chrisgilmerproj/spark_chamber/Spark Chamber Small/Documentation/bougie.jpg

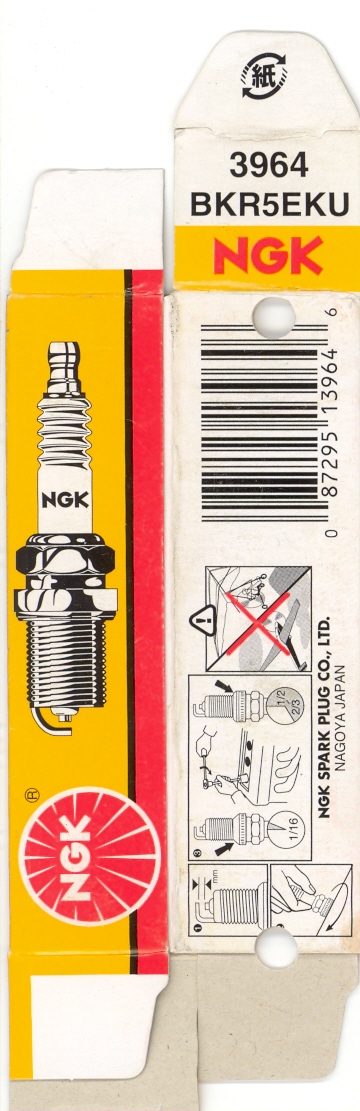
Spark Chamber Small/Documentation/bougie.jpg
