chrisgilmerproj/spark_chamber/README.md

Spark Chamber
=============

This is the public repo for my spark chamber files.

This includes all the original engineering drawings and documents for the
Nikef chambers designed by Fred Hartjes:

http://www.nikhef.nl/pub/departments/mt/projects/Sparkchamber/

from Fred's homepage

http://www.nikhef.nl/~i56/

In particular this is to focus on building the small spark chamber here:

http://www.nikhef.nl/pub/departments/mt/projects/Sparkchamber/index.php?path=Portable%28Small%29/
