chrisgilmerproj/spark_chamber/Spark Chamber Small/README.md

parts
=====

| Item | Quantity | Reference | Part | min | Mouser # | Price | Total | Notes  |
| ---- | --- | --- | --- | --- | --- | ----- | ----- | --- |
| 1 | -- | Cx1,Cx2 | ...pF | | | | | |
| 2 | -- | C7 | ...pF | | | | | |
| 3 | -- | R7 | ..k. | | | | | |
| 4 | -- | Rx1,Rx2 | ..k. | | | | | |
| 26 | -- | RV5 | jumper | | | | | Jumper |
| 27 | -- | RV6 | jumper | | | | | Jumper |
| 10 | -- | C30,C31,C63 | ...uF/450V | | | | | |

smd - parts
===========

| Item | Quantity | Reference | Part | min | Mouser # | Price | Total | Notes |
| ---- | --- | --- | --- | --- | --- | ----- | ----- | --- |
| 5 | 3 | C5,C6,C8 | 470nF | 1 | 810-CGJ4J3X7S2A474K  | 0.98  | 2.94  | Capacitor  |
| 6 | 1 | C9,C55,C59 | 120pF | 1 | 810-CGJ3E3C0G2D121J  | 0.29  | 0.29  | Capacitor  |
| 7 | 1 | C10 | 2.2uF | 1 | 810-C1005X7S0J225K | 0.33  | 0.33  | Capacitor  |
| 8 | 10 | C29,C43,C52,C53,C54, C56,C57,C58,C60,C61 | 100nF | 1 | 810-CGJ5L2X7R2A104K  | 0.65  | 6.50  | Capacitor  |
| 9 | 1 | C46 | 2.2nF | 1 | 81-GRM31BR73A222KW01 | 0.33  | 0.33  | Capacitor  |
| 28 | 6 | R1,R2,R3,R11,R93,R99 | 1k0 | 1 | 594-MCS0402MD1001DE0 | 0.28  | 1.68  | Resistor |
| 29 | 1 | R87 | 1M5 | 1 | 660-HV732ATTD1504F | 0.68  | 0.68  | Resistor |
| 31 | 3 | R5,R6,R8 | 470k | 1 | 756-HVC2512-470KFT18 | 0.79  | 2.37  | Resistor |
| 32 | 3 | R9,R91,R97 | 10k | 1 | 279-RN73C1J10KBTDF | 1.06  | 3.18  | Resistor |
| 33 | 1 | R10 | 3k3 | 1 | 667-ERA-3ARW332V | 1.38  | 1.38  | Resistor |
| 34 | 2 | R35,R37 | 1k6 | 1 | 71-TNPW08051K60BEEN  | 0.85  | 1.70  | Resistor |
| 35 | 1 | R12 | 47 | 1 | 588-RW3R5EA47R0JET | 1.75  | 1.75  | Resistor |
| 39 | 2 | R26,R27 | 270k | 1 | 660-HV732BTTD2703D | 0.61  | 1.22  | Resistor |
| 40 | 3 | R15,R31,R32 | 2k2 | 1 | 667-ERA-3ARW222V | 1.38  | 4.14  | Resistor |
| 41 | 2 | R34,R36 | 470 | 1 | 660-SG733ATTE471K | 0.86  | 1.72  | Resistor |
| 42 | 8 | R88,R89,R90,R94, R95,R96,R100,R101 | 10 | 1 | 588-RW0S6BB10R0FET | 1.15  | 9.20  | Resistor |
| 43 | 2 | R92,R98 | 4k7 | 1 | 279-RN73C1J4K7BTDF | 1.68  | 3.36  | Resistor |
| 48 | 3 | T1,T2,T3 | BS170 | 1 | 522-BS170FTA | 0.70  | 2.10  | Transistor |
| 49 | 2 | U1,U2 | TL3016ID | 1 | 595-TL3016ID | 3.17  | 6.34  | Chip |
| 50 | 4 | U3,U4,U6,U7 | 74HC123M | 1 | 595-CD74HC123M | 0.69  | 2.76  | Chip |
| 51 | 1 | U5 | 74HC08D | 1 | 595-SN74HC08D | 0.46  | 0.46  | Chip |
| 52 | 1 | U8 | 74HC240D | 1 | 595-SN74HC240DW | 0.60  | 0.60  | Chip |

discrete - parts
================

| Item | Quantity | Reference | Part | min | Mouser # | Price | Total  | Notes |
| ---- | --- | --- | --- | --- | --- | ----- | --- | --- |
| 11 | 2 | C42,C47 | 220uF/16V | 1 | 647-UVR1C221MED | 0.36  |  0.72  | Capacitor |
| 12 | 2 | C28,C49 | 47uF/25V ( 10 or 0uF/35V ) | 1 | 647-UST1E470MDD | 0.35  |  0.70  | Capacitor |
| 13 | 3 | C44,C45,C48 | 10uF/16V | 1 | 647-UPS1C100MDD1TA  | 0.17  |  0.51  | Capacitor |
| 14 | 1 | C51 | 22uF/350V | 1 | 647-TVX2V220MCD | 2.36  |  2.36  | Capacitor |
| ...  | 1 | R51 | 330k | 1 | 594-5083NW330K0J | 0.10  |  0.10  | Resistor |
| 15 | 3 | C62,C63,C64 | 680nF/400V | 1 | 594-2222-383-11684  | 3.36  |  10.08 | Capacitor |
| 16 | 2 | DN1,DN2 | BYV96 | | | 0.00  | | Fast soft-recovery controlled avalanche rectiﬁers |
| 17 | 4 | D1,D2,D3,D4 | LED | | | 0.00  | | LED |
| 18 | 2 | D10,D14 | W04G | 1 | 625-W04G-E4 0.69 | 1.38  | | Bridge Rectifier |
| 19 | 1 | D13 | BY448 + jumper | 1 | 625-BY448GP-E3/73 | 0.31  |  0.31  | Bridge Rectifier |
| 20 | 1 | F1 | 160mA-T | 1 | 693-0034.7207 | 0.81  |  0.81  | Fuse w/through hole |
| 21 | 3 | J1,J2,J3 | LEMO | | | 0.00  | | LEMO (manufacturer) Socket |
| 22 | 2 | PM1,PM2 | CON5 | | | 0.00  | | ?? Switch?? |
| 23 | 1 | P1 | Plug AC-male | | | 0.00  | | Plug AC-Male |
| 24 | 1 | Q1 ( NB: invert !!! ) | BC327 | 1 | 512-BC32725TA | 0.21  |  0.21  | Bipolar Transistor  |
| 25 | 2 | RV1,RV2,RV5,RV6 | 10k | | | 0.00  | | Jumper Panel |
| 30 | 1 | R4 | 82k | 1 | 594-5073NW82K00J | 0.16  |  0.16  | Resistor |
| 36 | 1 | R13 | 560 | 1 | 594-5073NW560R0J | 0.16  |  0.16  | Resistor |
| 37 | 1 | R14 | 27 | 1 | 594-5083NW27R00J | 0.10  |  0.10  | Resistor |
| 44 | | | | | | | | |
| 45 | | ... | TP | | | | | |
| 53 | 1 | U10 | 12N60A4D | | | 0.00  | | Transistor |
| 54 | 1 | U14 | LM7805 | 1 | 512-LM7805CT | 0.68  |  0.68  | Transistor |
| 55 | 1 | U15 | LM7905 | 1 | 512-LM7905CT | 0.60  |  0.60  | Transistor |
| 56 | 1 | U16 | LM7812 | 1 | 512-LM7812CT | 0.71  |  0.71  | Transistor |
| 46 | 1 | Tr1 | 220V > 2x8V, 3.3VA | | | 0.00  | | Transformer |
| 47 | 1 | Tr2 | 220V > 2x18V,2.3VA | | | 0.00  | | Transformer |
