chrisgilmerproj/spark_chamber/Spark Chamber Small/Documentation/README.md

Documentation
=============

Here is the list of the files in this directory:

| Name | Description |
| --- | --- |
| 091013 Handleiding vonkenmaker klein final version ENGLISH.pdf | English - Manual for the portable spark chamber of Nikhef |
| 091013 Handleiding vonkenmaker klein final version.pdf | Dutch - Manual for the portable spark chamber of Nikhef |
| Beknopte bediening draagbare vonkenkamer.pdf | Dutch - Brief portable operating room sparks |
| Block diagram.jpg | Spark Chamber Block Diagram of full system |
| bougie.jpg | Bougie Spark Plug Box - NGK 3964 BKH5EKU |
| coil spark chamber Cees Brouwer email.txt | English translation of "spoeltje vonkenkamer Cees Brouwer.eml" |
| Electronics panel.dwg | |
| H5783P.pdf | Photosensor Module Product Page |
| spoeltje vonkenkamer Cees Brouwer.eml | Dutch - Spark Chamber Coil Email |
| Vishay specs.pdf | Vishay Heavy Duty High Voltage Capacitors Product Page |
