chrisgilmerproj/spark_chamber/Spark Chamber Small/Documentation/HV board/README.md

High Voltage Board
==================

Here is the list of the files in this directory:

| Name | Description |
| --- | --- |
| BOM-HV-unit.txt | High Voltage Board BOM |
| NEW-HV-6KV-BOT.pdf | Bottom Layer |
| NEW-HV-6KV-DRD.pdf | Drill Drawing |
| NEW-HV-6KV-SMT.pdf | Soldermask Top |
| NEW-HV-6KV-SST.pdf | Silkscreen Top |
| NEW-HV-6KV-TOP.pdf | Top Layer |
| Sch-P1-Blk.pdf | Spark Chamber 1 |
| Sch-P7-HV0704.pdf  | New HV Board |

Bill of Materials
=================

PC Board
--------

- prototype 3x ad 280,- /3 =  93,33 /stuk
- productie 6x ad 209,4 /6 =  34,90 /stuk
- gemiddeld 9x ad 489,4 /9 =  54,38 /stuk

Parts
-----

| Item | Quantity | Reference | Part |
| ---- | --- | --- | --- |
| 1 | 30	 | C1,C2,C3,C4,C5,C6,C7, C8,C9,C10,C11,C12,C13, C14,C15,C16, C21,C22,C23,C24,C25,C26, C27,C28,C29,C30,C31,C32, C33,C34 | 10uF/400V	|
| 2	 | 9	 | D1,D2,D3,D4,D5,D6,D7, D8,D0 | BY448 |
| 3	 | 1	 | D10							| W04G |
| 4	 | 1	 | D11							| LED |
| 5	 | 1	 | E11							| 47uF / 35V |
| 6	 | 2	 | F1,F2						| TR-160mA |
| 7	 | 7	 | H1,H2,H3,H4,H5,11,0			| HOLE / TEST-POINT |
| 8	 | 1	 | J1							| PLUG AC-MALE |
| 9	 | 8	 | R1,R2,R3,R4,R5,R6,R7,R8		| 8M2 |
| 10 | 1	 | R9,R12						| 1M0 |
| 11 | 1	 | R11							| 3k9 |
| 12 | 1	 | T0							| 230V>2x18V |
| 13 | 3	 | T1,T2,T3					| 2x18V>230V |
| 14 | 1	 | RV1							| varistor,715V |
| 15 | 1	 | RV2							| varistor,680V |
