chrisgilmerproj/spark_chamber/Spark Chamber Small/3D-pictures Small Spark chamber.pdf

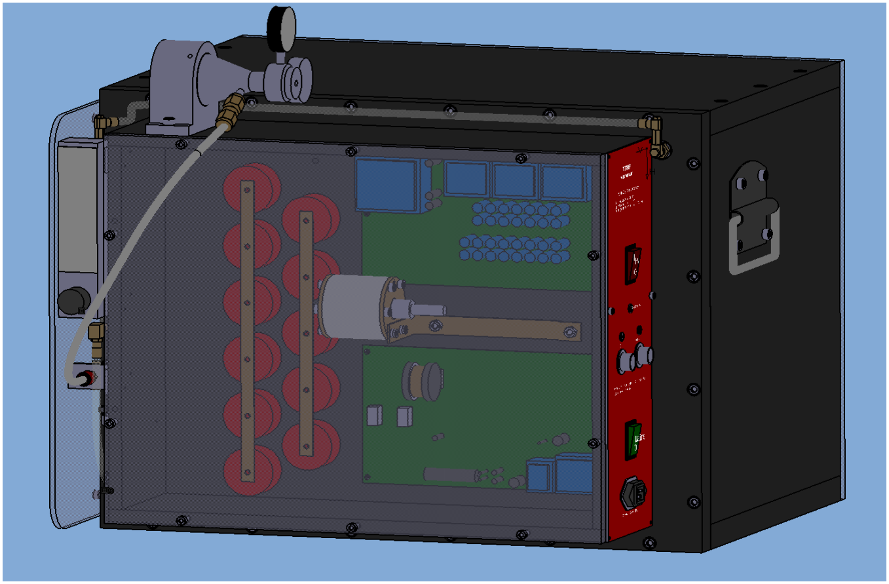
[picture p2: figure]

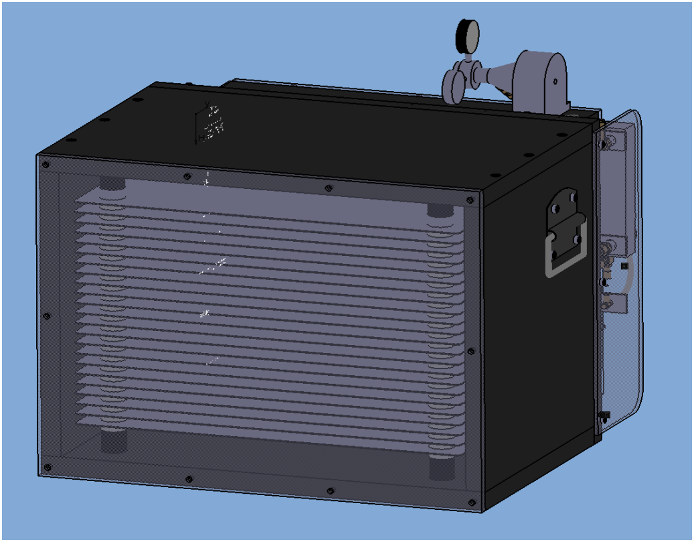
[picture p3: figure]
