chrisgilmerproj/spark_chamber/Spark Chamber Small/Documentation/Block diagram.jpg

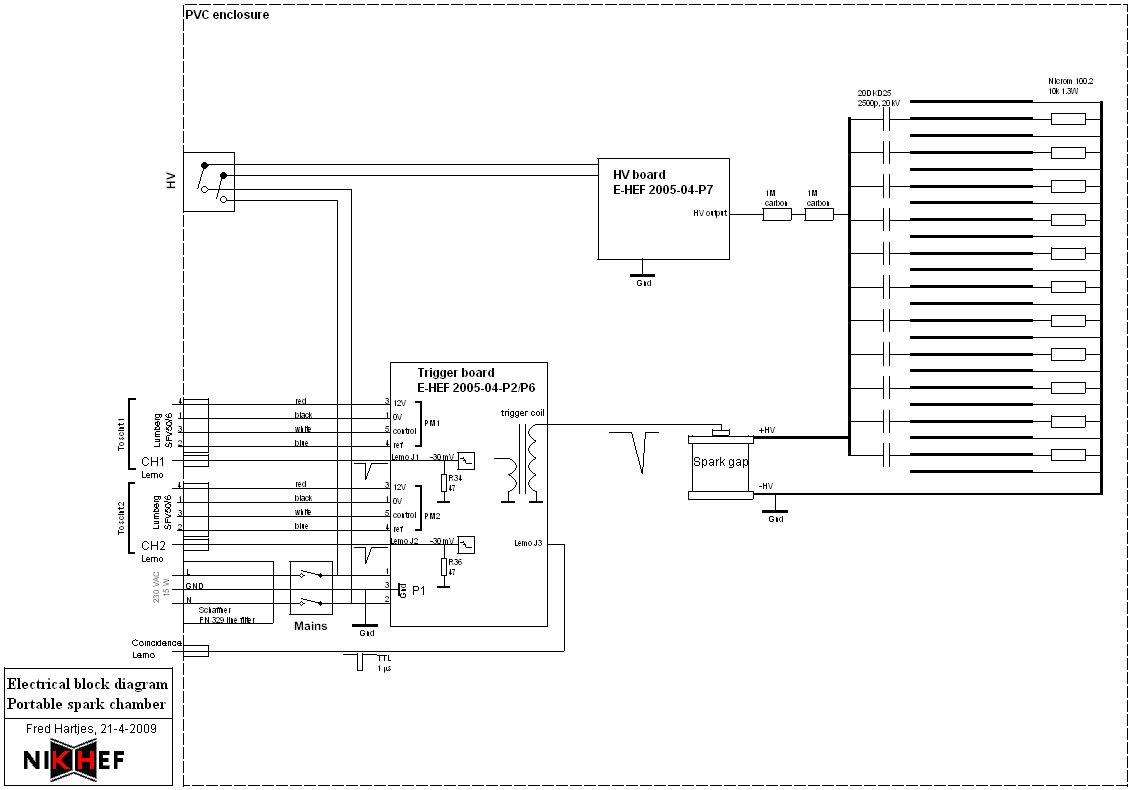
Spark Chamber Small/Documentation/Block diagram.jpg
