chrisgilmerproj/spark_chamber/Spark Chamber Small/Documentation/Trigger board/BOM-Spark-Ctrl.txt

Spark-Ctrl  Revised: Thursday, March 24, 2005
K.U. Nijmegen,  E-HEF  2005-04-P..          Revision: A

Bill Of Materials          March 31,2005      11:44:52  Page1 

Item / Quantity Reference           Part            Farnell-nr
_________________________________________________________________________

  1 -   Cx1,Cx2,        ...pF
  2 -   C7,     ...pF
  3 -   R7,     ..k.
  4 -   Rx1,Rx2,        ..k.
 26 -   RV5     jumper          
 27 -   RV6     jumper          
 10 -   C30,C31,C63     . ..uF/450V         Price (x5)

 - - - - - - - - -   smd - parts   - - - - - - - - - - - - - - - - - 

  5 3   C5,C6,C8        470nF       644.274   9,20

  6 1   C9,C55,C59      120pF      C: 10.03.04.212.7      7,50

  7 1   C10     2.2uF       317.706   4,80

  8 10  C29,C43,C52,C53,C54,        100nF          C: 10.03.04.500.2
        C56,C57,C58,C60,C61             reel:   3555124  37,92

  9 1   C46     2.2nF           499.330   1,37

 28 6   R1,R2,R3,R11,R93,R99        1k0         912.475   1,35

 29 1   R87     1M5         3601250   2,25

 31 3   R5,R6,R8        470k            912.797   0,85

 32 3   R9,R91,R97      10k         912.591   1,35

 33 1   R10     3k3         912.530   1,00

 34 2   R35,R37     1k6         4387120   0,85

 35 1   R12     47          912.311   0,85

 39 2   R26,R27     270k            912.761   0,85

 40 3   R15,R31,R32     2k2         912.517   1,35

 41 2   R34,R36     470         912.438   1,35

 42 8   R88,R89,R90,R94,R95,        10         C: 11.24.05.110.0
        R96,R100,R101                   9122337   1,70

 43 2   R92,R98     4k7         912.554   1,05

 48 3   T1,T2,T3        BS170           4386632   3,60  
 49 2   U1,U2       TL3016ID        8453594  13,30      
 50 4   U3,U4,U6,U7     74HC123M        539.302   7,80

 51 1   U5      74HC08D     794.910   1,35

 52 1   U8   ( 74HC240D )       3166065   1,95
 
- - - - - - - - -   discrete - parts   - - - - - - - - - - - - - - - - 

 11 2   C42,C47     220uF/16V       580.429       2,80
 
 12 2   C28,C49     47uF/25V        
            ( 100uF/35V )   580.533       3,40

 13 3   C44,C45,C48     10uF/16V        3349925       3,30

 14 1   C51     22uF/350V       3451021       7,75
 .. 1   R51     330k                      1,75

 15 2   C62, . . . ,C64     680nF/400V      548.236       4,50

 16 2   DN1,DN2     BYV96       367.450   2,20

 17 4   D1,D2,D3,D4     LED         656.537   4,80

 18 2   D10,D14     W04G            646.696   4,30
 19 1   D13 BY448 + jumper  366.316   1,90

 20 1   F1      160mA-T     9516069       9,50

 21 3   J1,J2,J3        LEMO            3817866 148,35

 22 2   PM1,PM2     CON5            659.277  46,20

 23 1   P1      PLUG  AC-MALE   

 24 1   Q1 ( NB: invert !!! )   BC327       356.943   0,35

 25 2   RV1,RV2,        10k             348.284  19,60

 30 1   R4      82k         545.053   1,75

 36 1   R13     560         544.530   1,75

 37 1   R14     27          544.218   1,75

 44         
 45     . . . . . .         TP      

 53 1   U10     12N60A4D        3020666      29,85
    
 54 1   U14     LM7805      412.776   2,75
    
 55 1   U15     LM7905      413.690   3,50
    
 56 1   U16     LM7812      413.215   3,35
    
 46 1   Tr1 220V > 2x8V, 3.3VA  926.413  38,70
    
 47 1   Tr2 220V > 2x18V,2.3VA  4384702  22,50
                                    ______ +
 
            TOTAAL onderdelen   / pcb       ~ 100,--                PC-board (4-layers)         ~  60,-- 
                                    ______ +
 
            TOTAAL                 €    160,00
