chrisgilmerproj/spark_chamber/(list of files, cad)

Other CAD files:
Spark Chamber Small/Documentation/Electronics panel.dwg
