chrisgilmerproj/spark_chamber/(threads)

Thread 1 (2013-10-08):

BOM for Trigger Board

chrisgilmerproj, 2013-10-08:
Need to find modern parts for the Trigger Board.  I have the actual board but it is not populated.  Determine all the parts for the BOM in order to purchase the parts.  Try Mouser, DigiKey, Jameco, etc.

Closed 2017-07-17.
