chrisgilmerproj/spark_chamber/Spark Chamber Large/Assembly Gas Control Unit BOM_AA0312_B.pdf

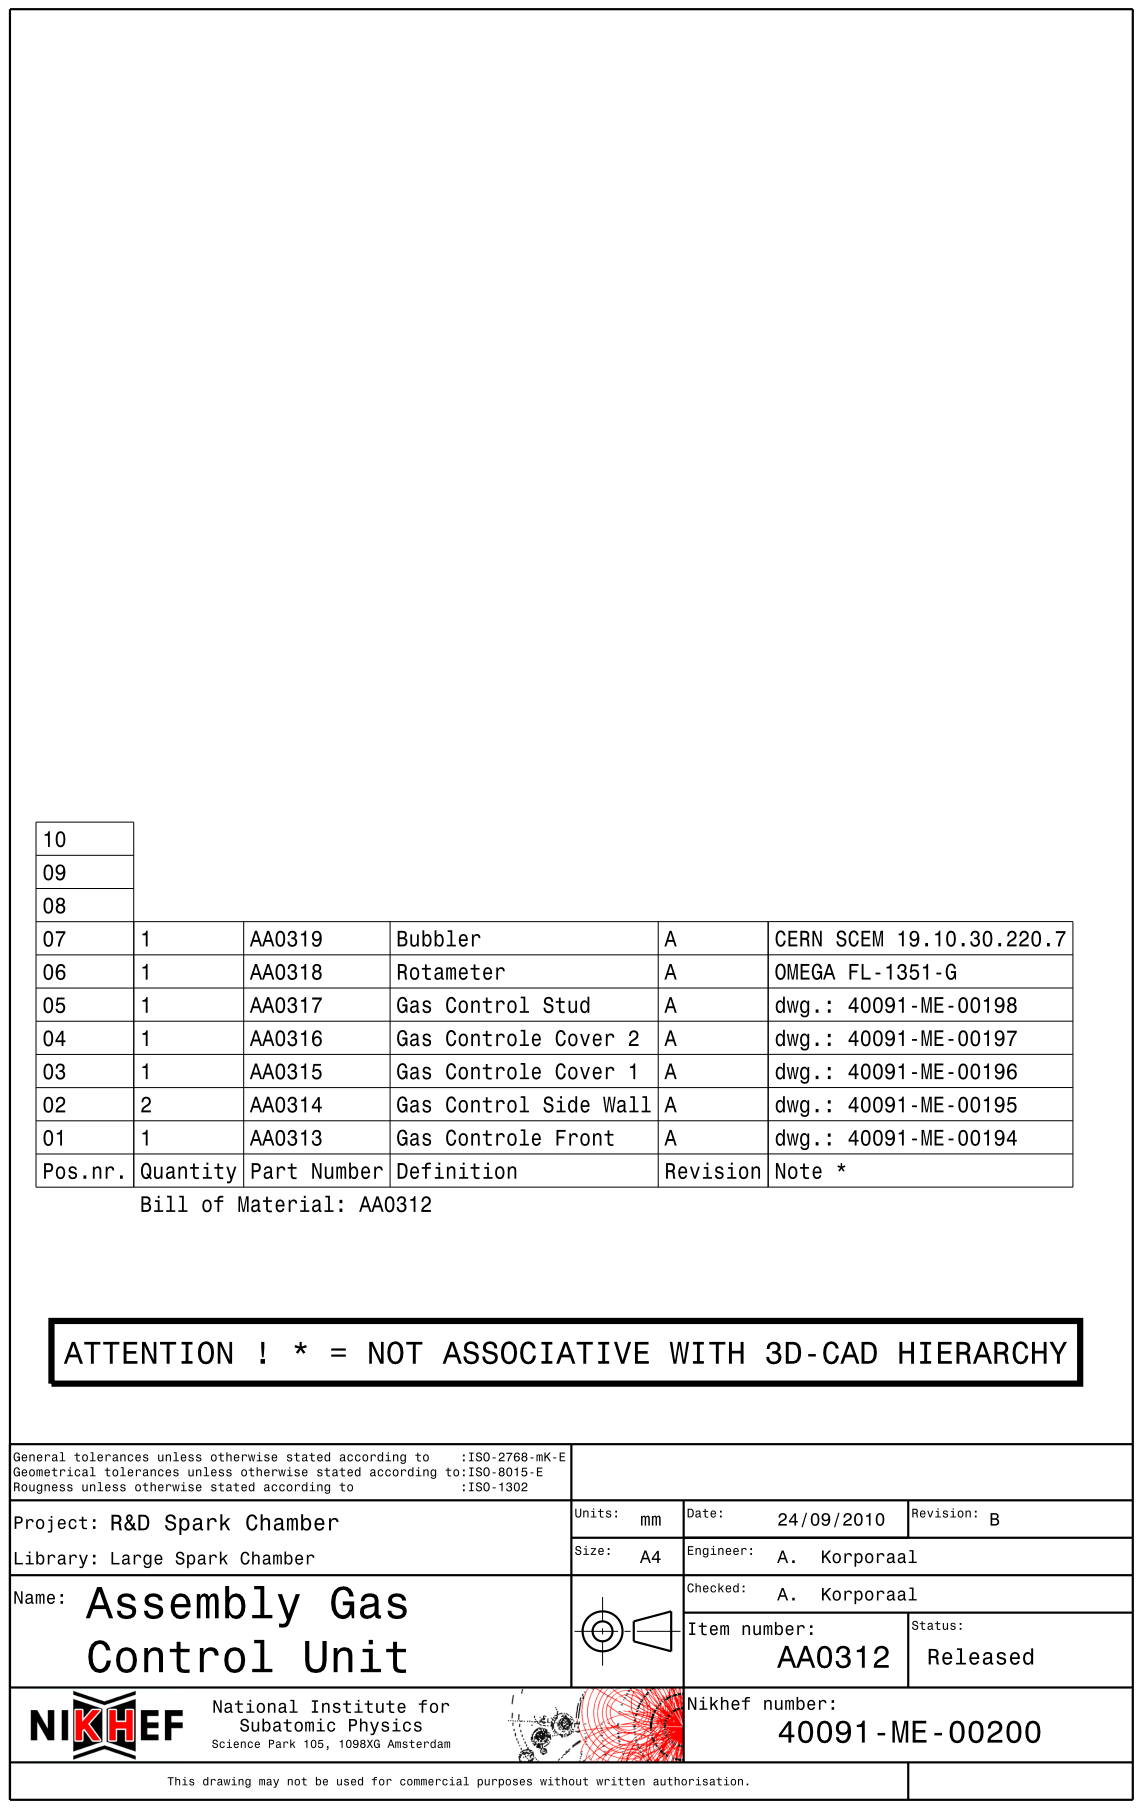
[picture p5: page 1]
