chrisgilmerproj/spark_chamber/Spark Chamber Large/Assembly Gas Control Unit_AA0312_A.pdf

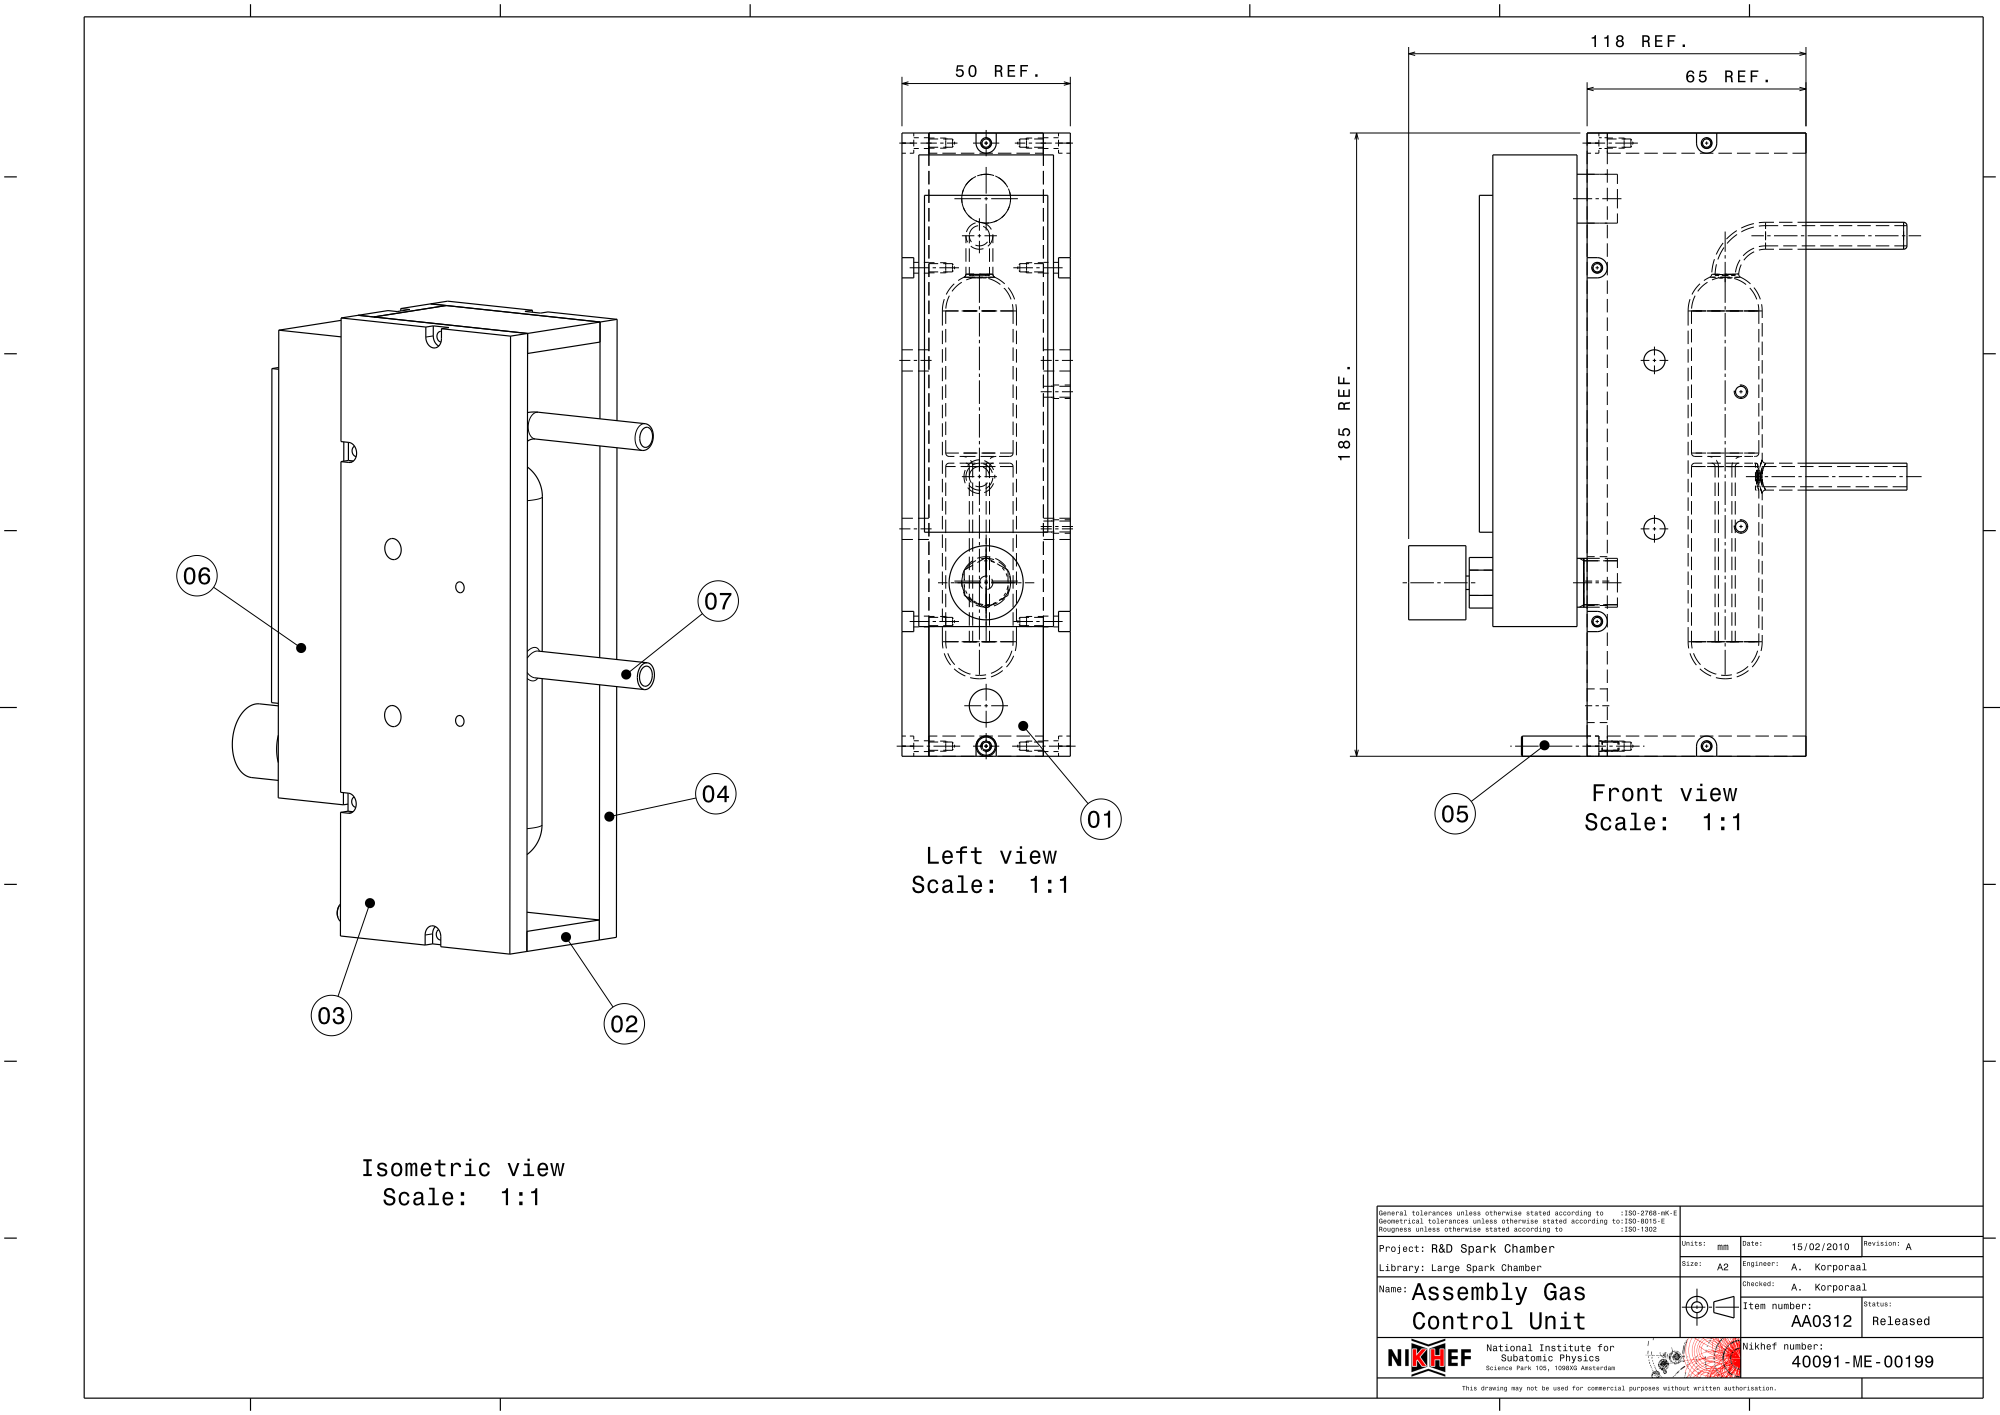
[picture p6: page 1]
