chrisgilmerproj/spark_chamber/Spark Chamber Large/Assembly Large spark Chamber Sheet 1_AA0244_A.pdf

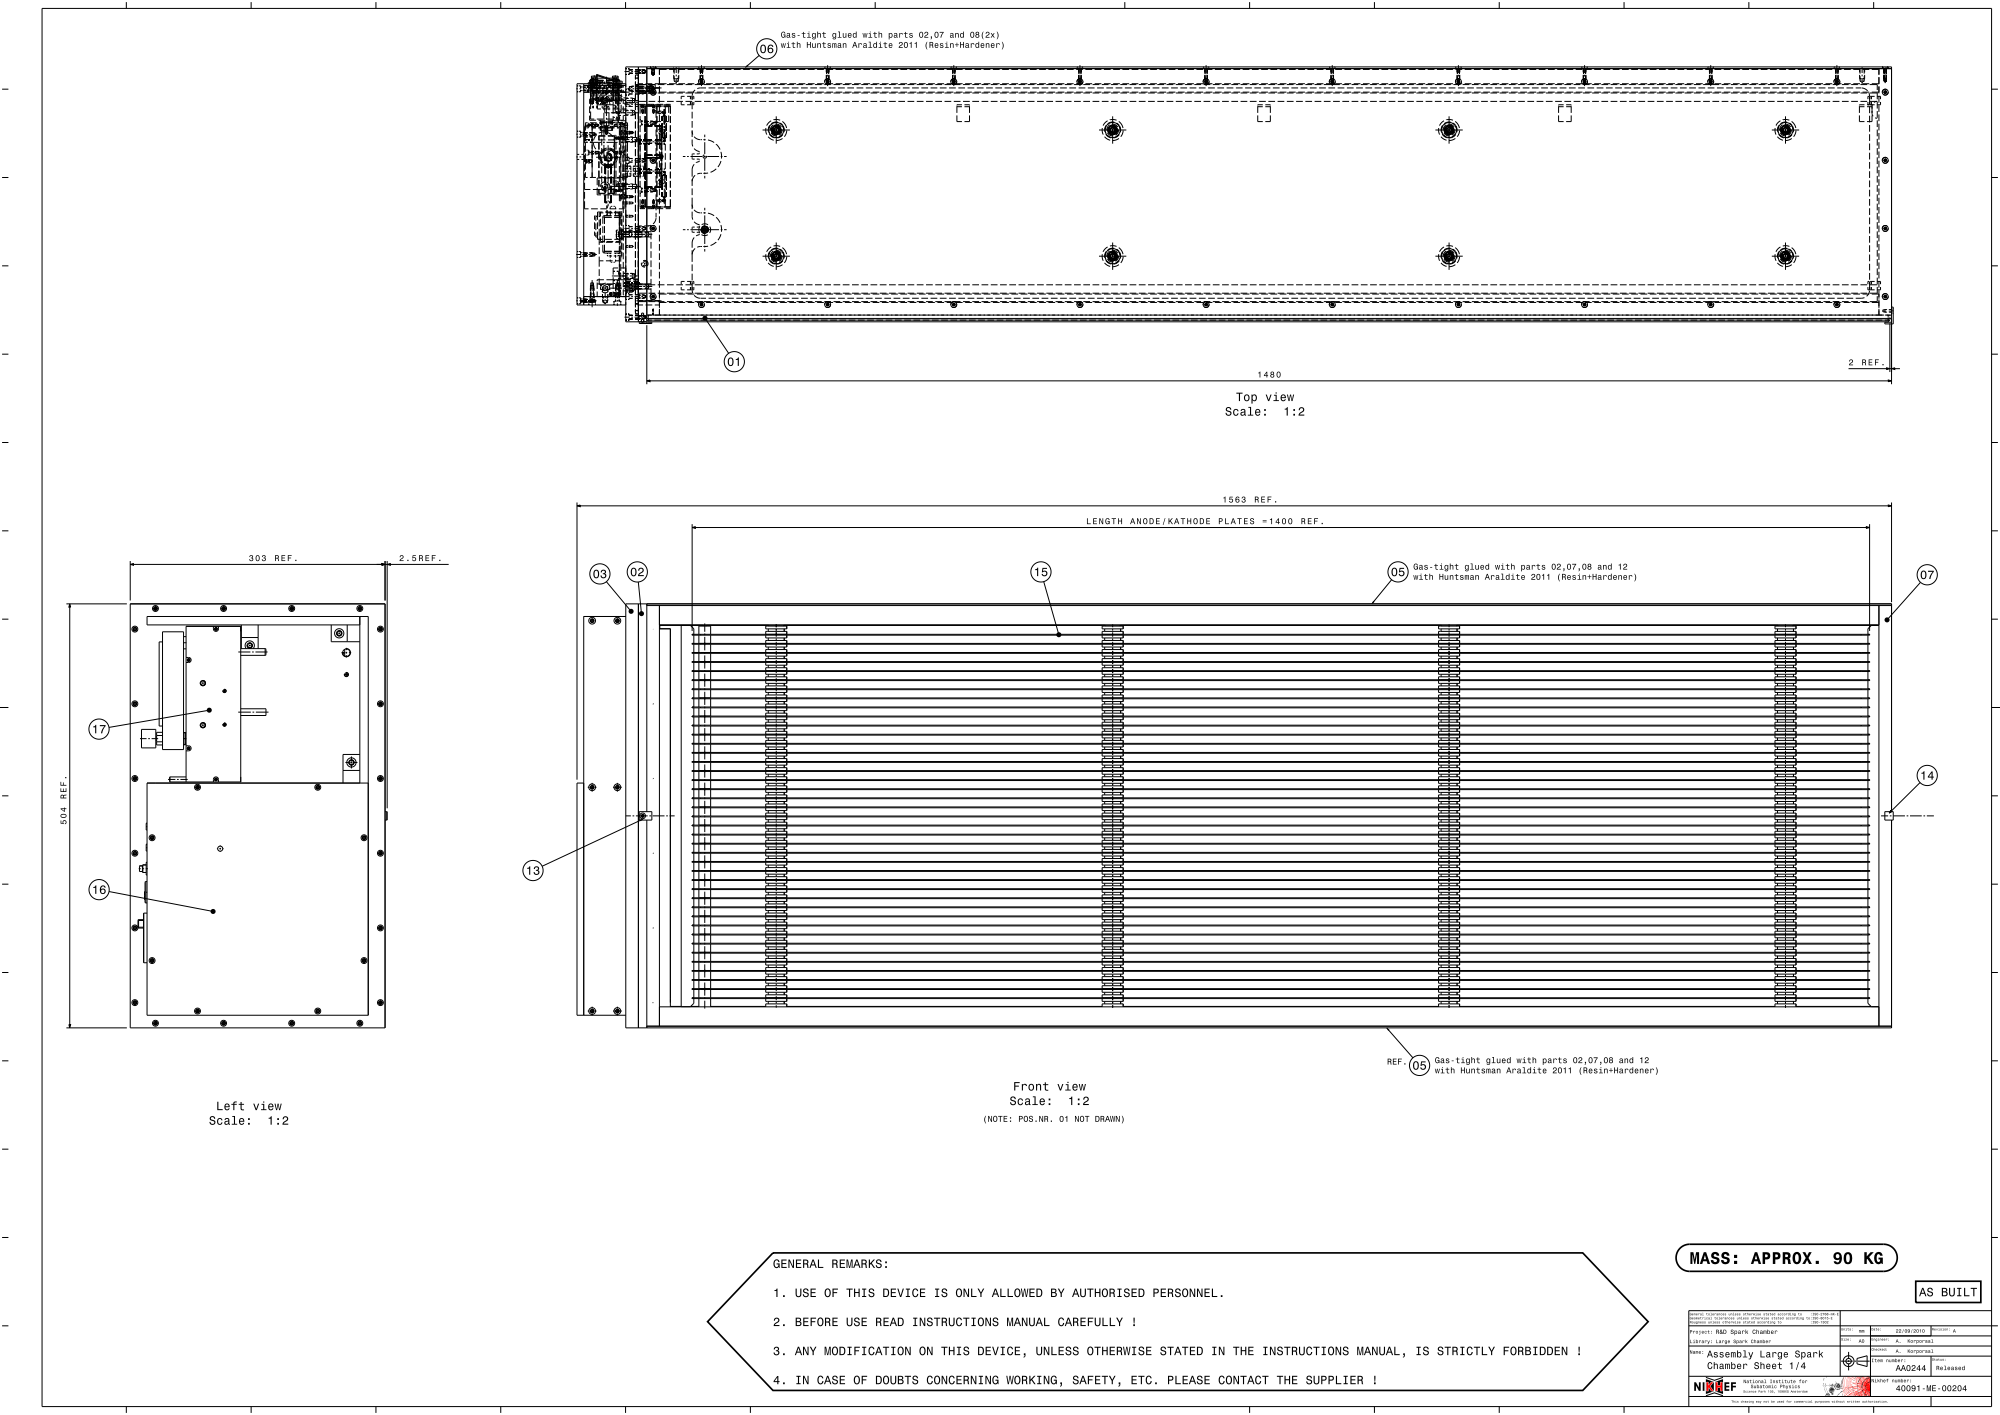
[picture p7: page 1]
