chrisgilmerproj/spark_chamber/Spark Chamber Large/Assembly Large spark Chamber Sheet 2_AA0244_A.pdf

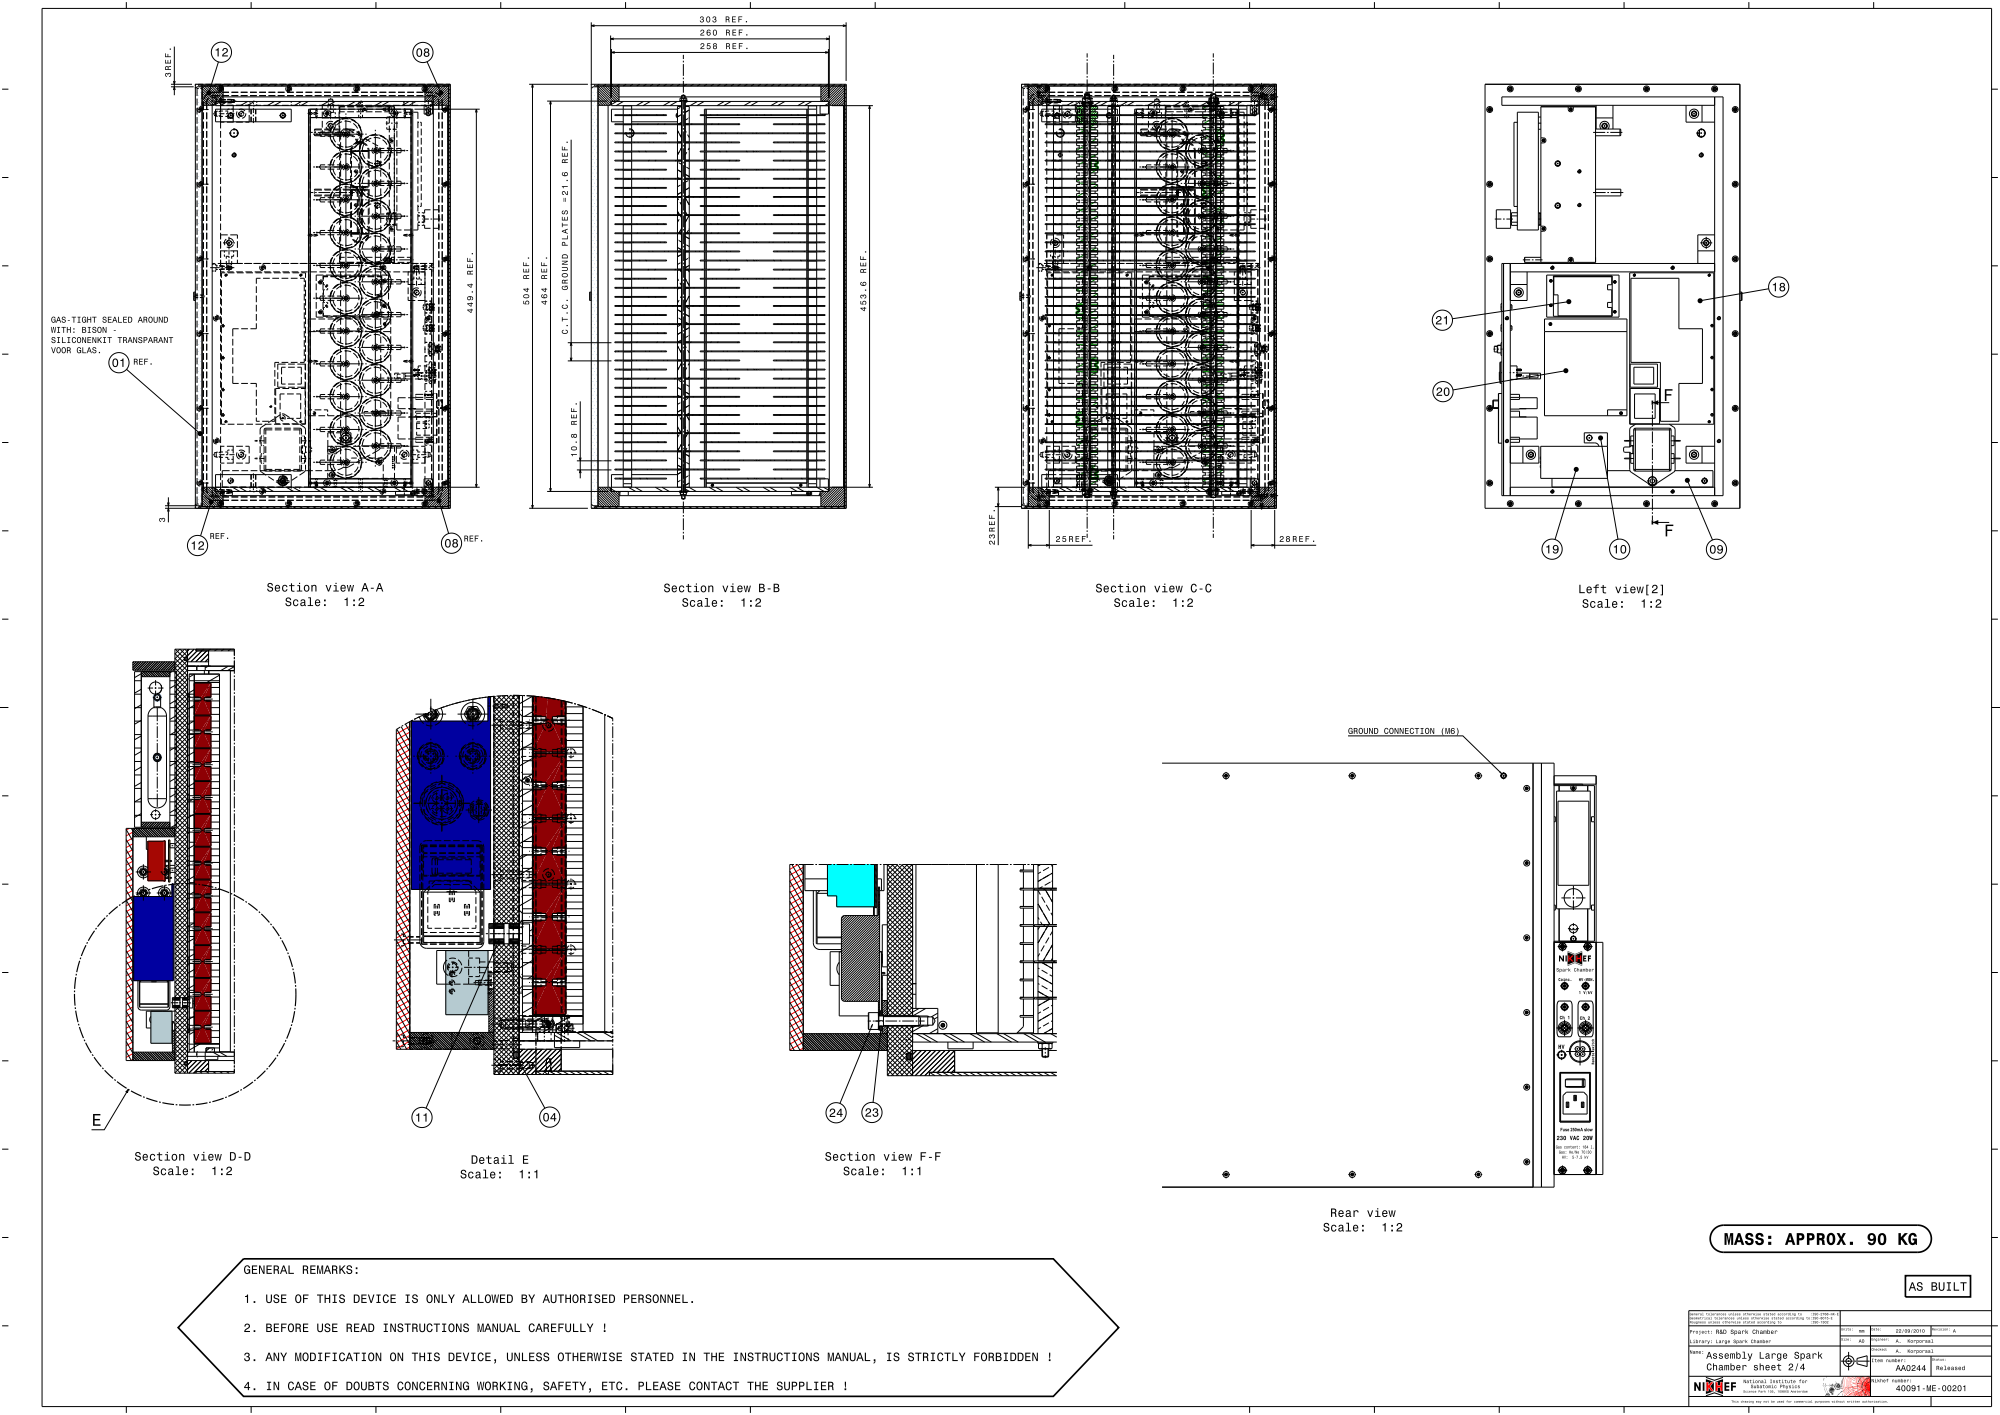
[picture p8: page 1]
