chrisgilmerproj/spark_chamber/Spark Chamber Large/Assembly Large spark Chamber Sheet 3_AA0244_A.pdf

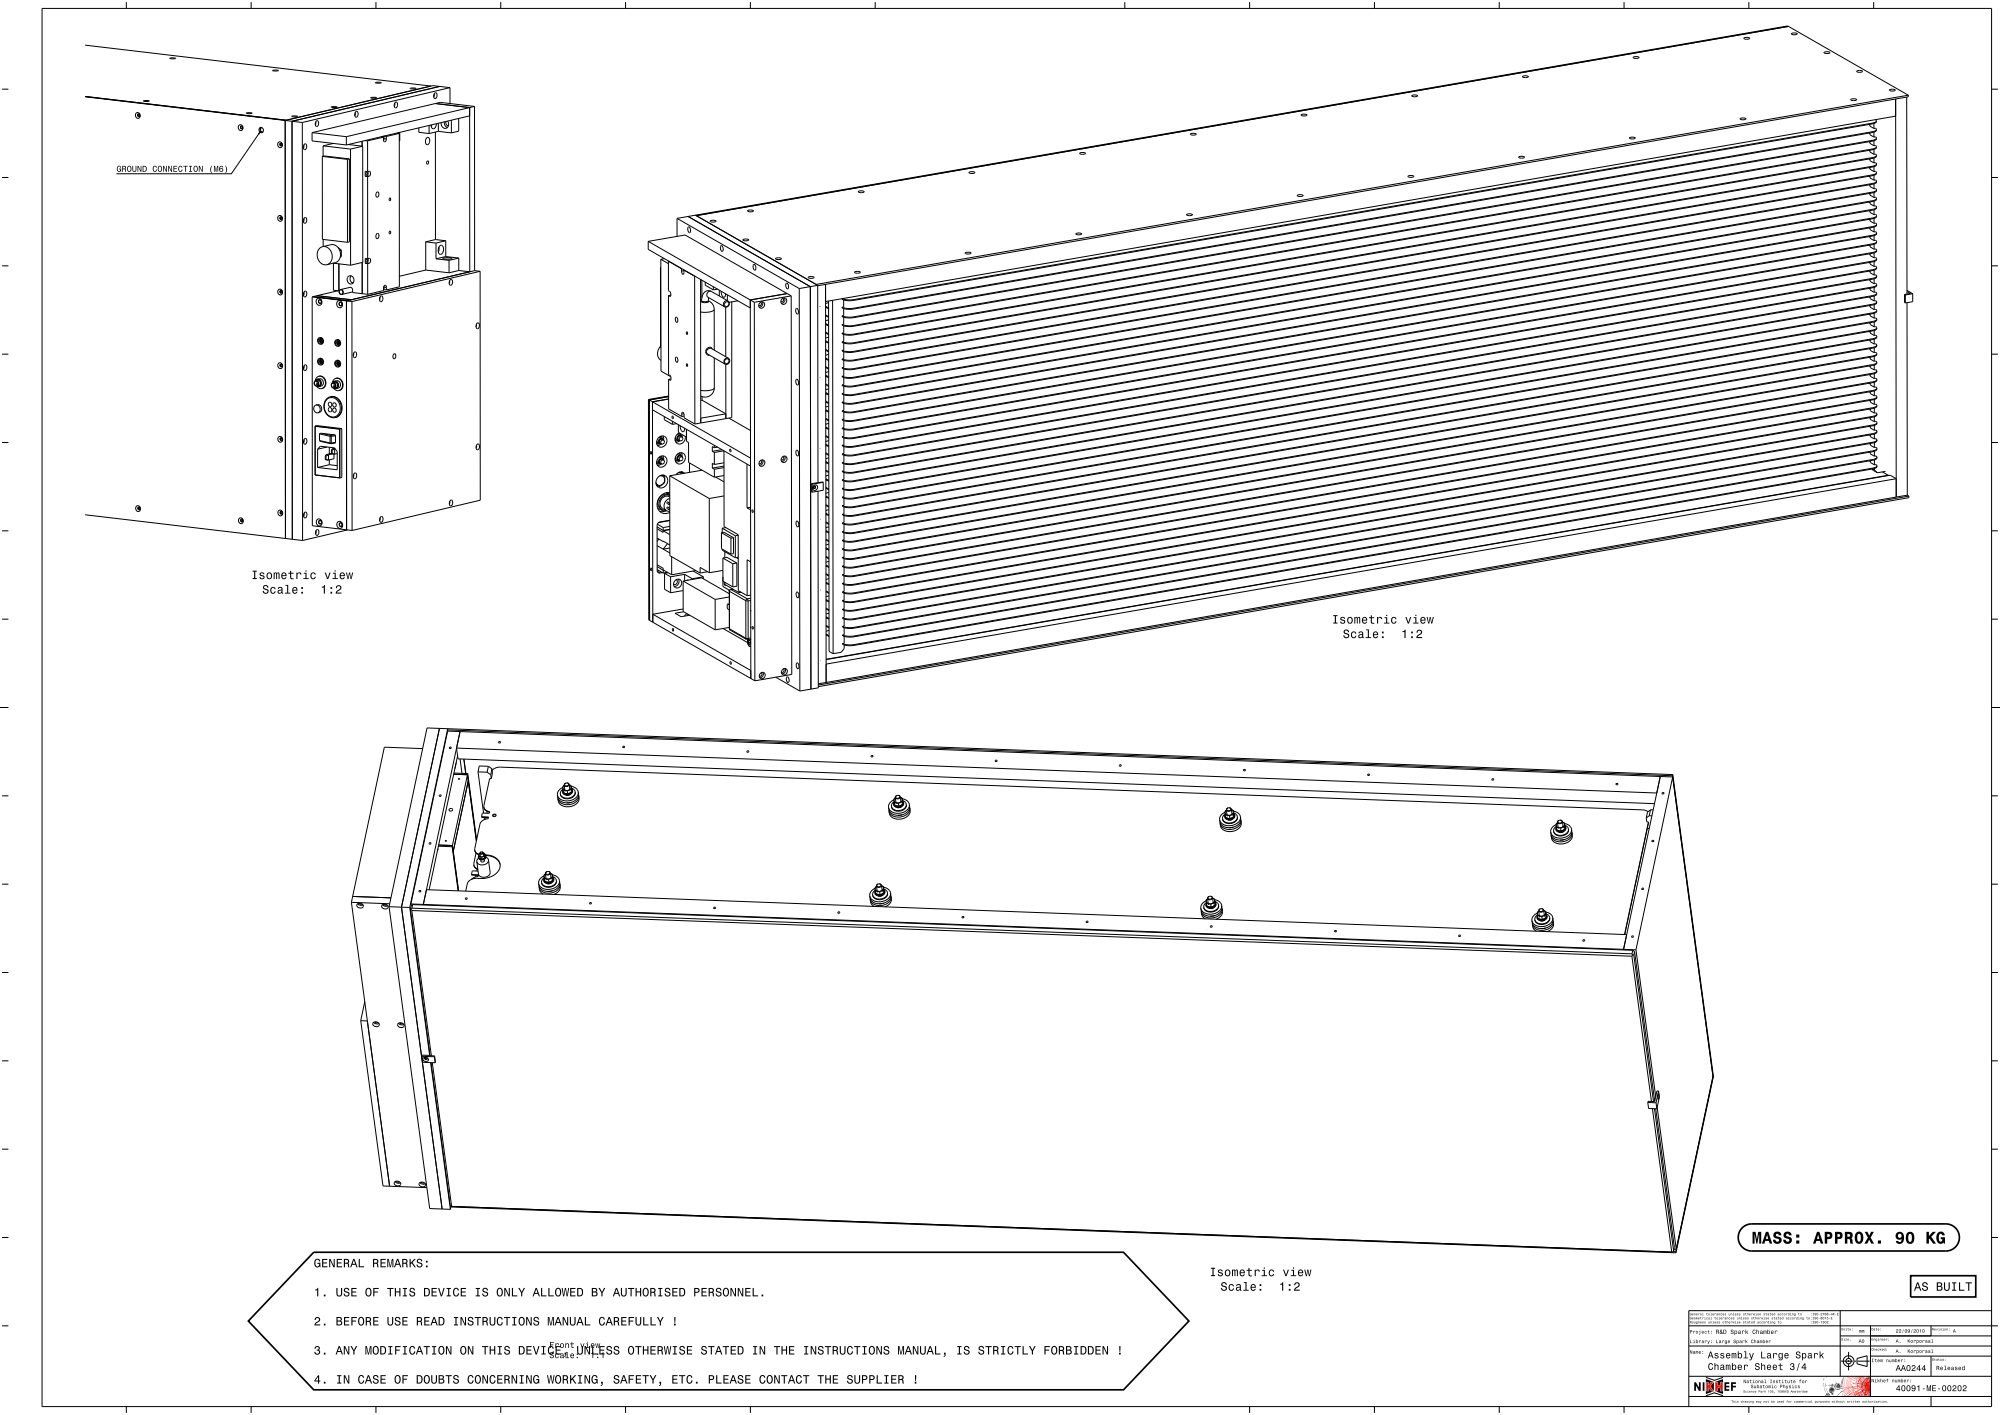
[picture p9: page 1]
