chrisgilmerproj/spark_chamber/Spark Chamber Large/Assembly Large spark Chamber Sheet 4 BOM_AA0244_A.pdf

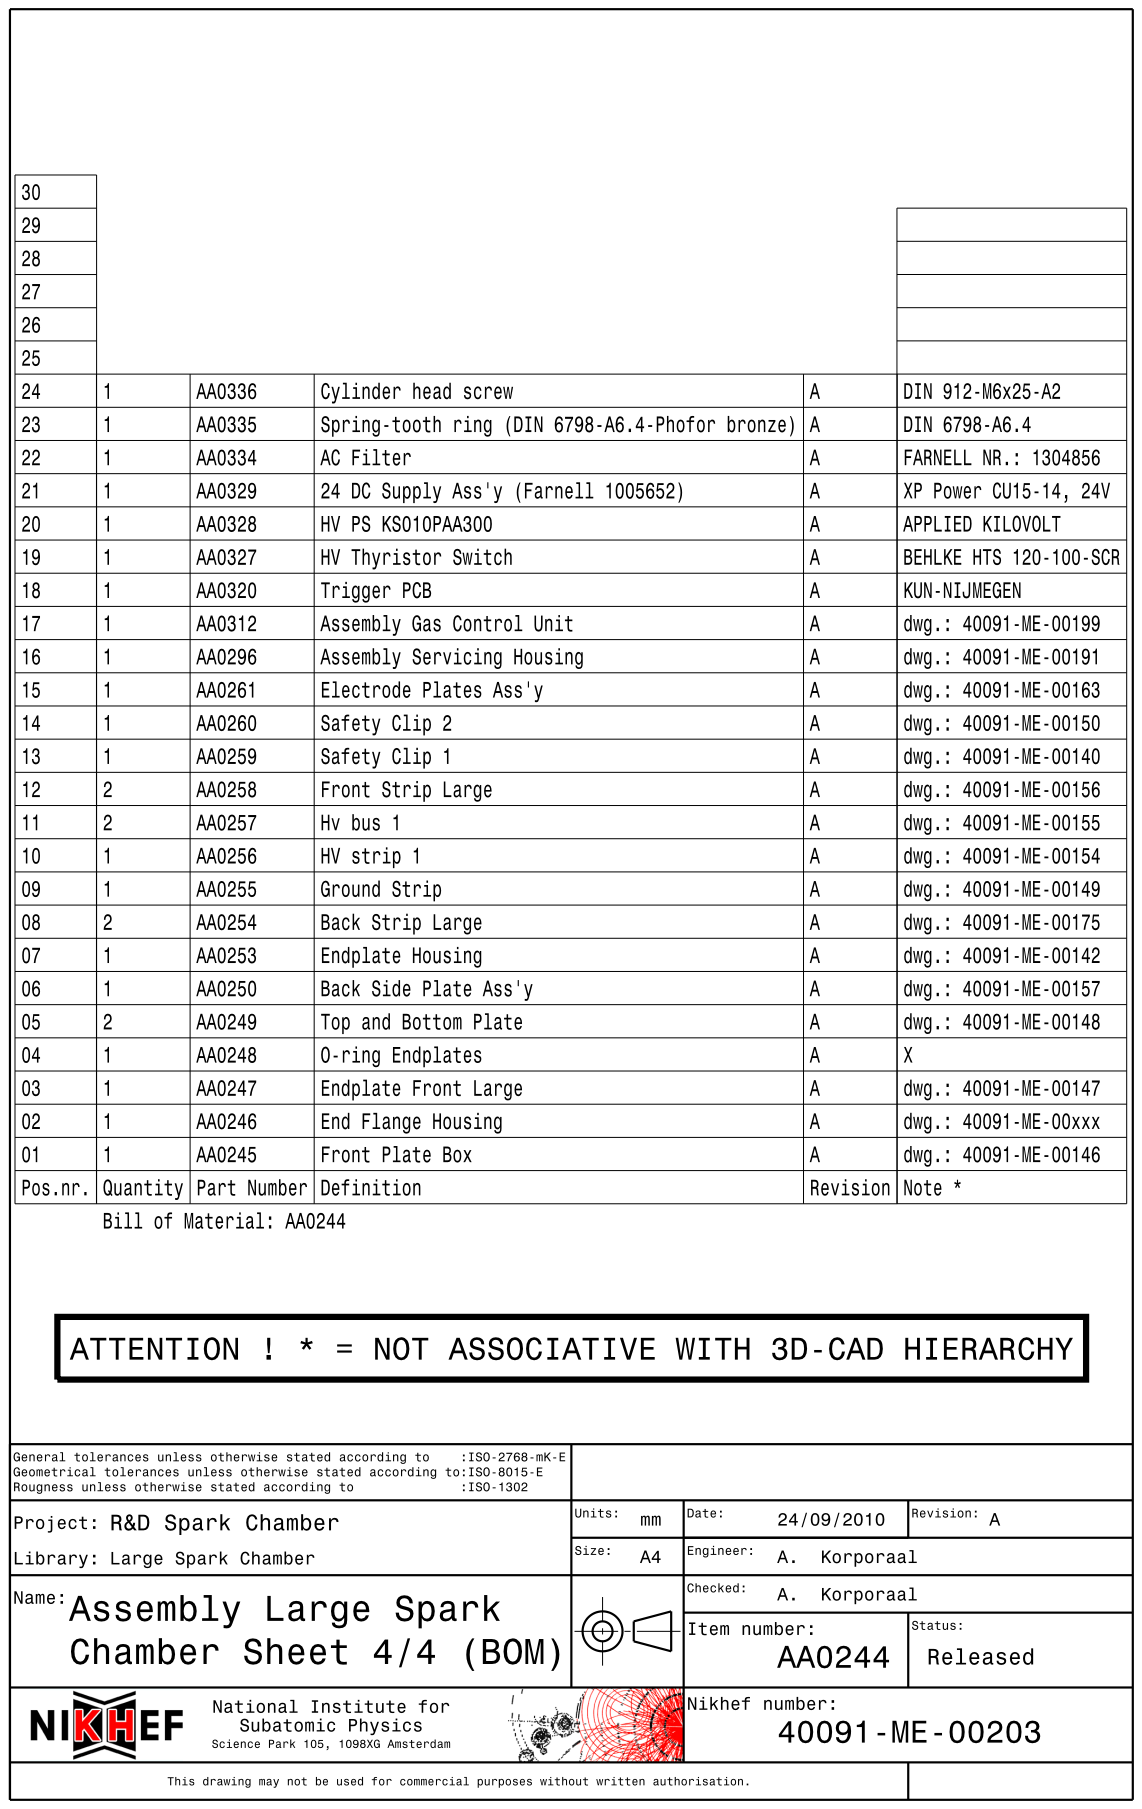
[picture p10: page 1]
