chrisgilmerproj/spark_chamber/Spark Chamber Large/Assembly Lower Electrode Plate_AA0262_A.pdf

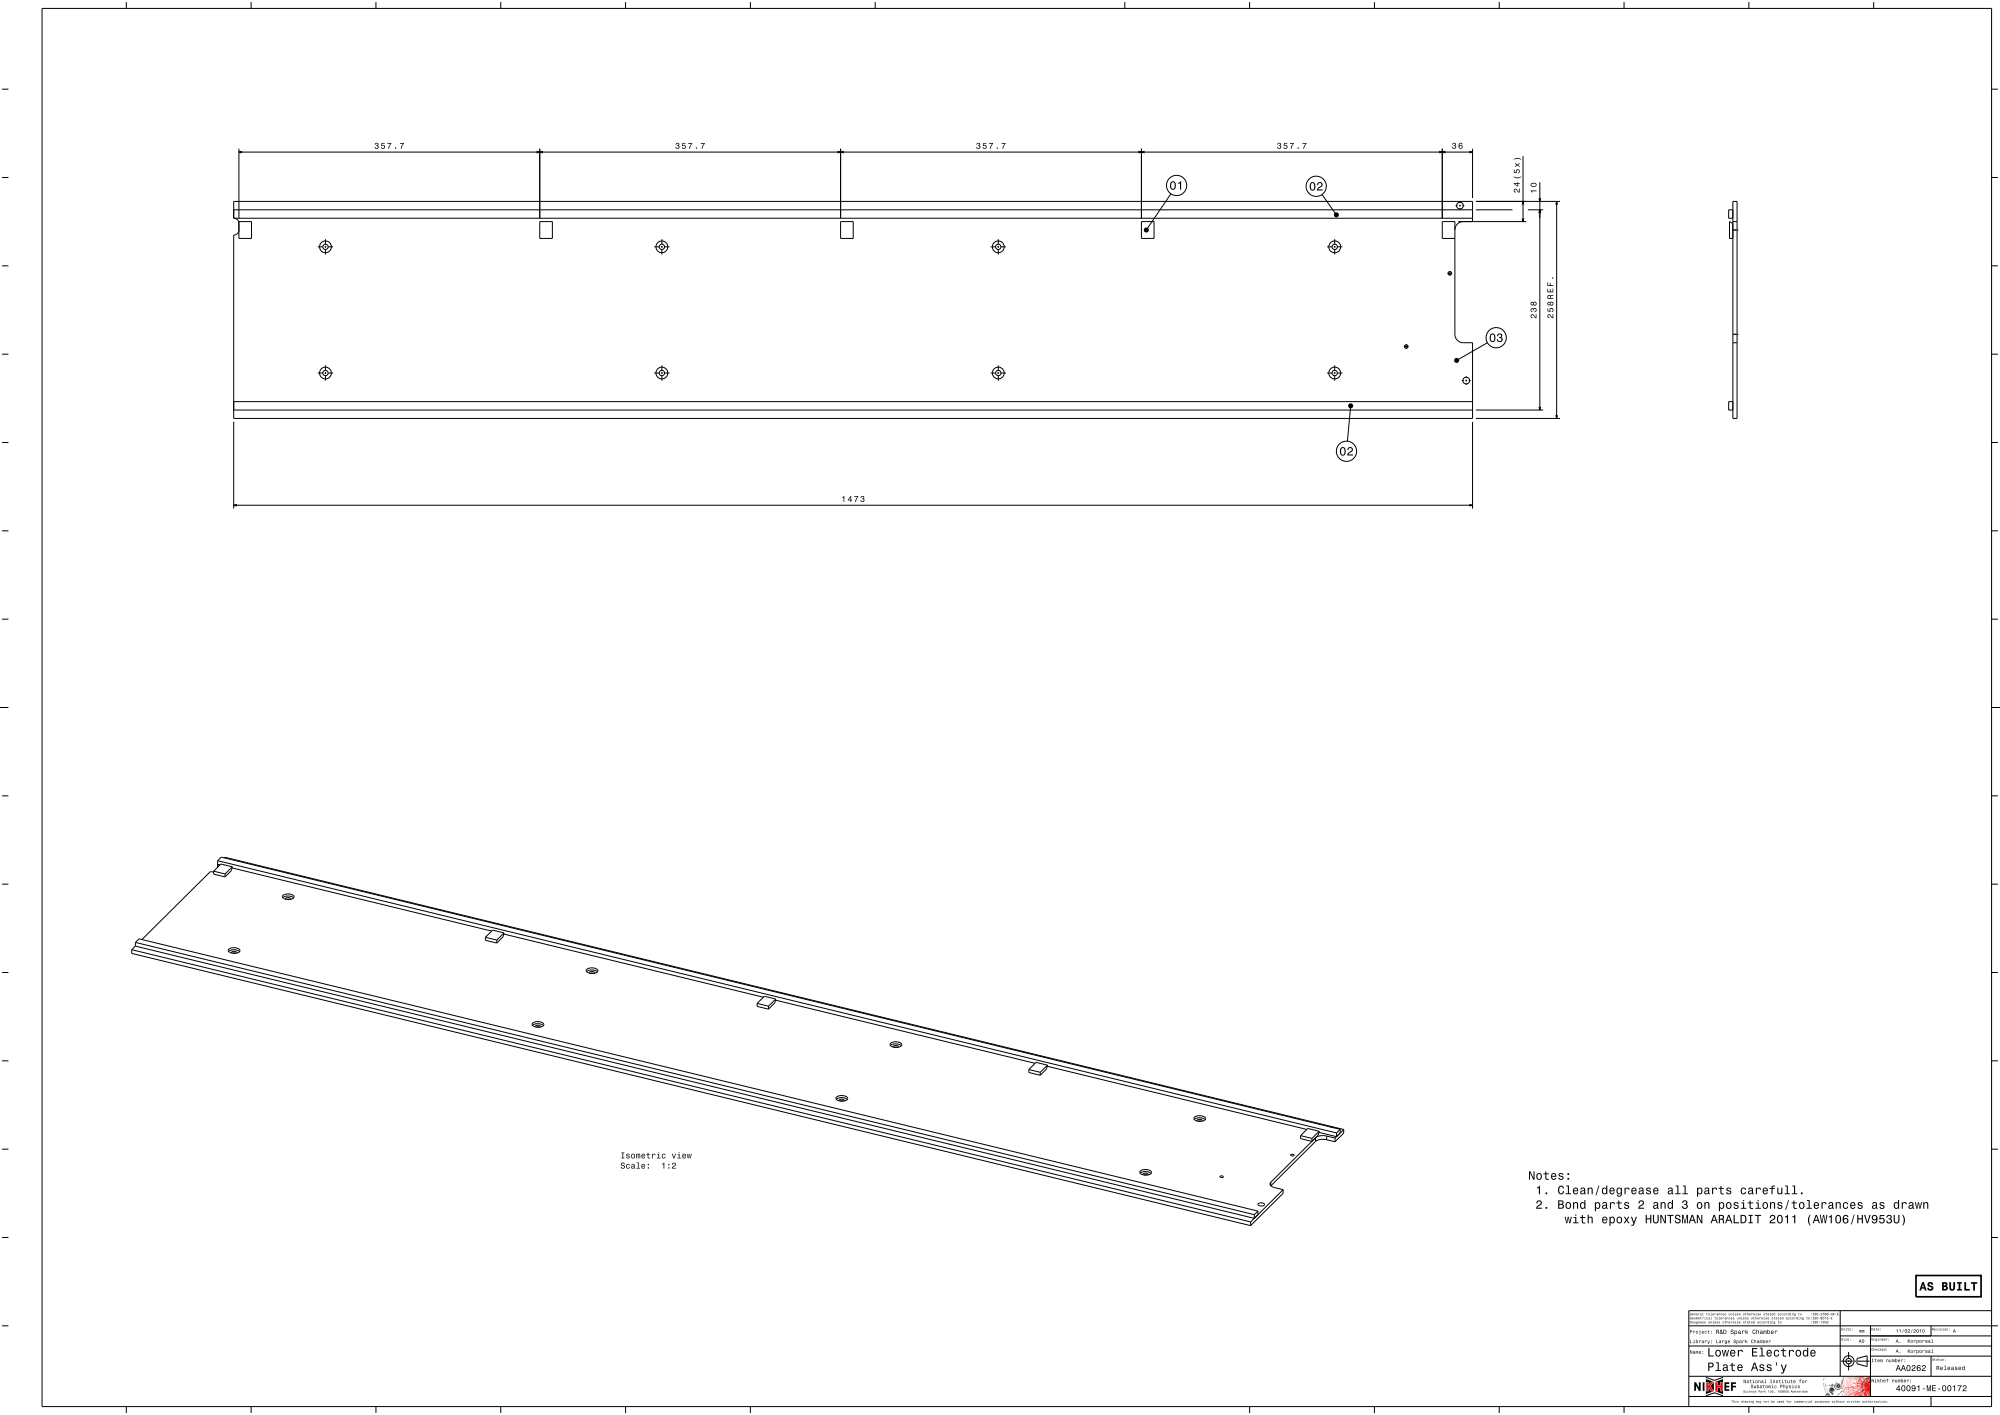
[picture p11: page 1]
