chrisgilmerproj/spark_chamber/Spark Chamber Large/Assembly Servicing Housing BOM_AA0296_B.pdf

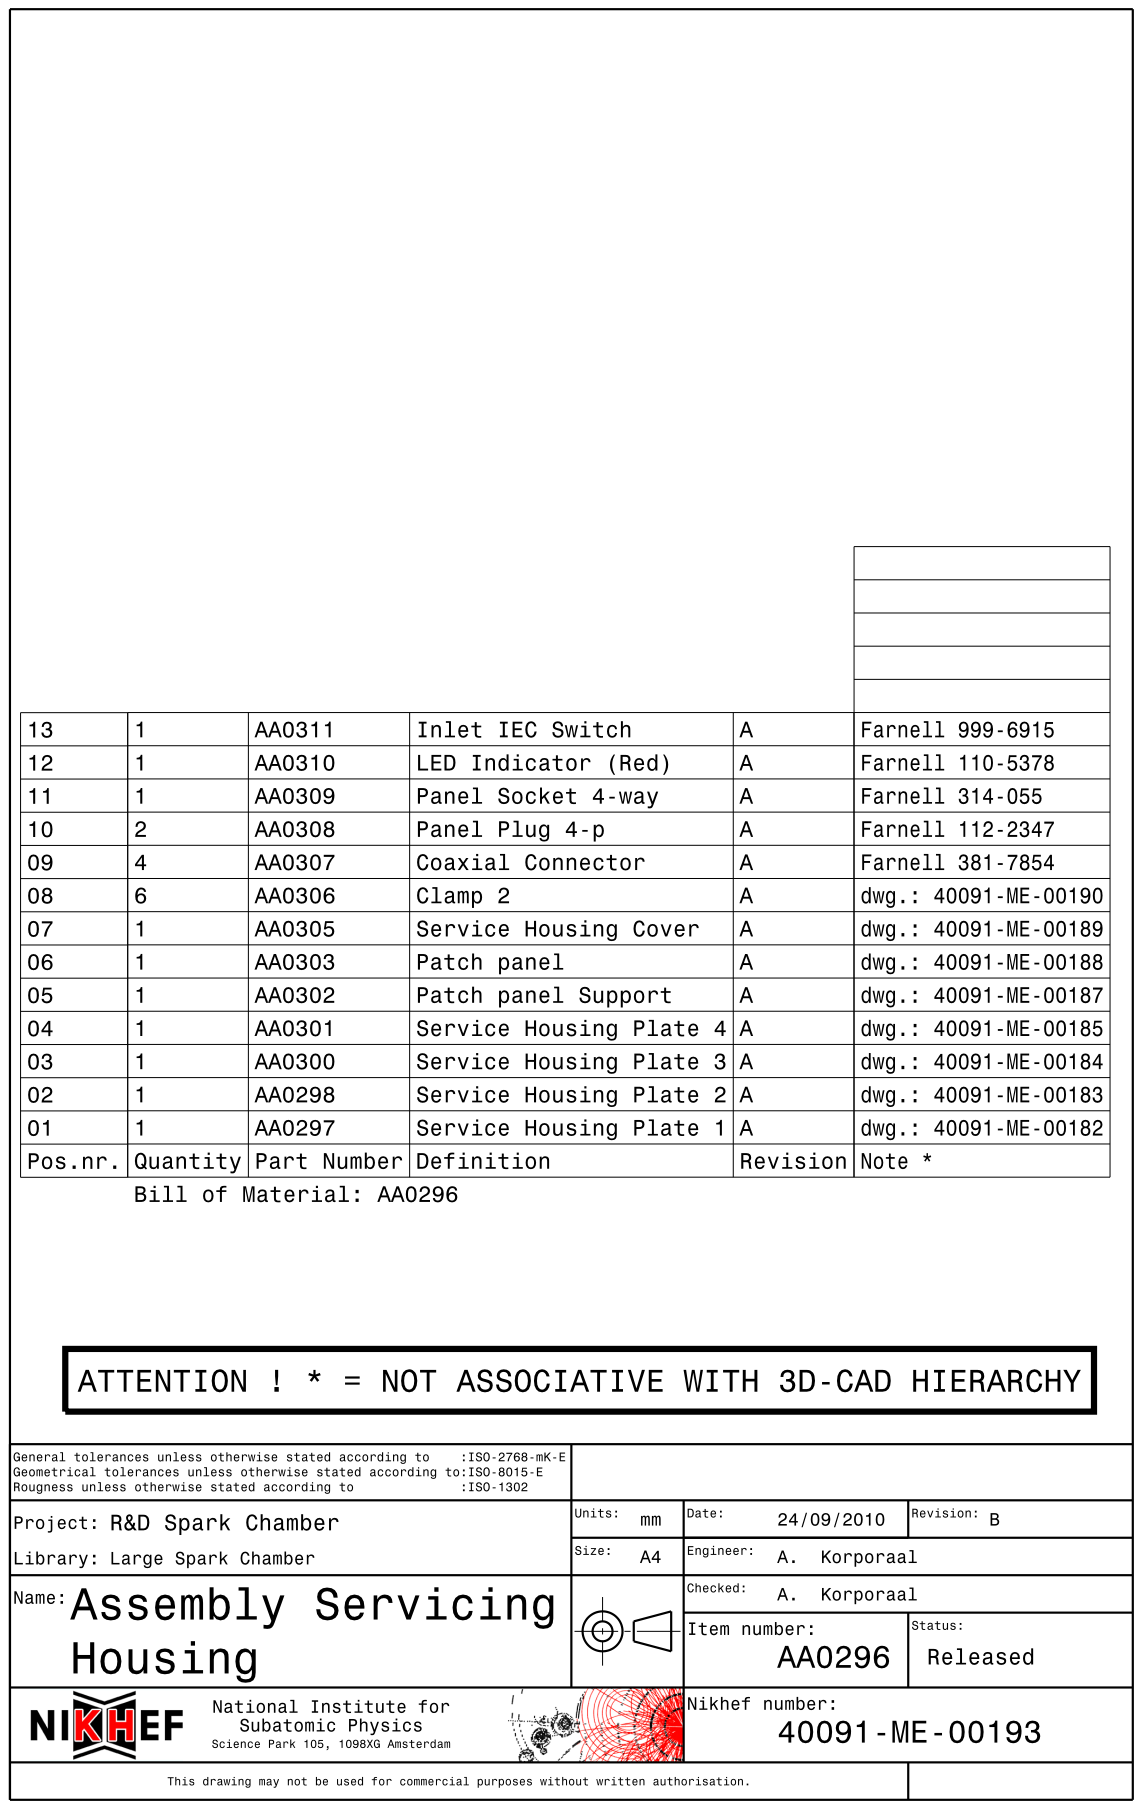
[picture p12: page 1]
