chrisgilmerproj/spark_chamber/Spark Chamber Large/Assembly Servicing Housing_AA0296_A.pdf

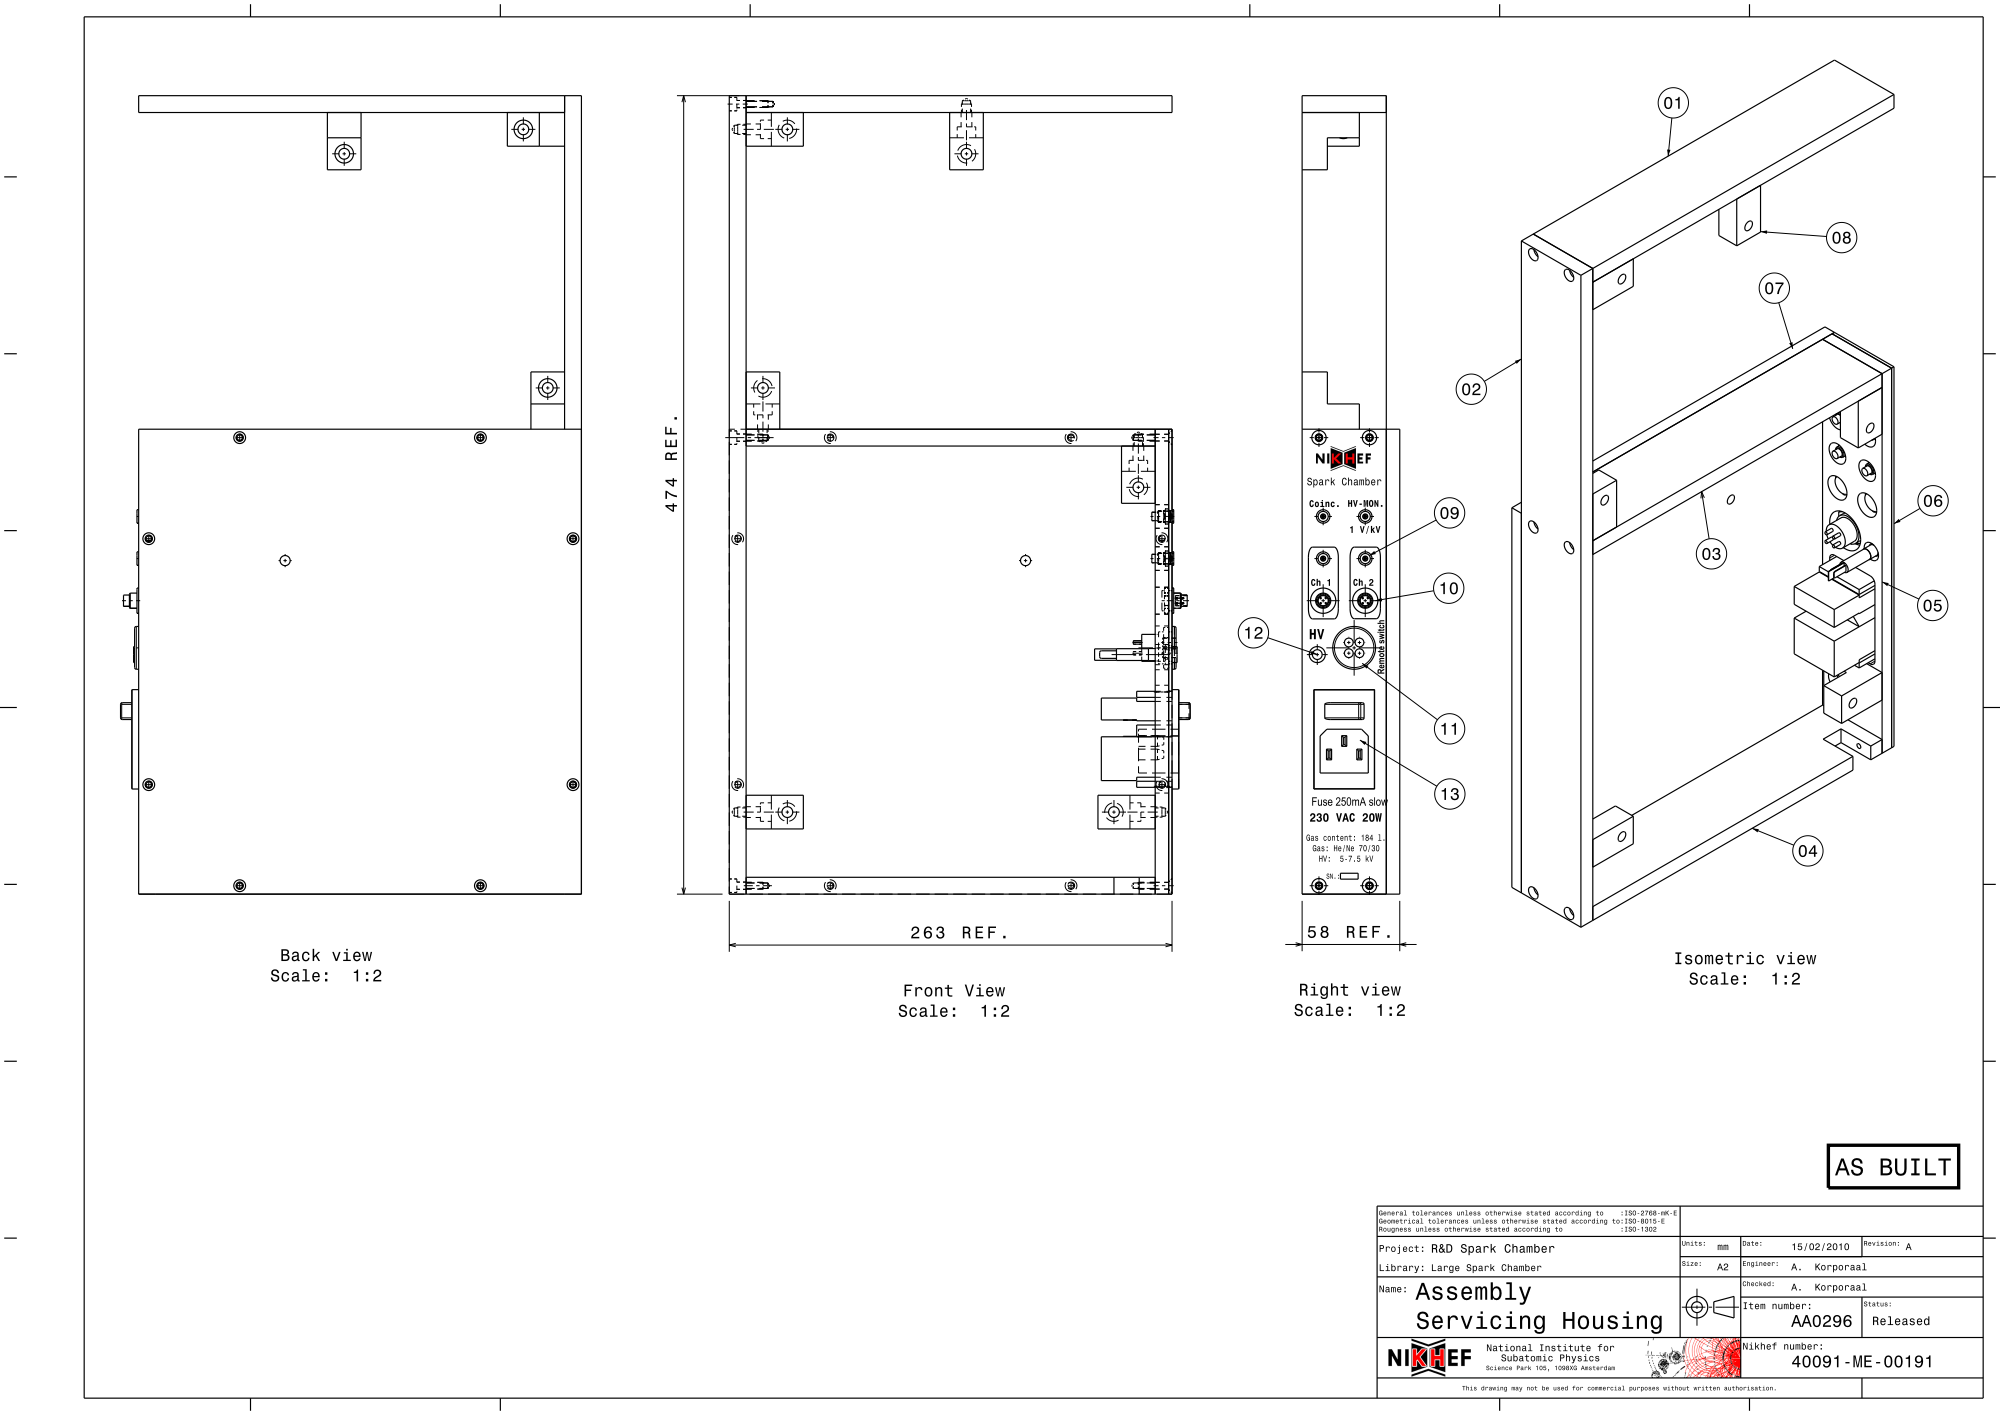
[picture p13: page 1]
