chrisgilmerproj/spark_chamber/Spark Chamber Large/Lower Electrode Plate Ass_y BOM_AA0262.pdf

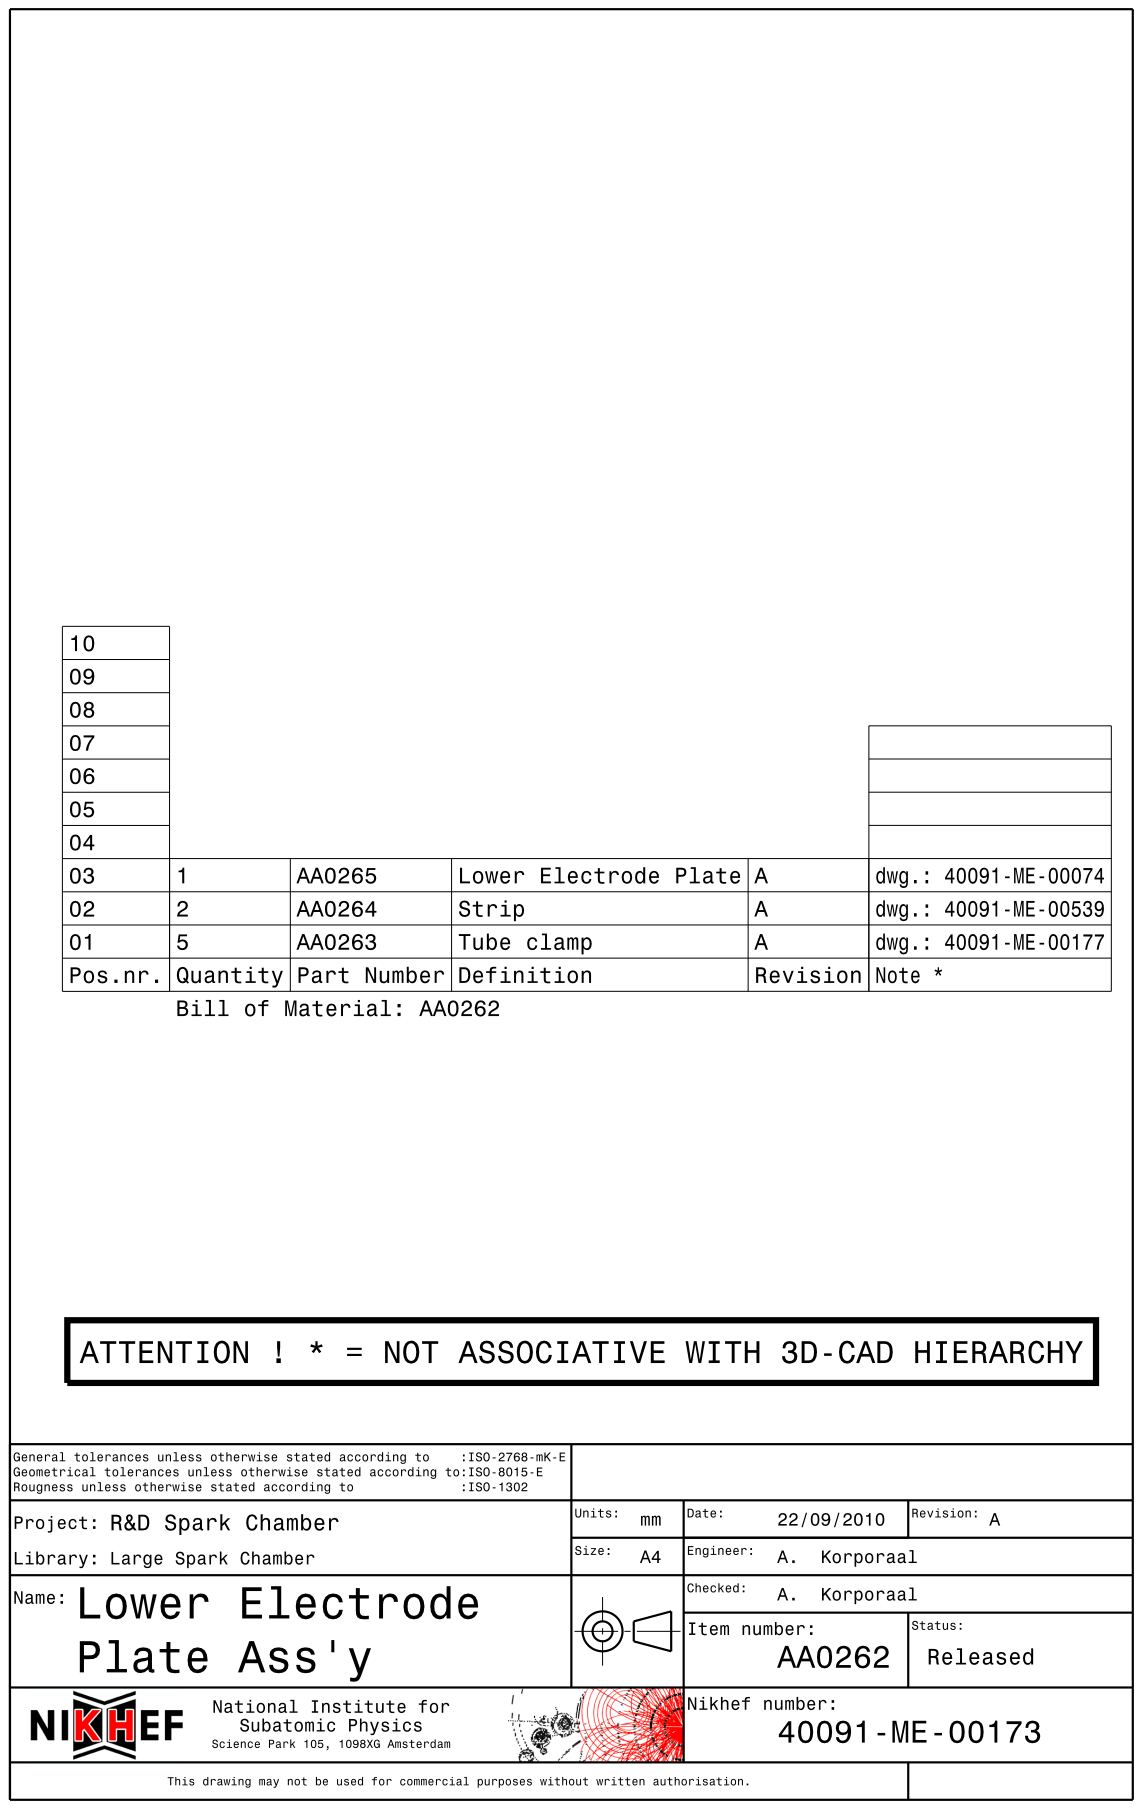
[picture p14: page 1]
