chrisgilmerproj/spark_chamber/Spark Chamber Small/Assy_Spark_Chamber_BOM.pdf

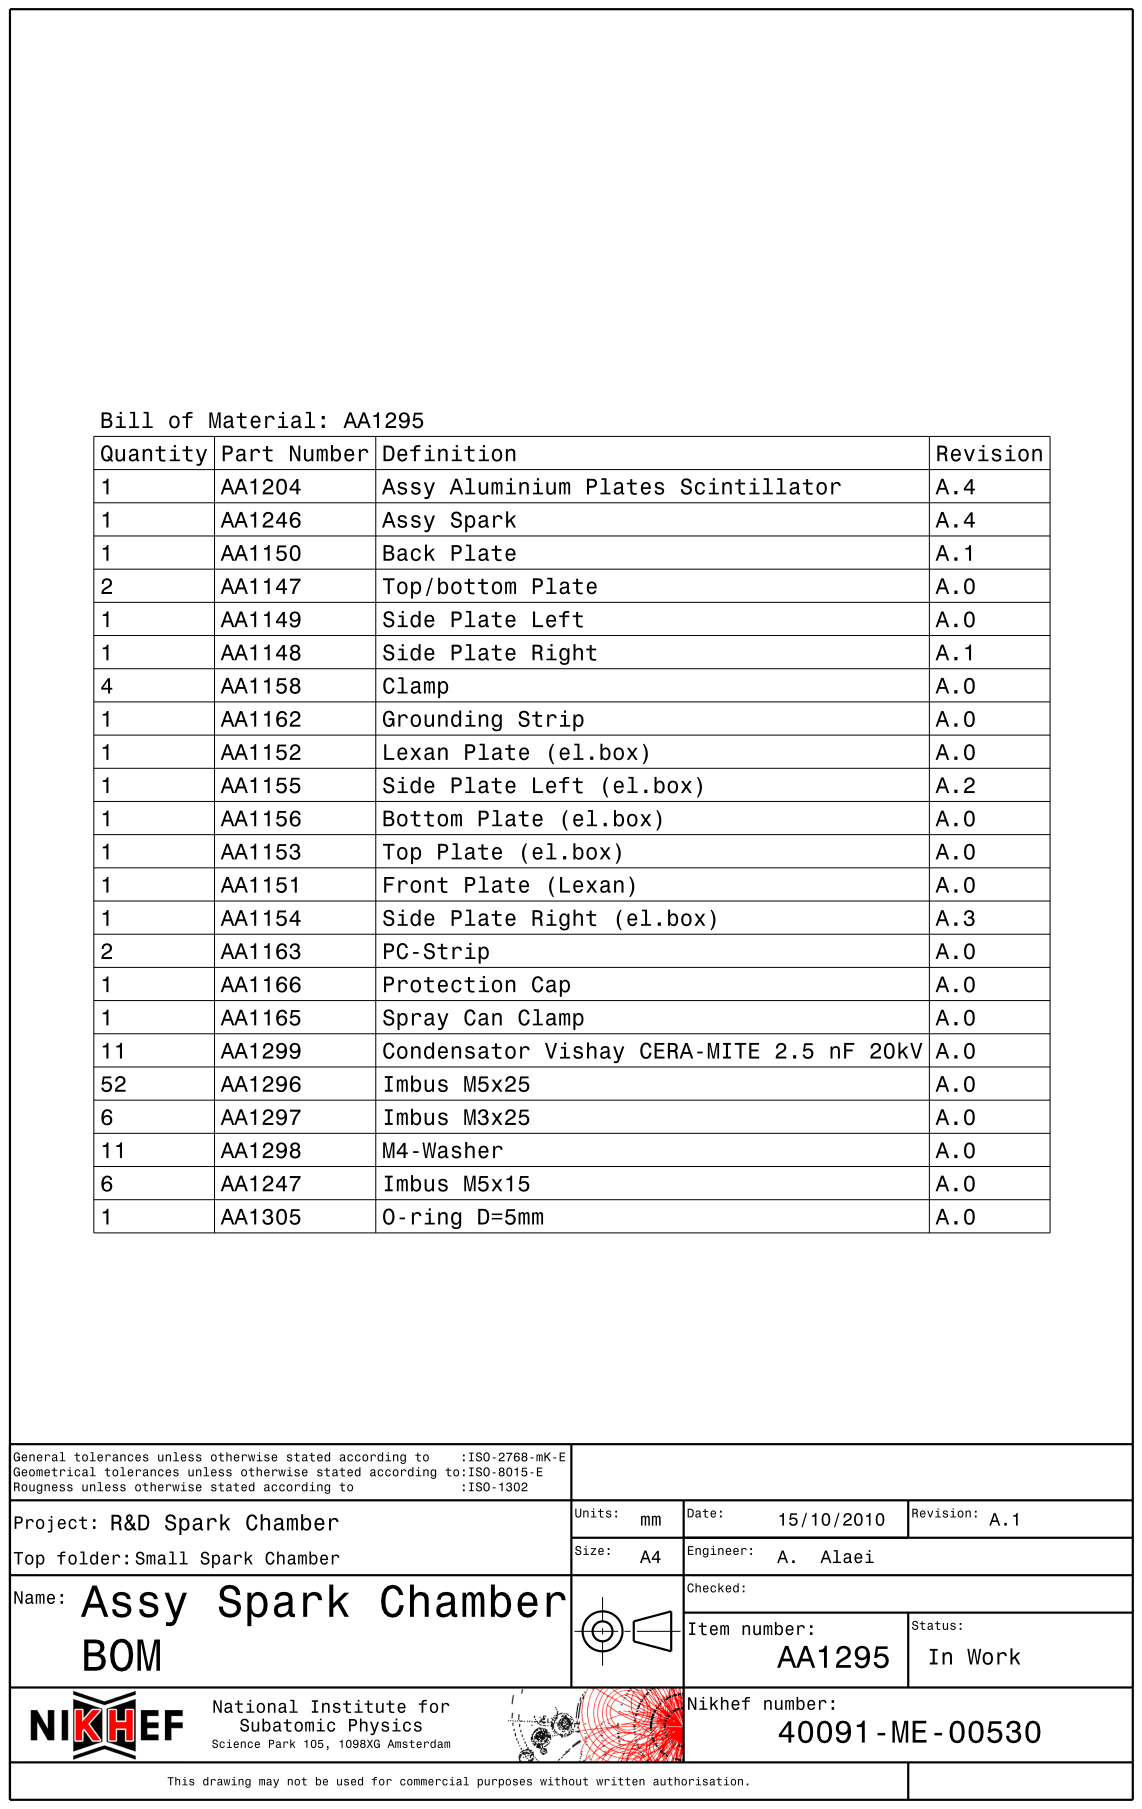
[picture p15: page 1]
