chrisgilmerproj/spark_chamber/Spark Chamber Small/Aluminum Plate Scintillator/Assy_Aluminium_Plates_Scintillator_BOM.pdf

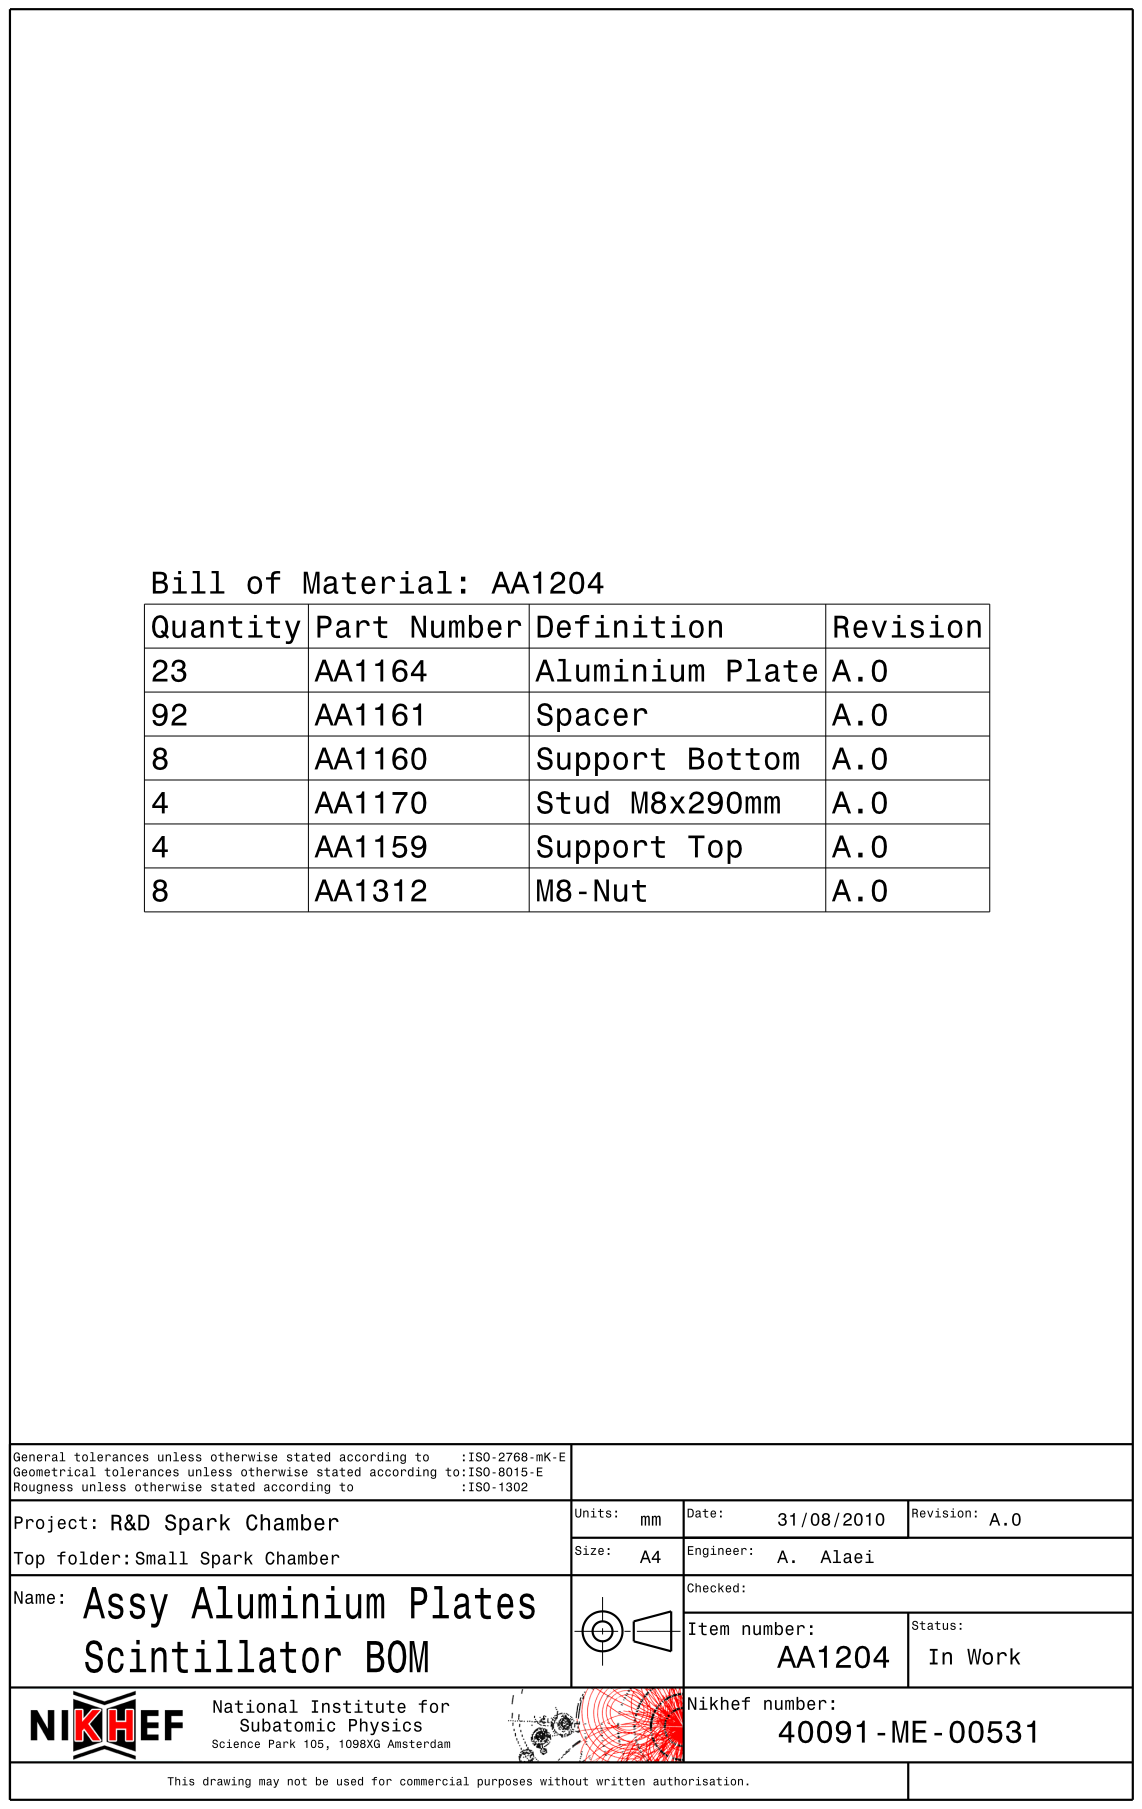
[picture p16: page 1]
