chrisgilmerproj/spark_chamber/Spark Chamber Small/Electronics Box/Bottom_plate(el.box).pdf

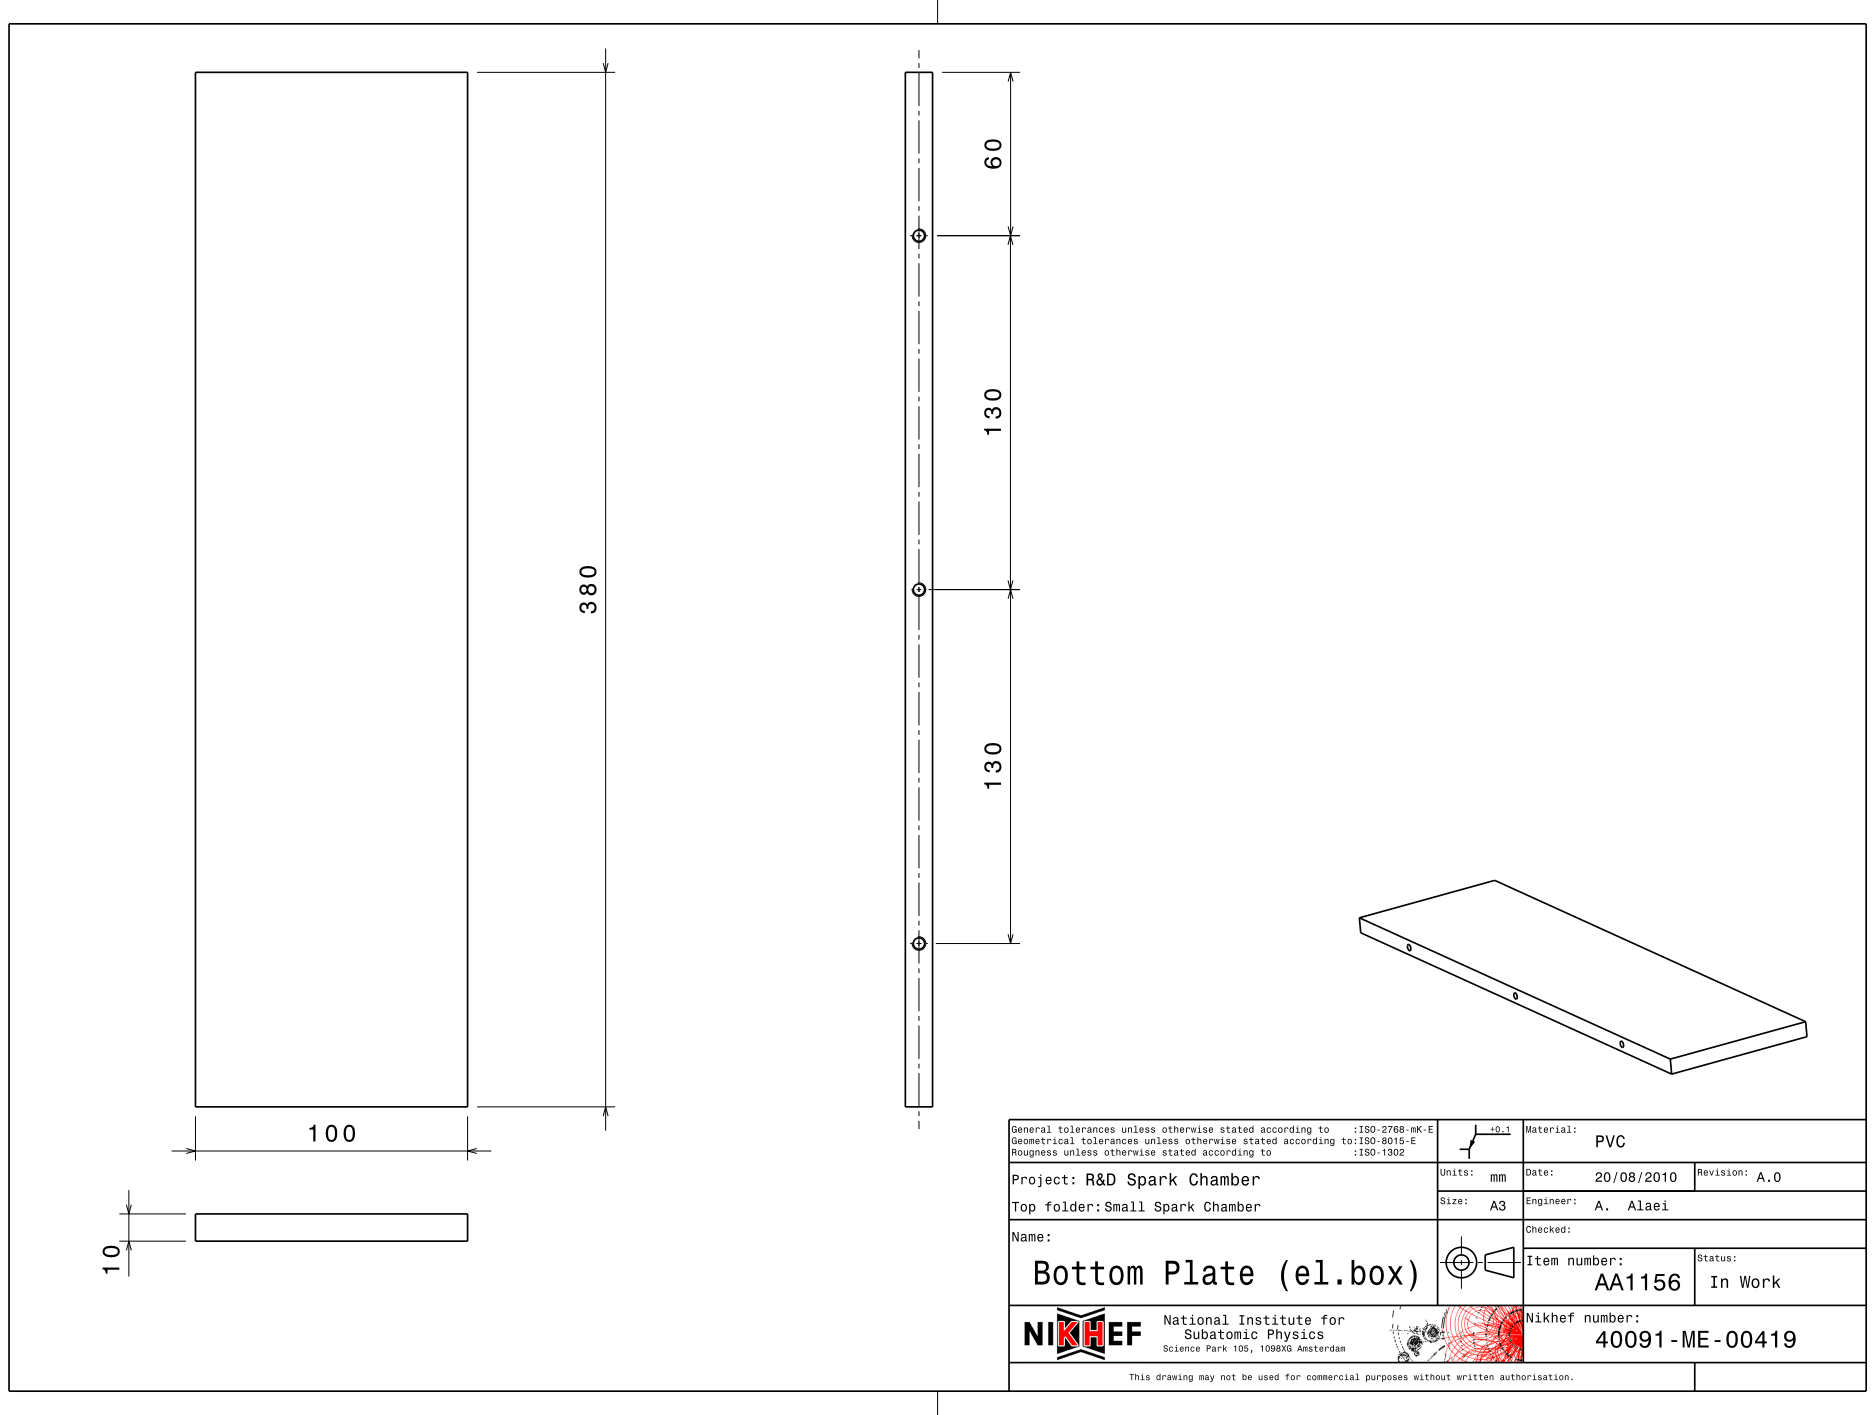
[picture p17: page 1]
