chrisgilmerproj/spark_chamber/Spark Chamber Small/Electronics Box/Lexan_plate(el.box).pdf

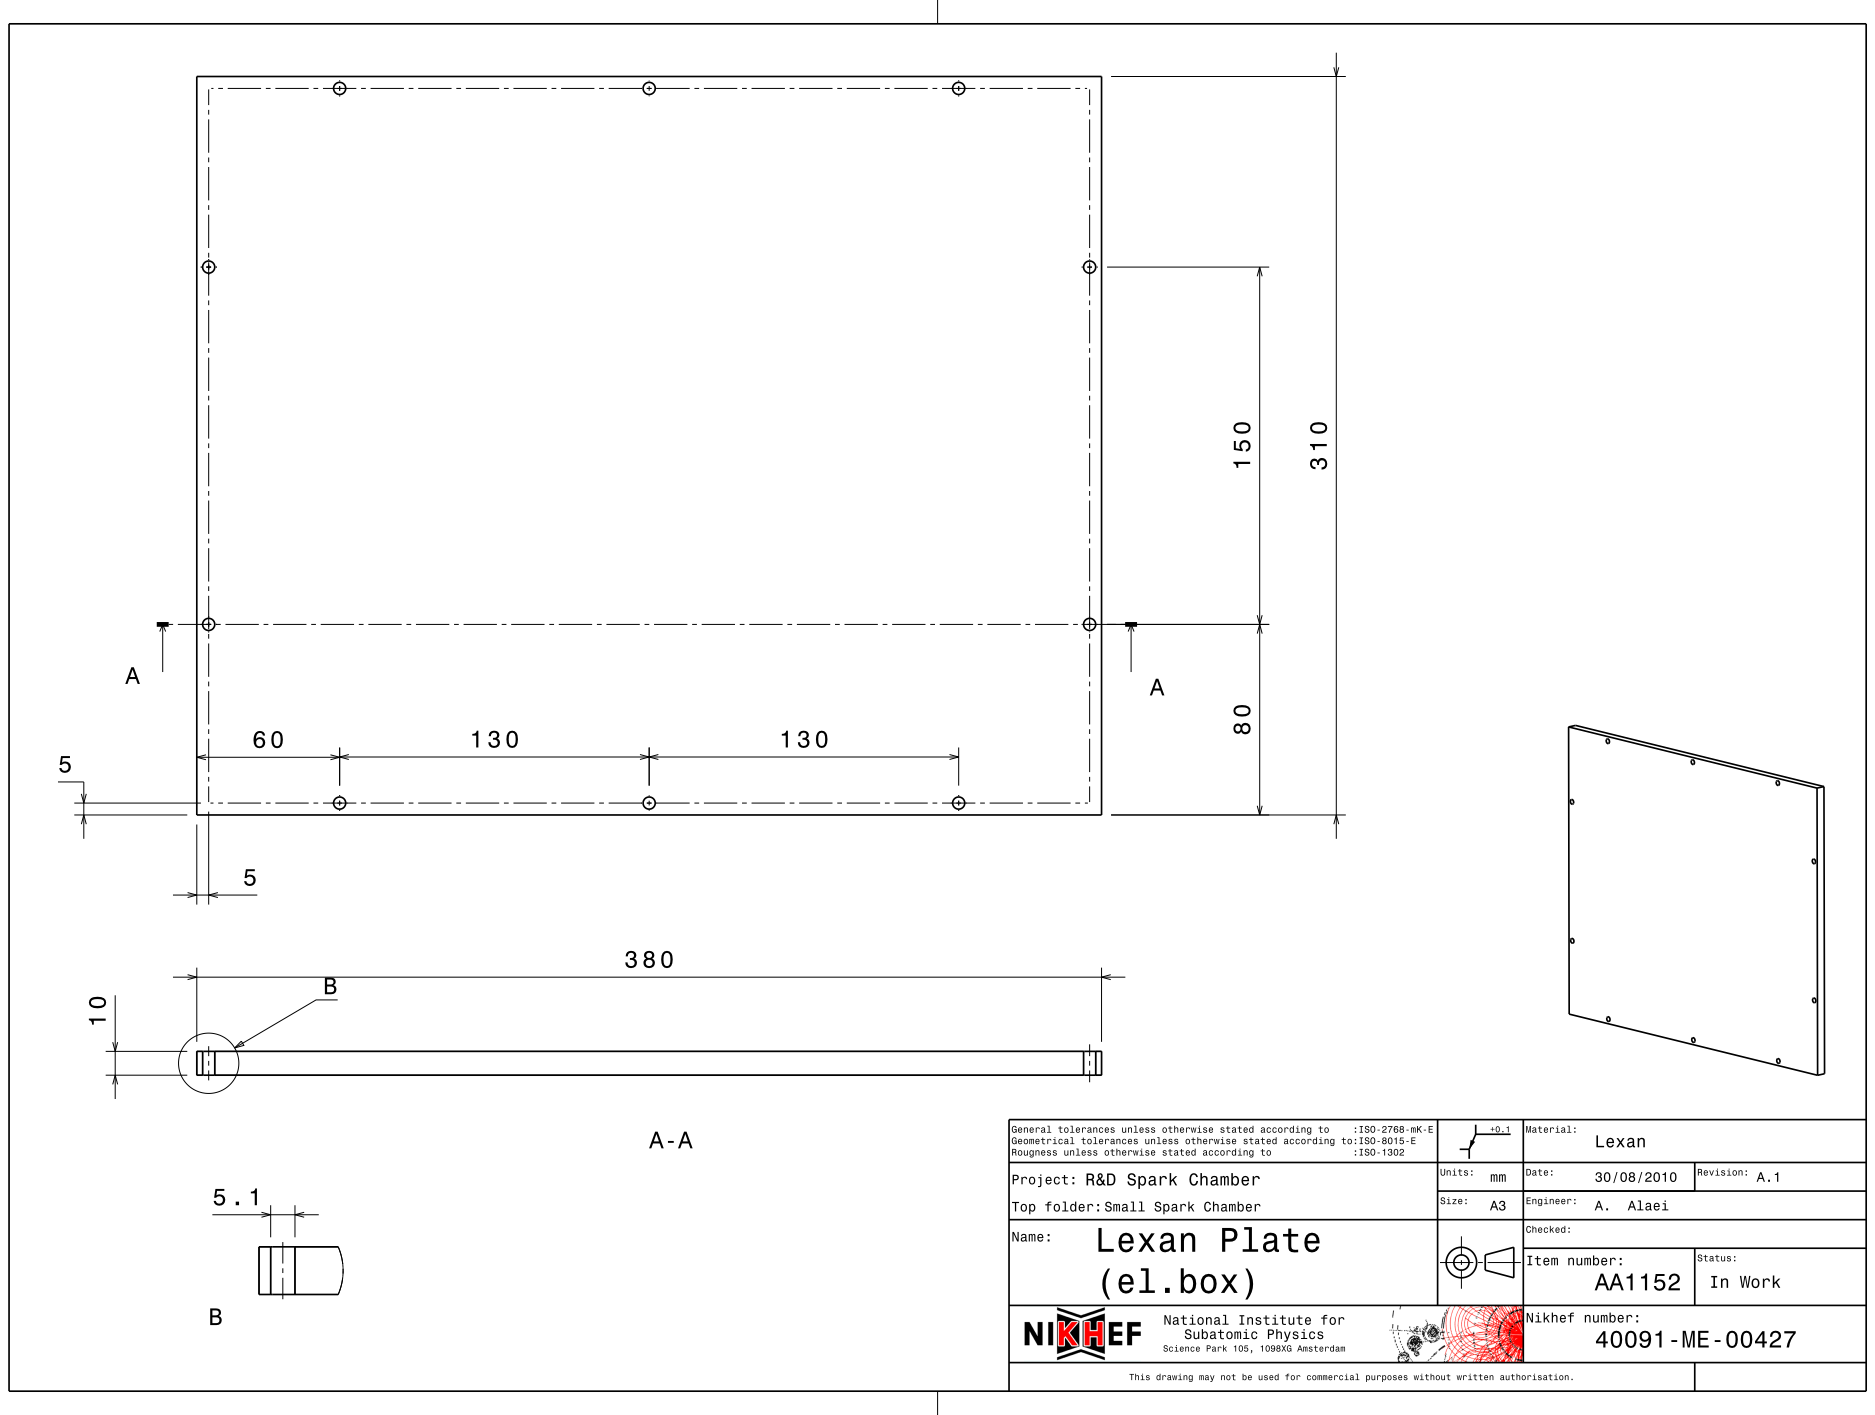
[picture p18: page 1]
