chrisgilmerproj/spark_chamber/Spark Chamber Small/Electronics Box/PC-strip.pdf

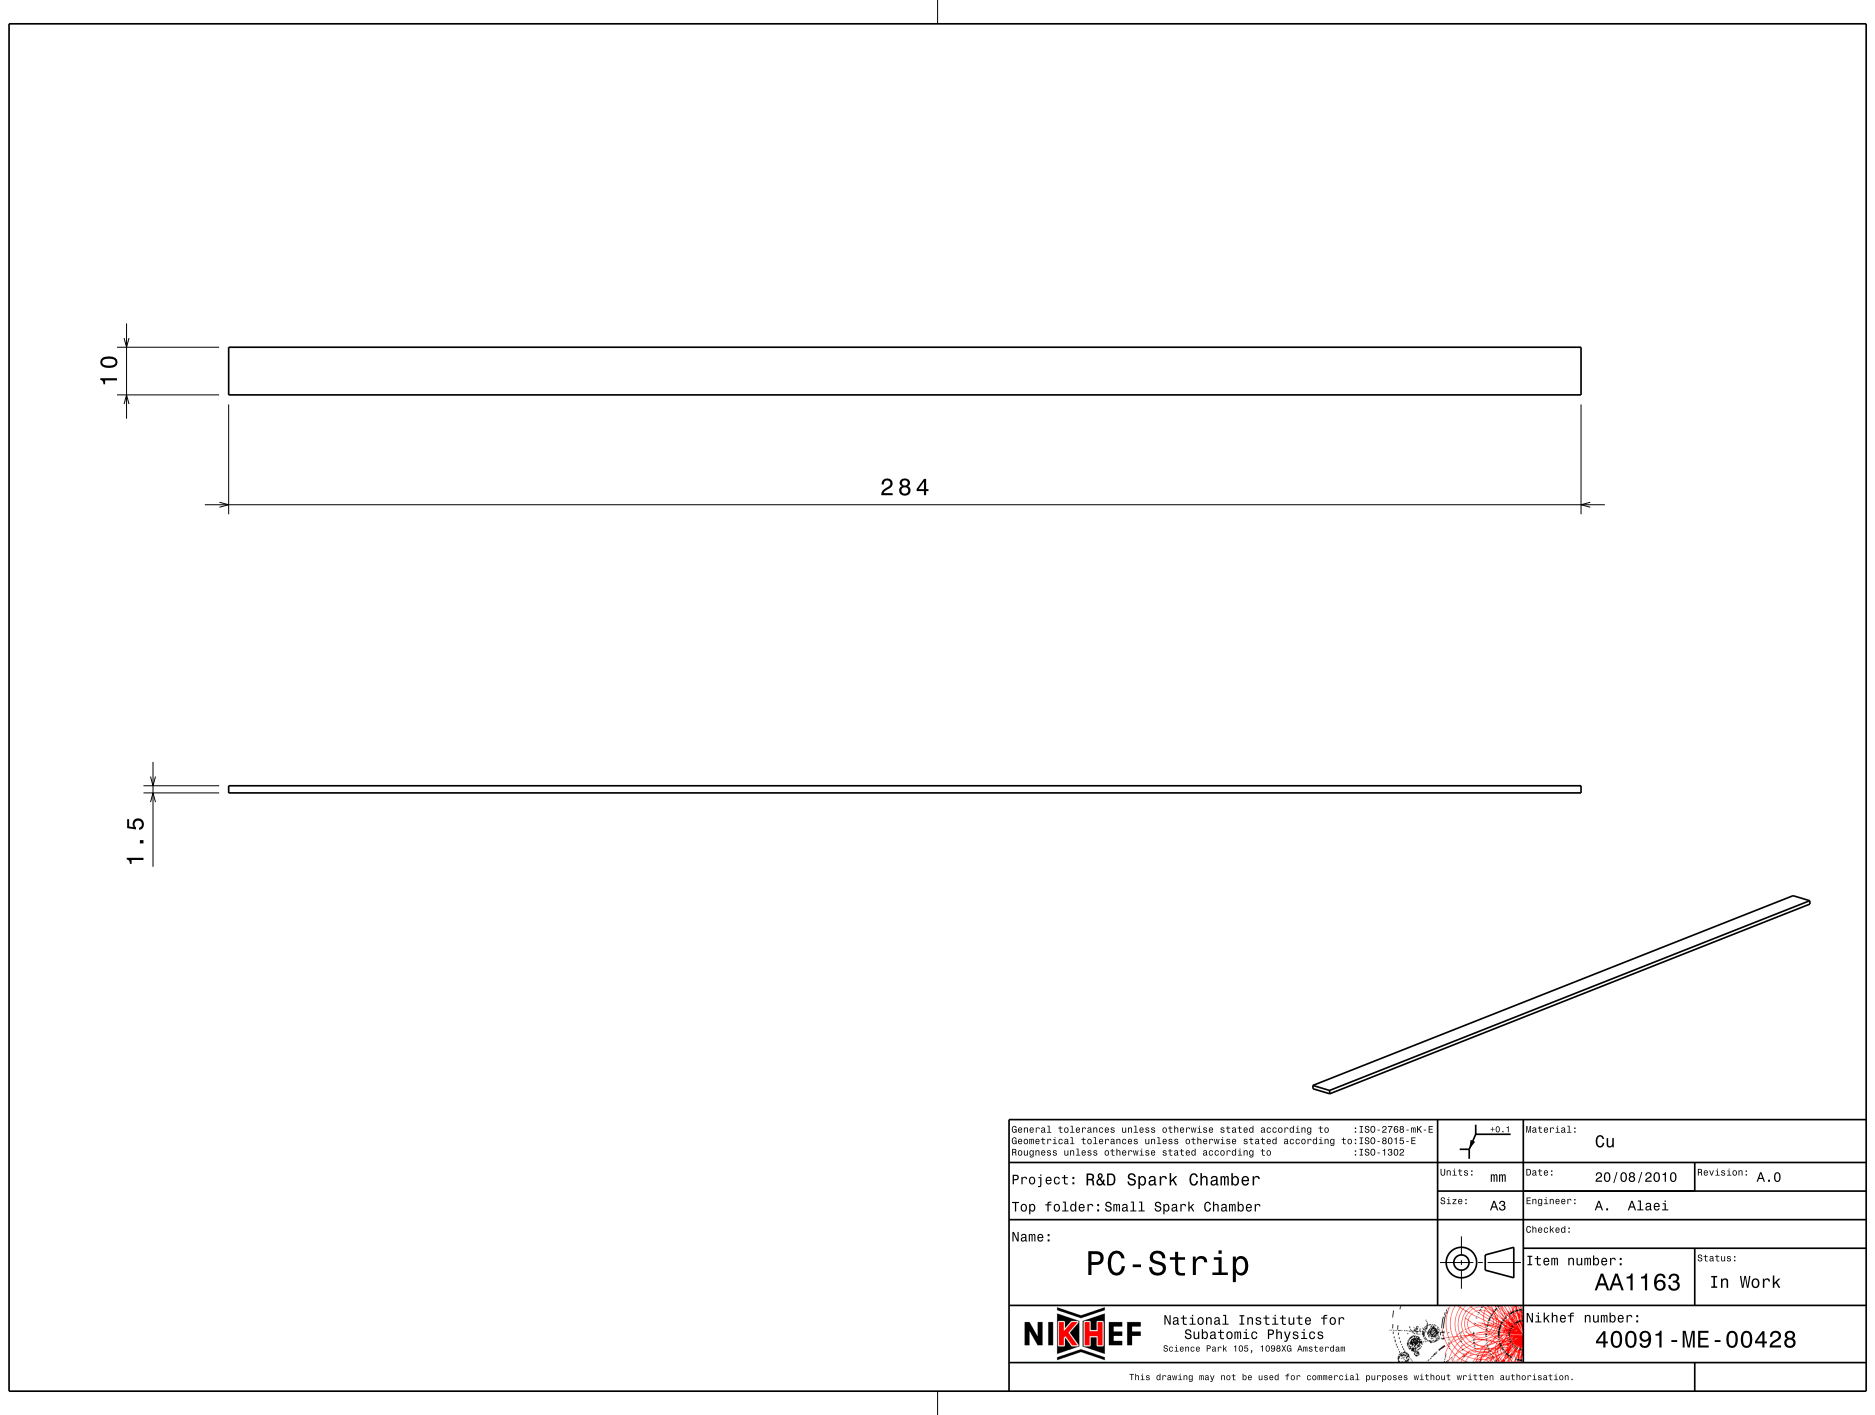
[picture p19: page 1]
