chrisgilmerproj/spark_chamber/Spark Chamber Small/Electronics Box/Side_plate_left(el.box).pdf

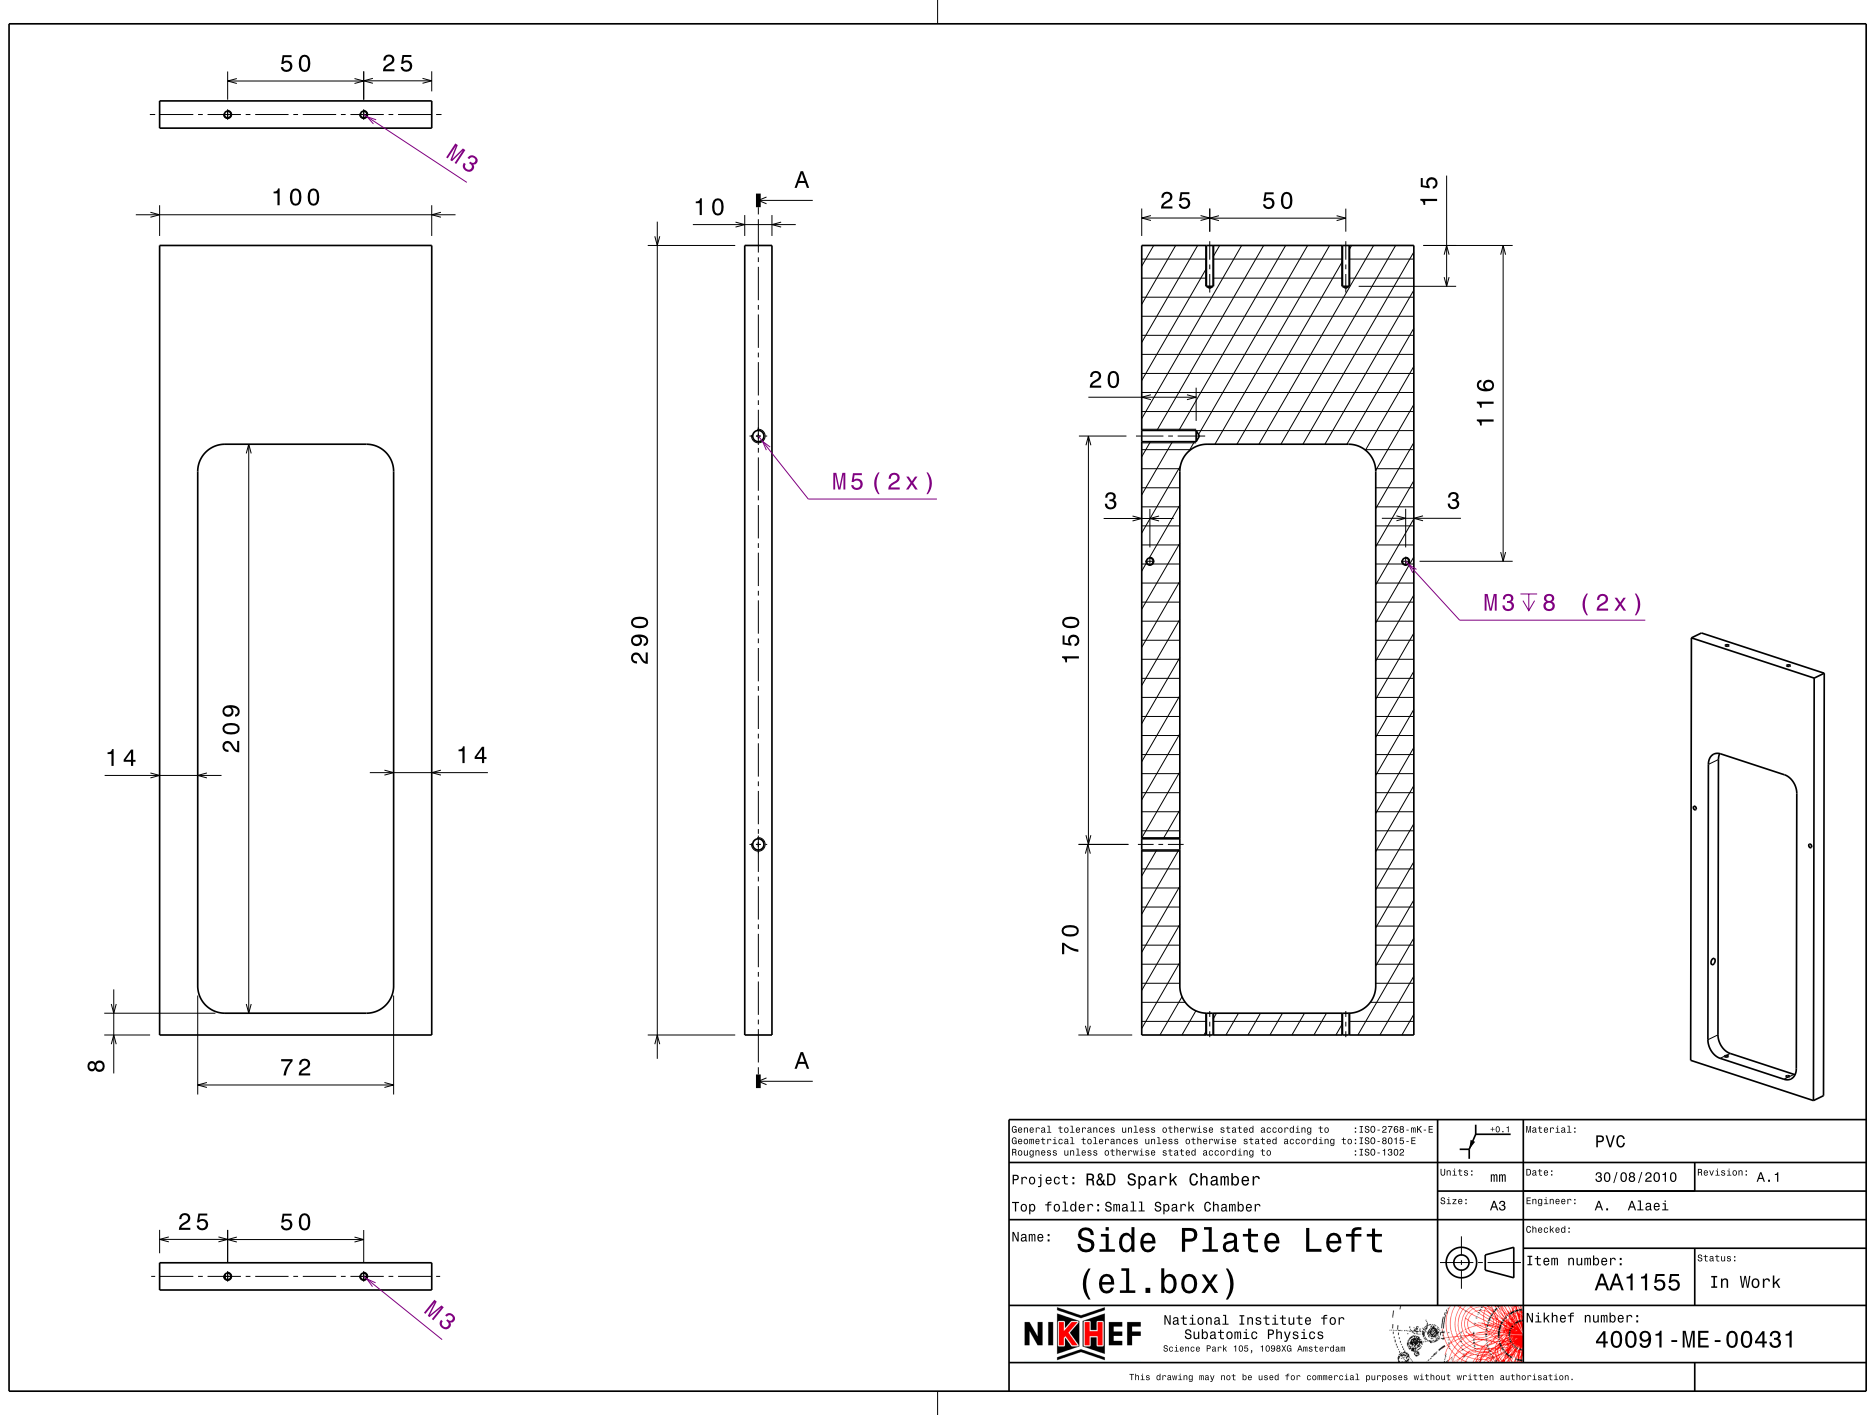
[picture p20: page 1]
