chrisgilmerproj/spark_chamber/Spark Chamber Small/Electronics Box/Side_plate_right(el.box).pdf

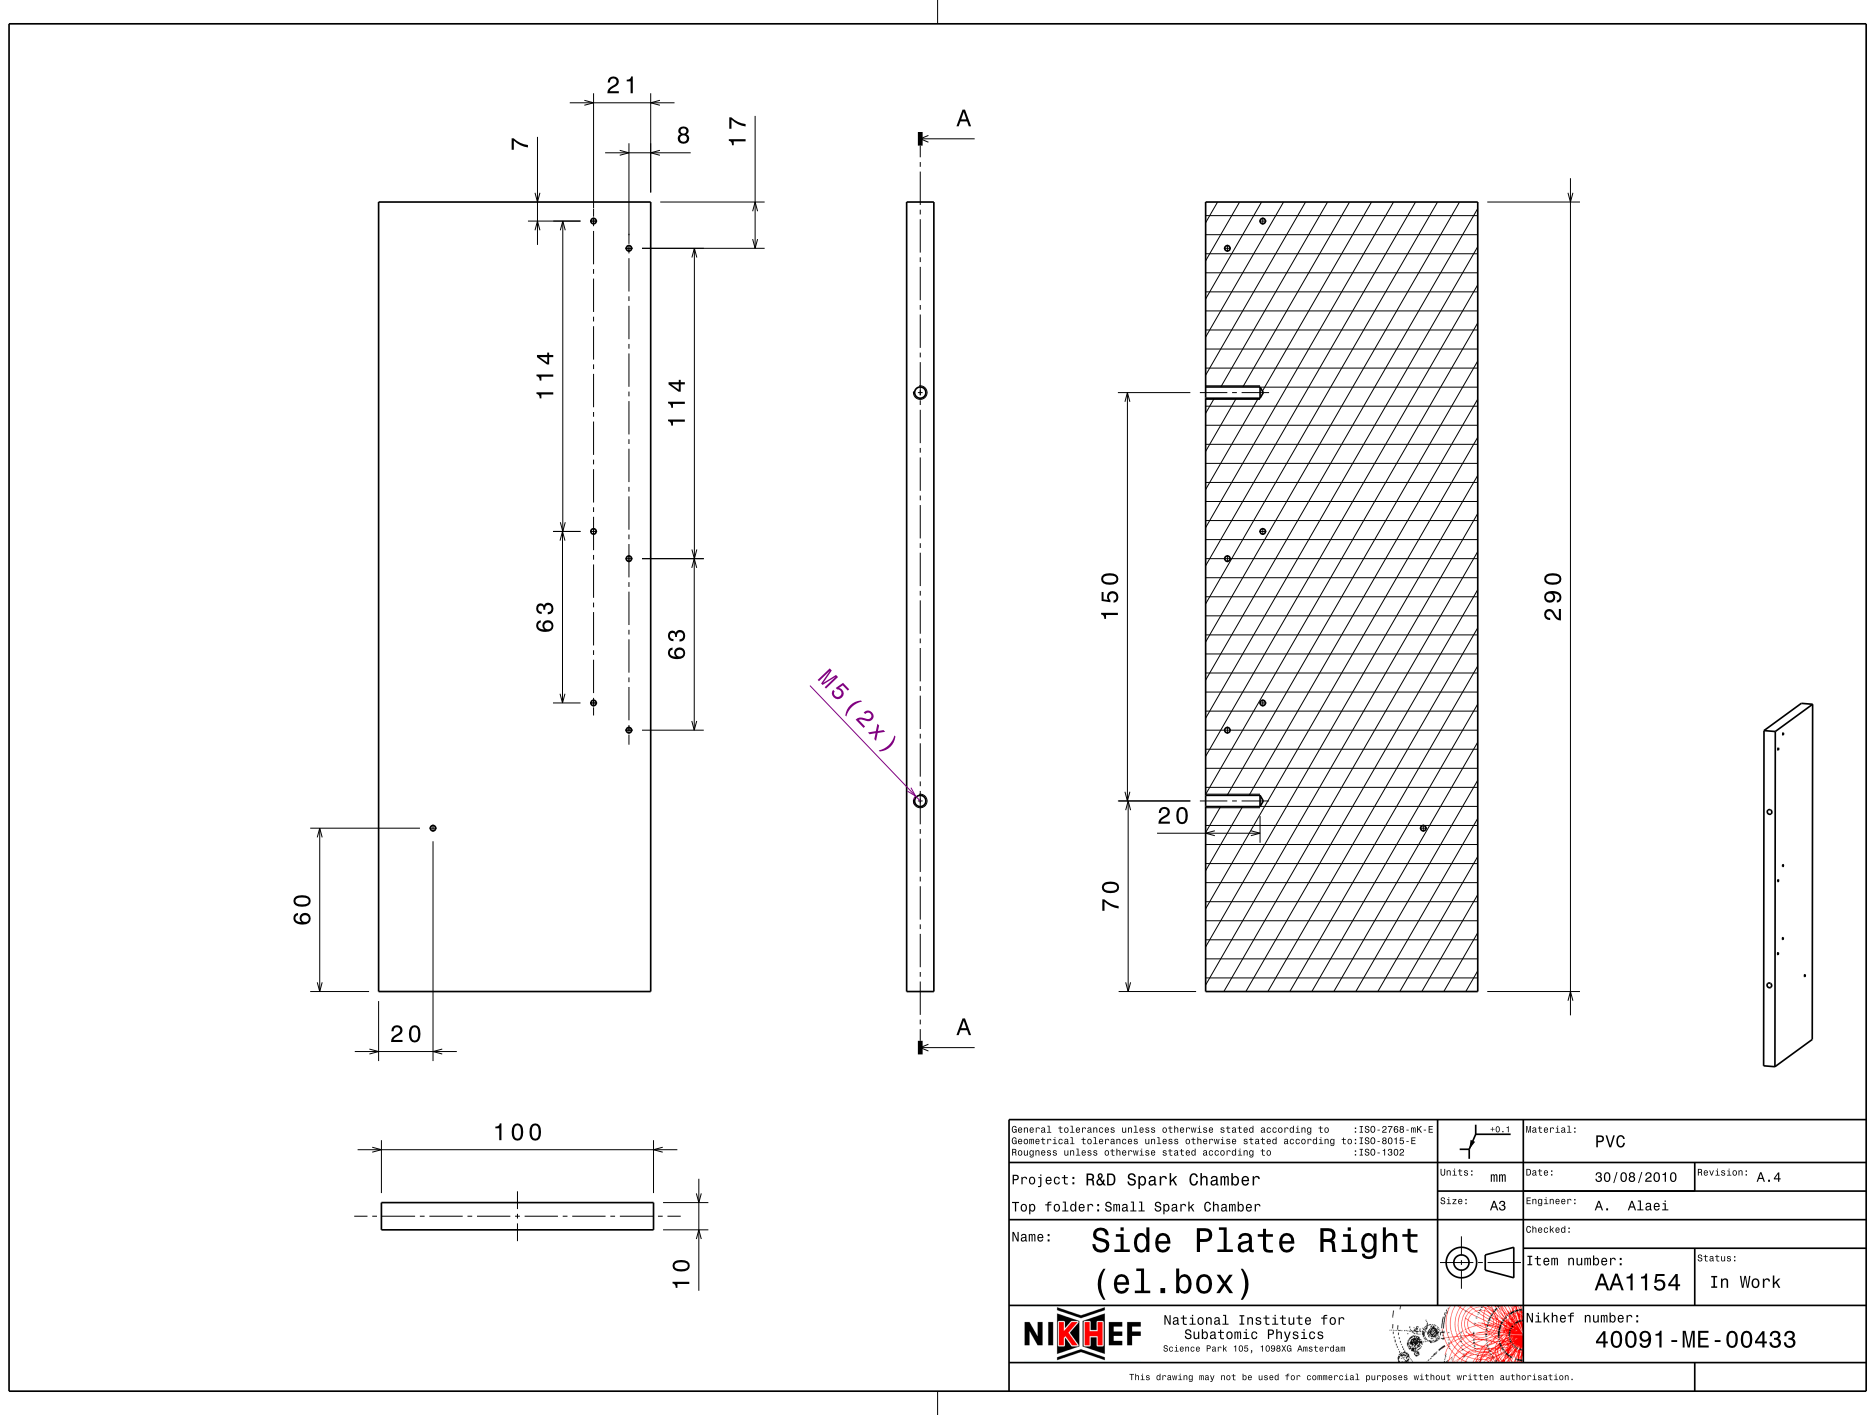
[picture p21: page 1]
