chrisgilmerproj/spark_chamber/Spark Chamber Small/Electronics Box/Top_plate(el.box).pdf

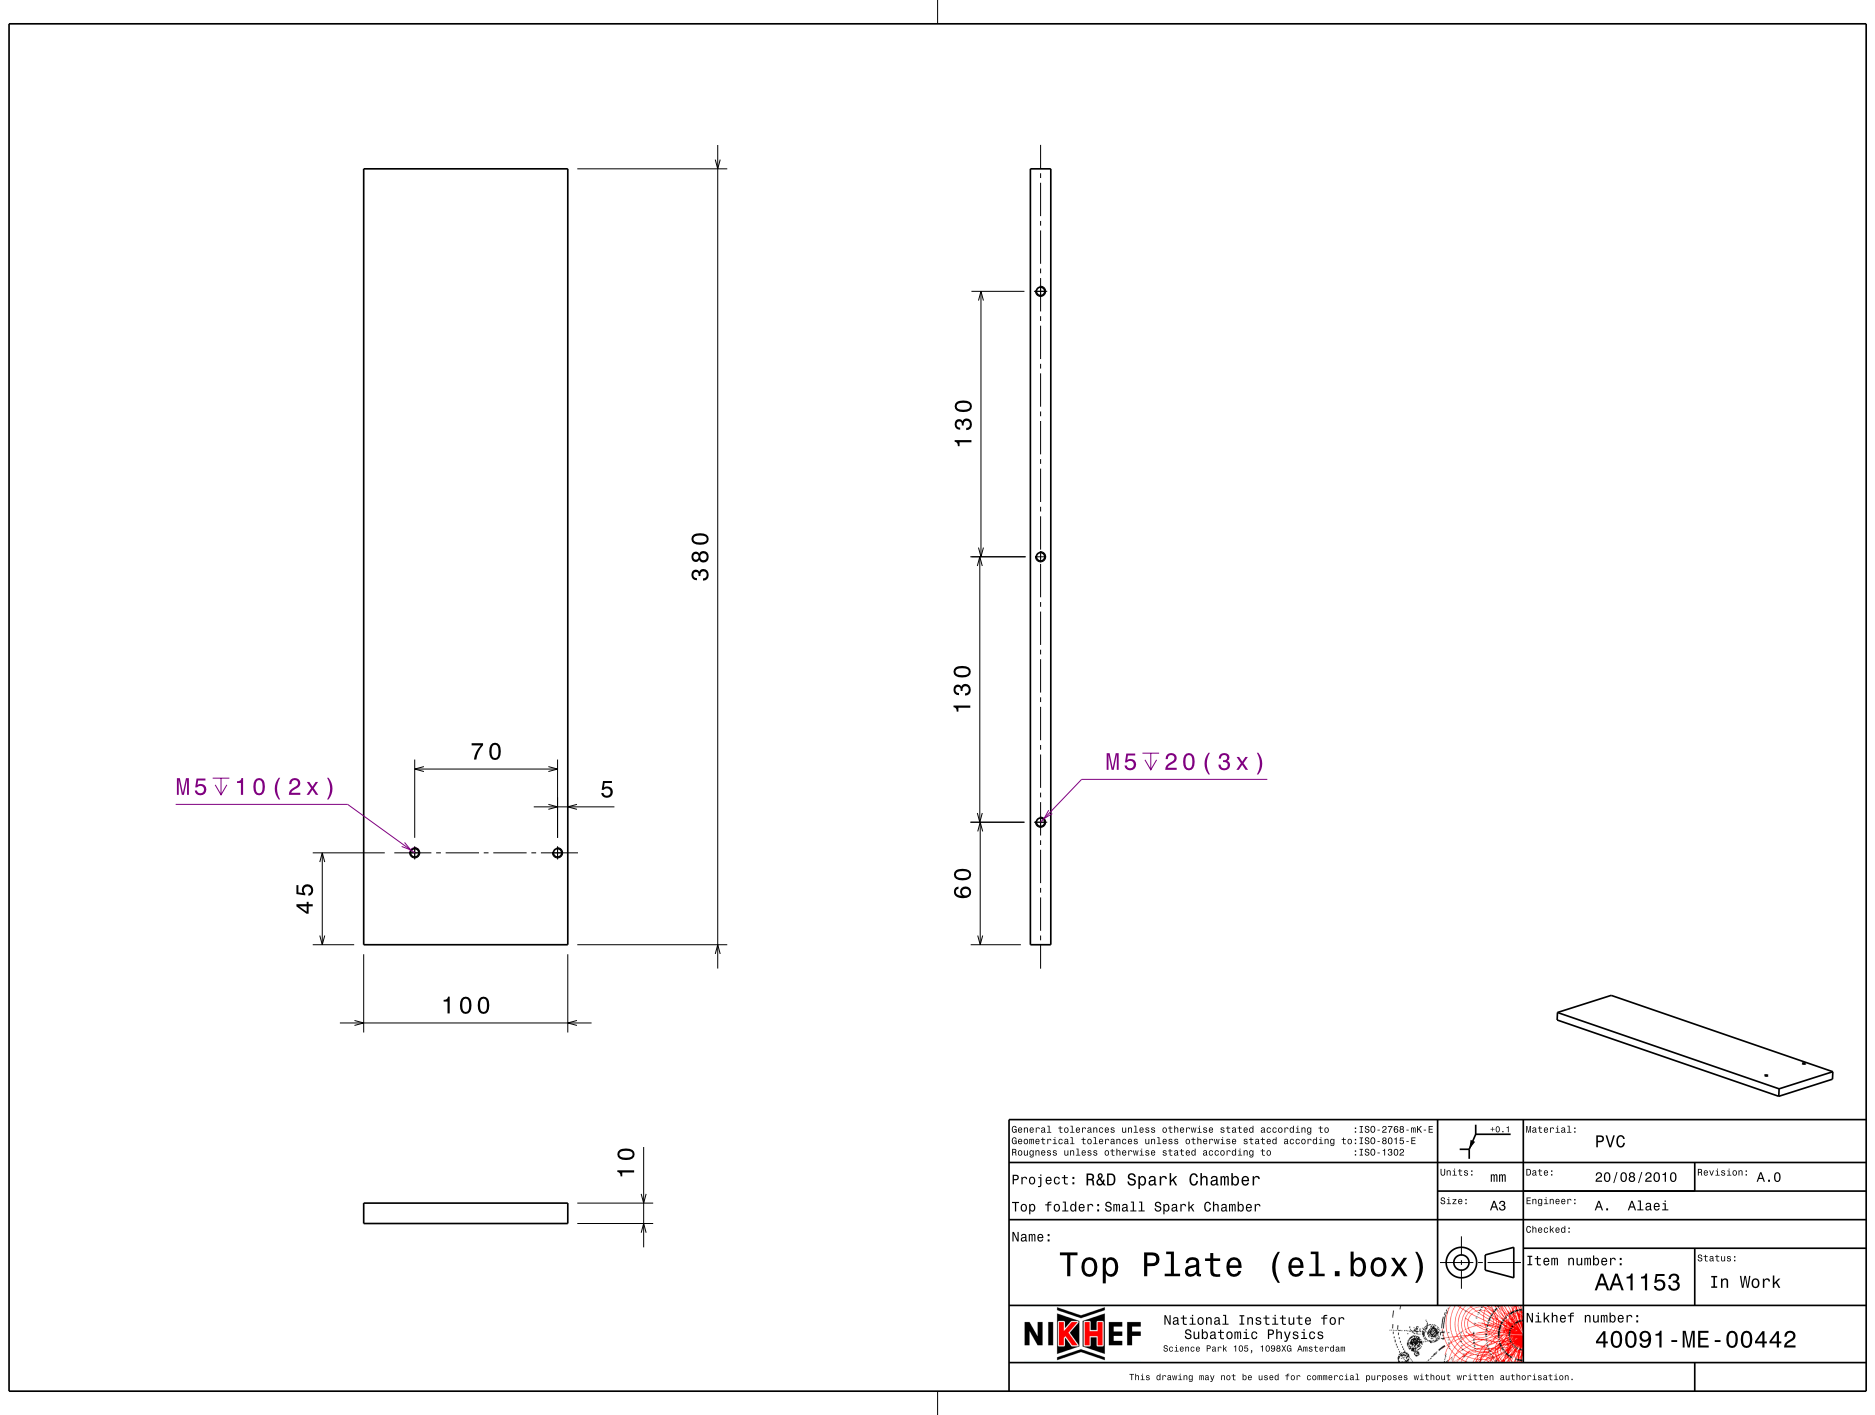
[picture p22: page 1]
