chrisgilmerproj/spark_chamber/Spark Chamber Small/Scintillator/Assy_Scintillator_BOM.pdf

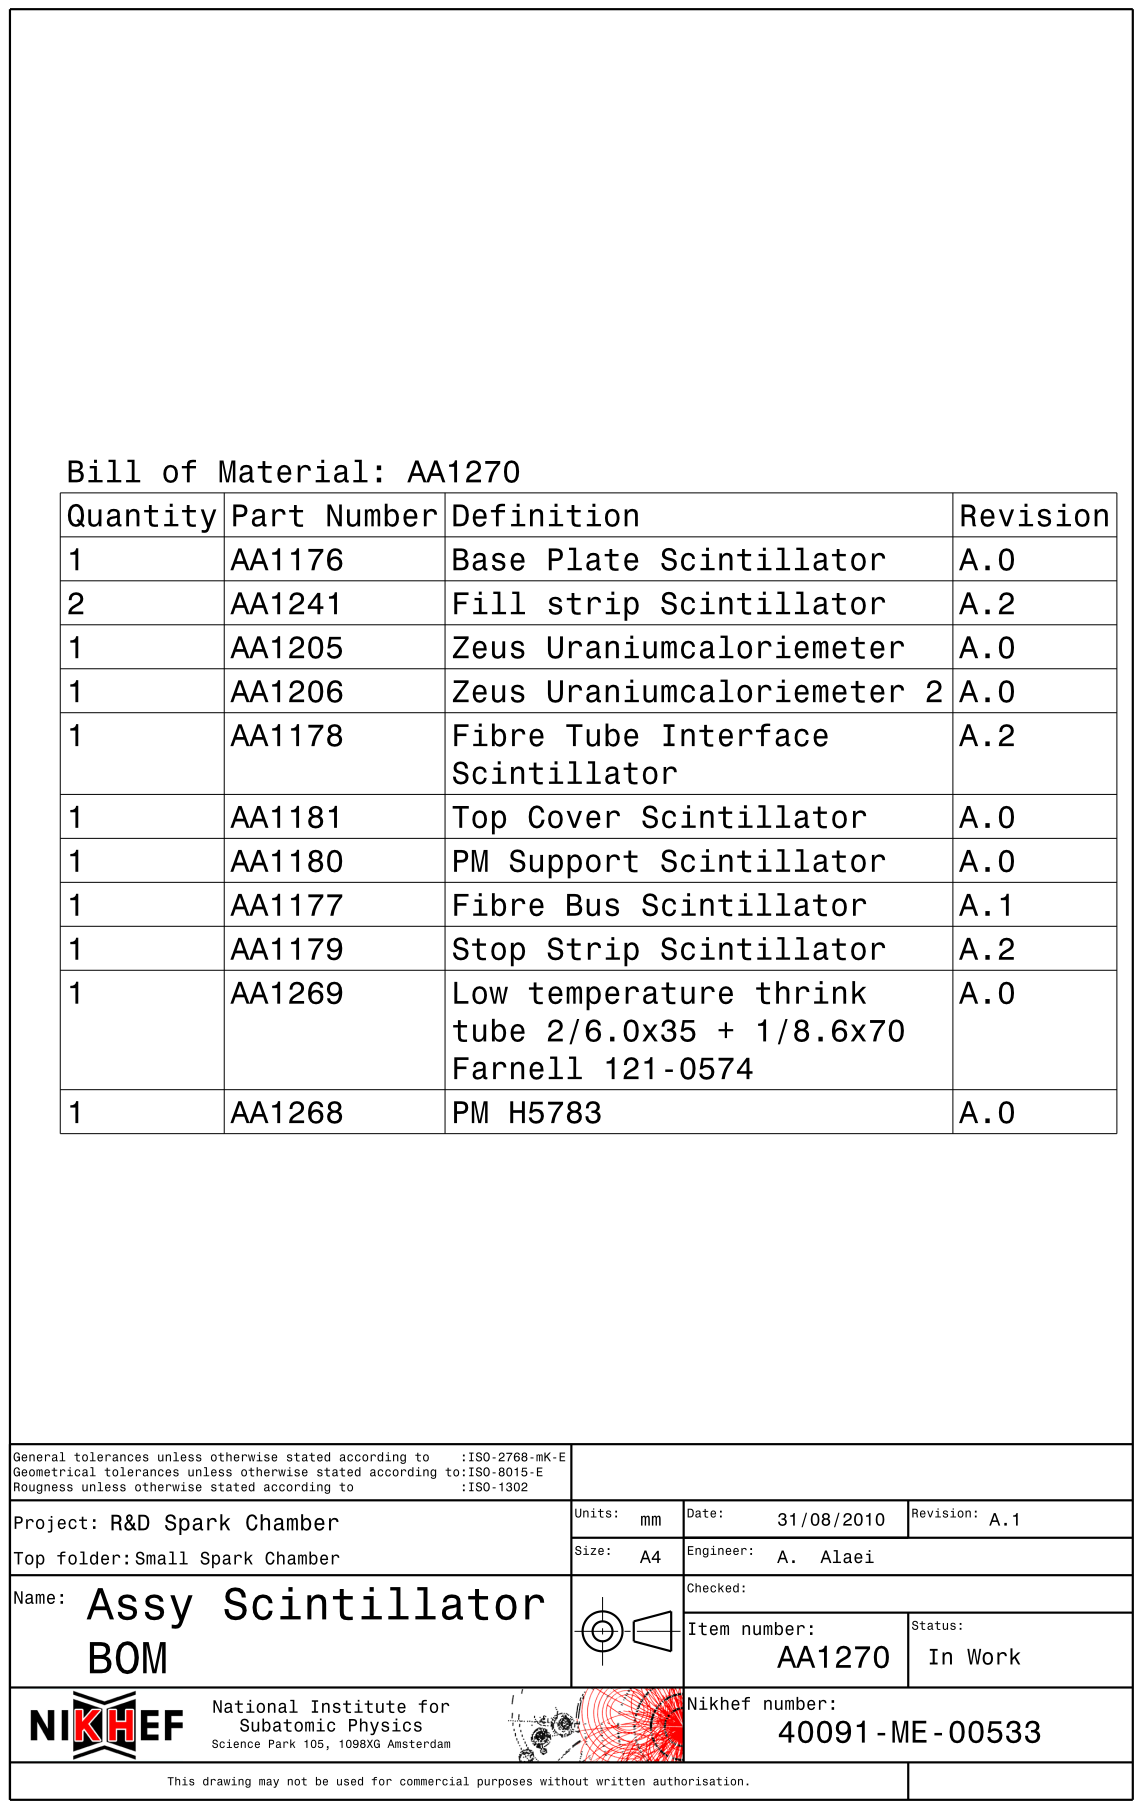
[picture p23: page 1]
