chrisgilmerproj/spark_chamber/Spark Chamber Small/Spark/Assy_Spark_BOM.pdf

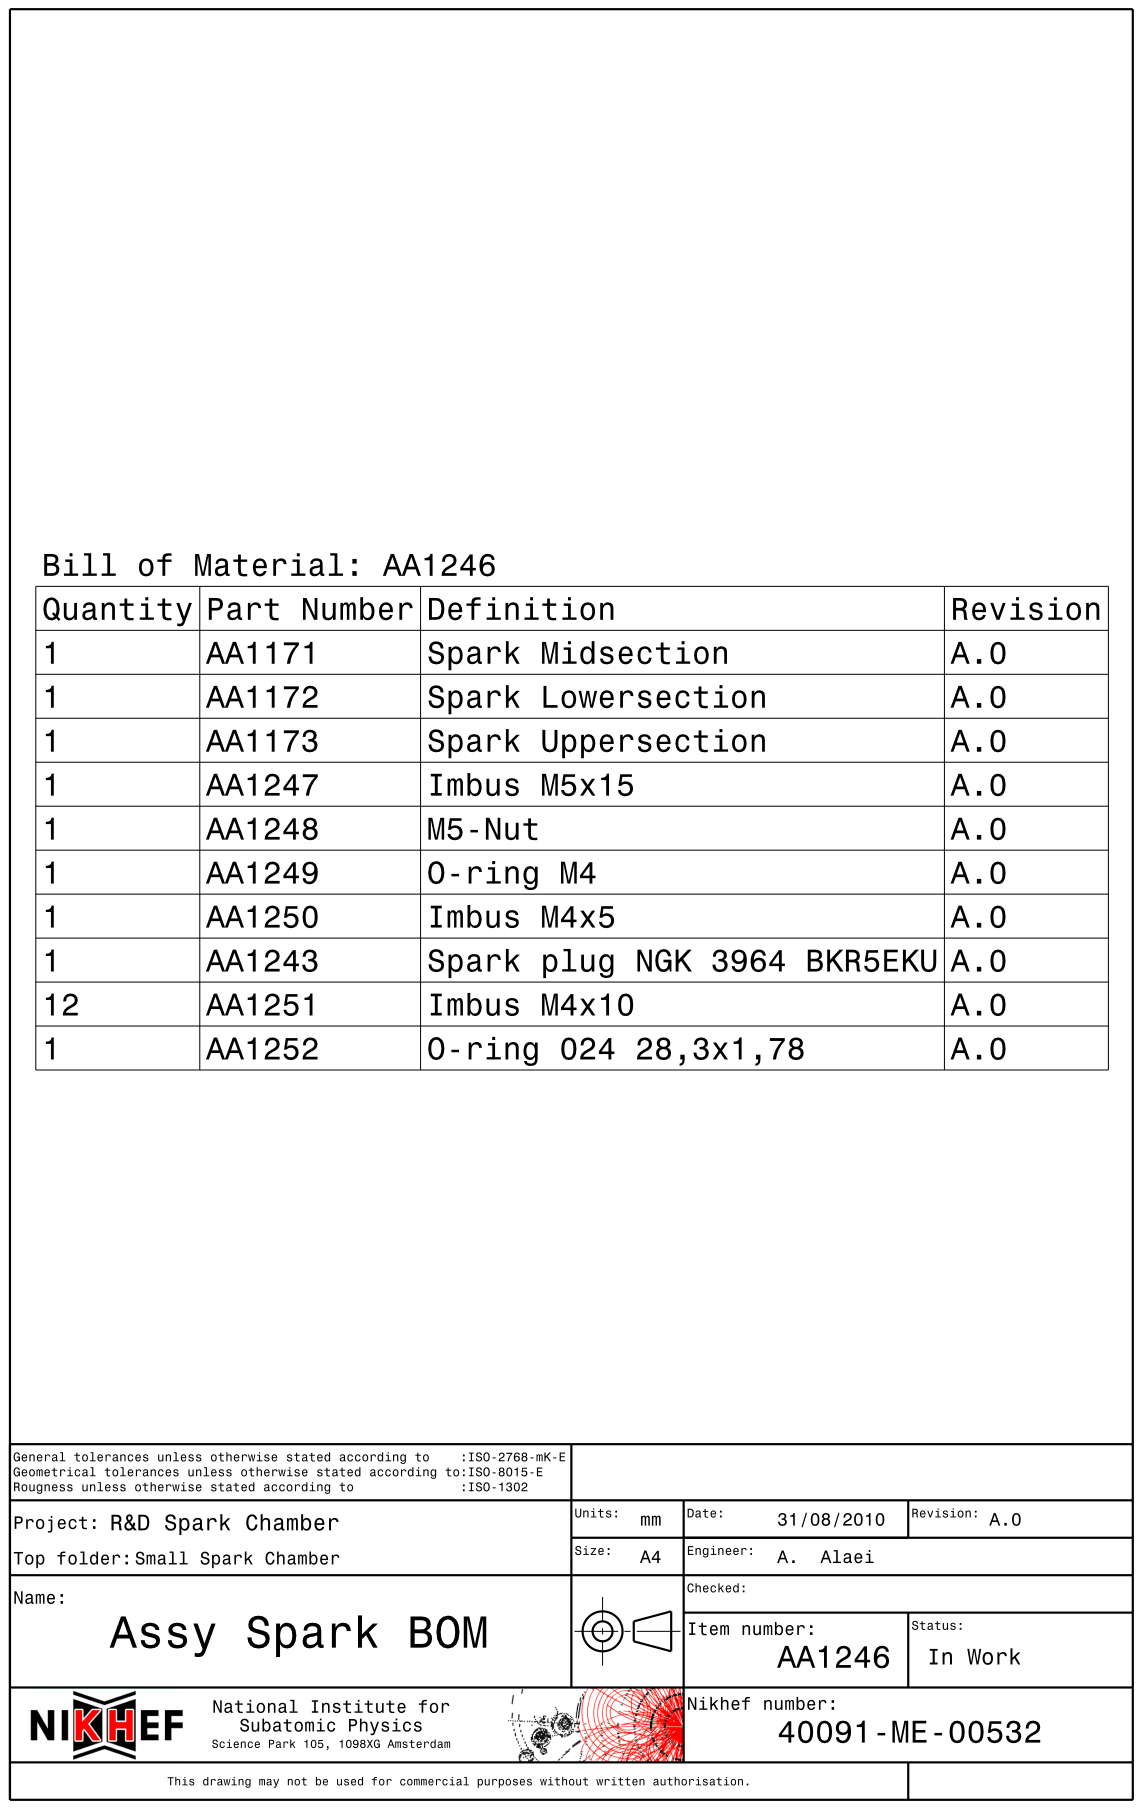
[picture p24: page 1]
