chrisgilmerproj/spark_chamber/Spark Chamber Large/Back Side Plate Ass'y_AA0250_A.pdf

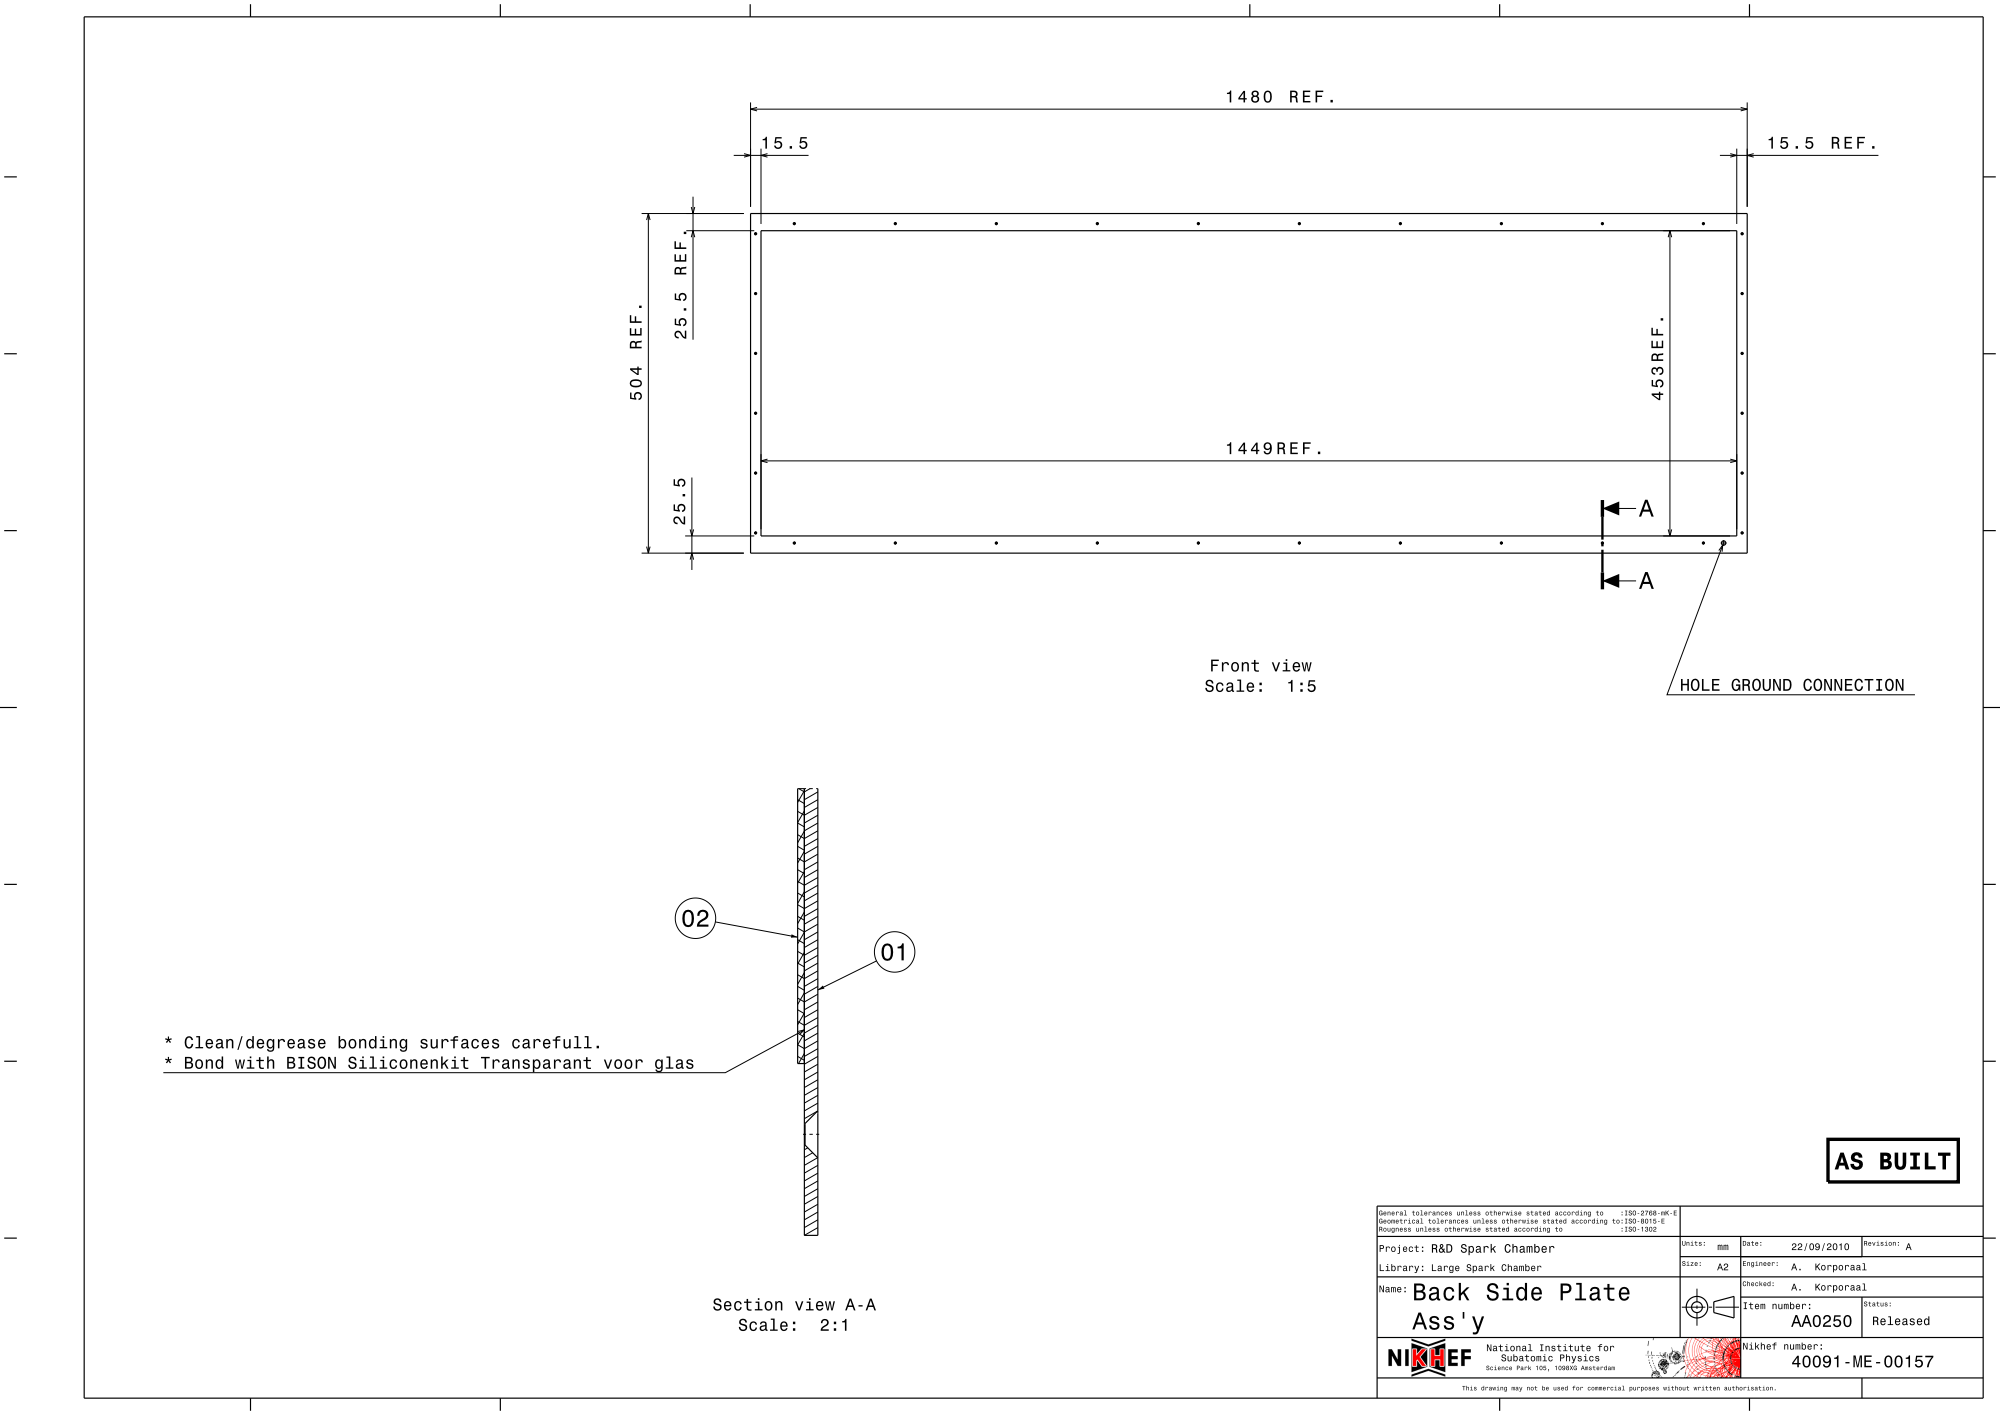
[picture p25: page 1]
