chrisgilmerproj/spark_chamber/Spark Chamber Large/Back Side Plate_AA0251_A.pdf

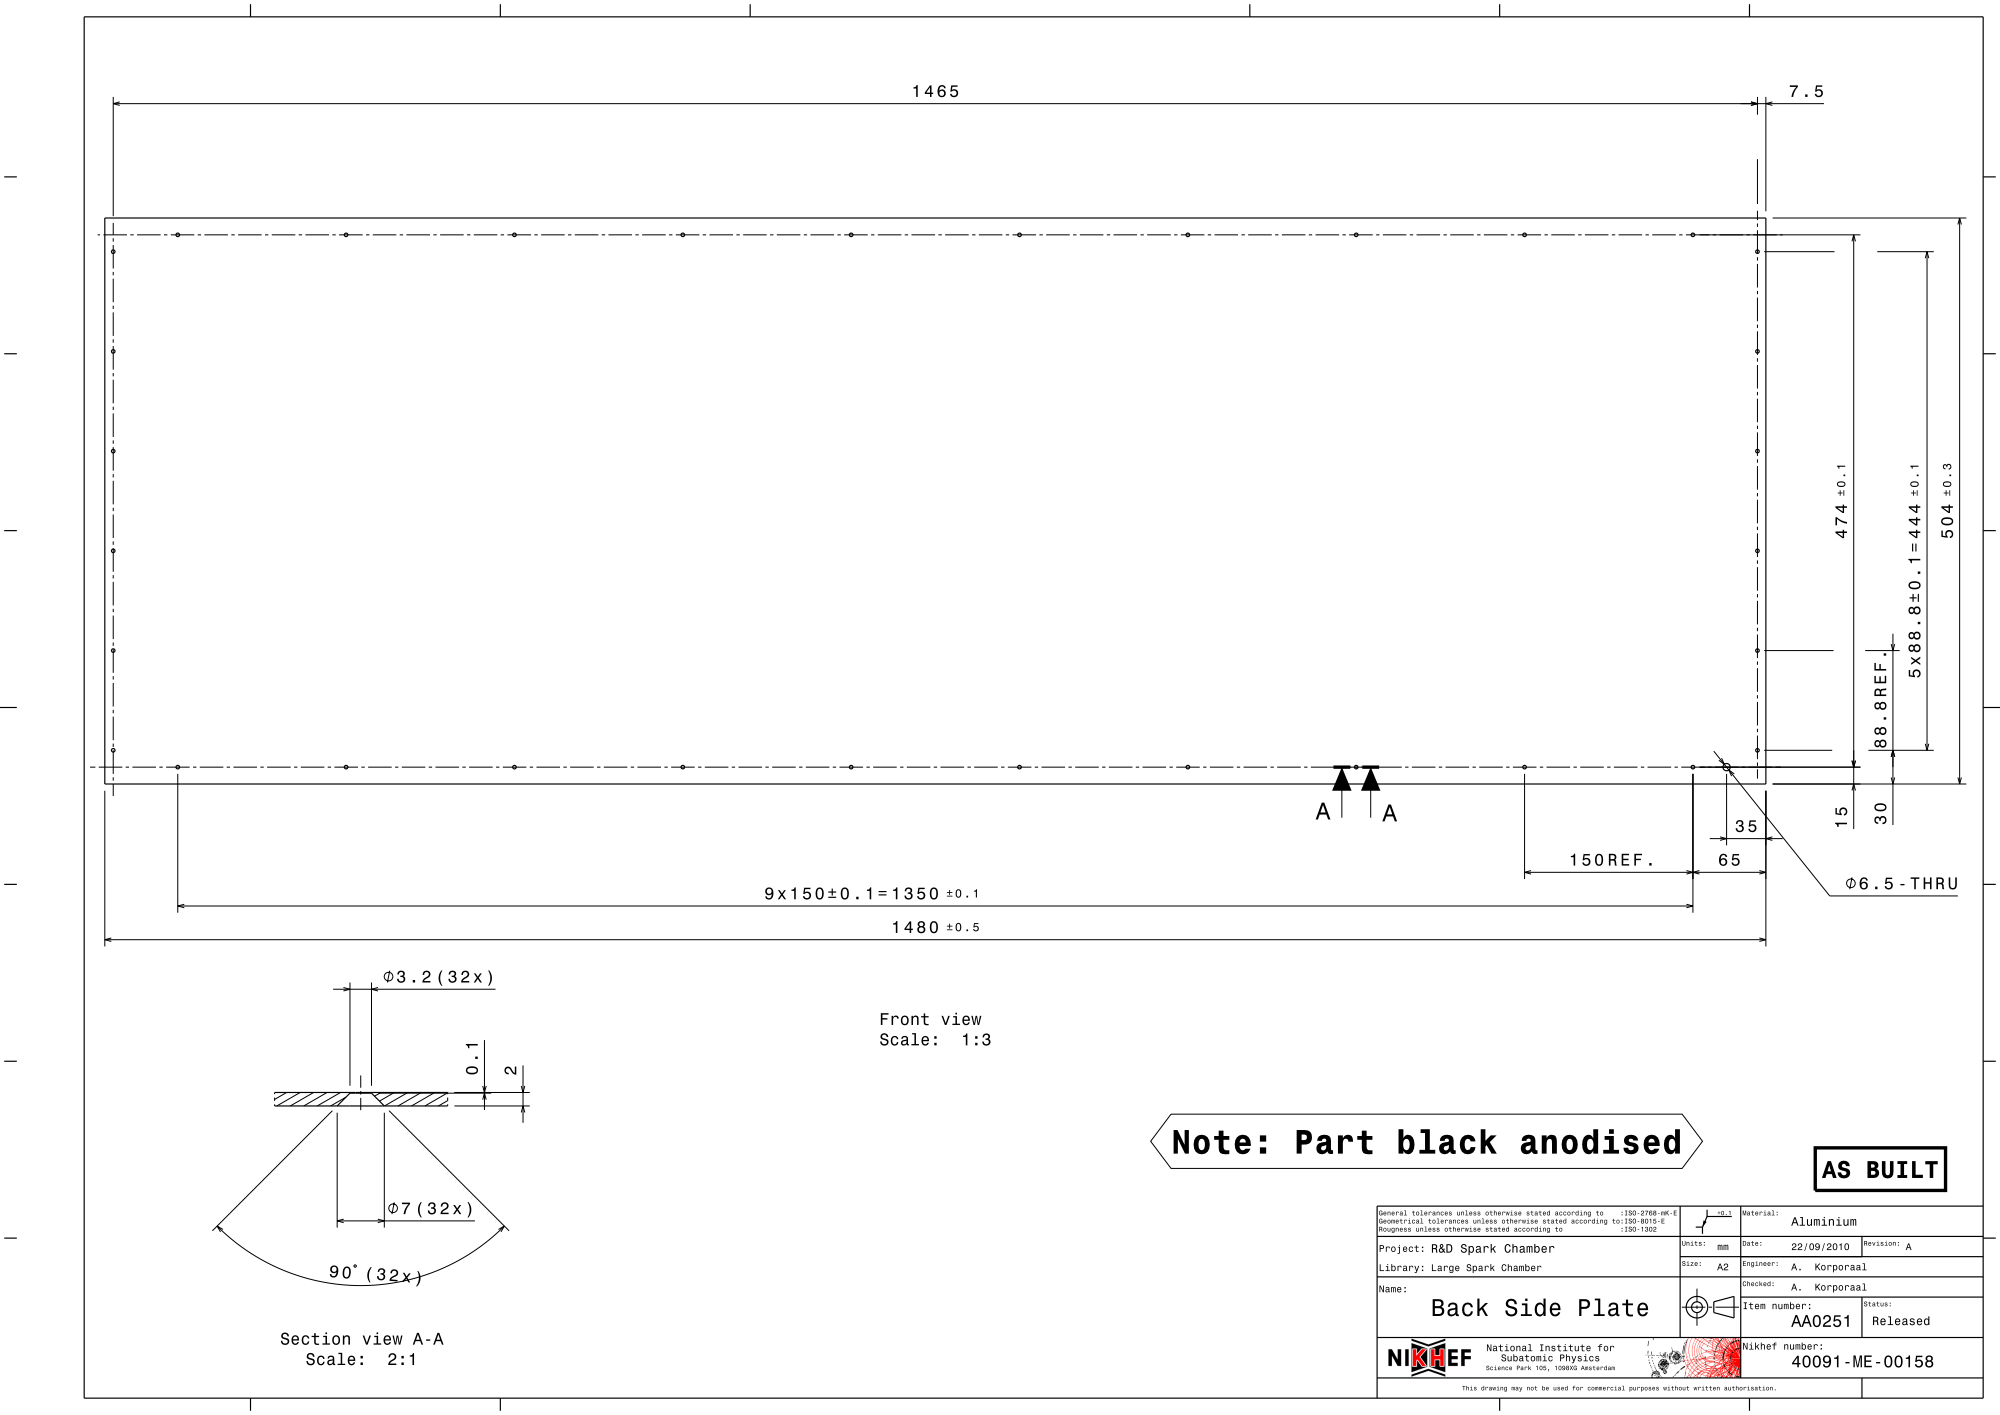
[picture p26: page 1]
