chrisgilmerproj/spark_chamber/Spark Chamber Large/Back Strip Large_AA0254_A.pdf

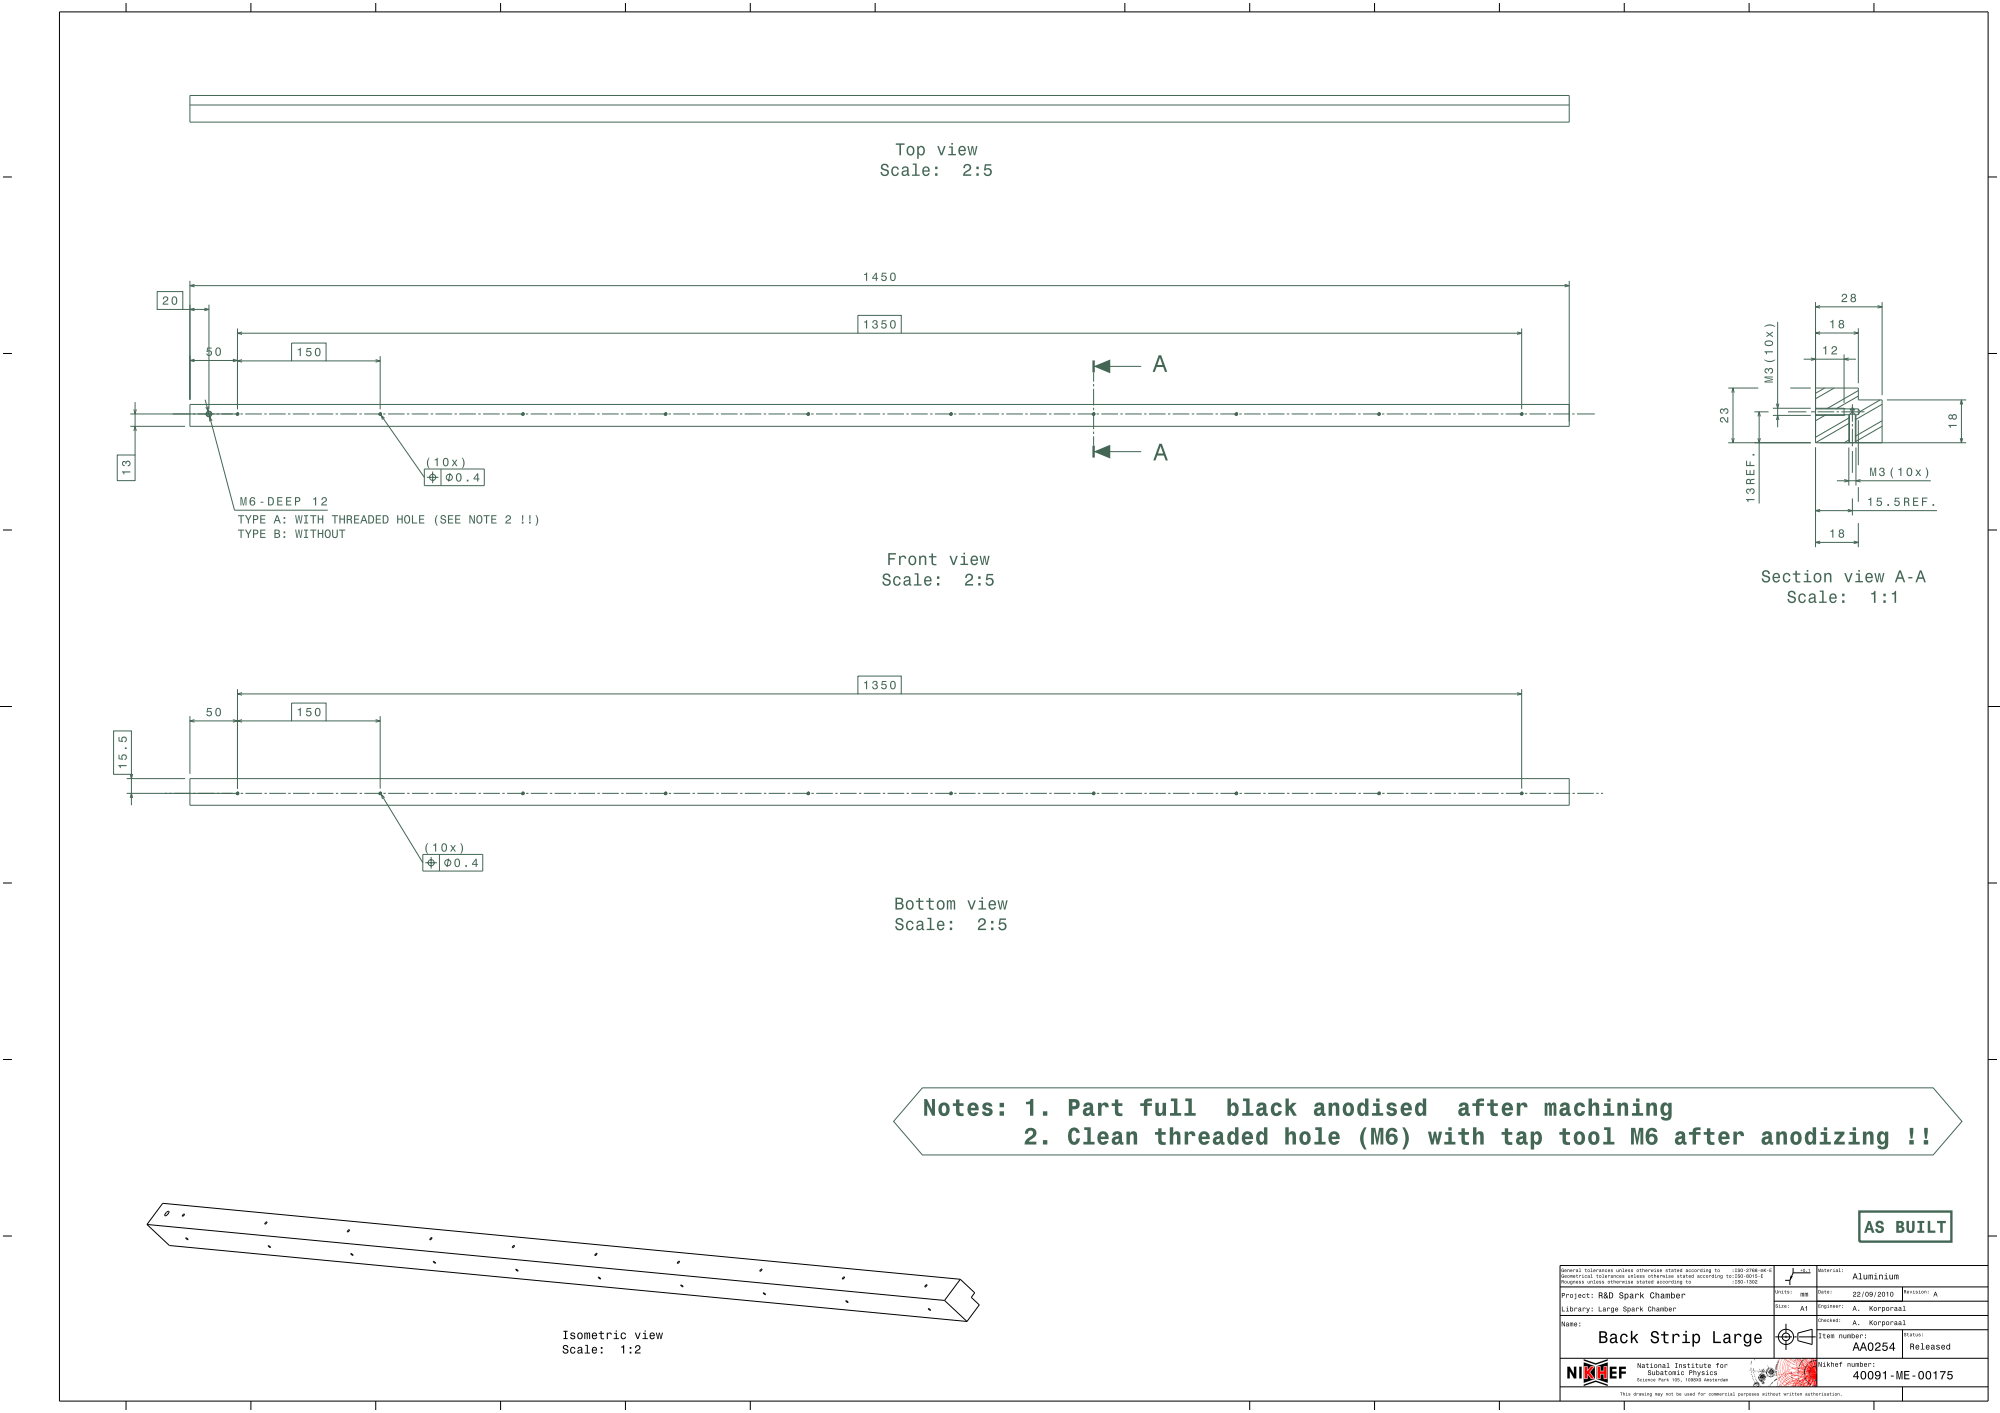
[picture p27: page 1]
