chrisgilmerproj/spark_chamber/Spark Chamber Large/Body_AA3921.pdf

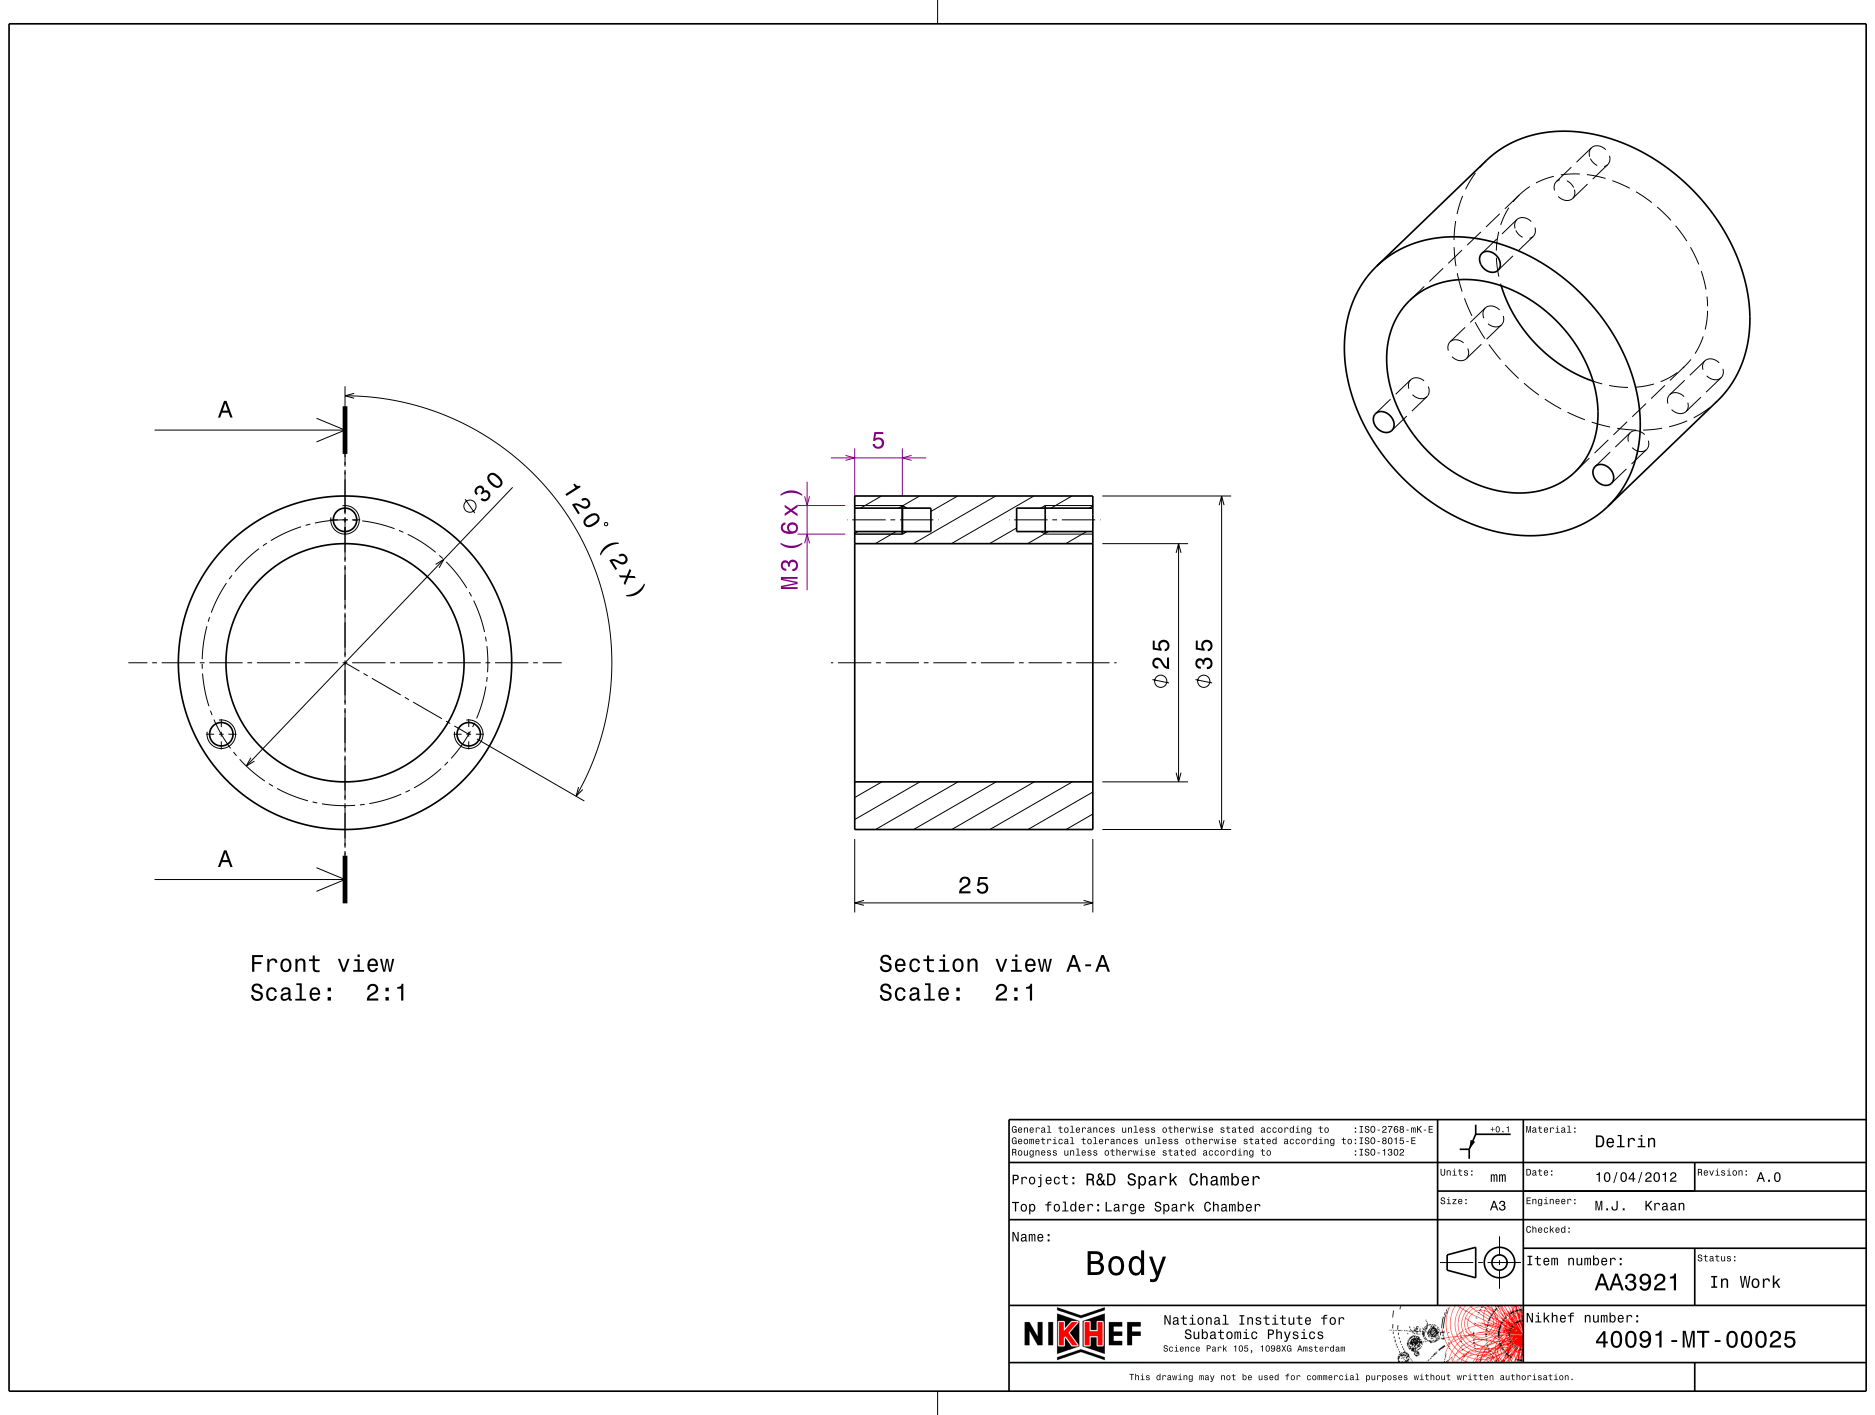
[picture p28: page 1]
