chrisgilmerproj/spark_chamber/Spark Chamber Large/Capacitor Plate 1_AA0268_A.pdf

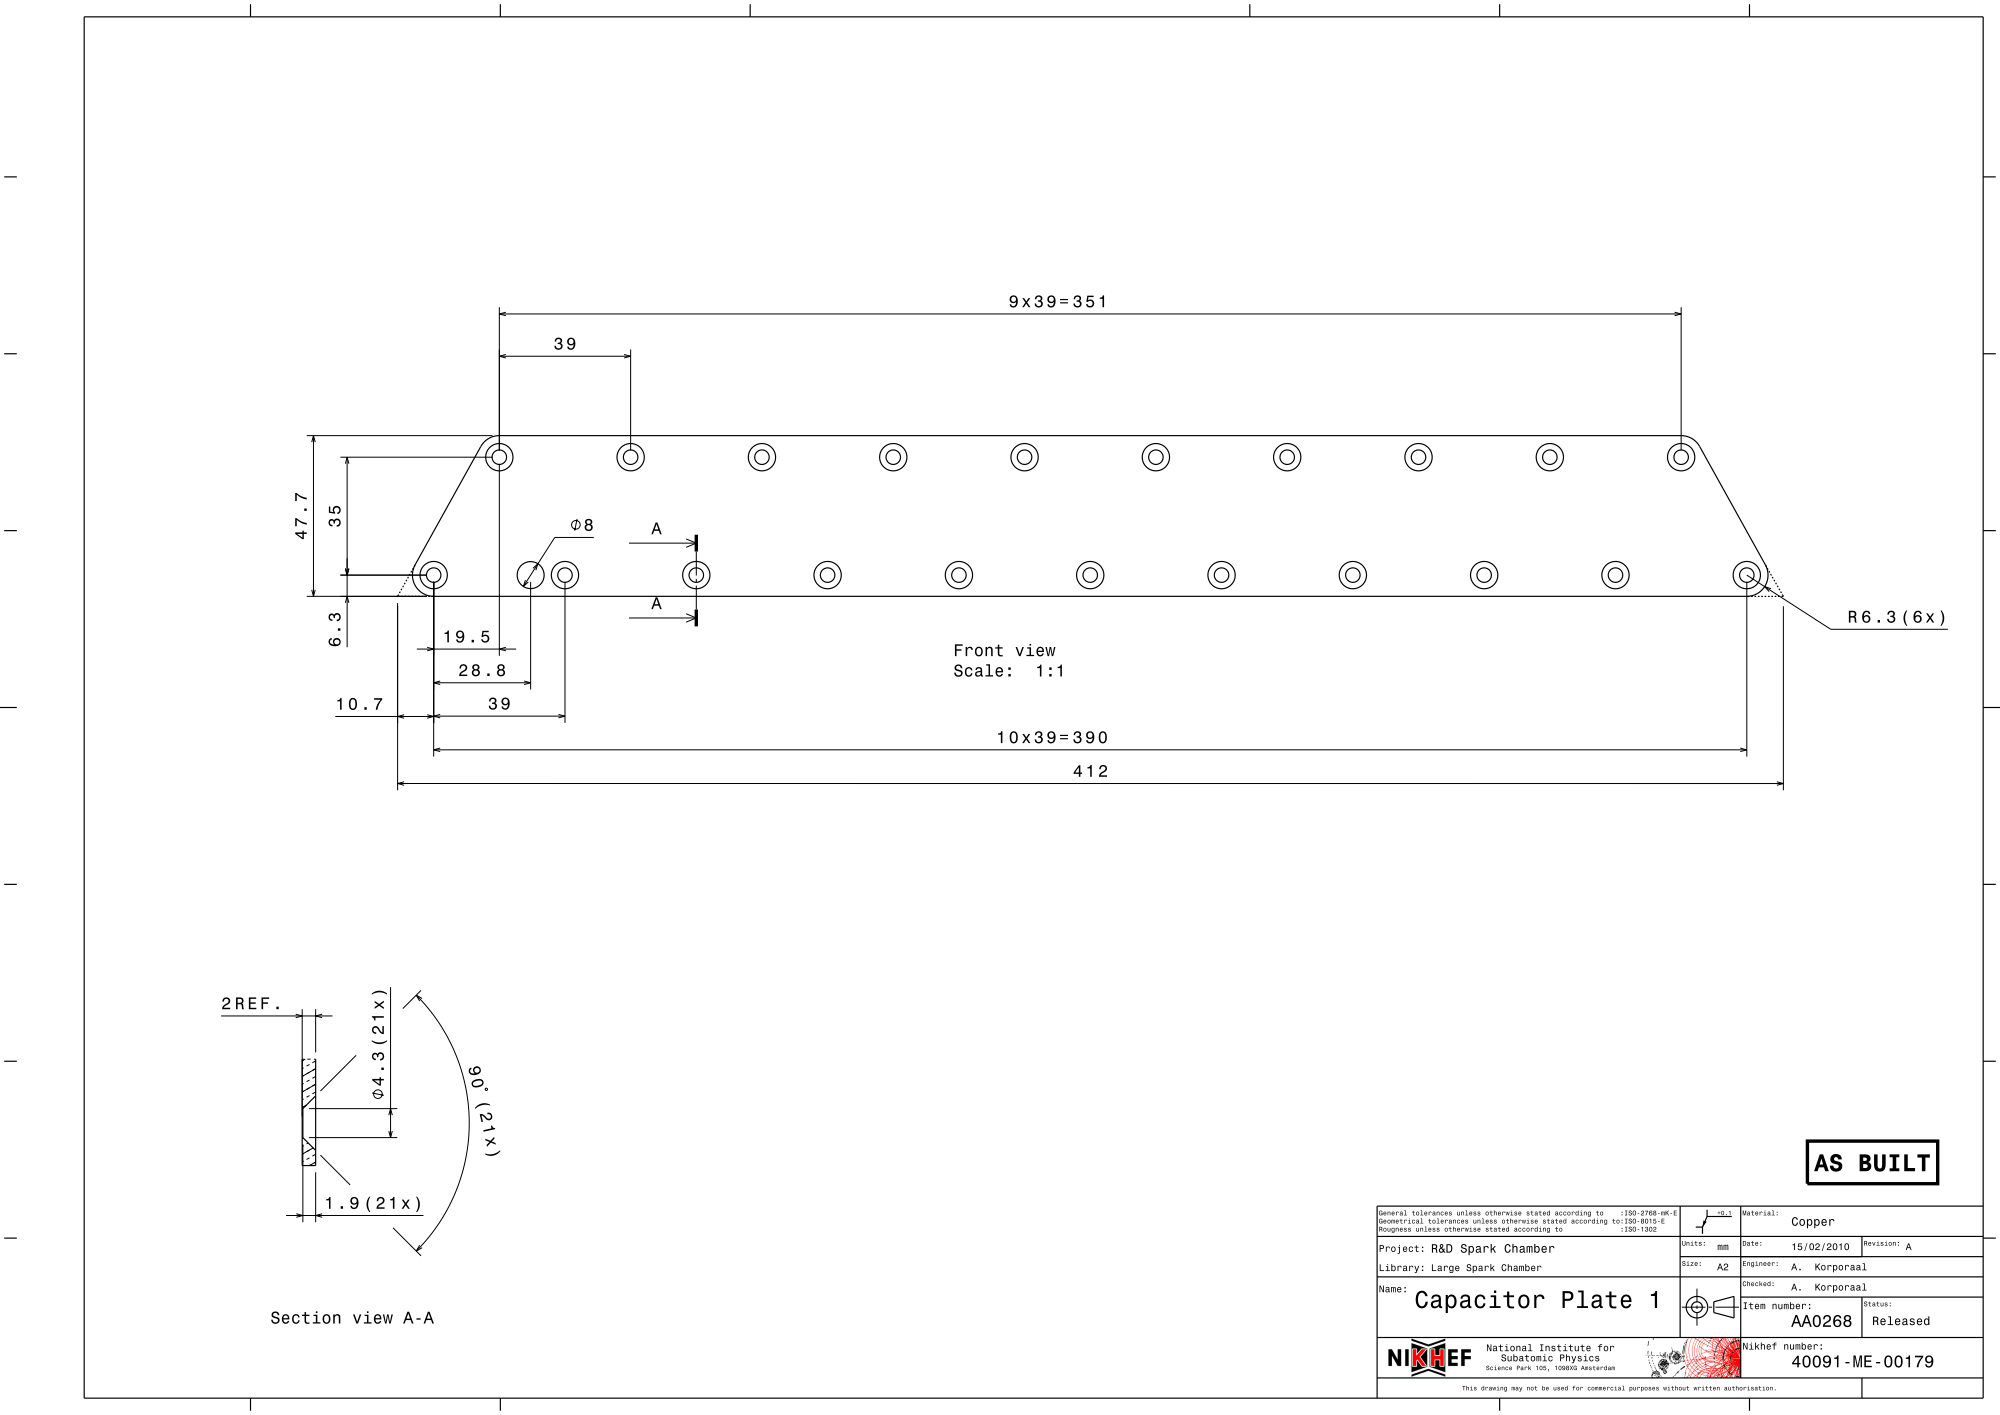
[picture p29: page 1]
