chrisgilmerproj/spark_chamber/Spark Chamber Large/Capacitor Plate Ass'y_AA0266_A.pdf

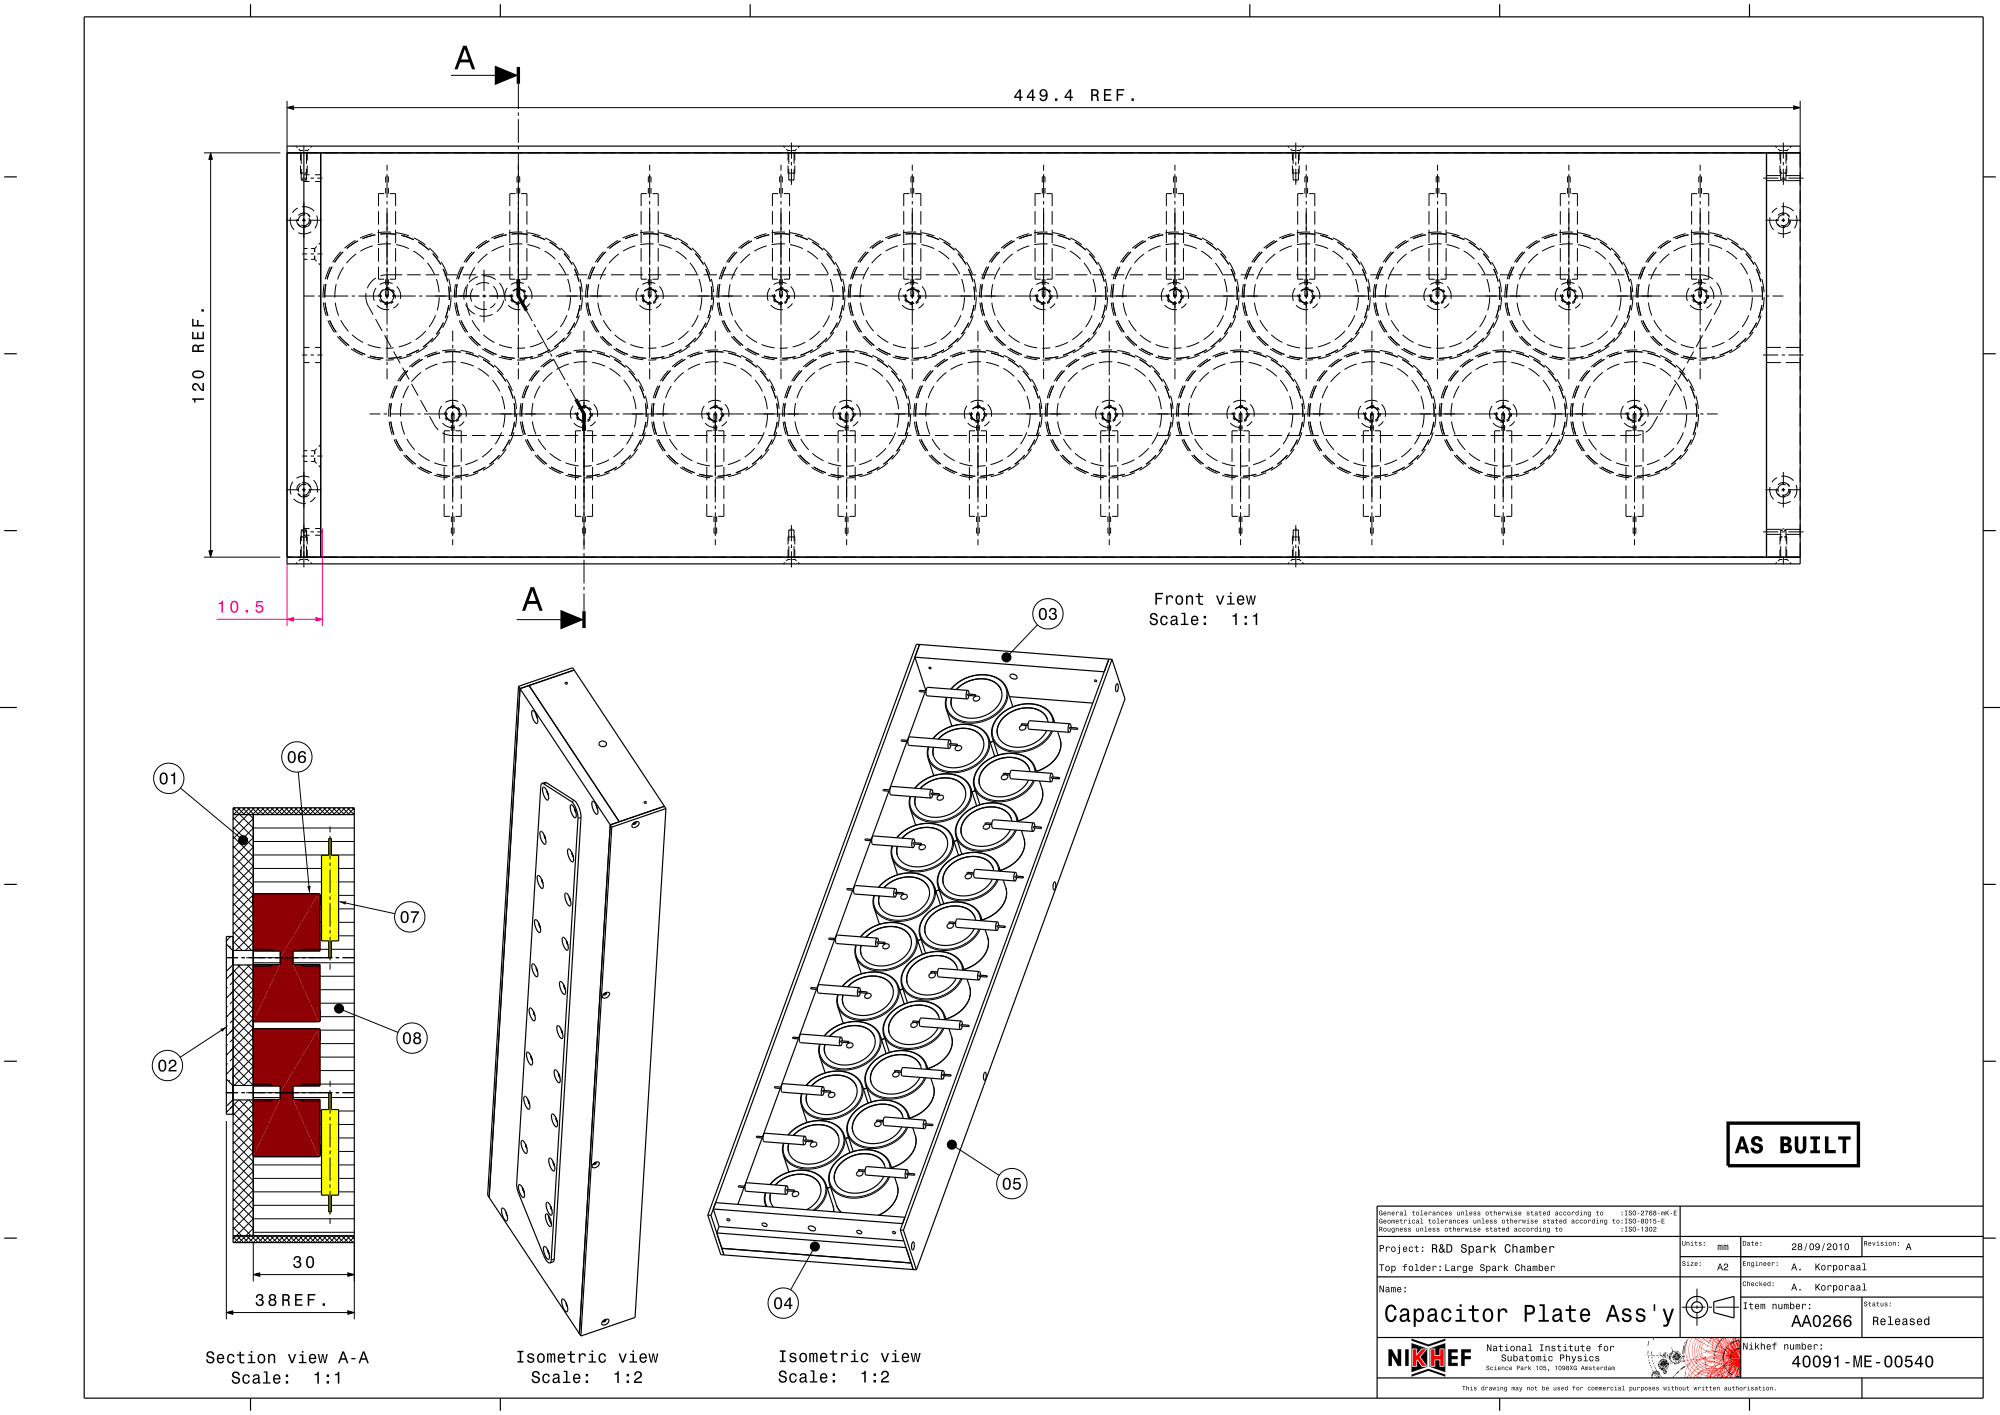
[picture p30: page 1]
