chrisgilmerproj/spark_chamber/Spark Chamber Large/Capacitor Plate Support 1_AA0267_A.pdf

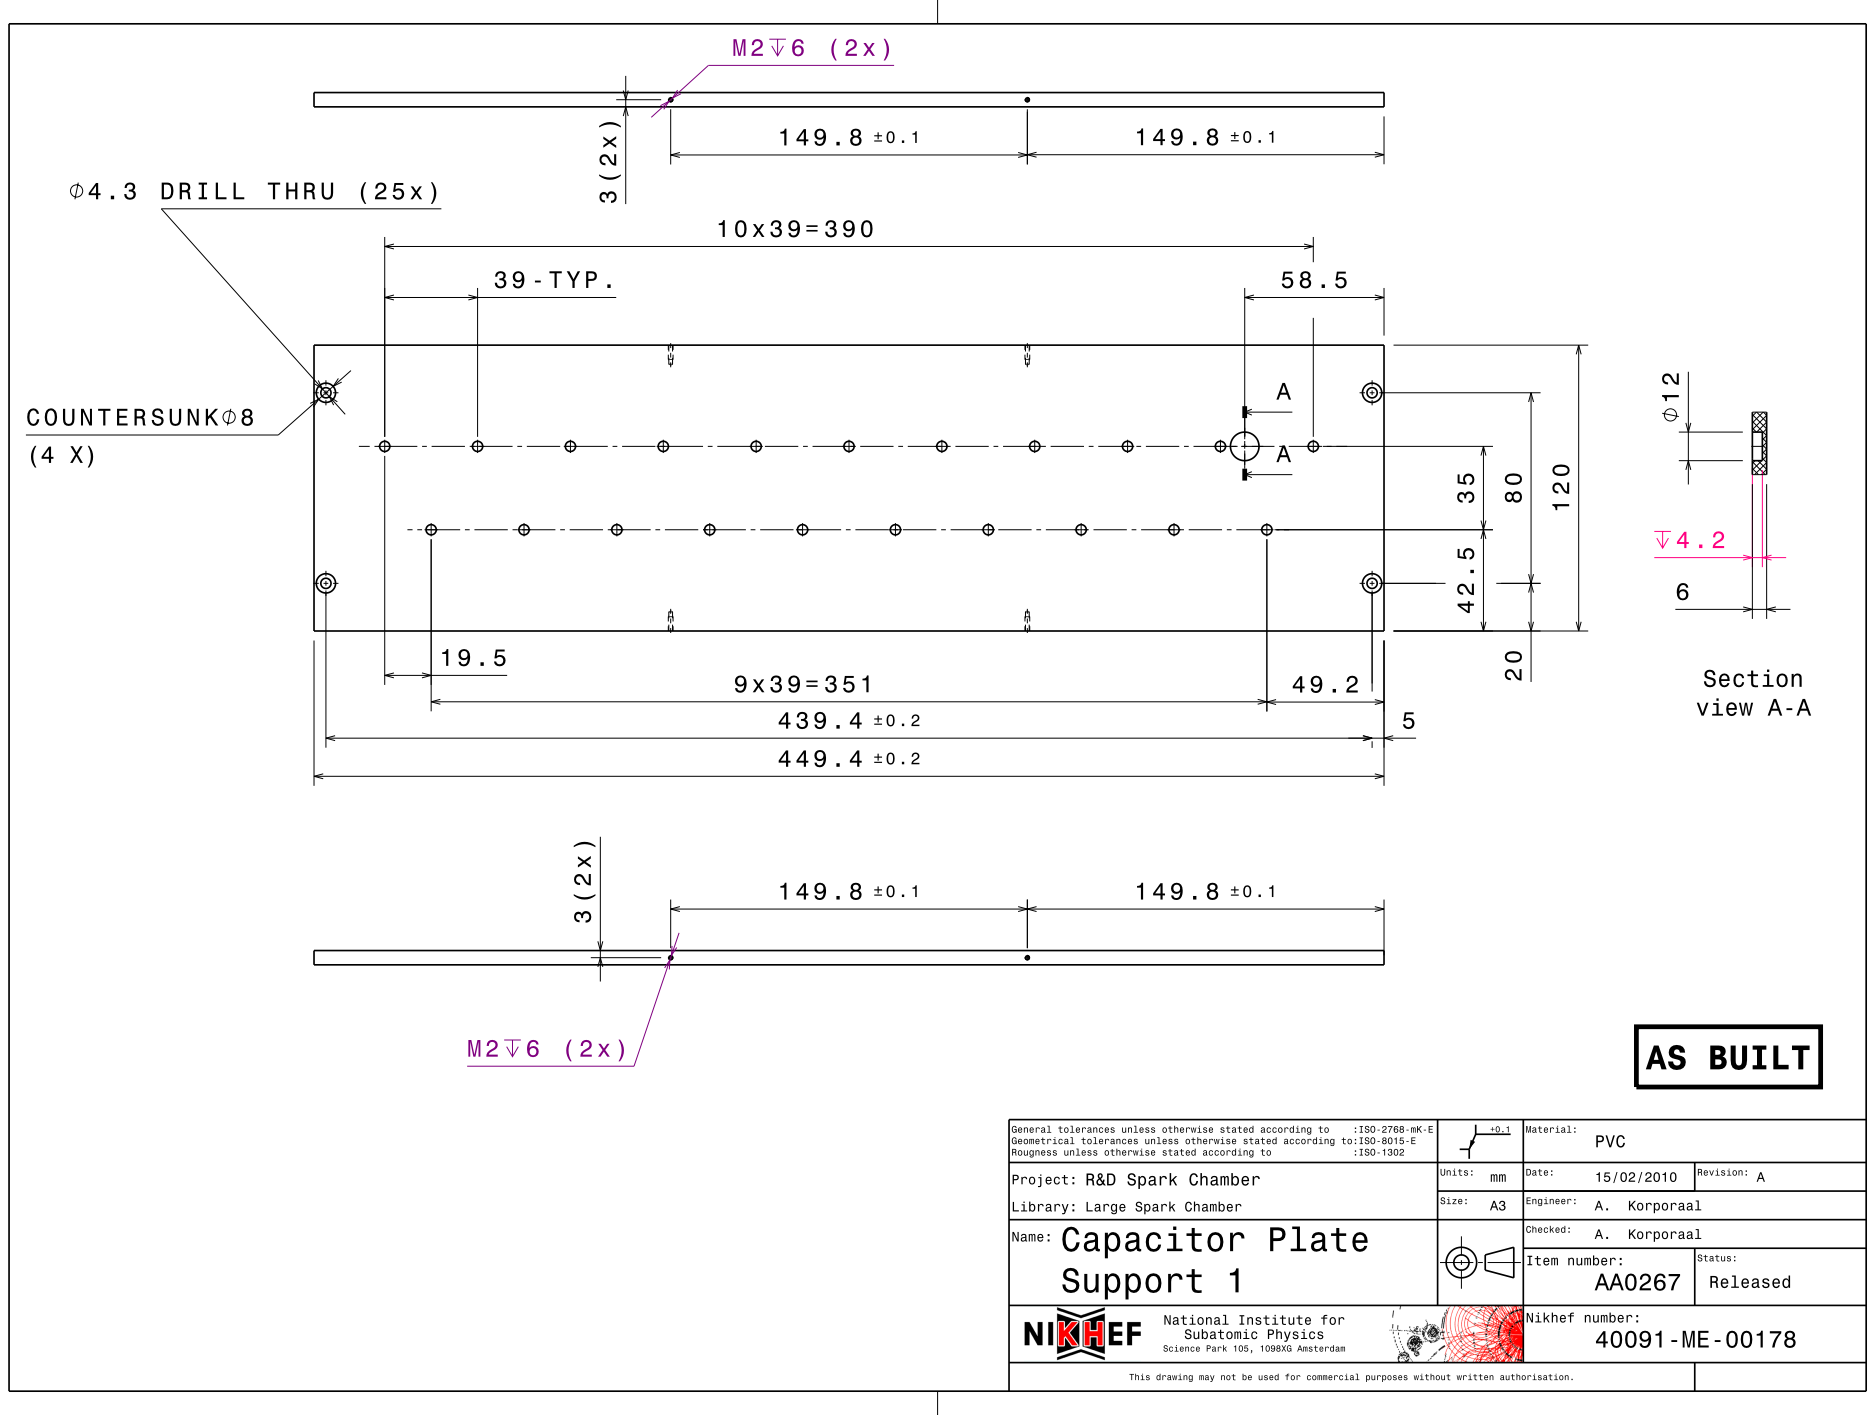
[picture p31: page 1]
