chrisgilmerproj/spark_chamber/Spark Chamber Large/Clamp 2_AA0306_A.pdf

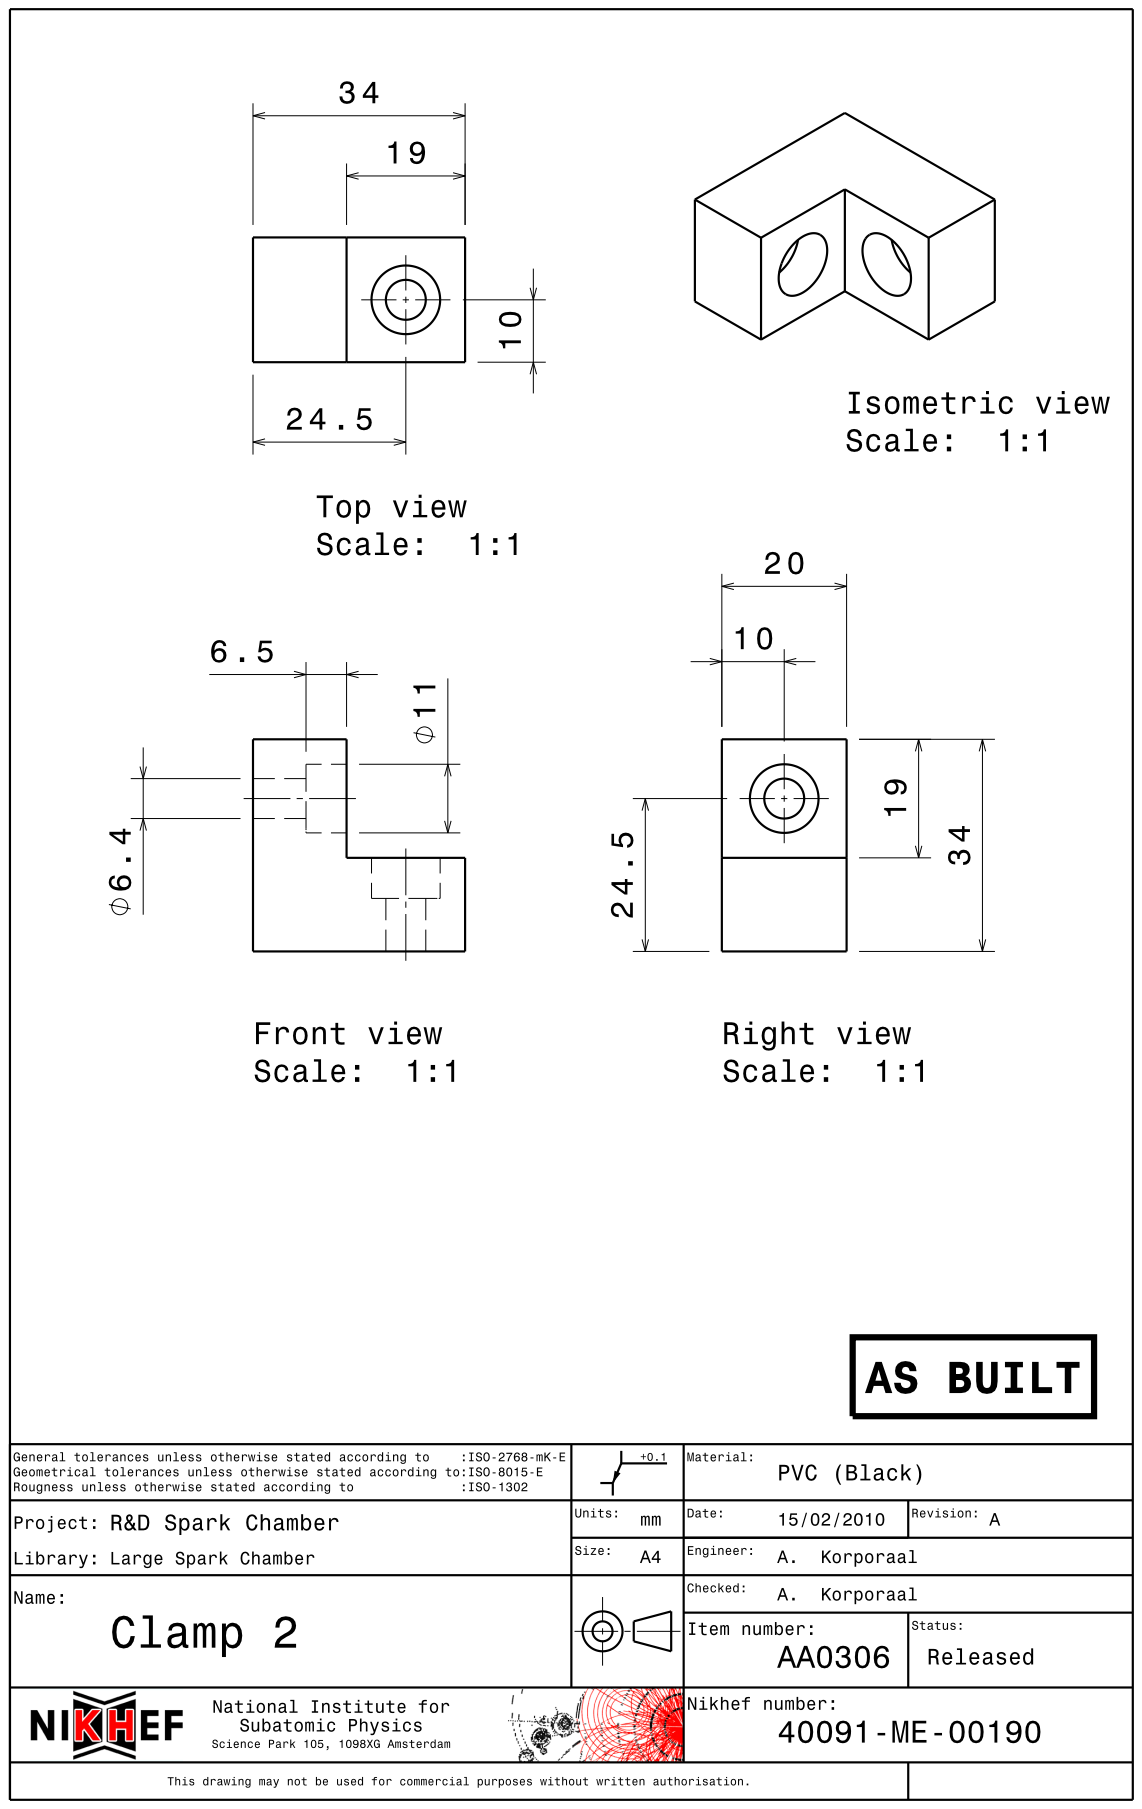
[picture p32: page 1]
