chrisgilmerproj/spark_chamber/Spark Chamber Large/Electrode Bus_AA0286_A.pdf

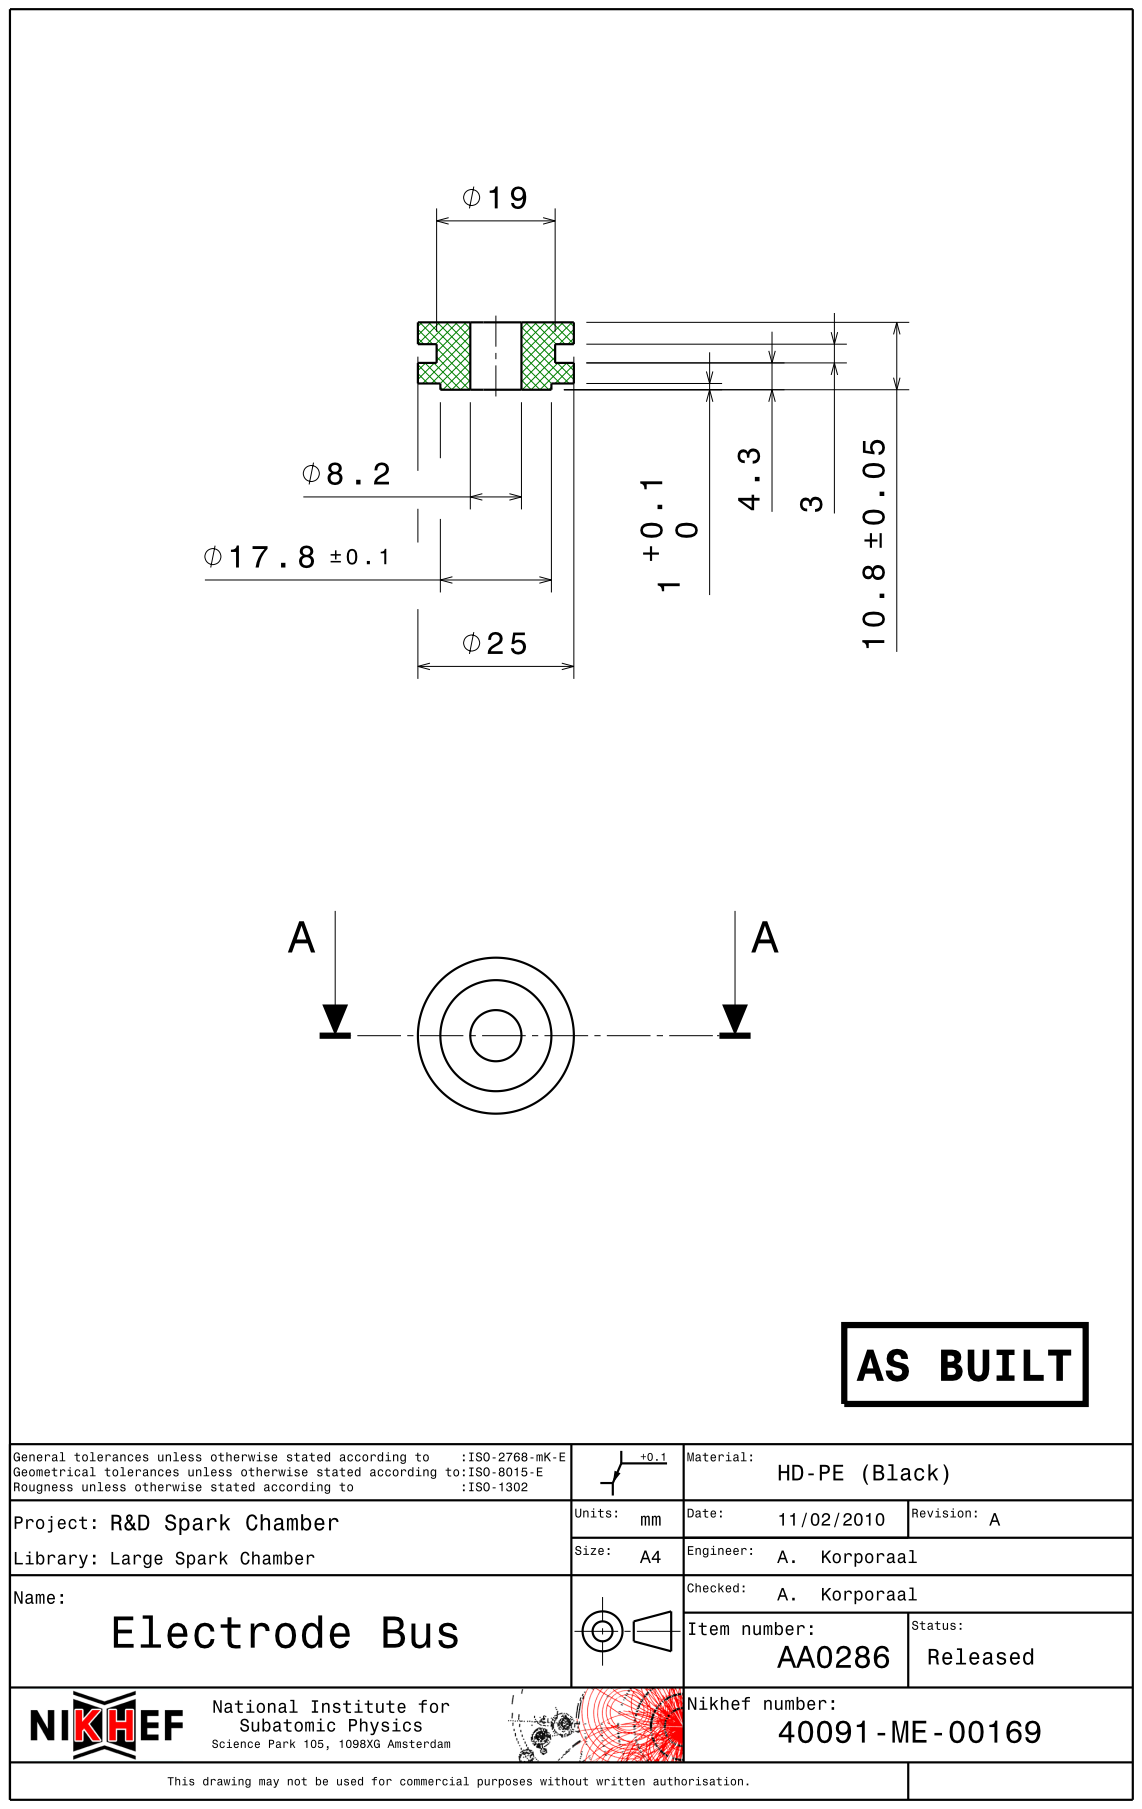
[picture p33: page 1]
