chrisgilmerproj/spark_chamber/Spark Chamber Large/Electrode Plate_AA0285_A.pdf

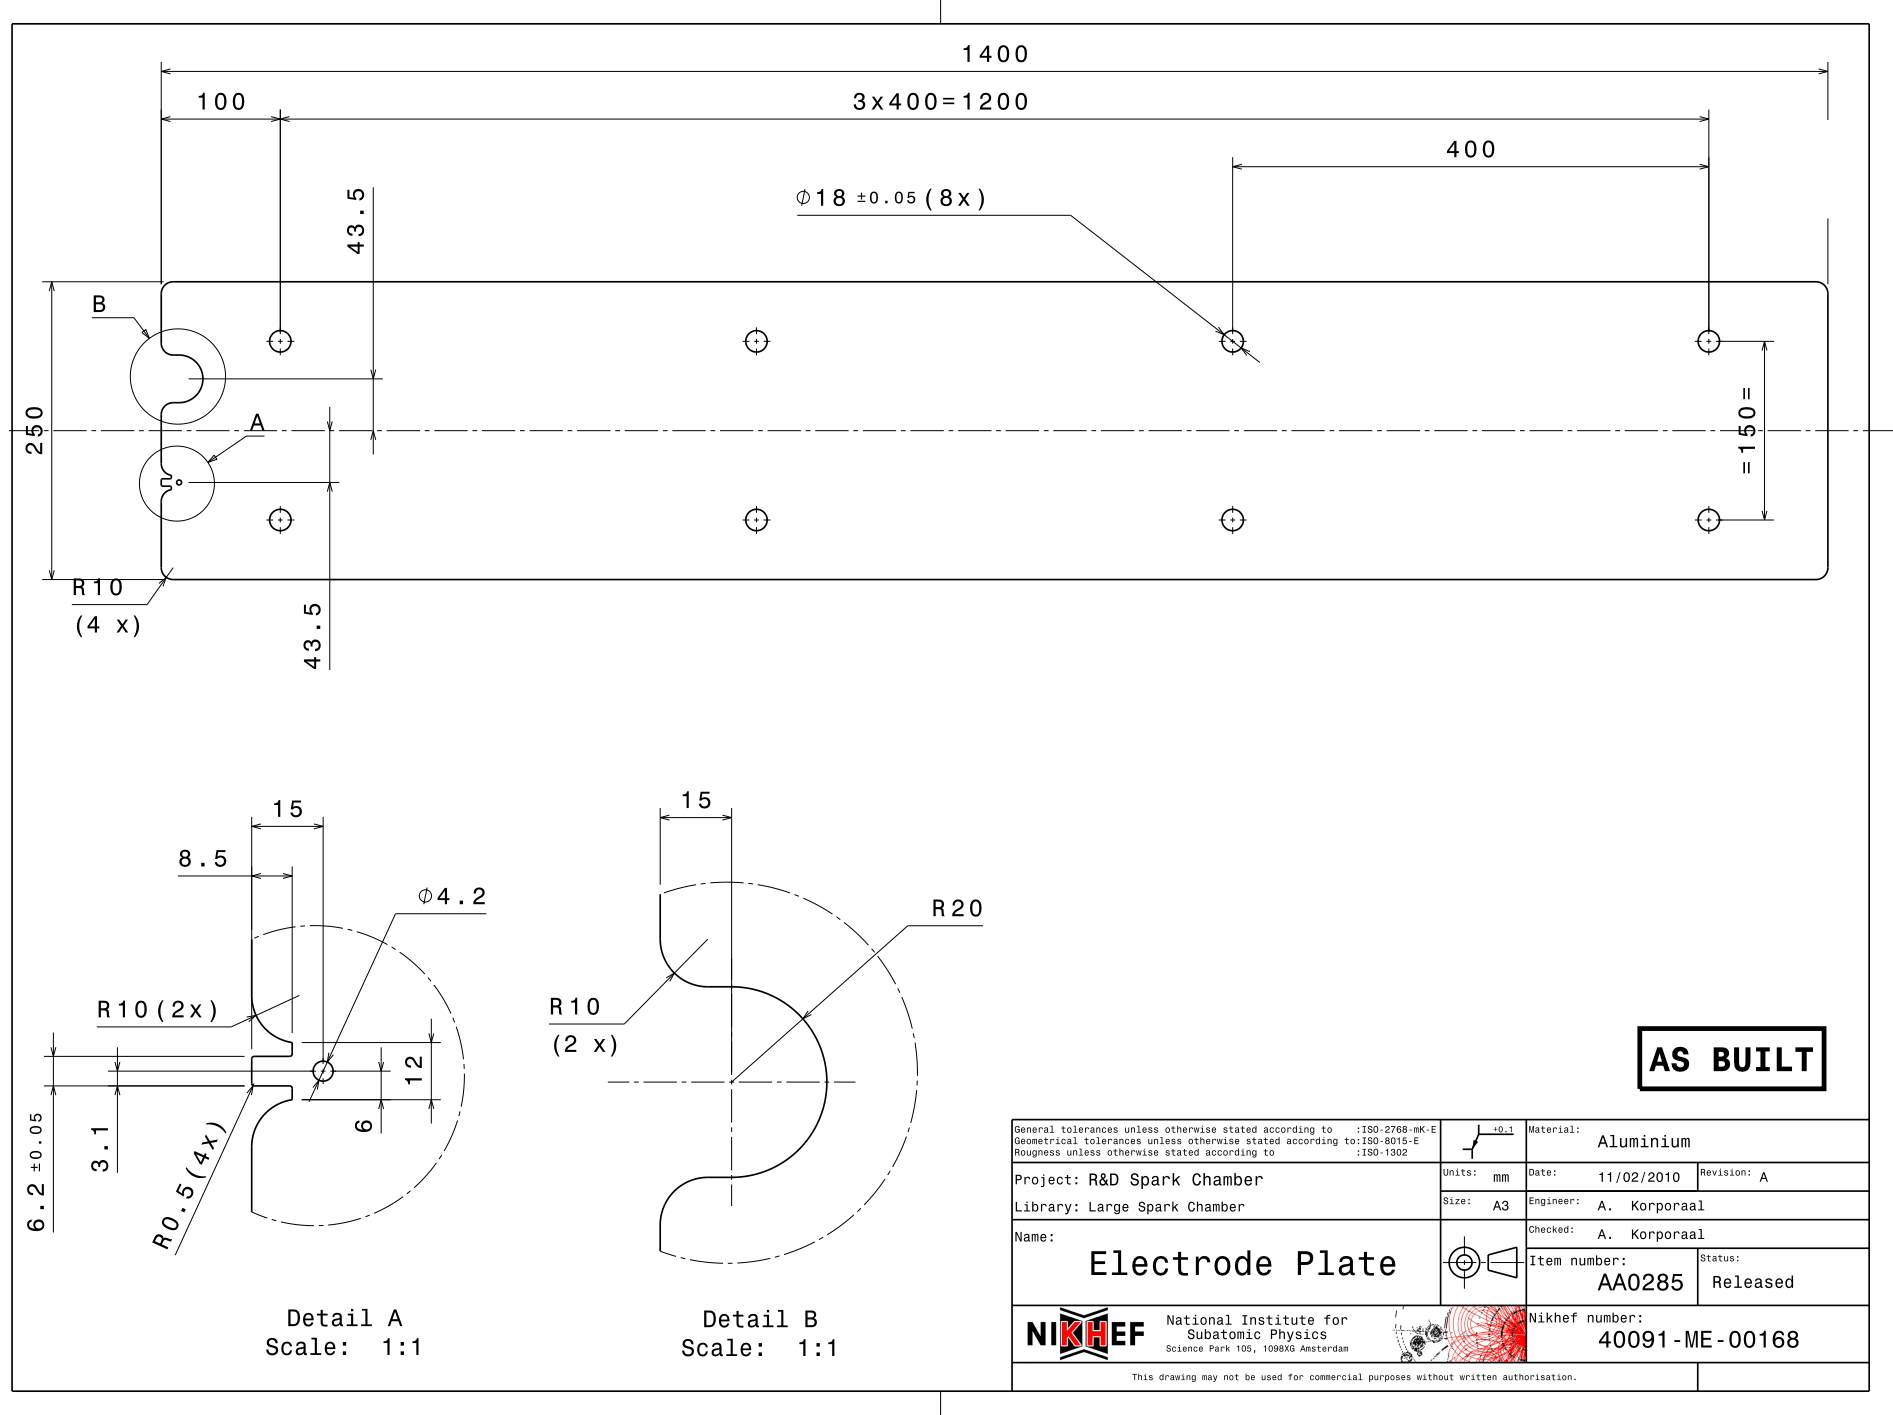
[picture p34: page 1]
