chrisgilmerproj/spark_chamber/Spark Chamber Large/Electrode Plates Ass'y_AA0261_A.pdf

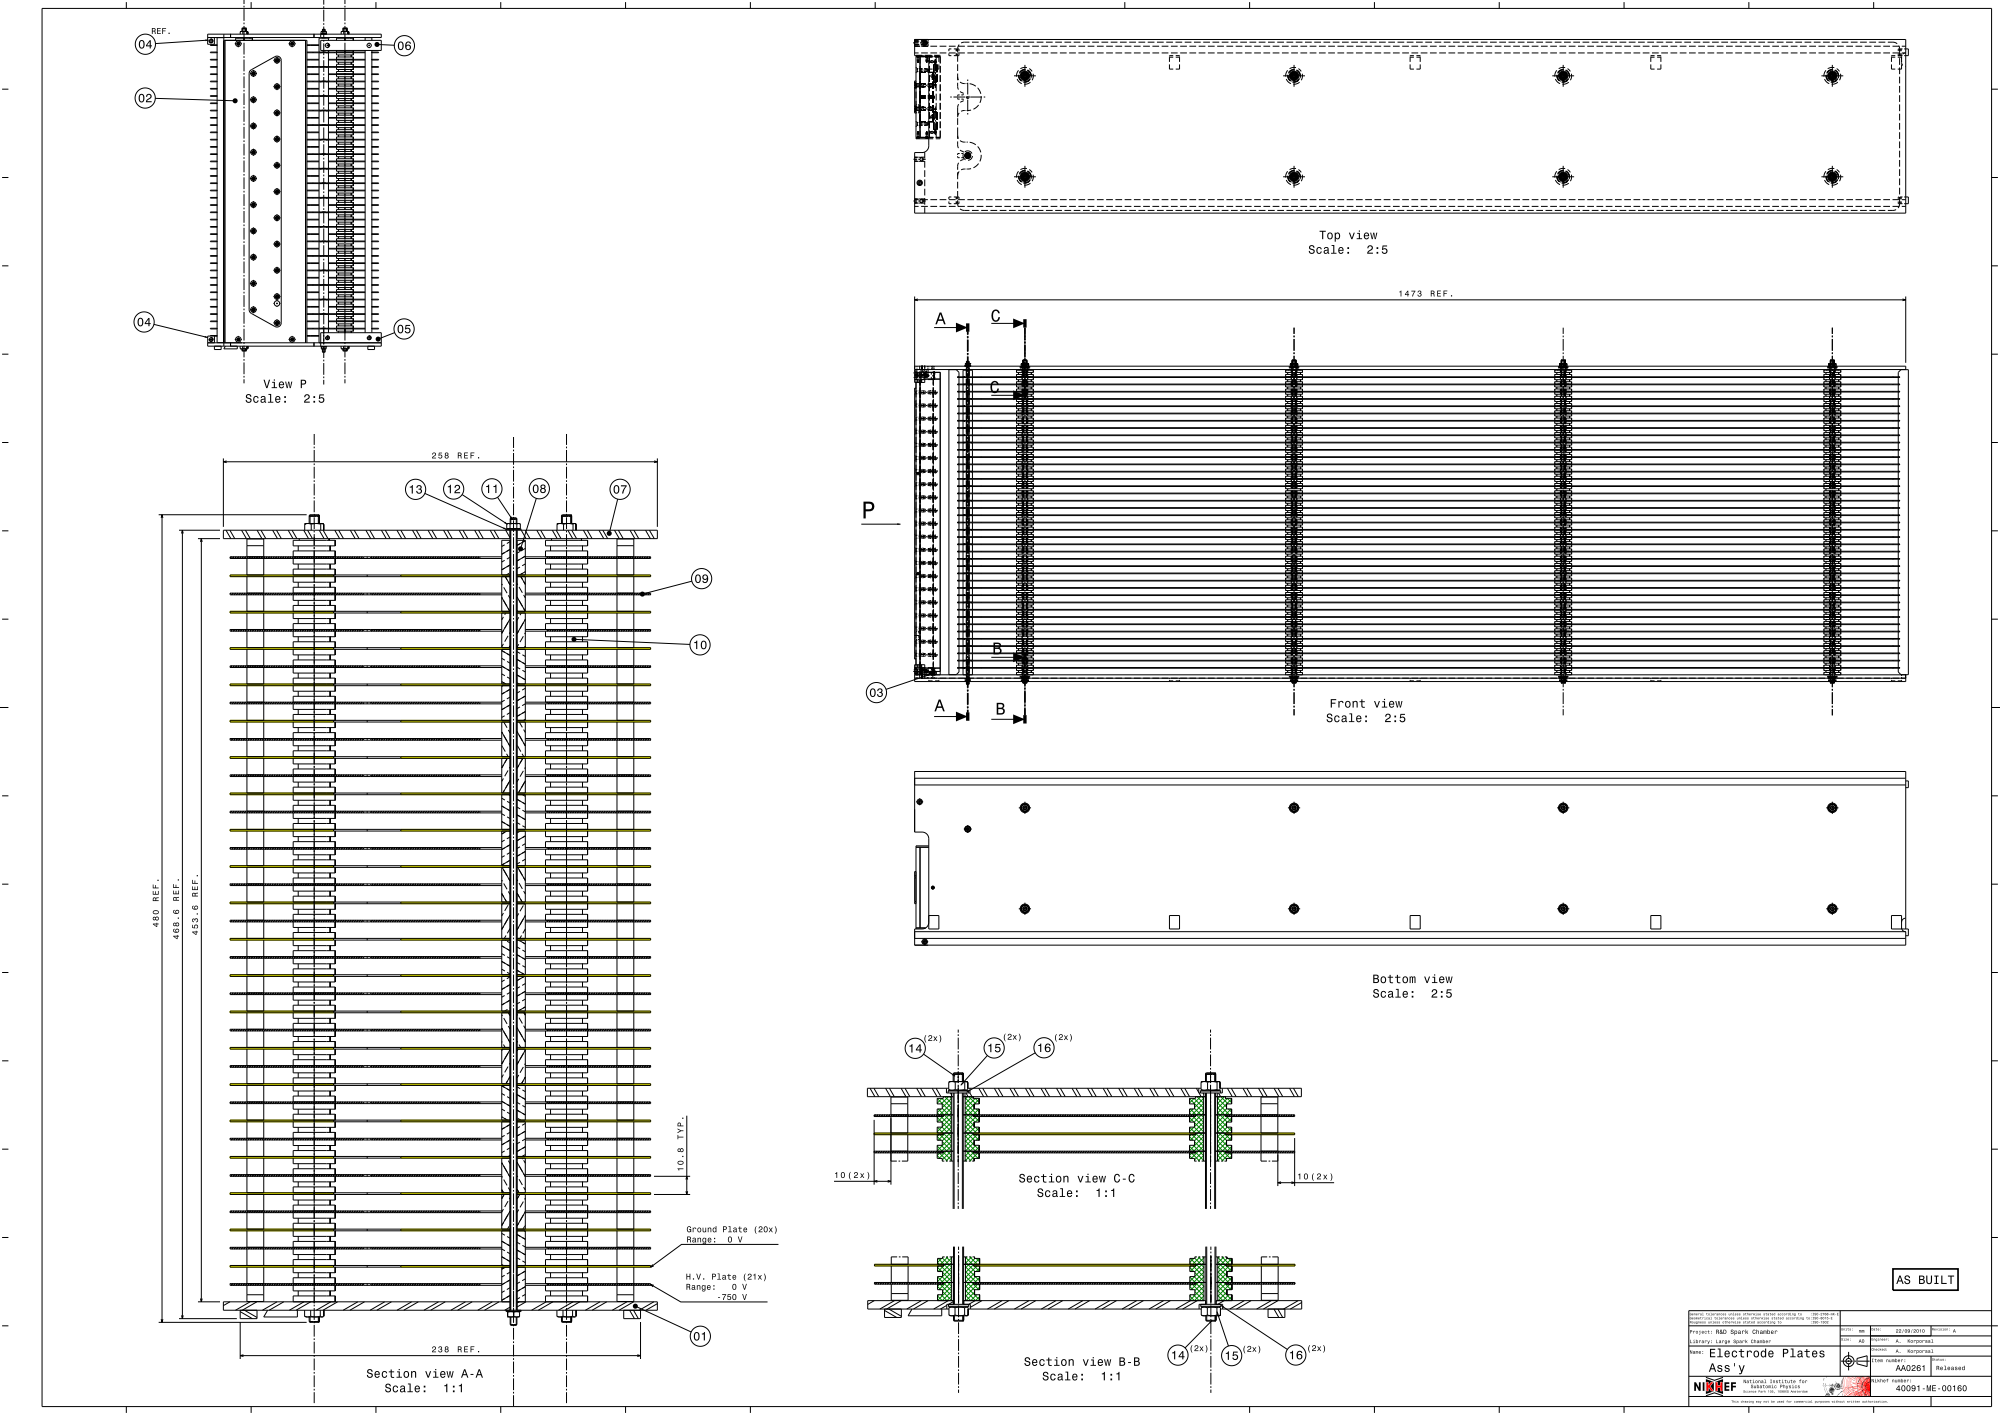
[picture p35: page 1]
