chrisgilmerproj/spark_chamber/Spark Chamber Large/Electrode Spacer_AA0295_A.pdf

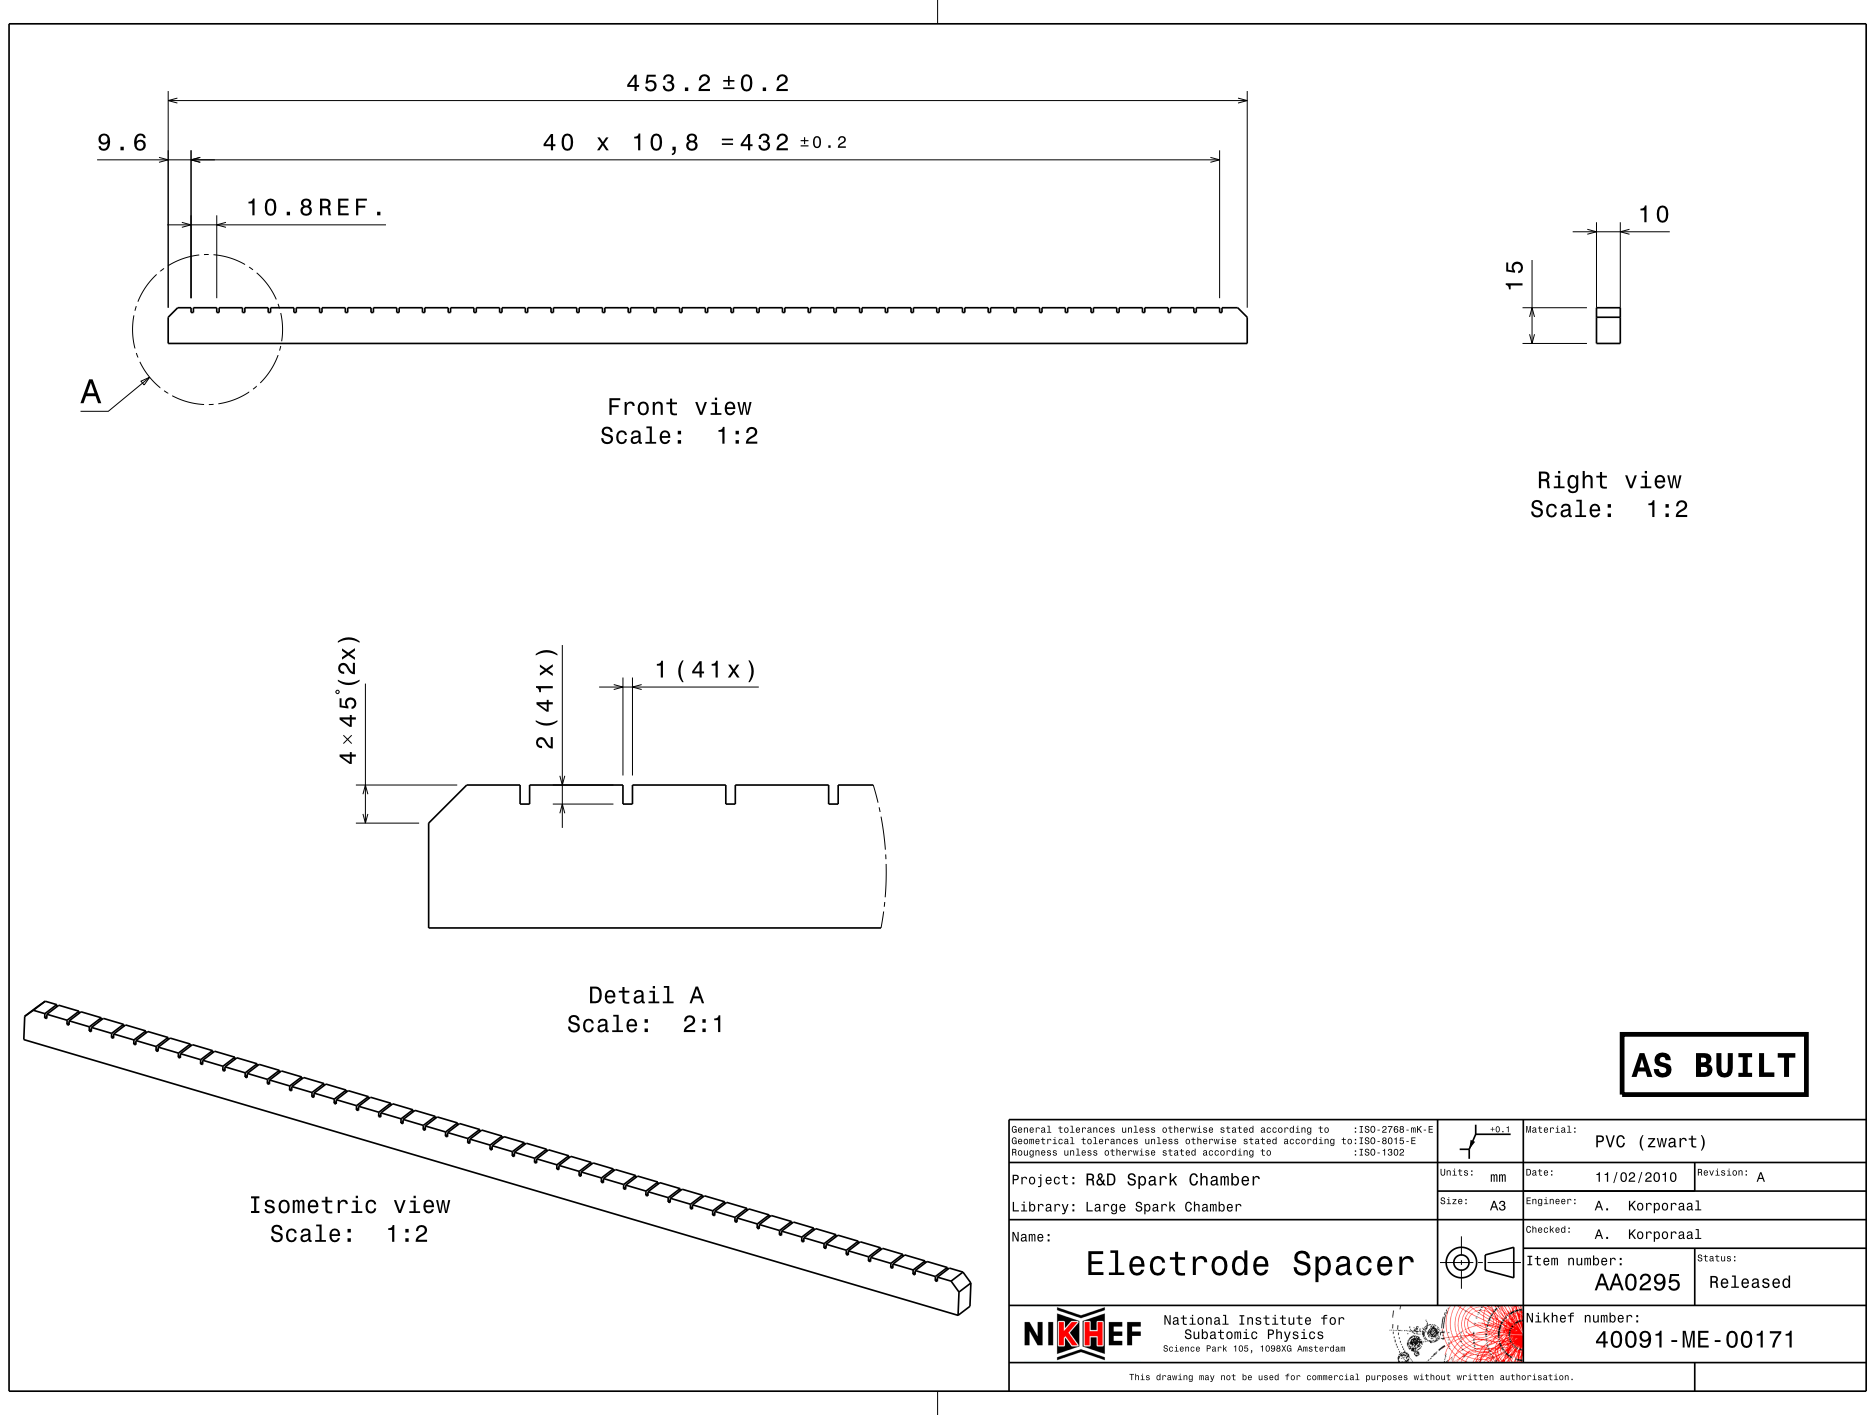
[picture p36: page 1]
