chrisgilmerproj/spark_chamber/Spark Chamber Large/Endflange housing_AA0246_A.pdf

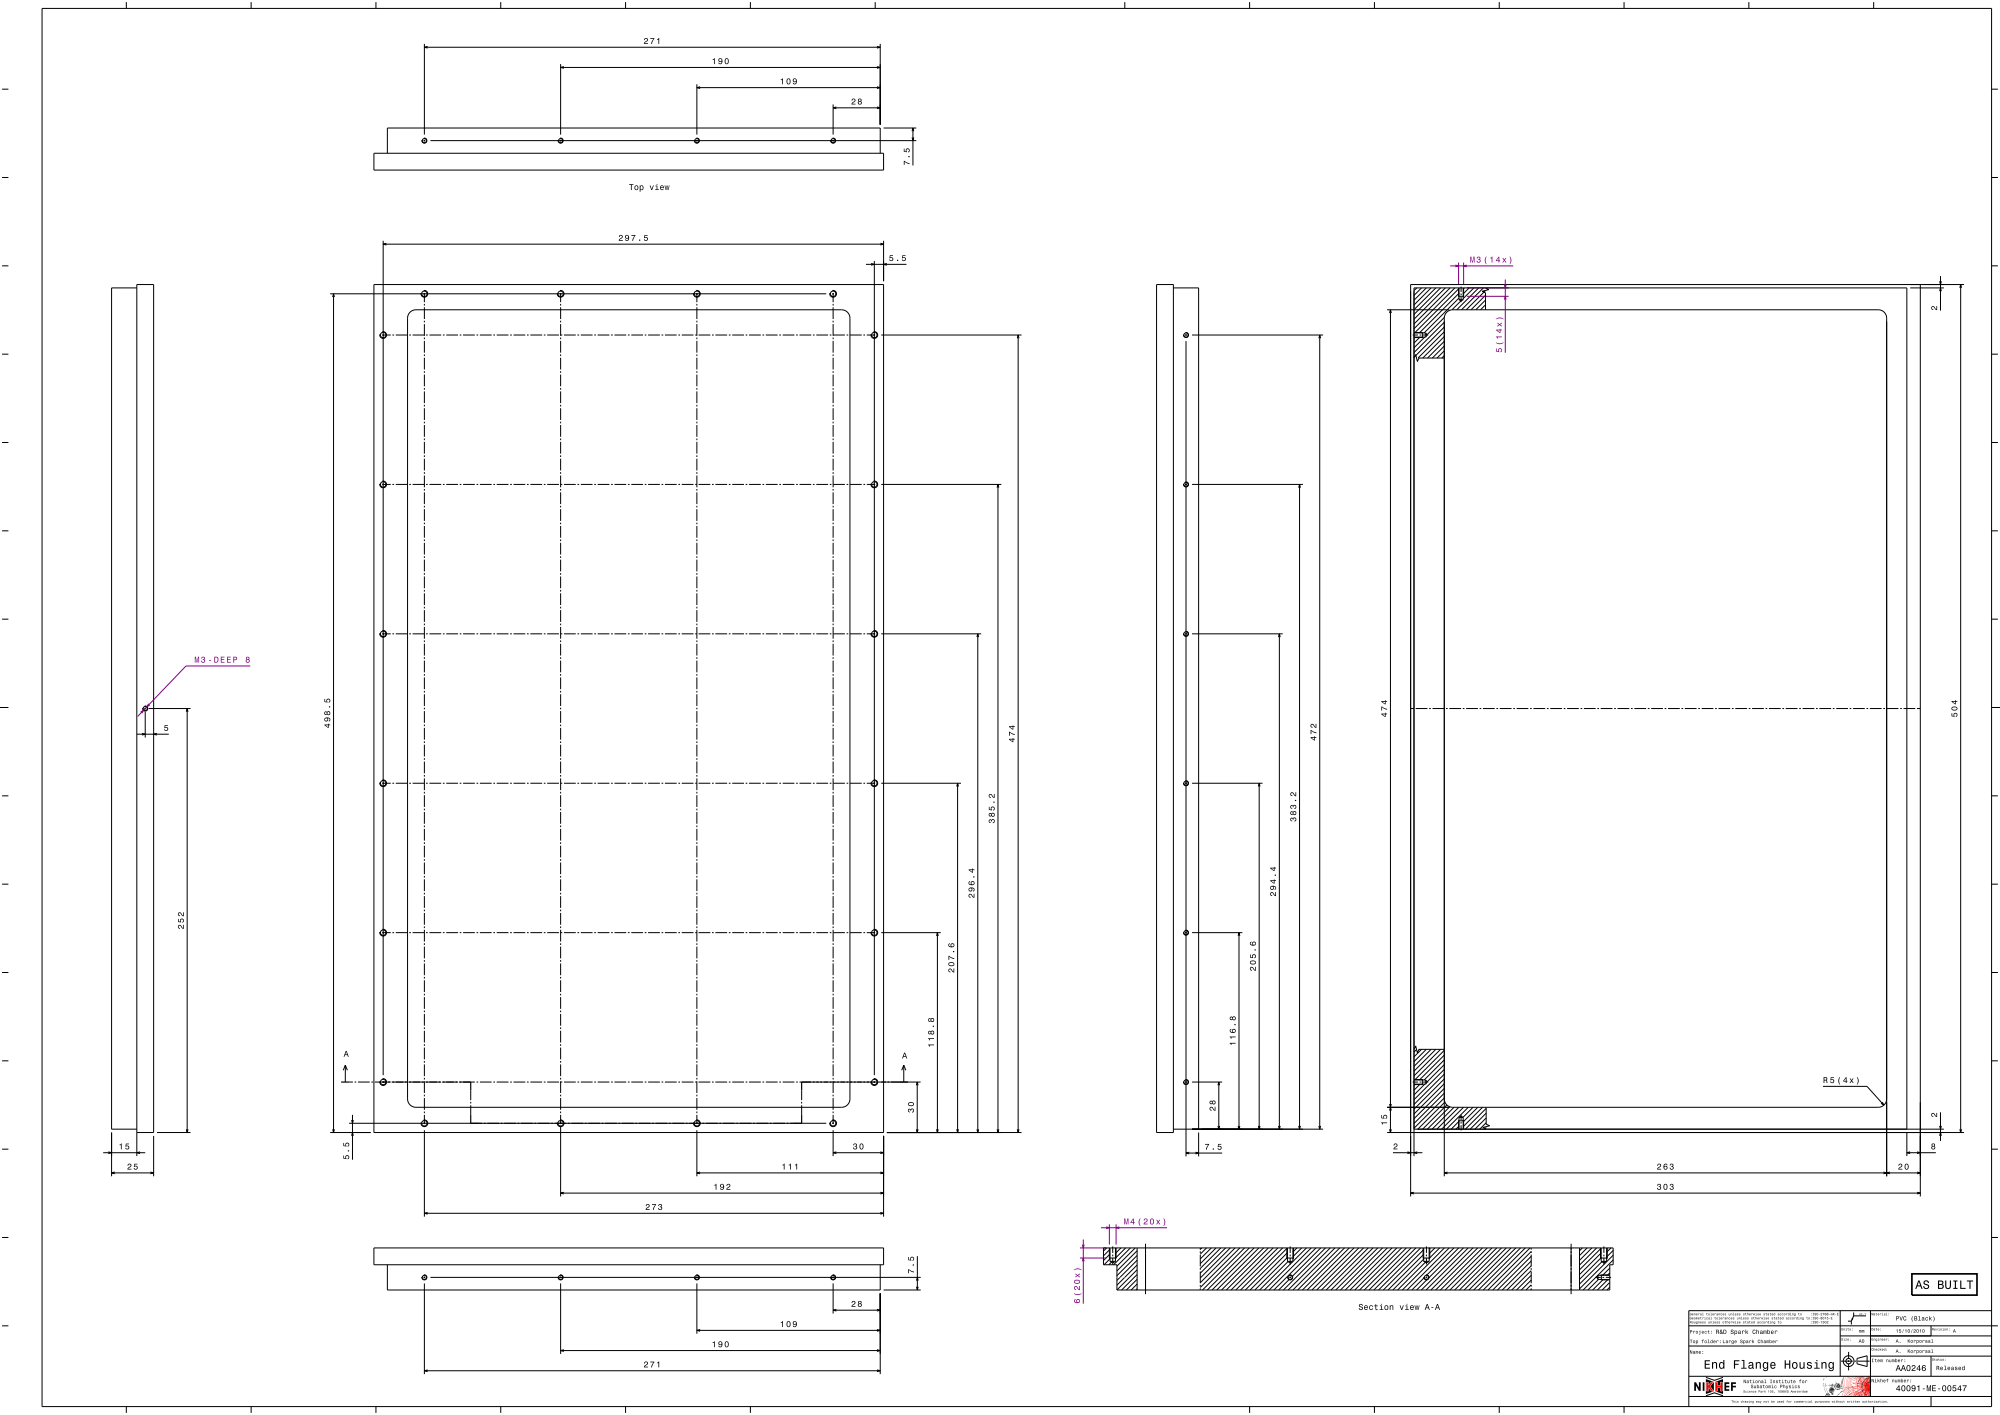
[picture p37: page 1]
