chrisgilmerproj/spark_chamber/Spark Chamber Large/Endplate Front Large_AA0247_A.pdf

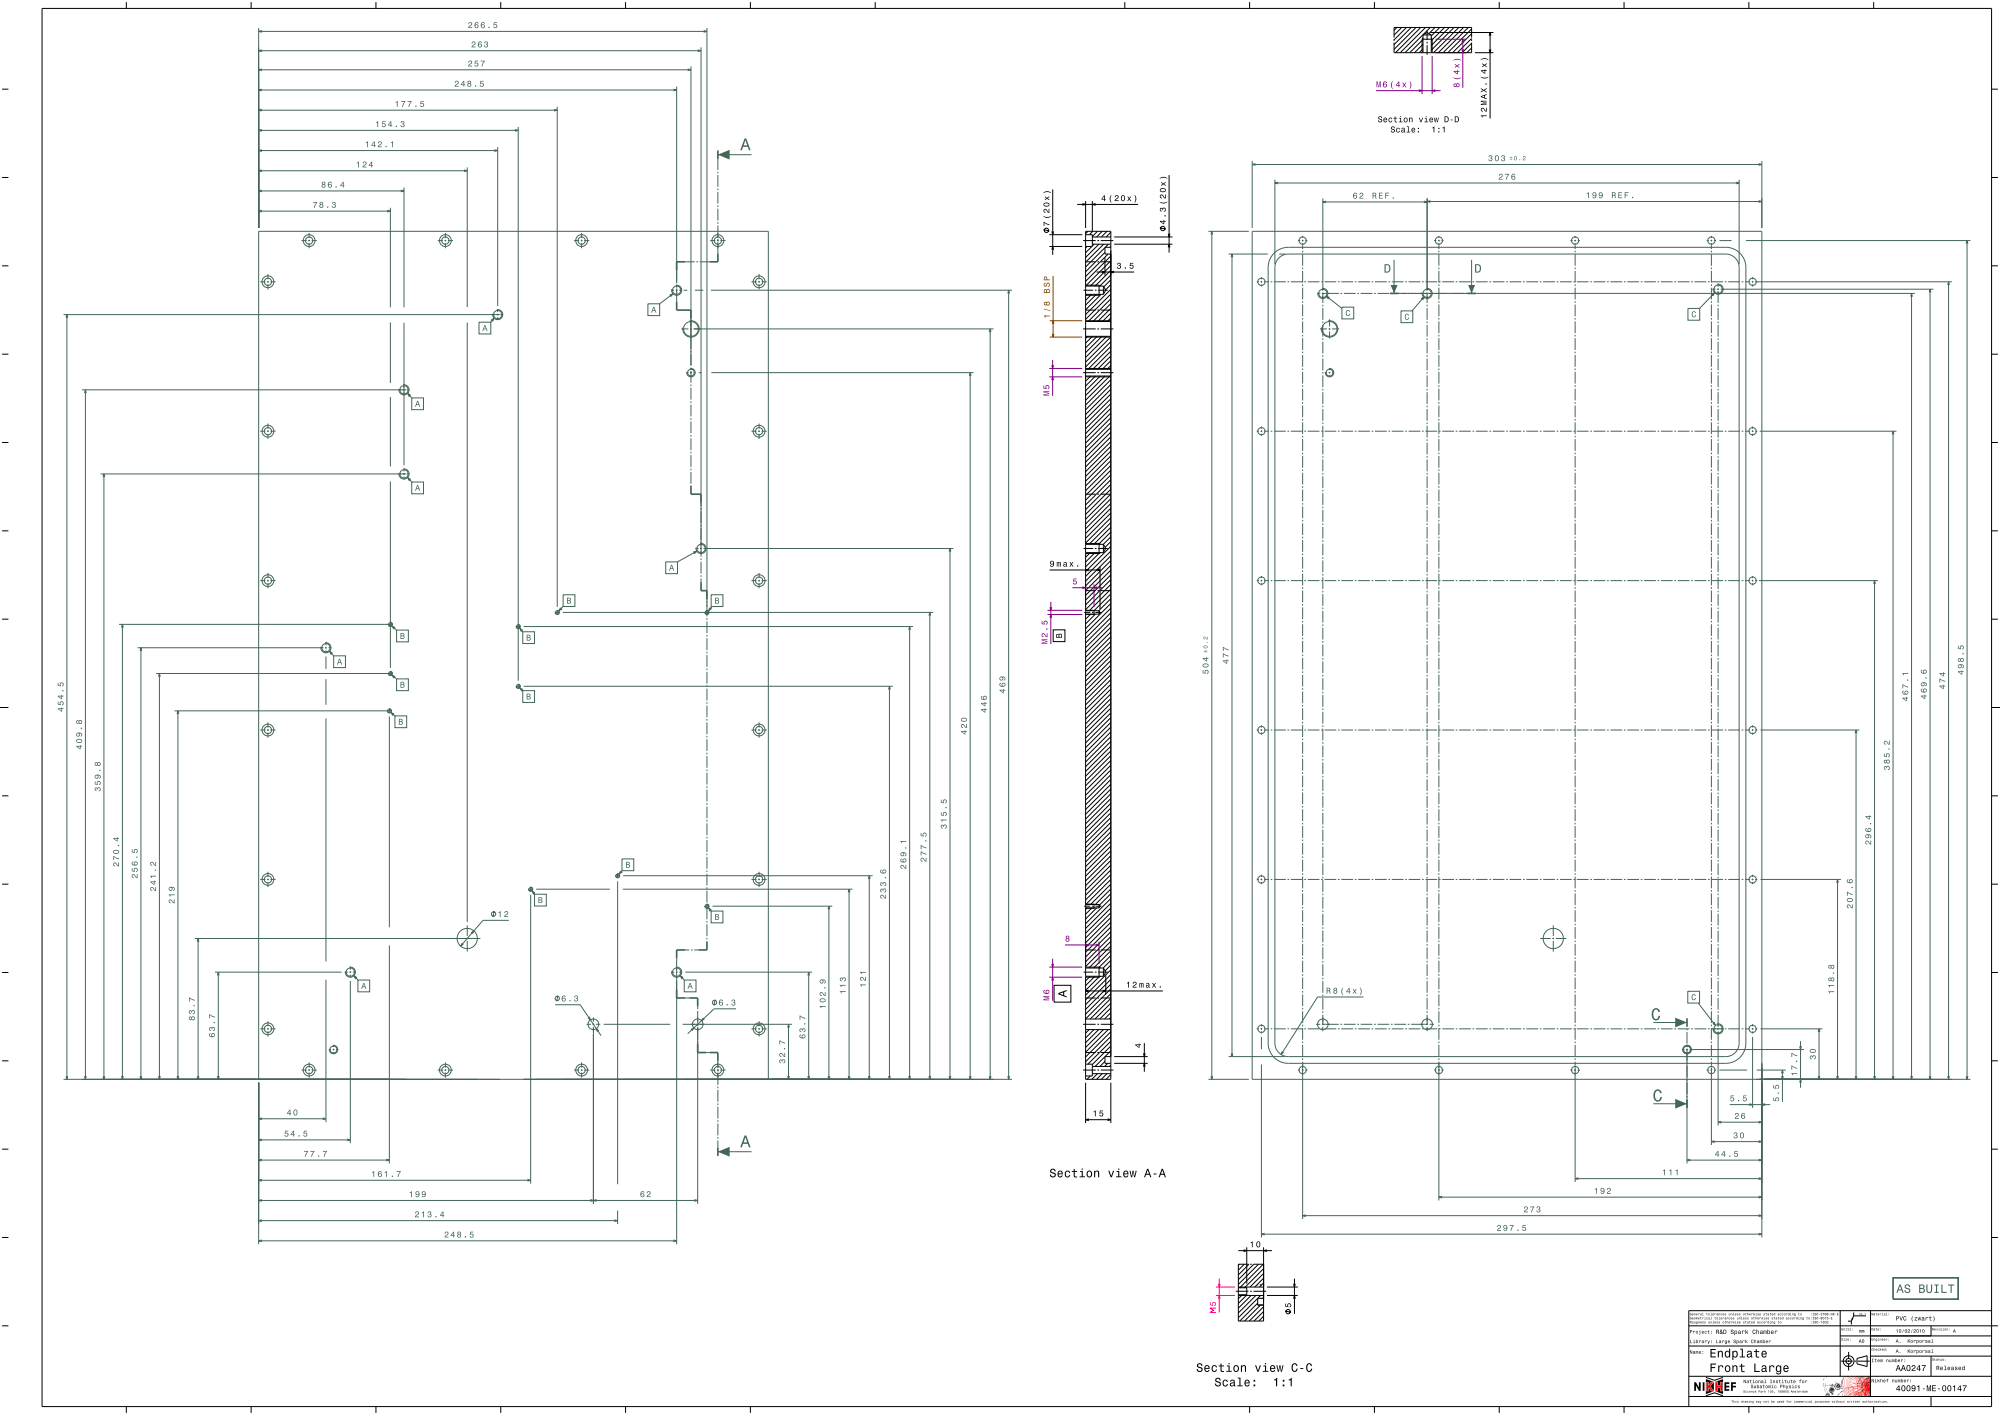
[picture p38: page 1]
