chrisgilmerproj/spark_chamber/Spark Chamber Large/Endplate housing_AA0253_A.pdf

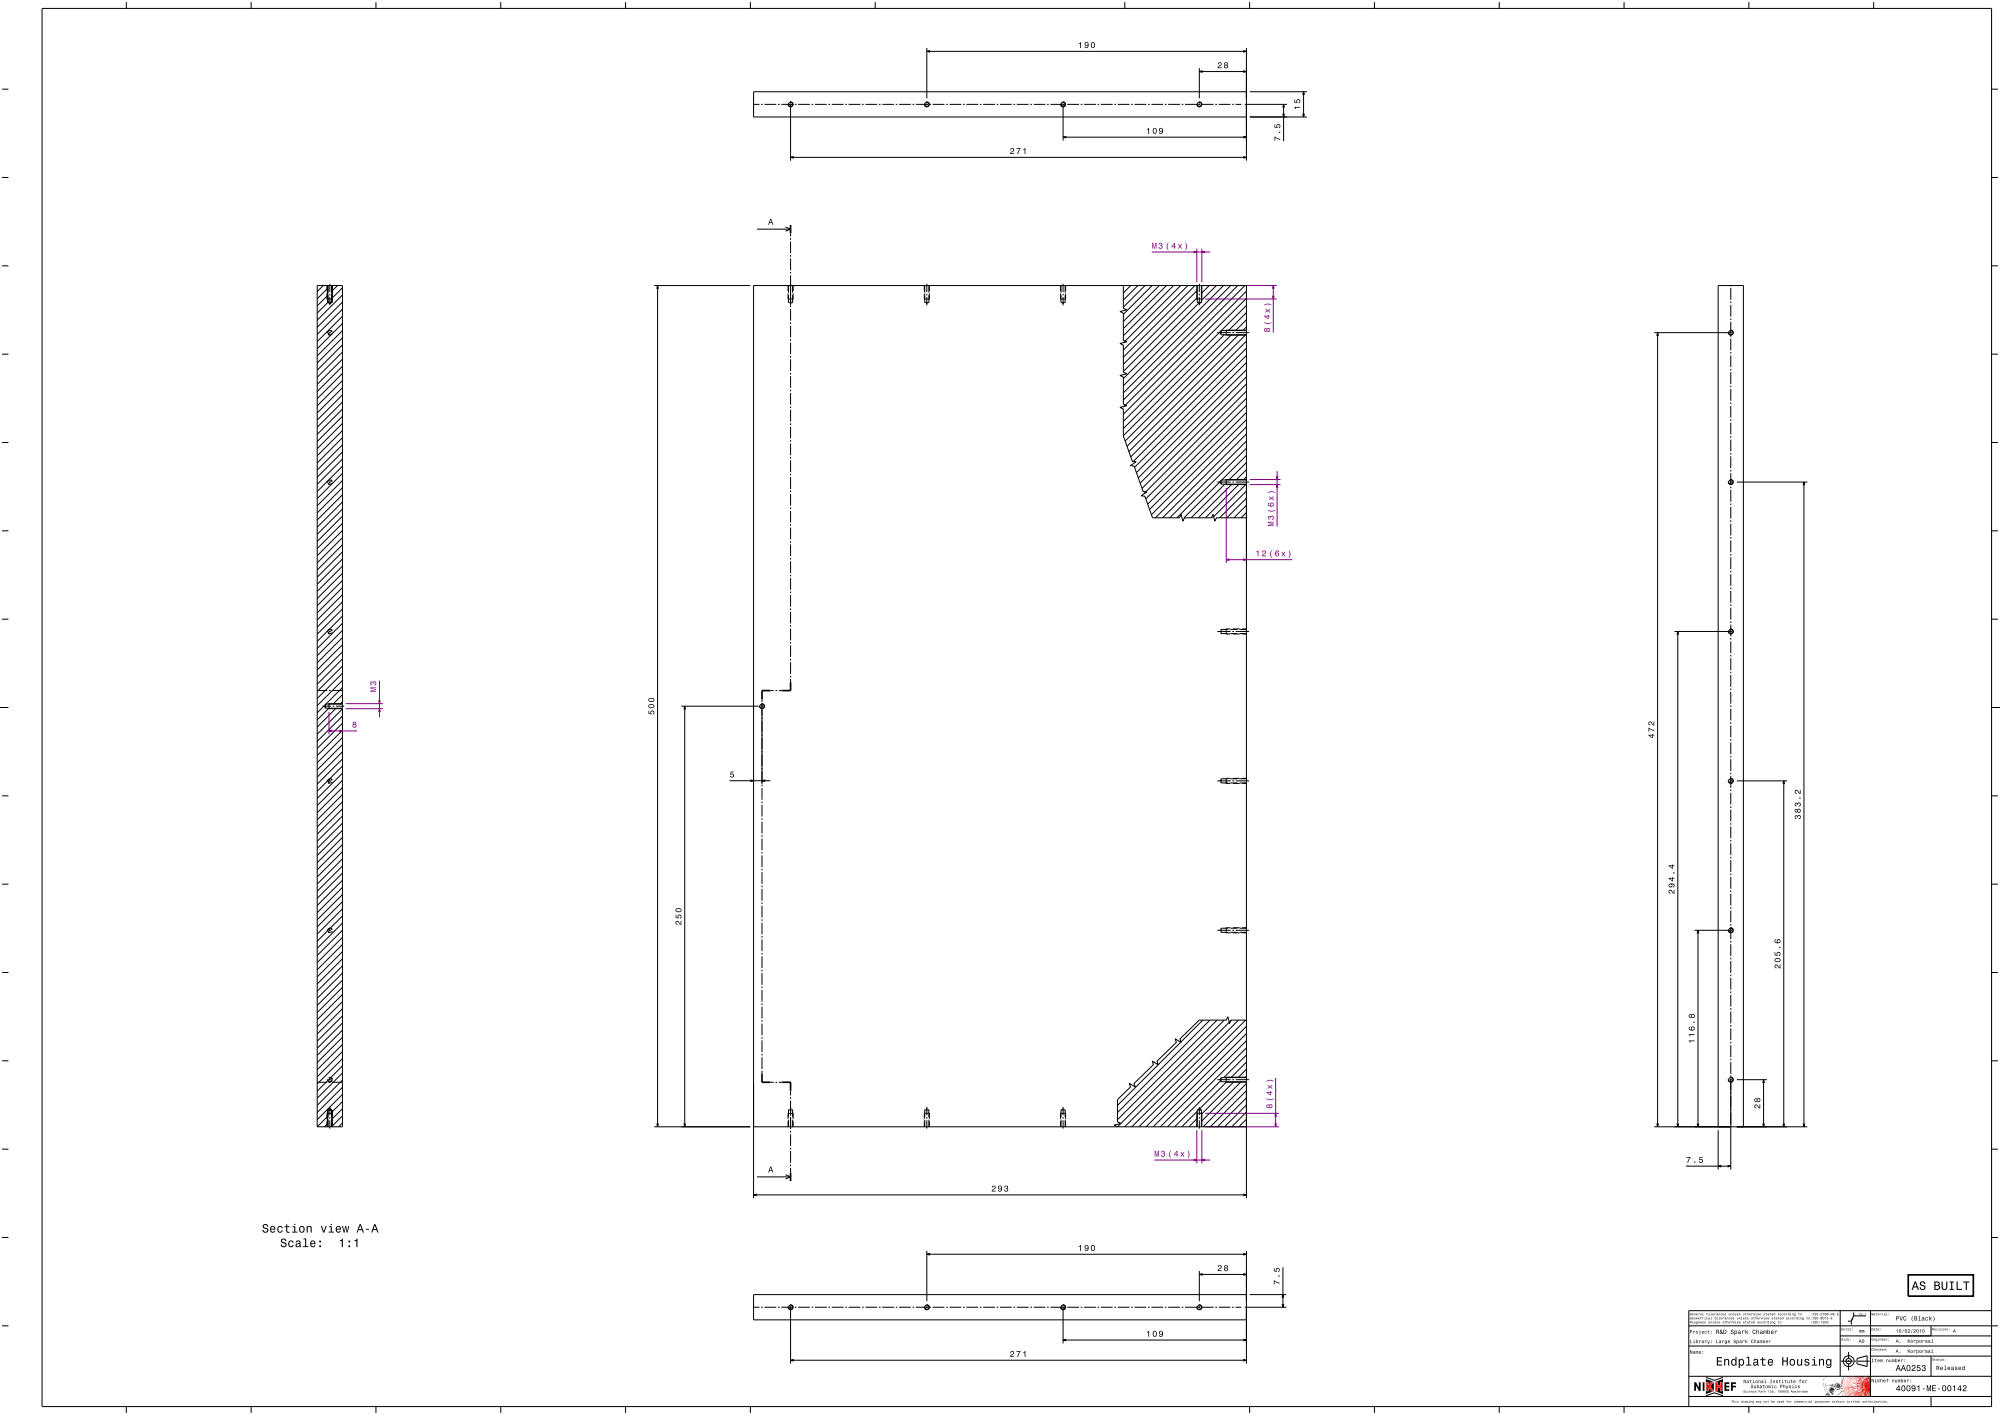
[picture p39: page 1]
