chrisgilmerproj/spark_chamber/Spark Chamber Large/Front plate Box_AA0245_A.pdf

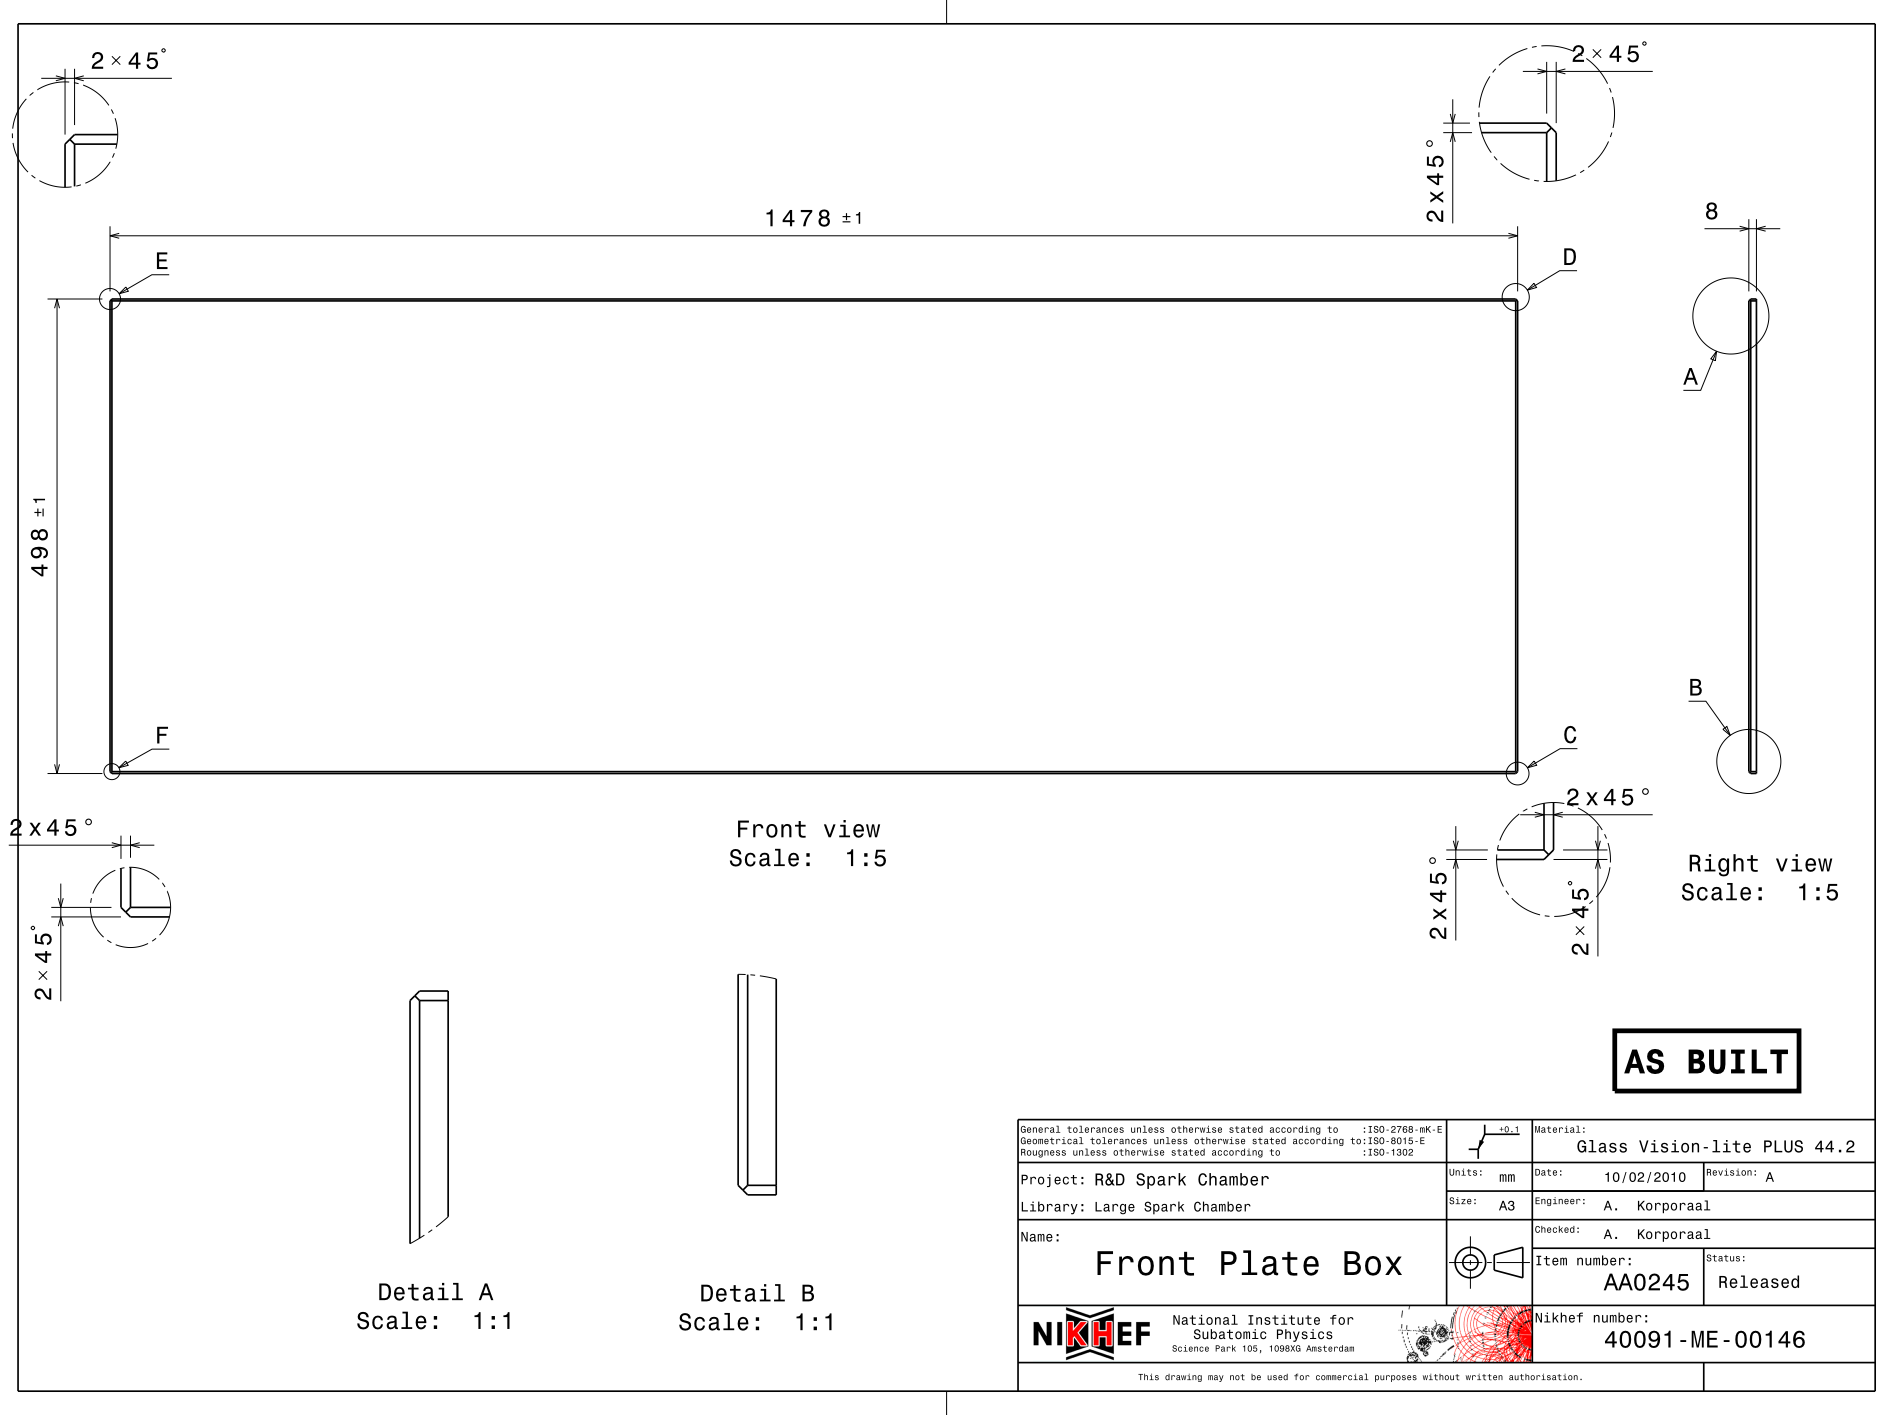
[picture p40: page 1]
