chrisgilmerproj/spark_chamber/Spark Chamber Large/Front Strip Large_AA0258_A.pdf

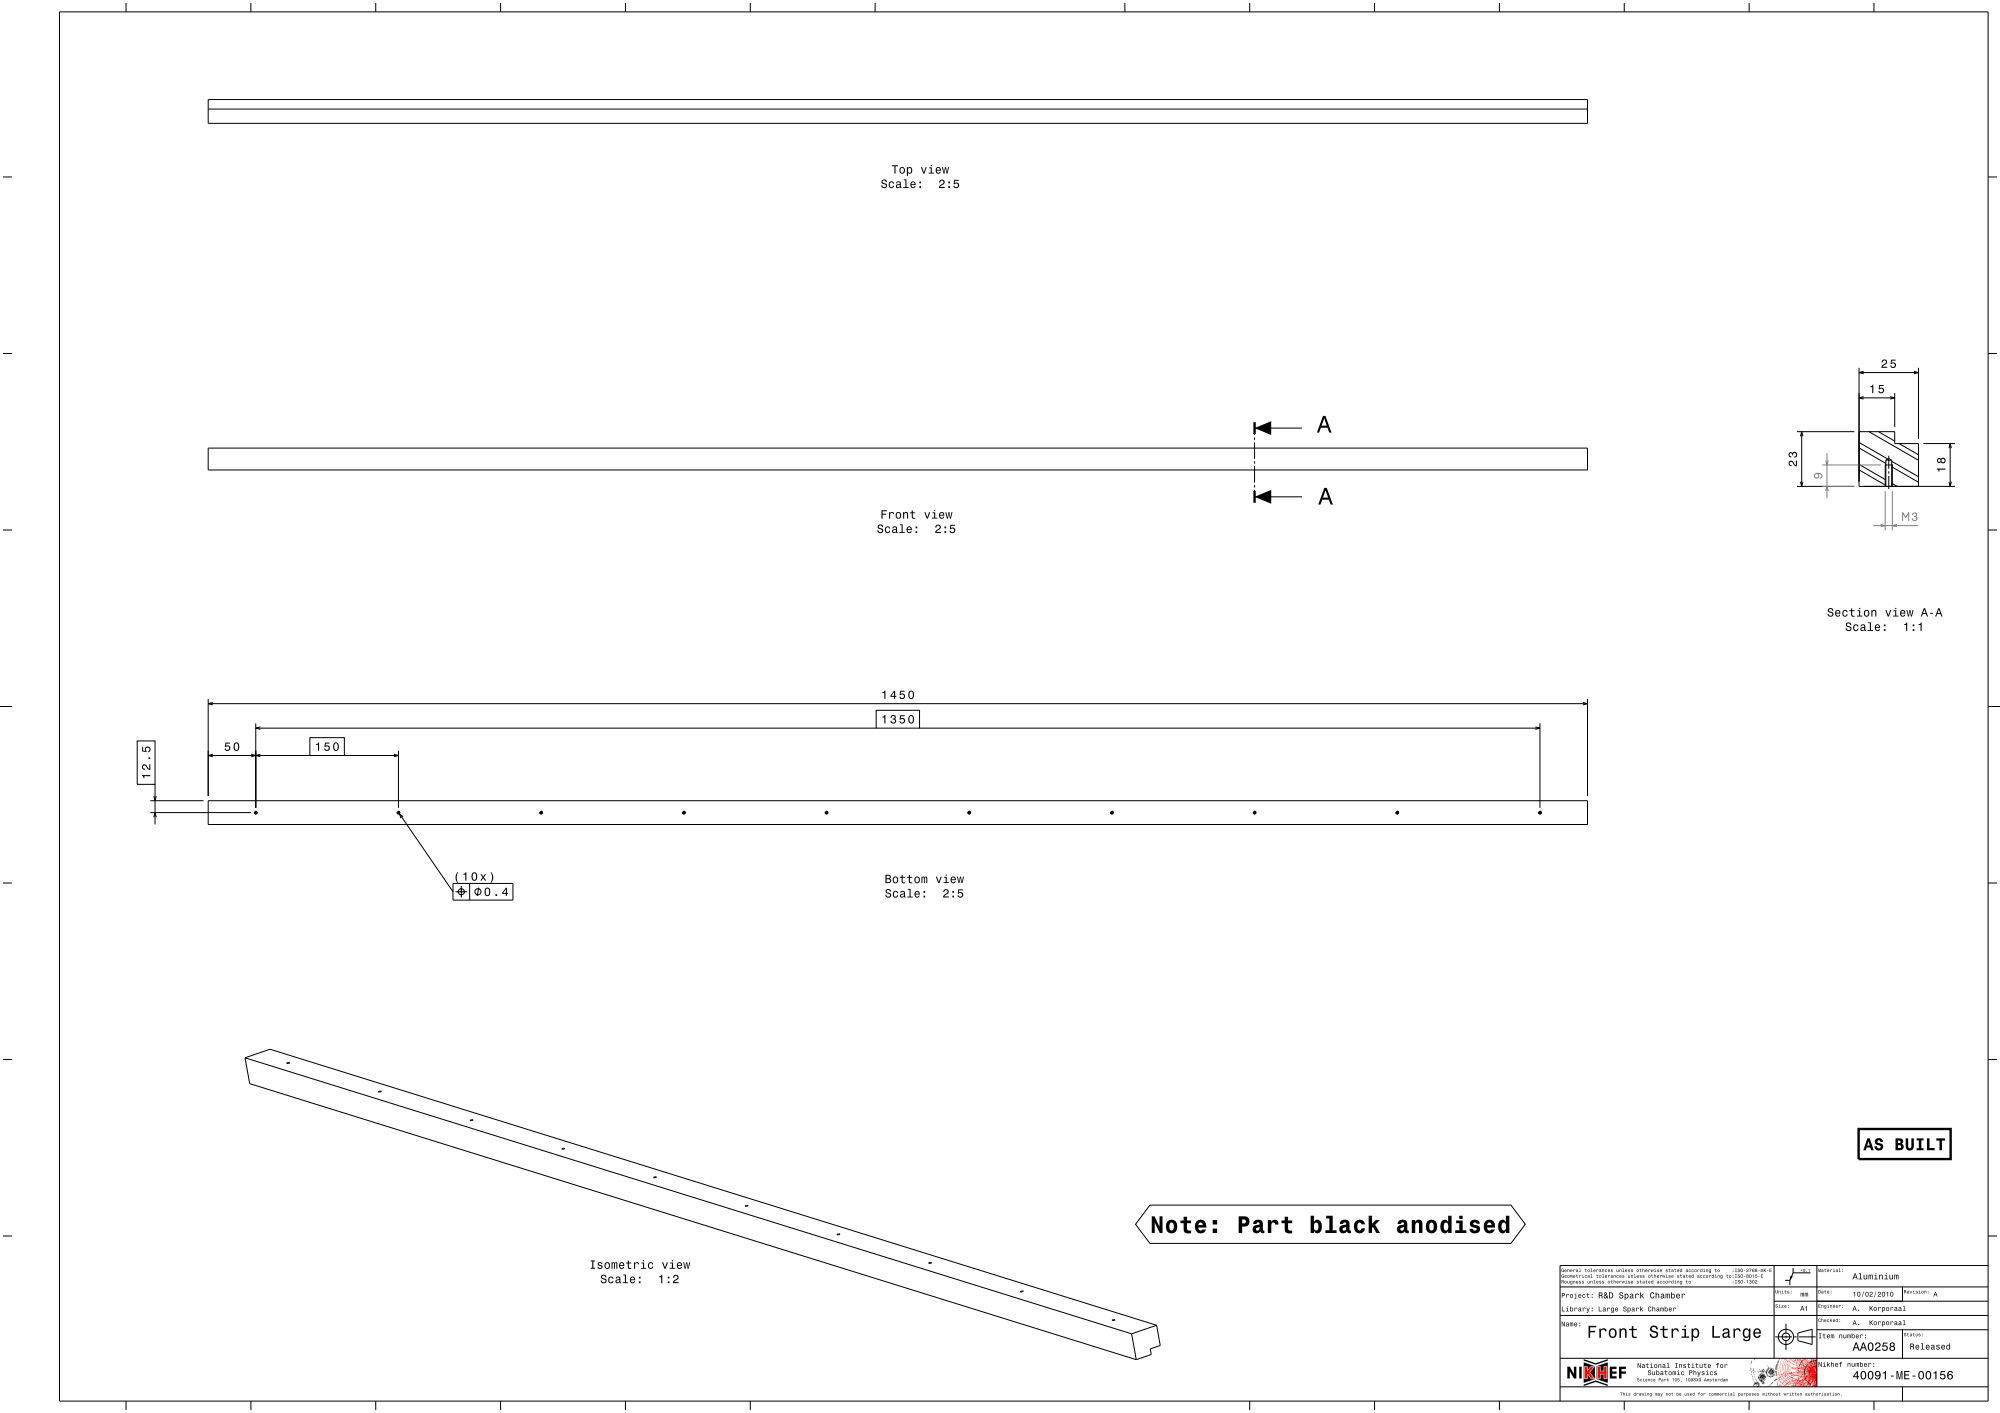
[picture p41: page 1]
