chrisgilmerproj/spark_chamber/Spark Chamber Large/Gas Control Front_AA0313_A.pdf

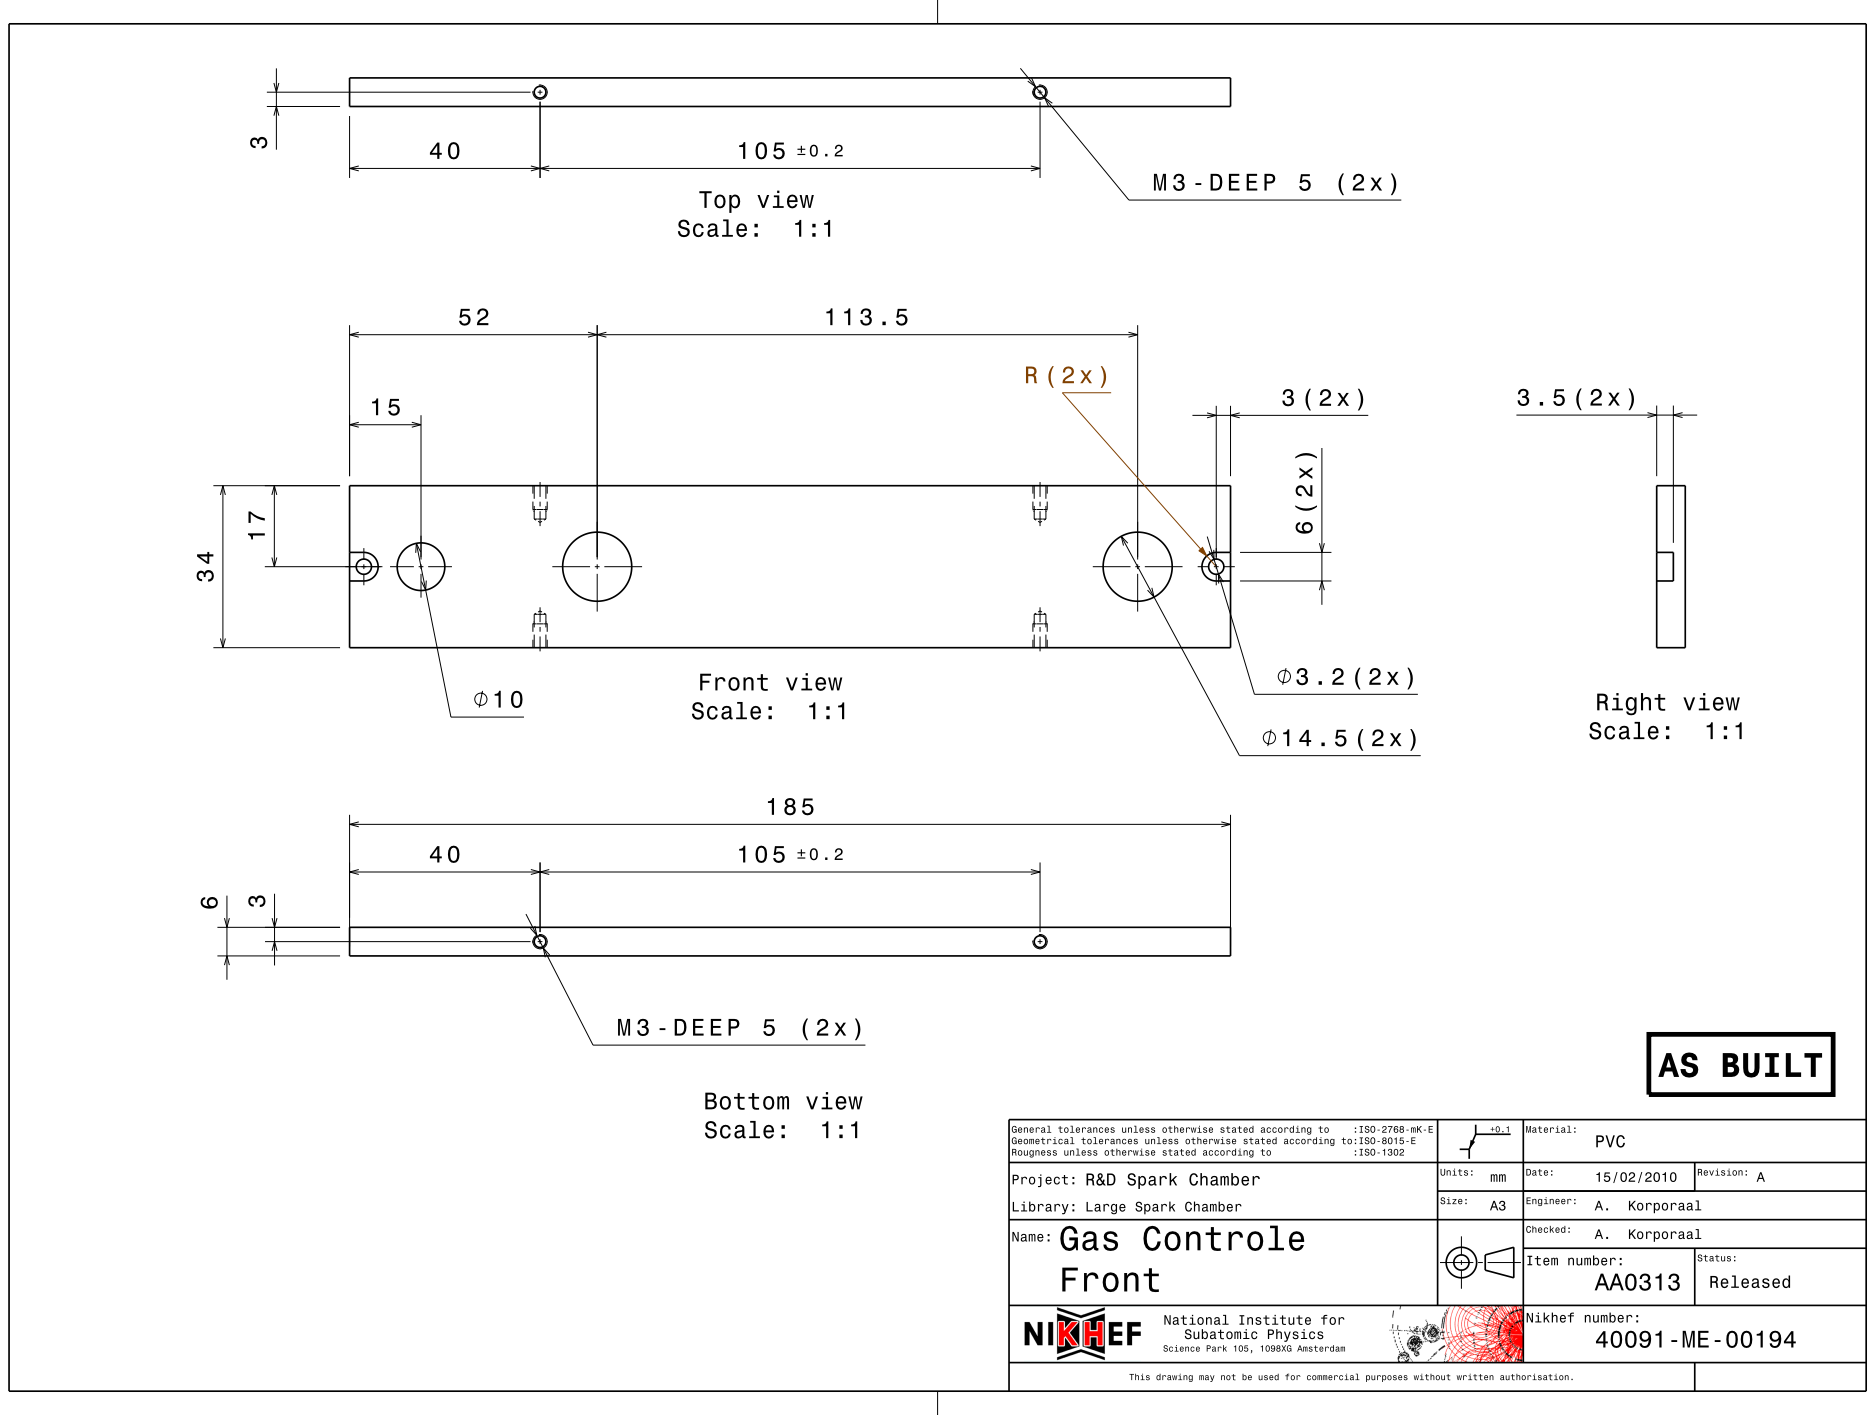
[picture p42: page 1]
