chrisgilmerproj/spark_chamber/Spark Chamber Large/Gas Control Side Wall_AA0314_A.pdf

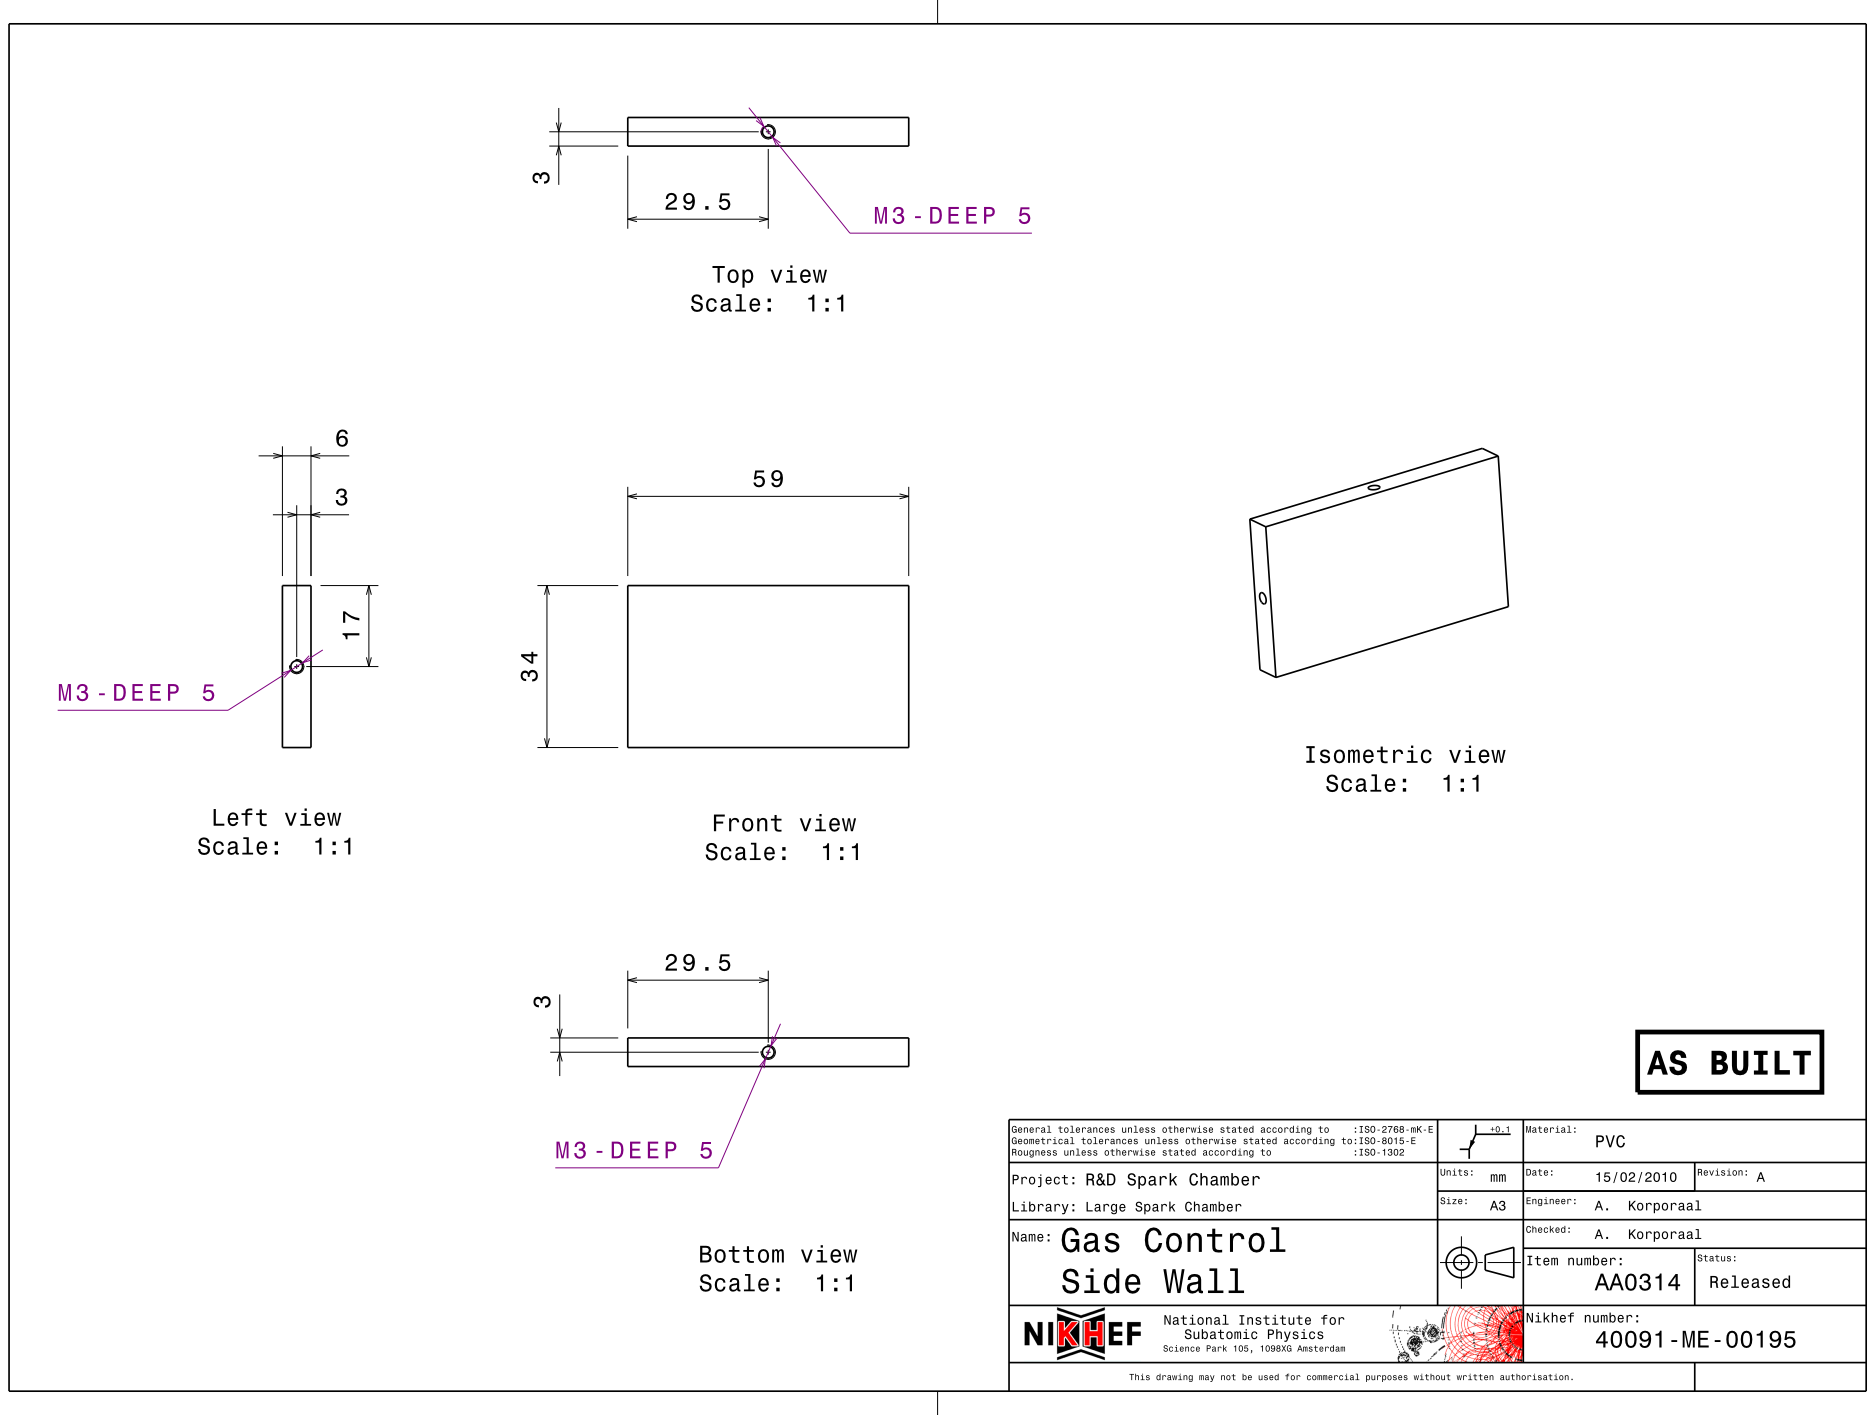
[picture p43: page 1]
