chrisgilmerproj/spark_chamber/Spark Chamber Large/Gas Control Stud_AA0317_A.pdf

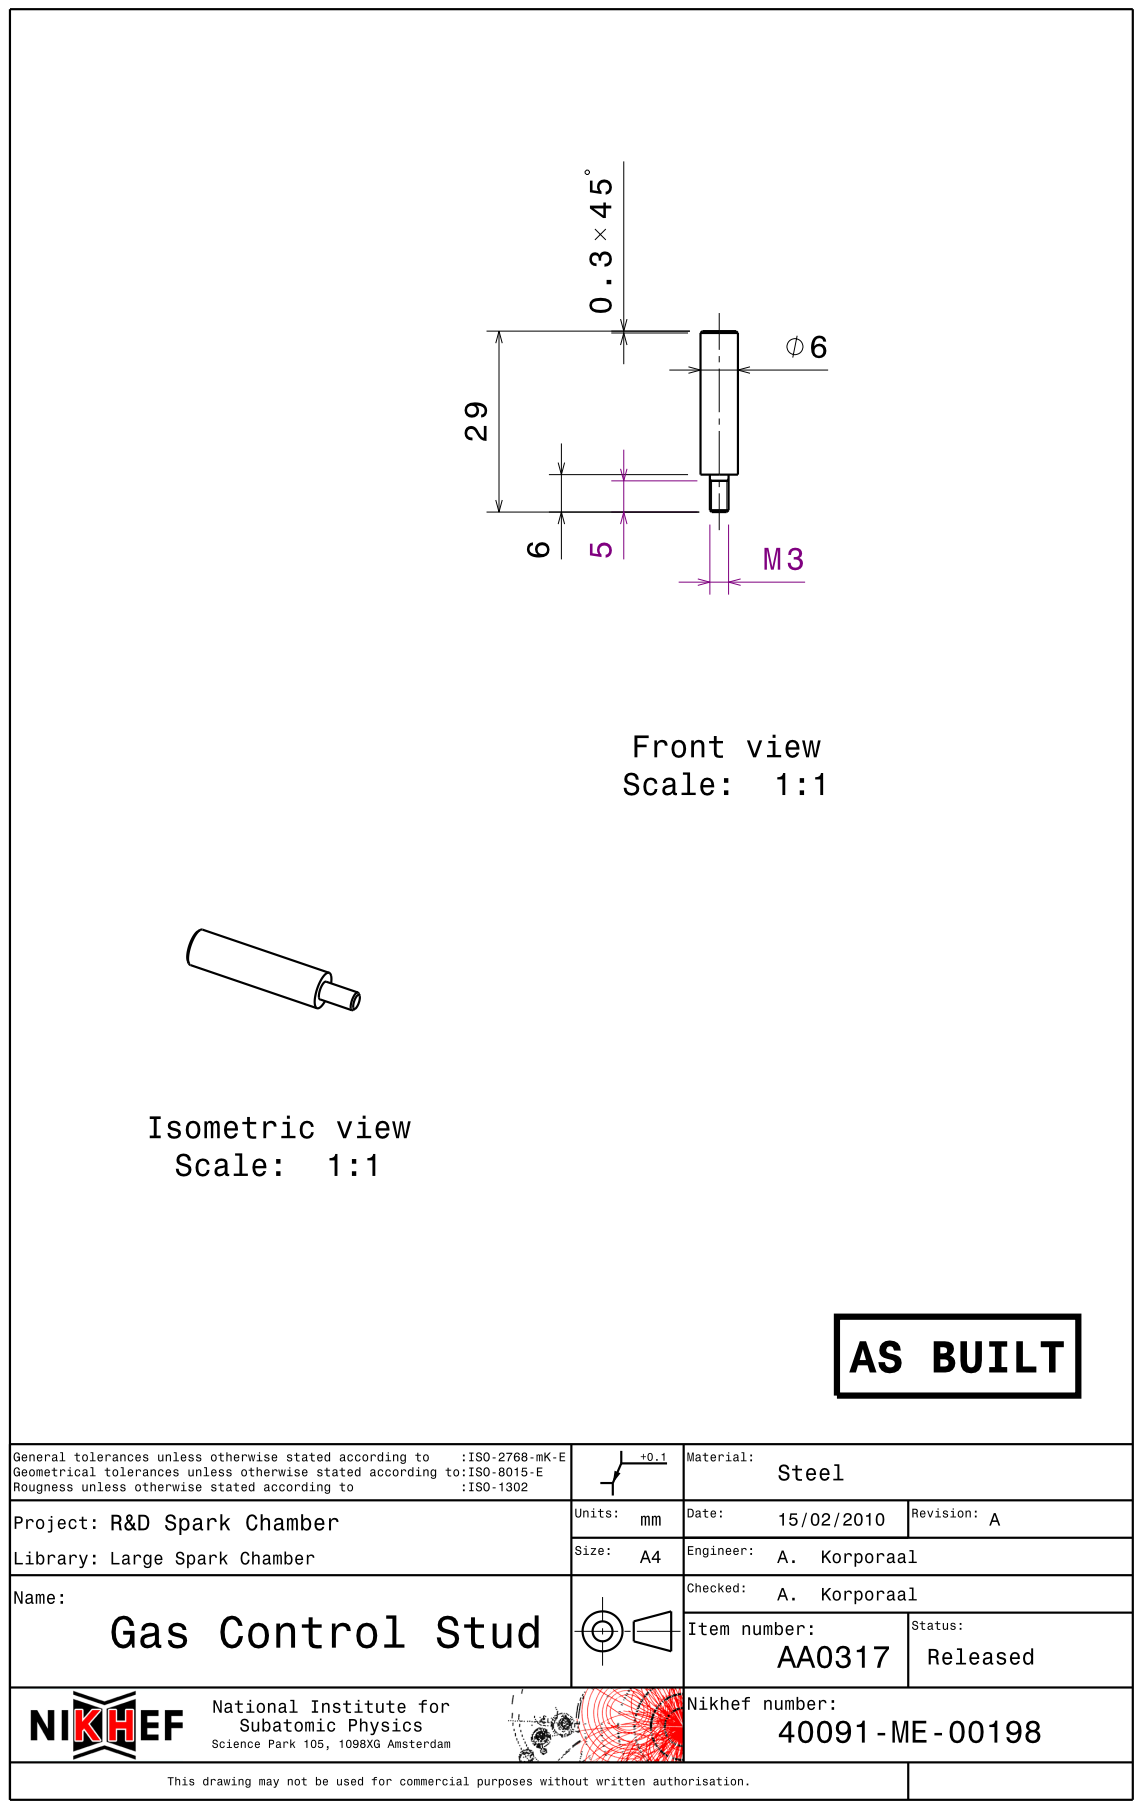
[picture p44: page 1]
