chrisgilmerproj/spark_chamber/Spark Chamber Large/Gas Controle Cover 1_AA0315_A.pdf

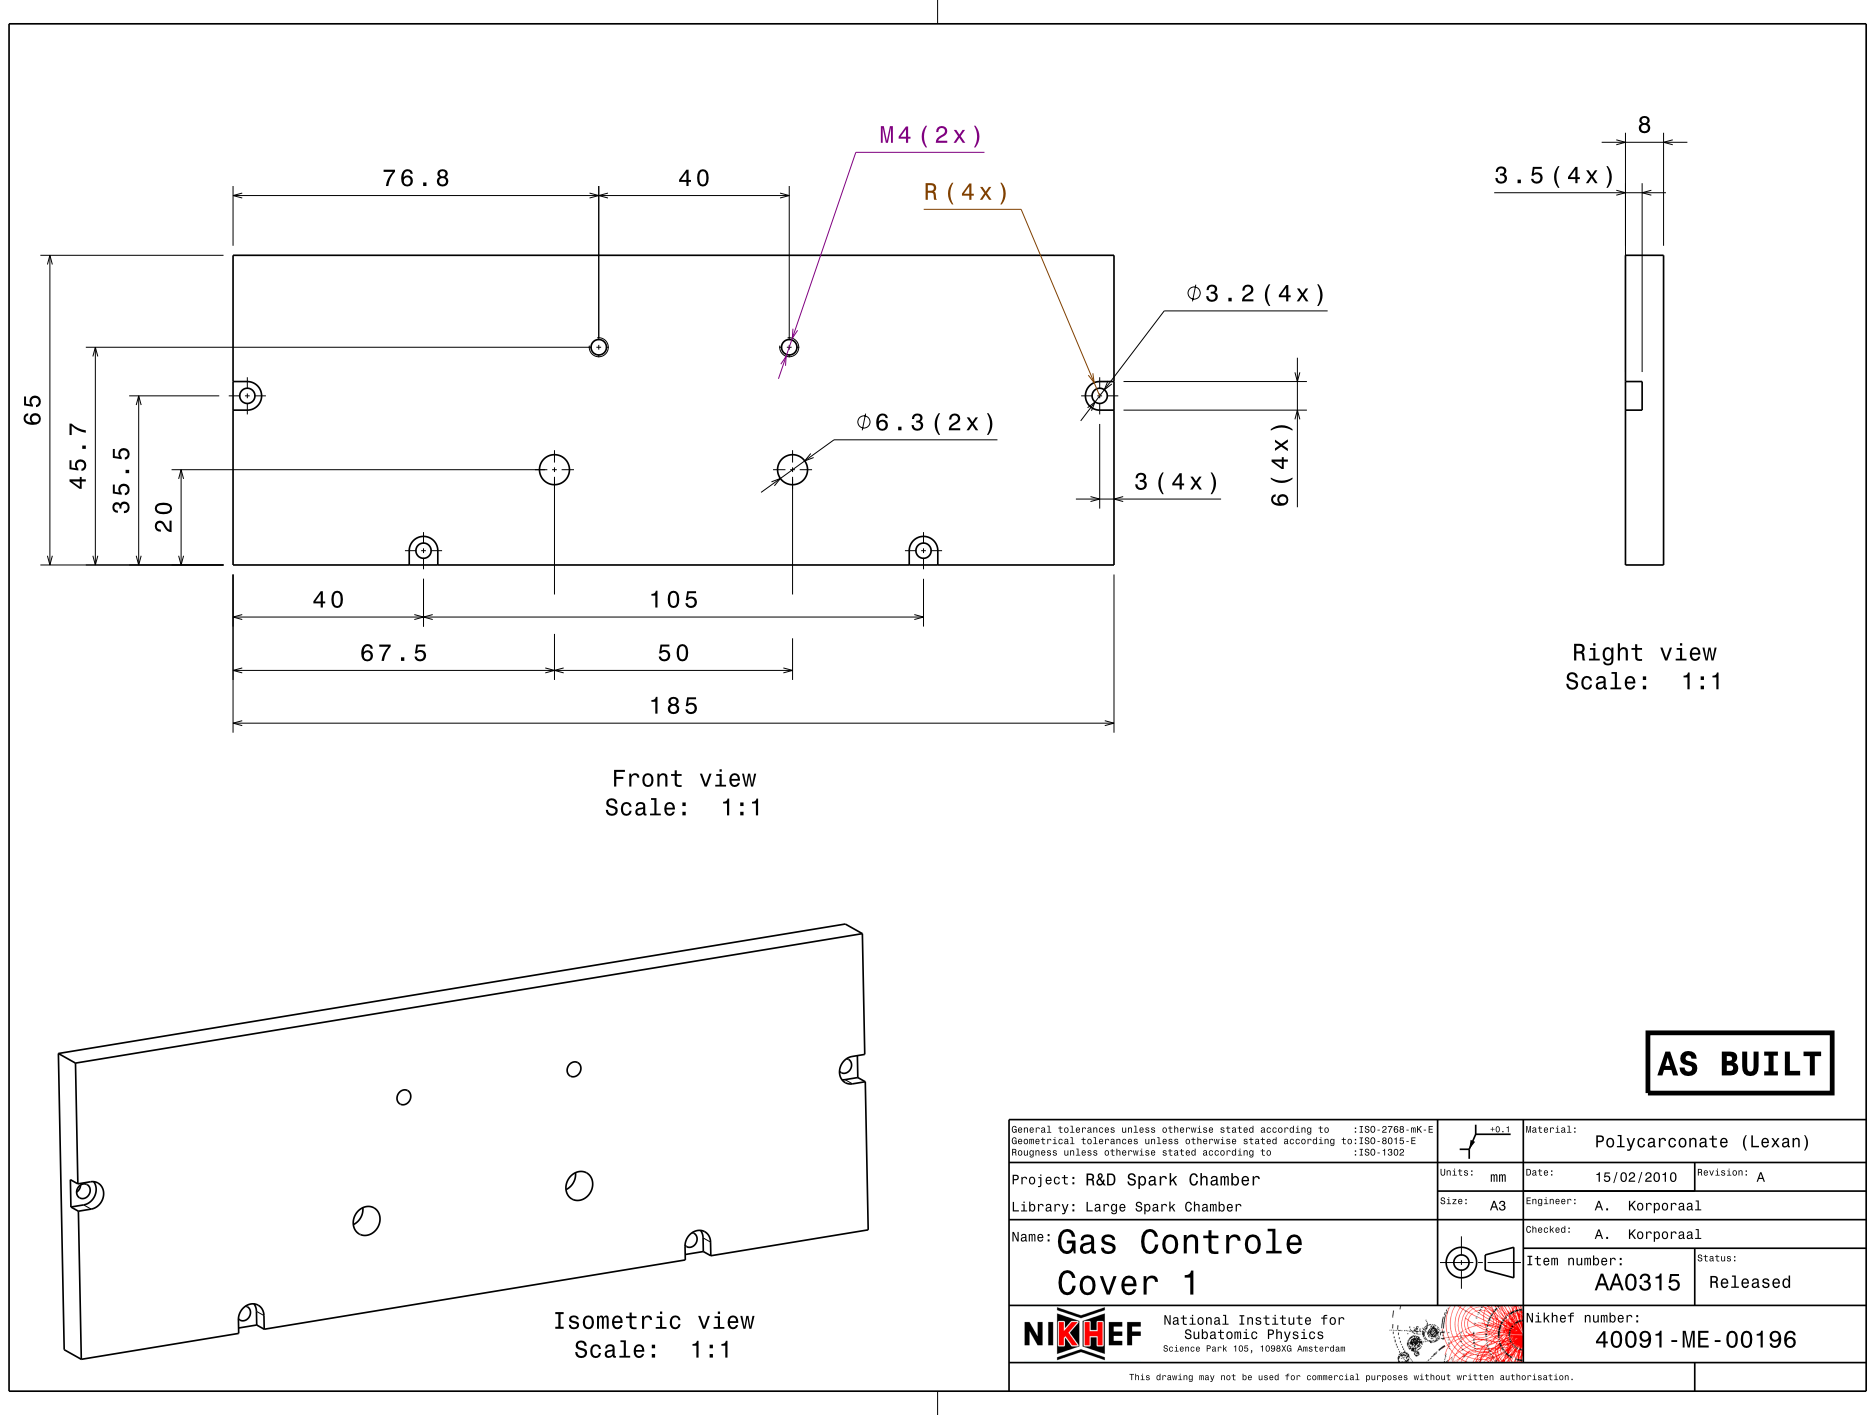
[picture p45: page 1]
