chrisgilmerproj/spark_chamber/Spark Chamber Large/Gas Controle Cover 2_AA0316_A.pdf

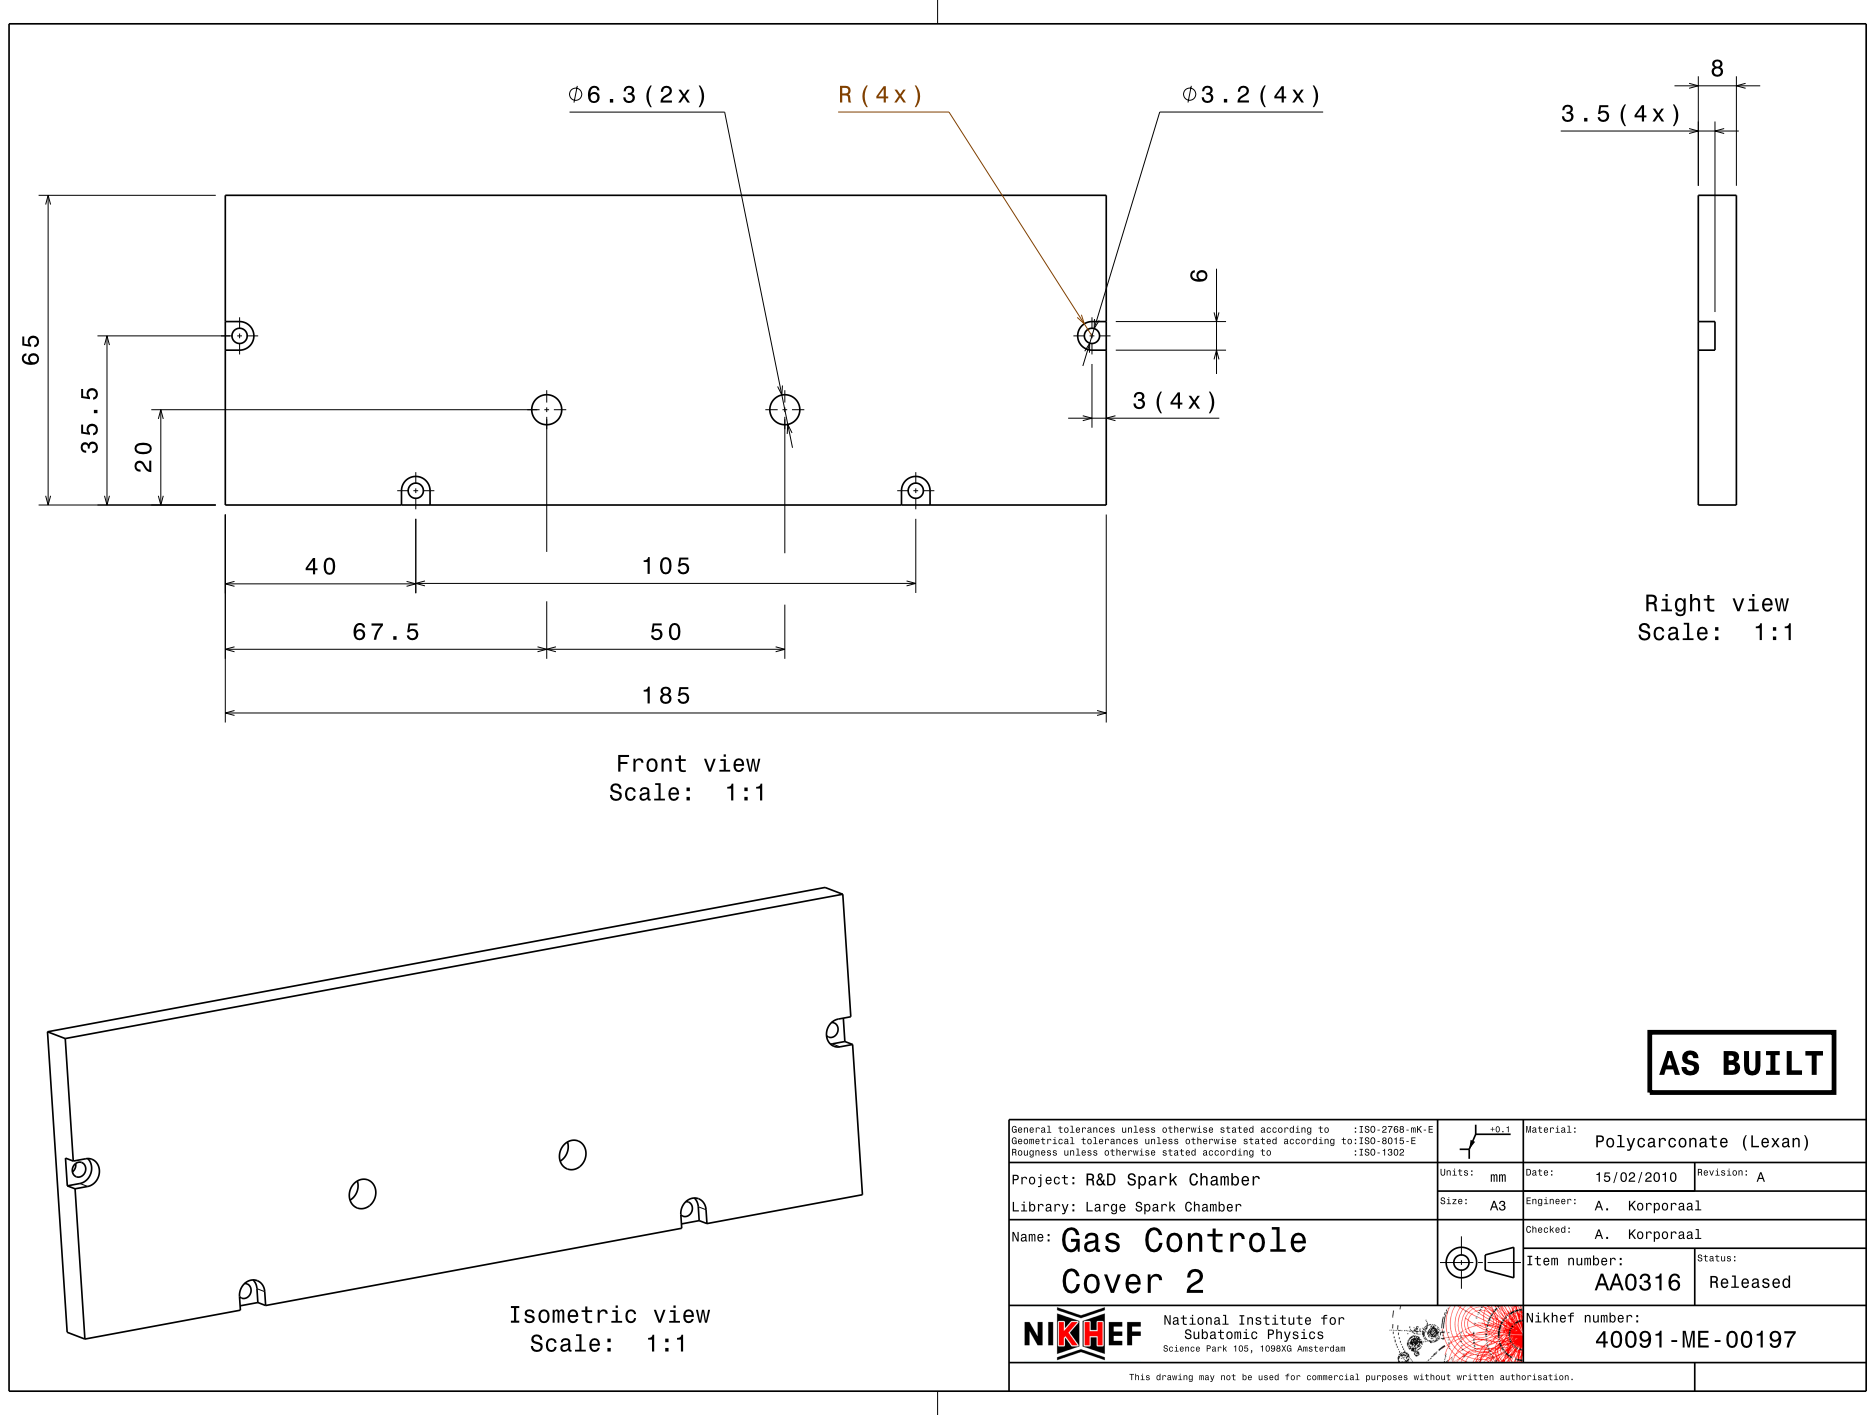
[picture p46: page 1]
