chrisgilmerproj/spark_chamber/Spark Chamber Large/Ground Bus_AA0287_A.pdf

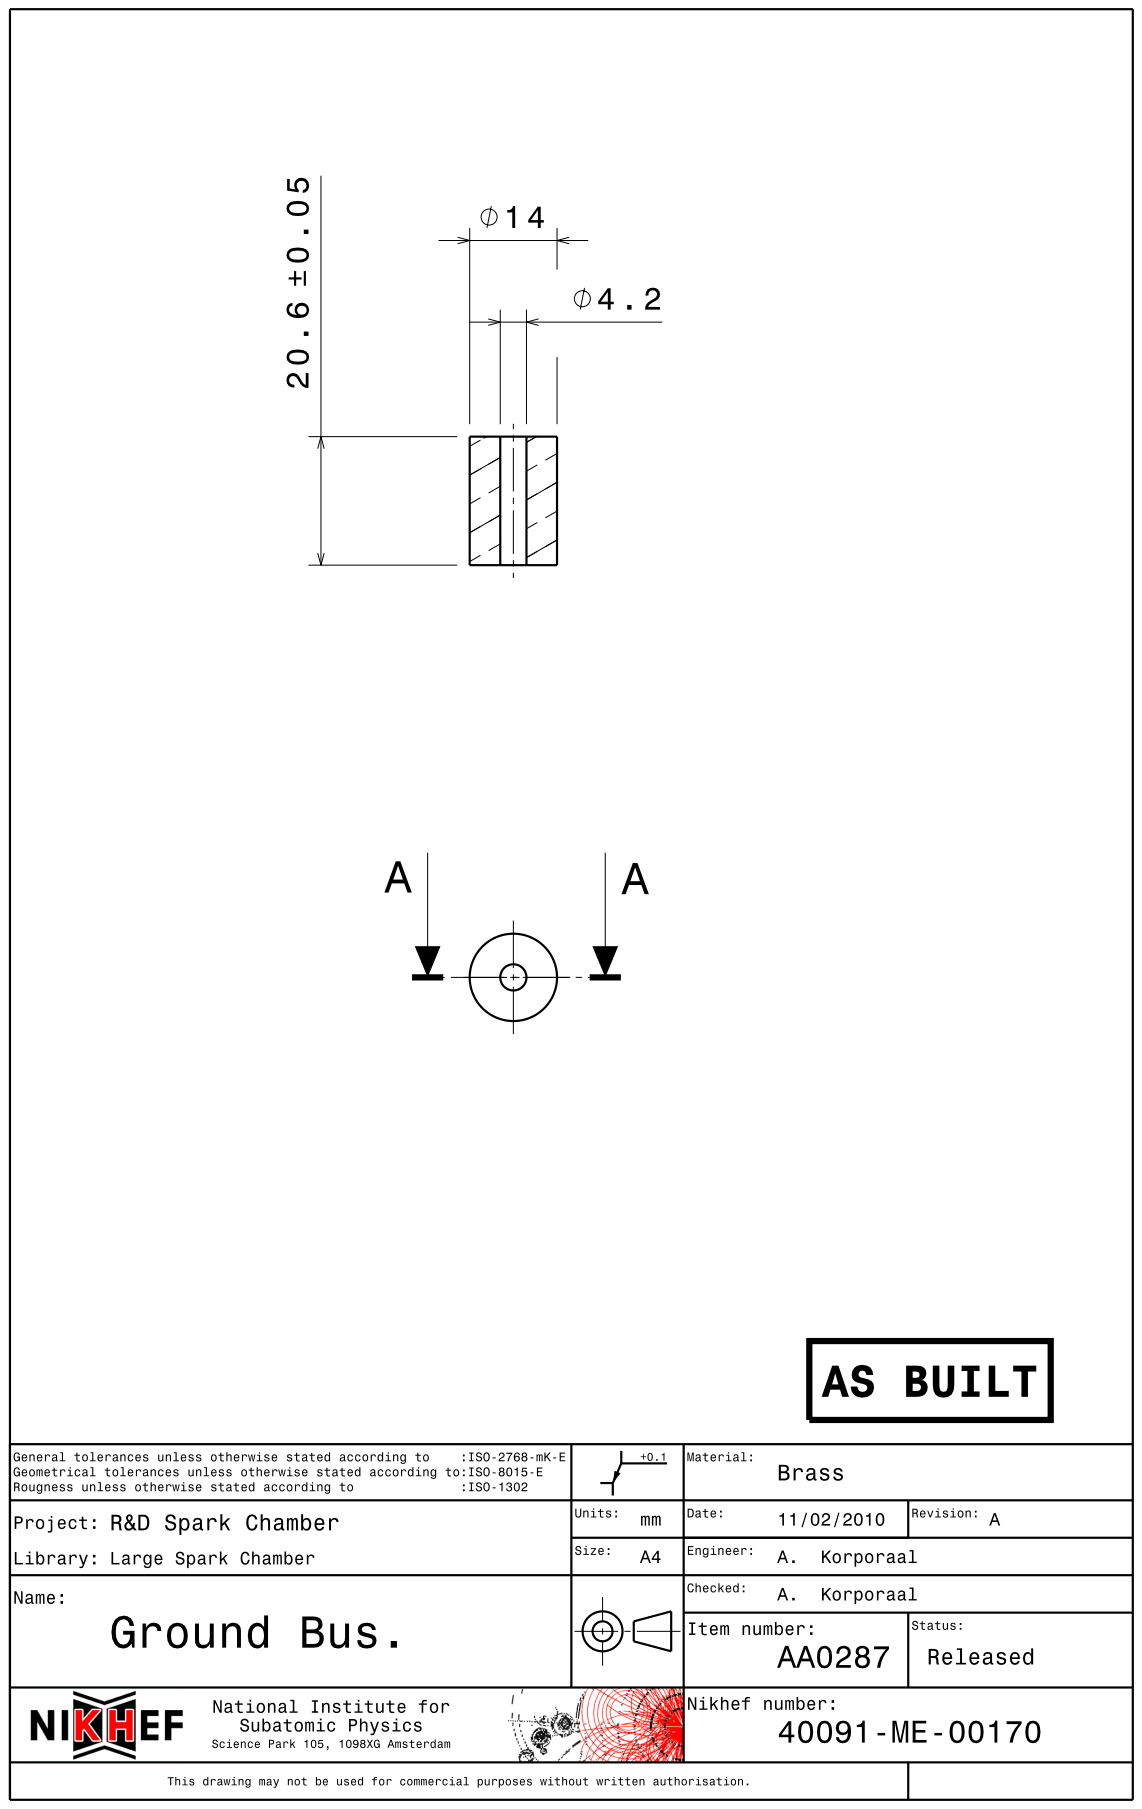
[picture p47: page 1]
