chrisgilmerproj/spark_chamber/Spark Chamber Large/Ground Strip_AA0255_A.pdf

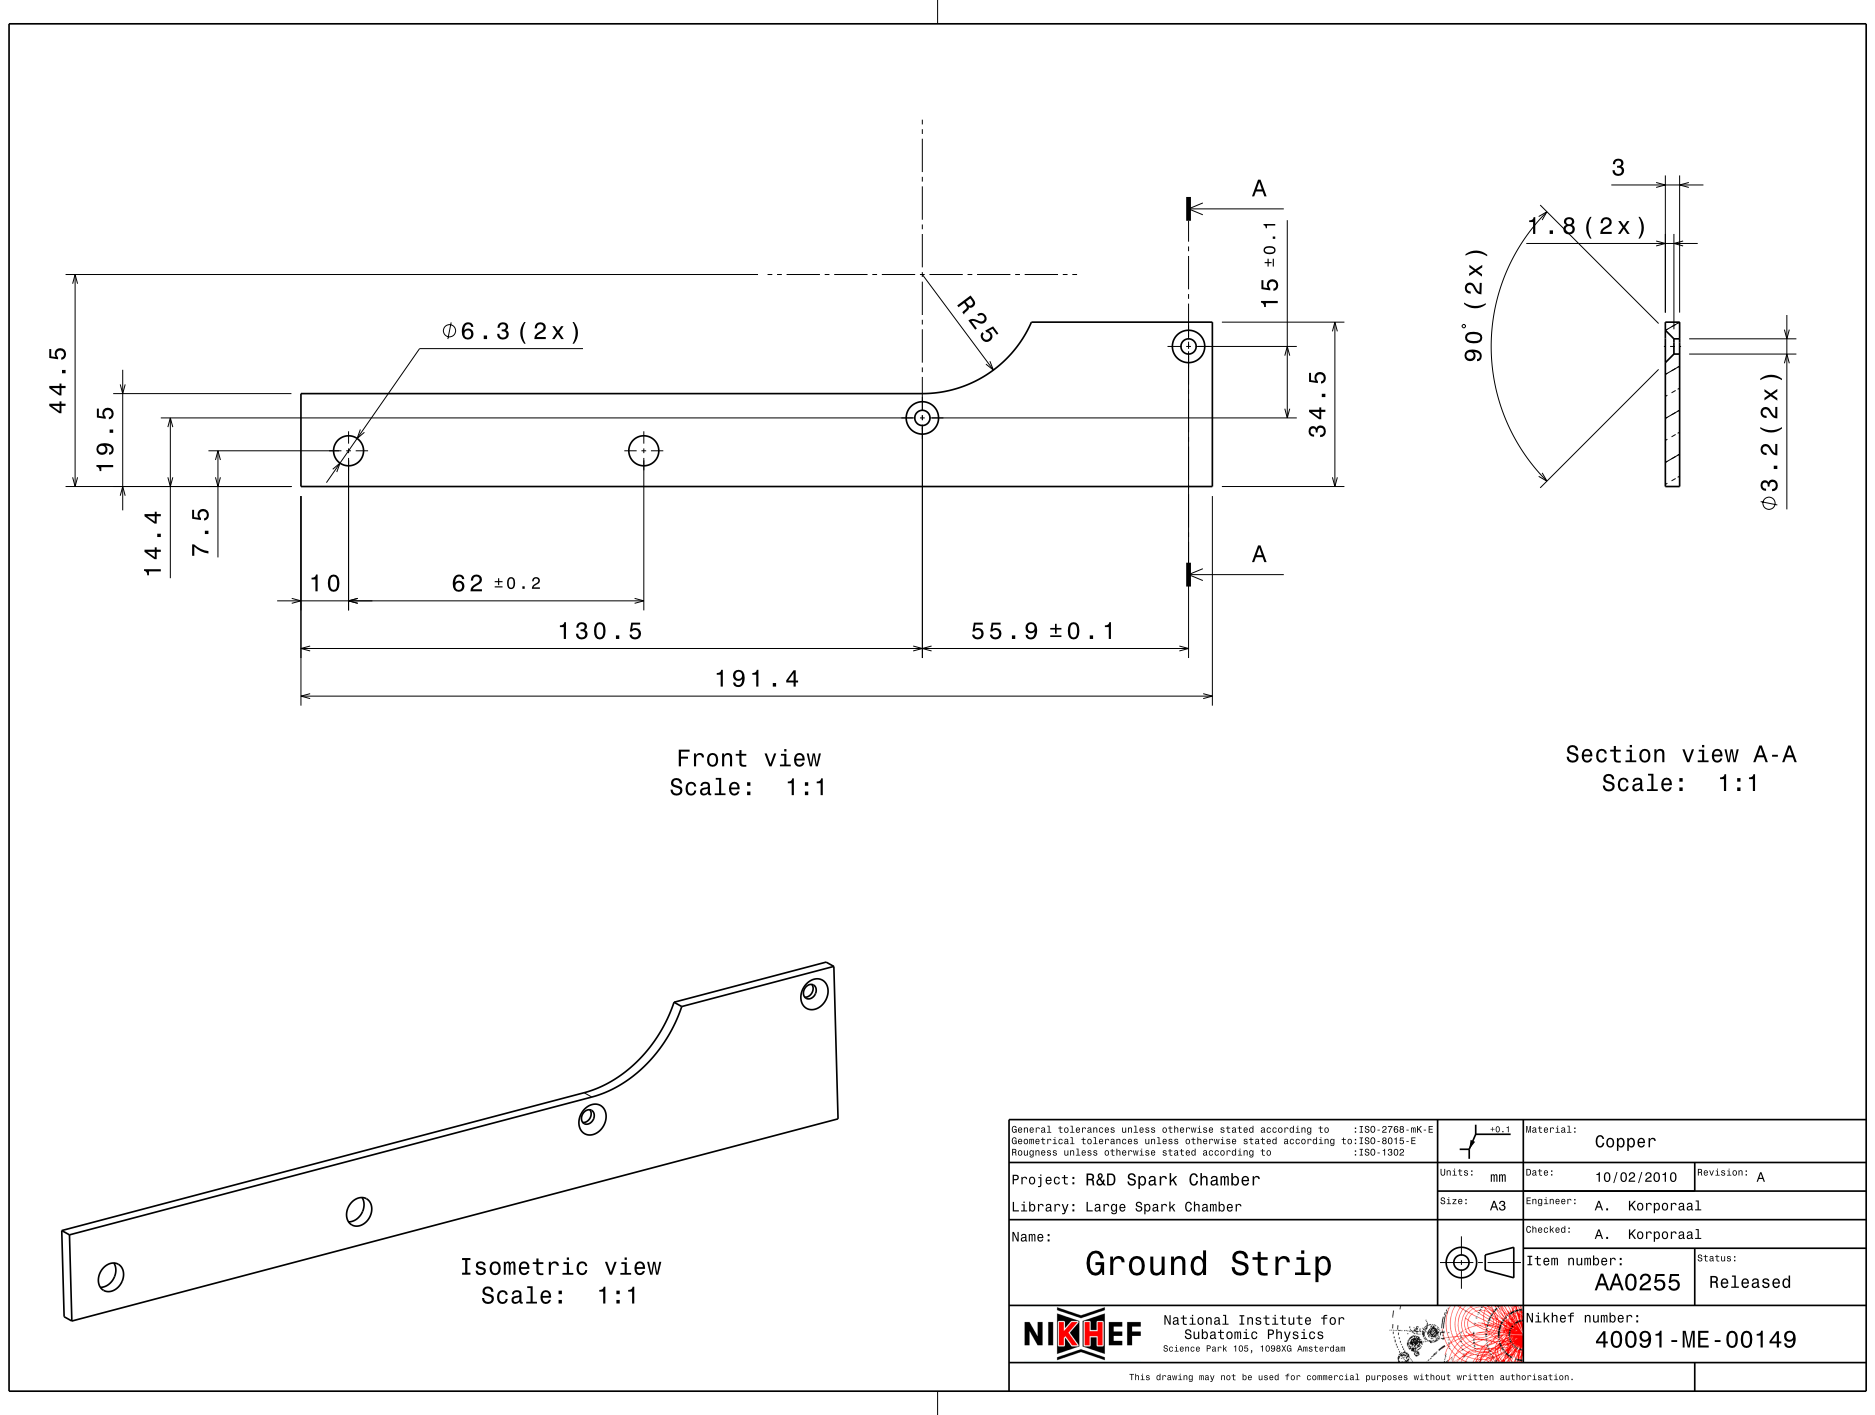
[picture p48: page 1]
