chrisgilmerproj/spark_chamber/Spark Chamber Large/HV Bus 1_AA0257_A.pdf

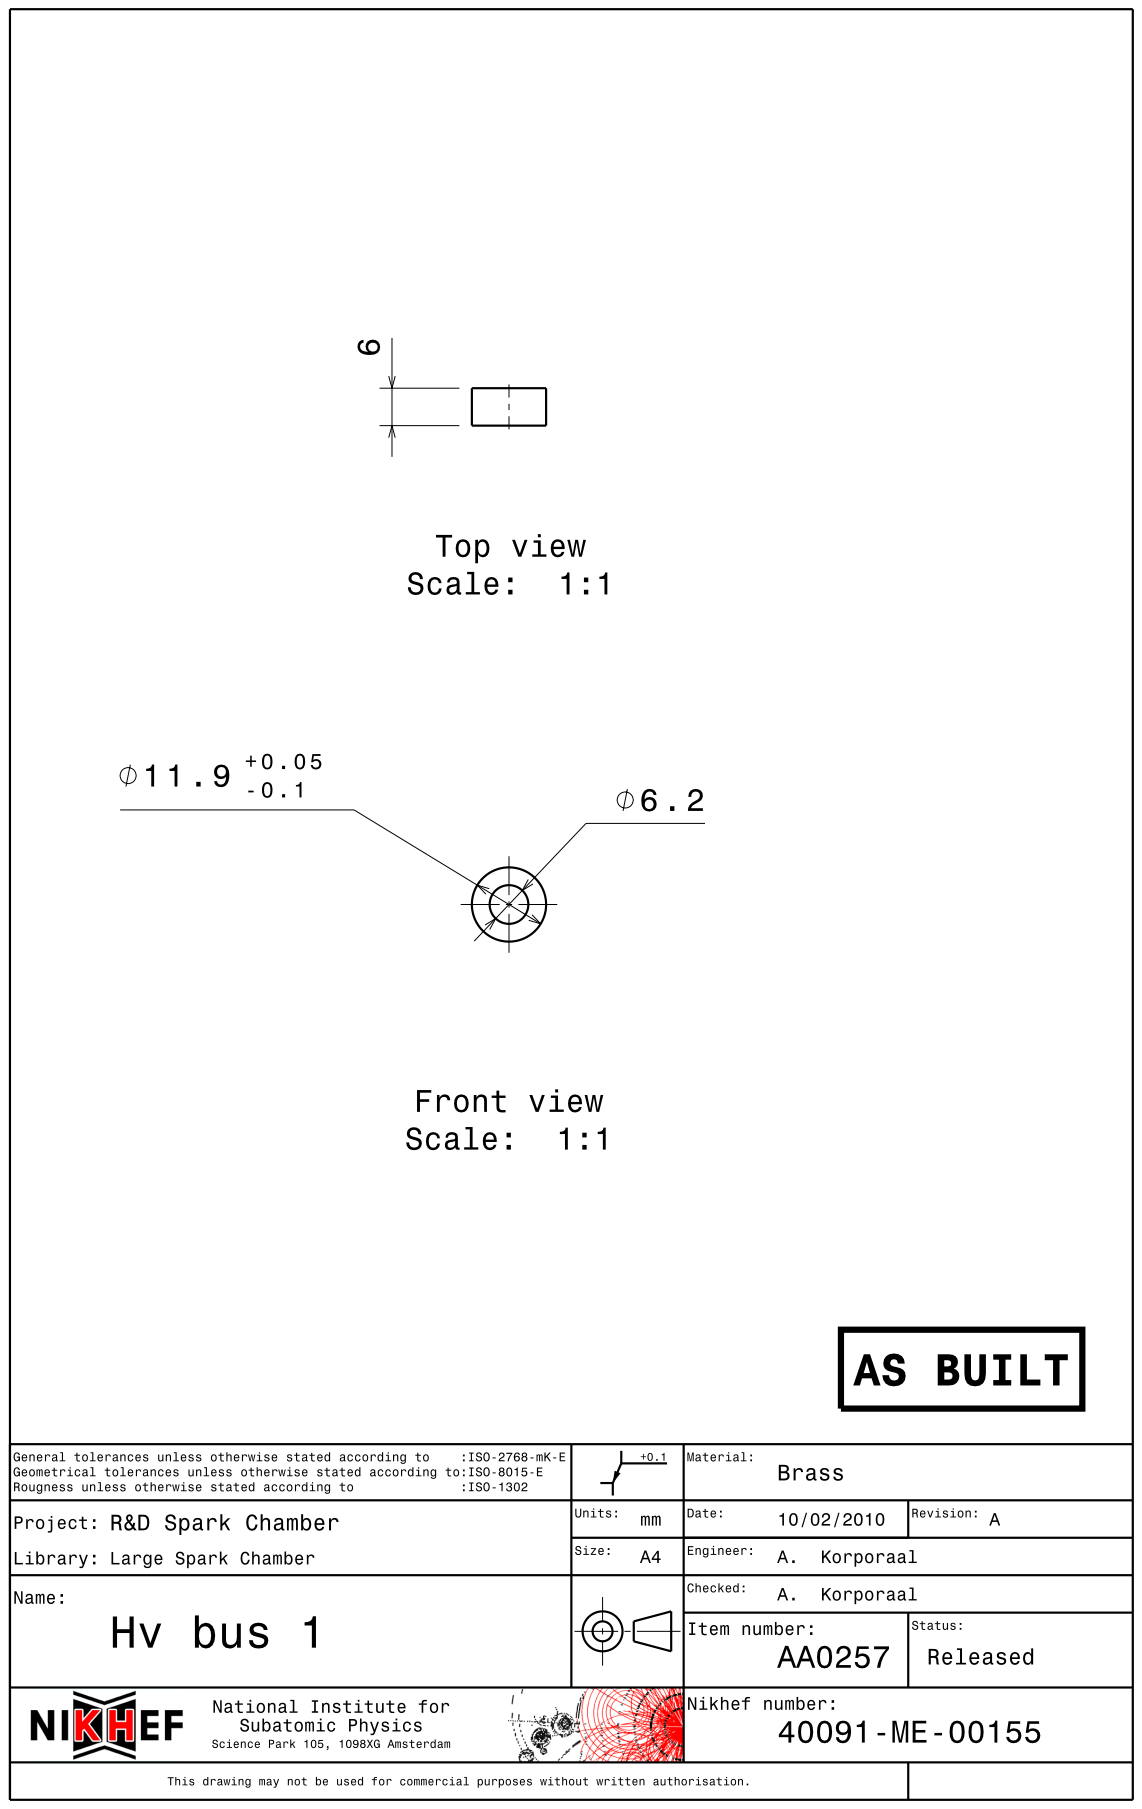
[picture p49: page 1]
