chrisgilmerproj/spark_chamber/Spark Chamber Large/HV Strip 1_AA0256_A.pdf

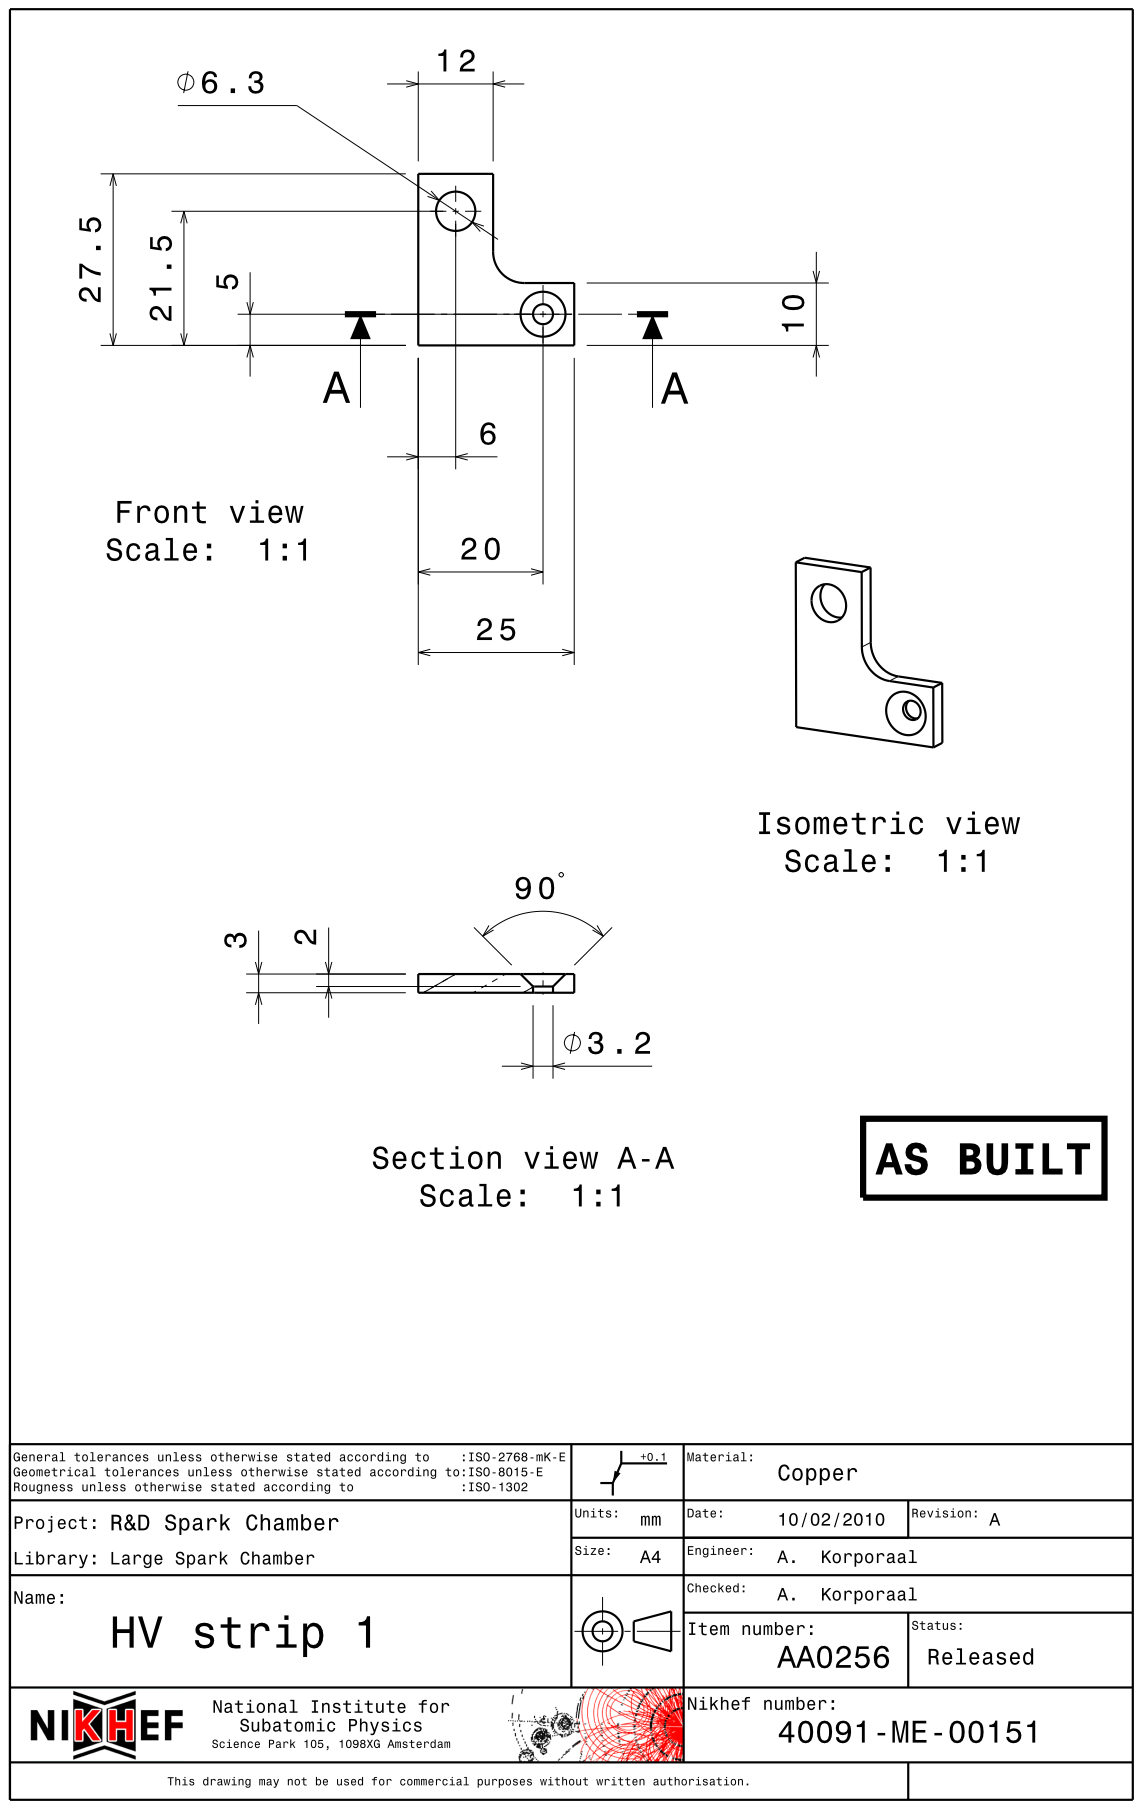
[picture p50: page 1]
