chrisgilmerproj/spark_chamber/Spark Chamber Large/Insulator Plate_AA0252_A.pdf

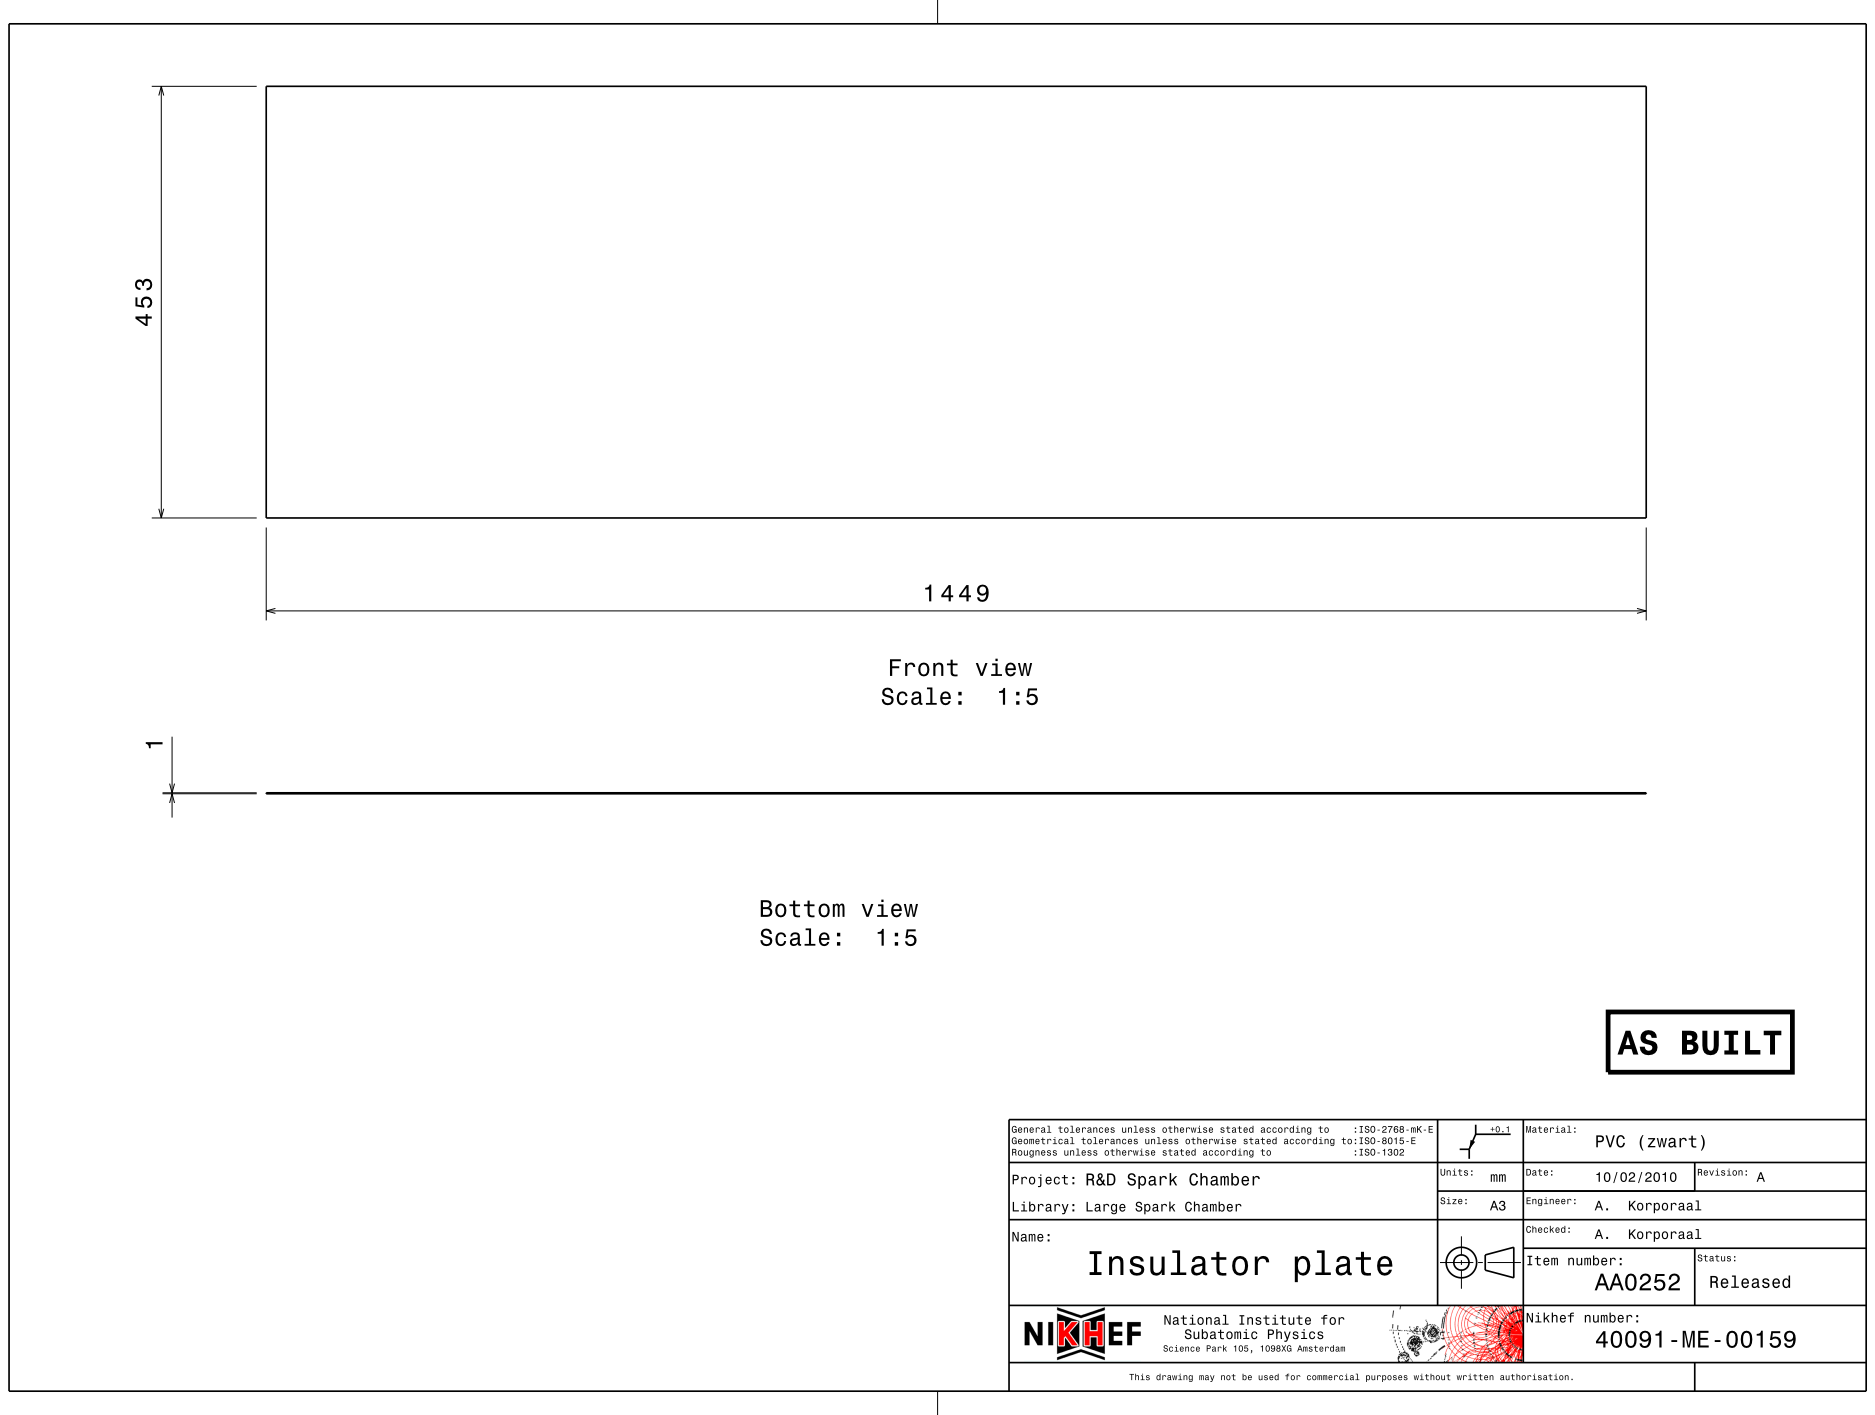
[picture p51: page 1]
