chrisgilmerproj/spark_chamber/Spark Chamber Large/Lower Electrode Plate_AA0265_A.pdf

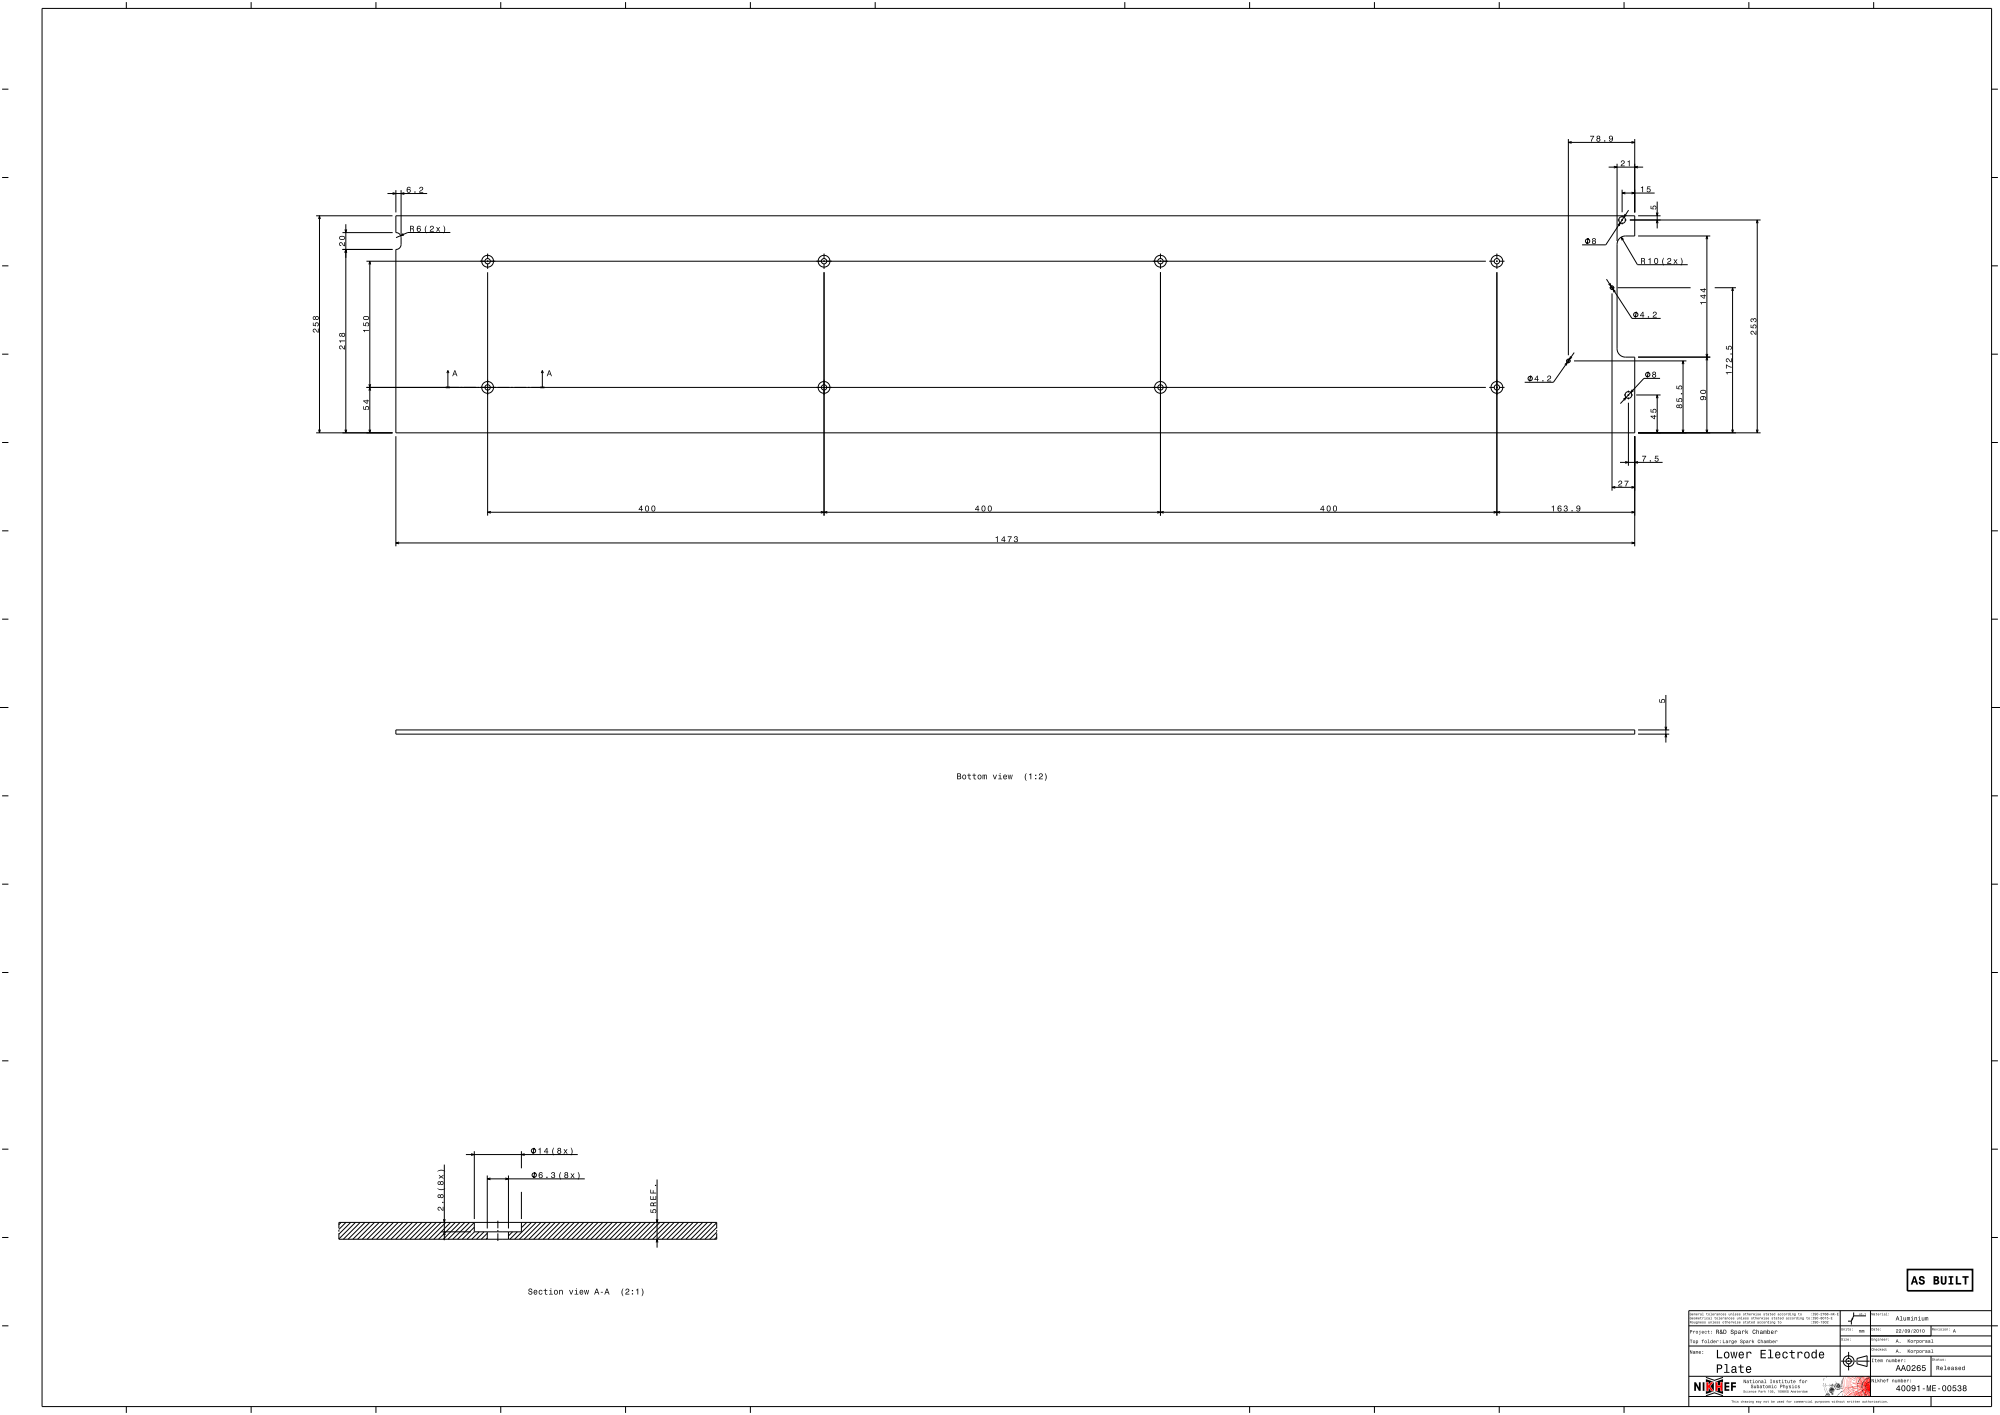
[picture p52: page 1]
