chrisgilmerproj/spark_chamber/Spark Chamber Large/Lower Turnplate_AA0270_A.pdf

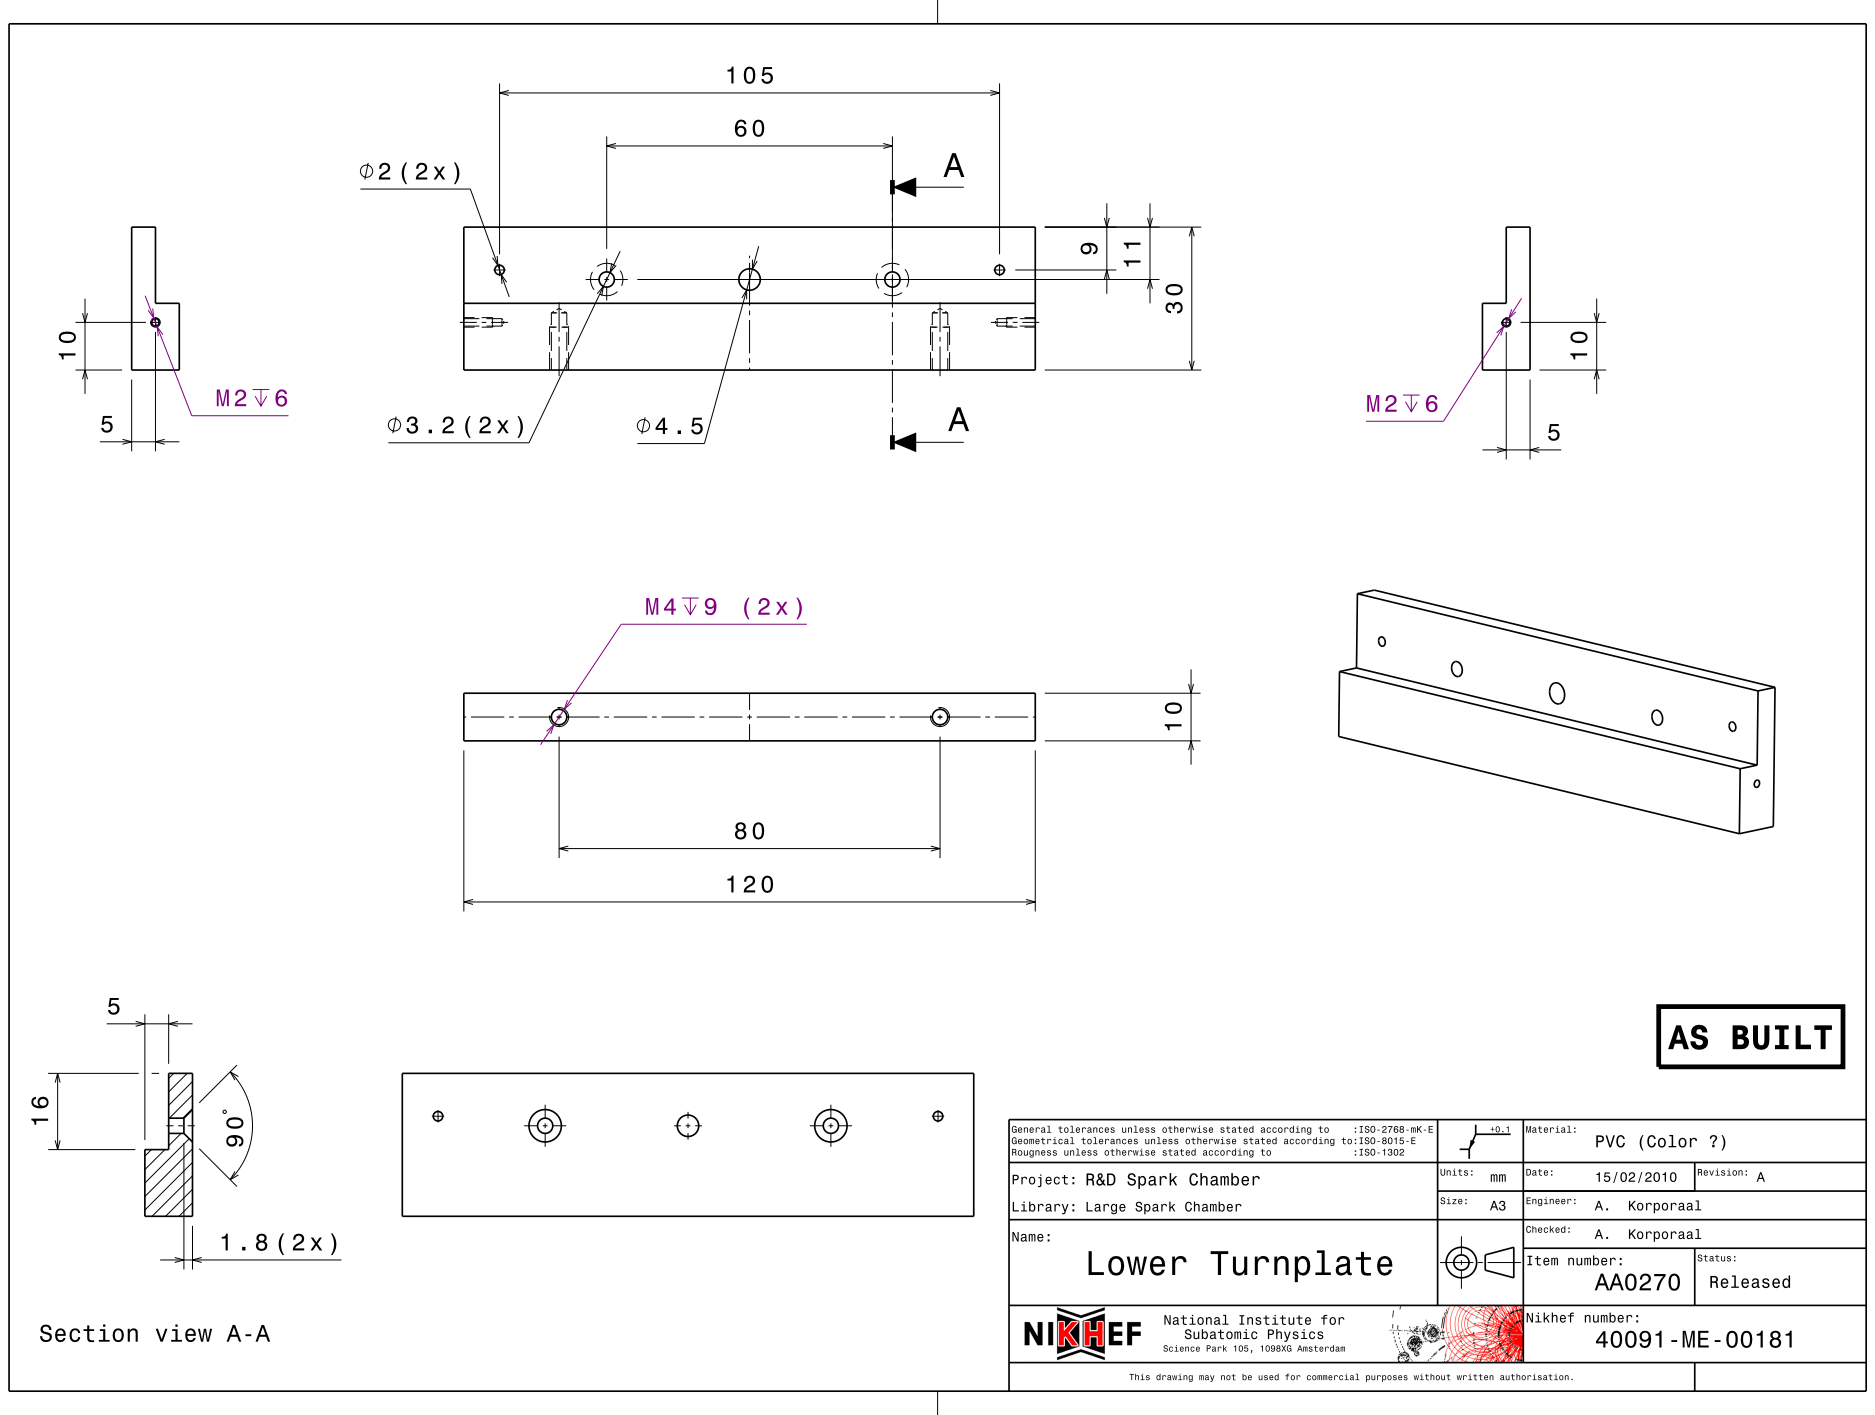
[picture p53: page 1]
