chrisgilmerproj/spark_chamber/Spark Chamber Large/Patch Panel Support_AA0302_A.pdf

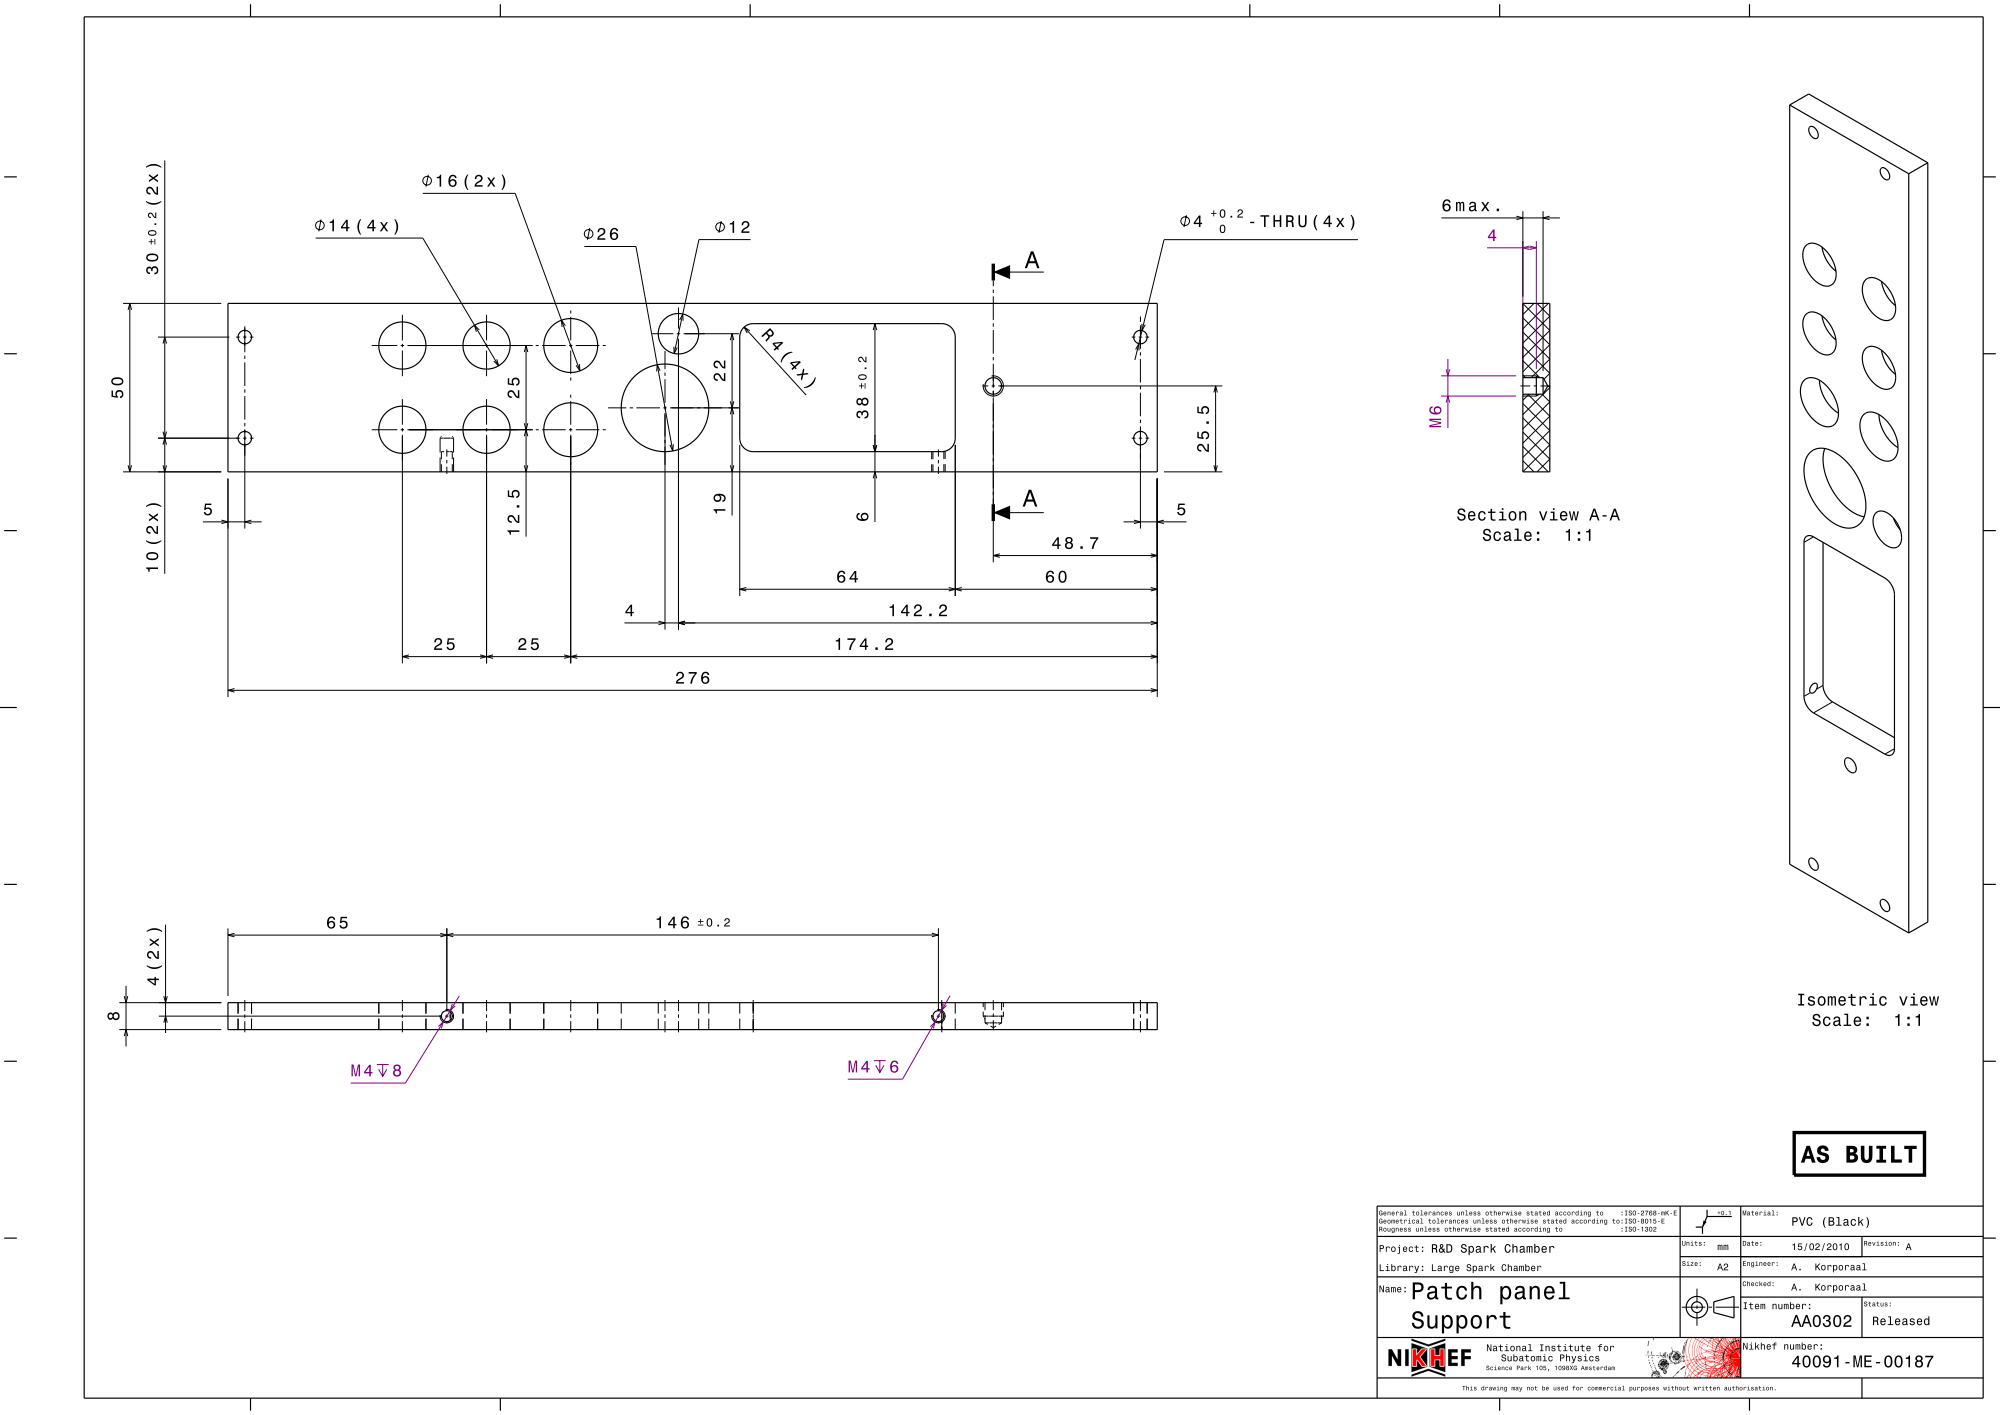
[picture p54: page 1]
