chrisgilmerproj/spark_chamber/Spark Chamber Large/Patch Panel_AA0303_A.pdf

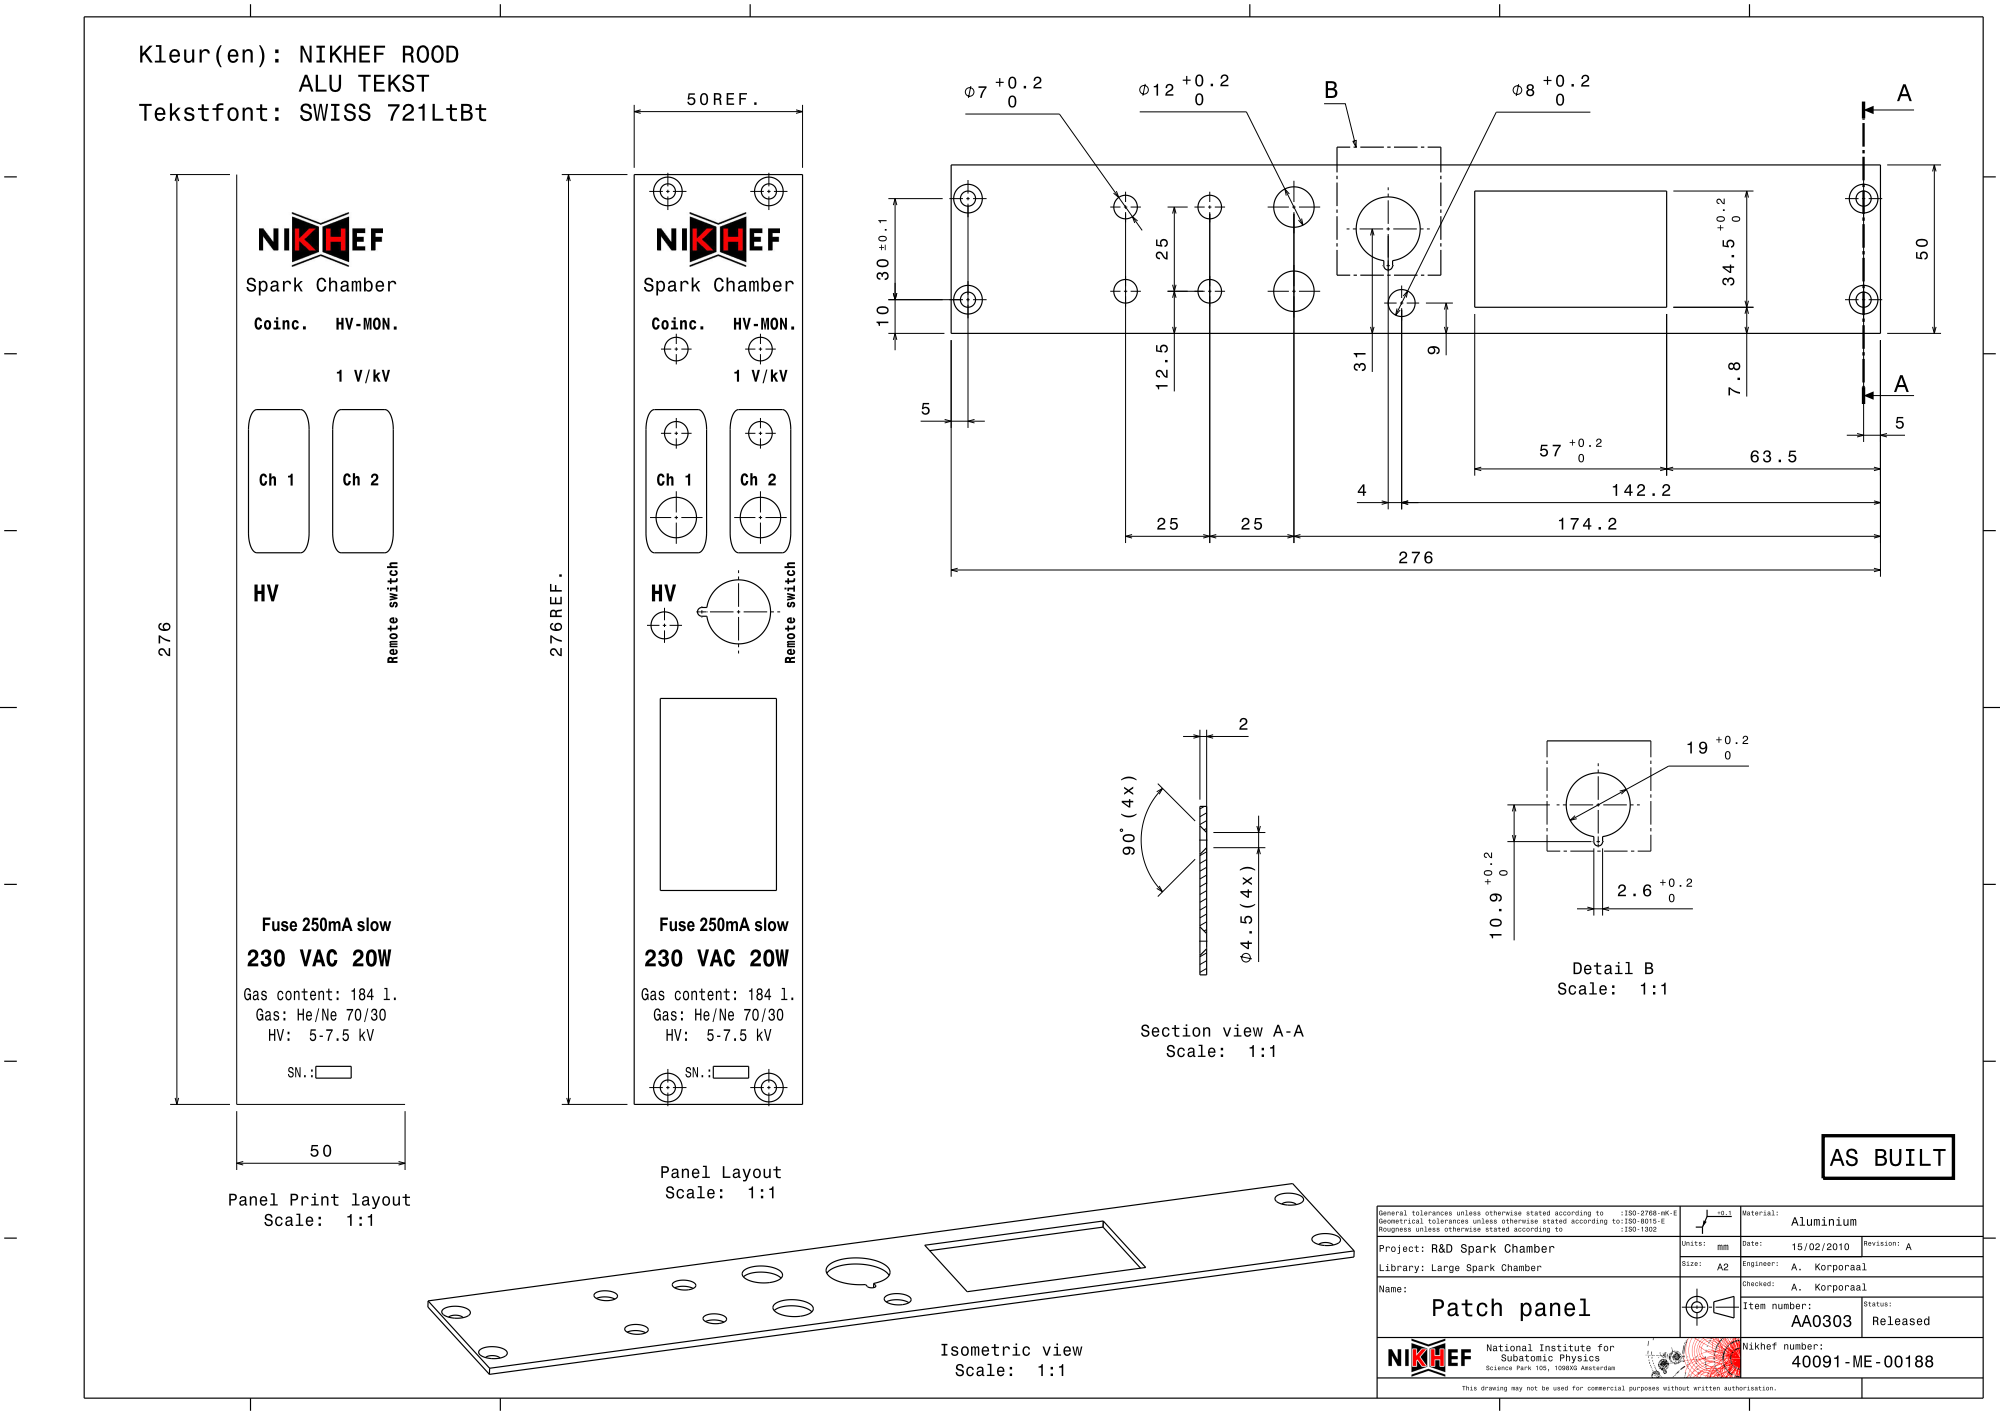
[picture p55: page 1]
