chrisgilmerproj/spark_chamber/Spark Chamber Large/Plate Clamp 1_AA0276_A.pdf

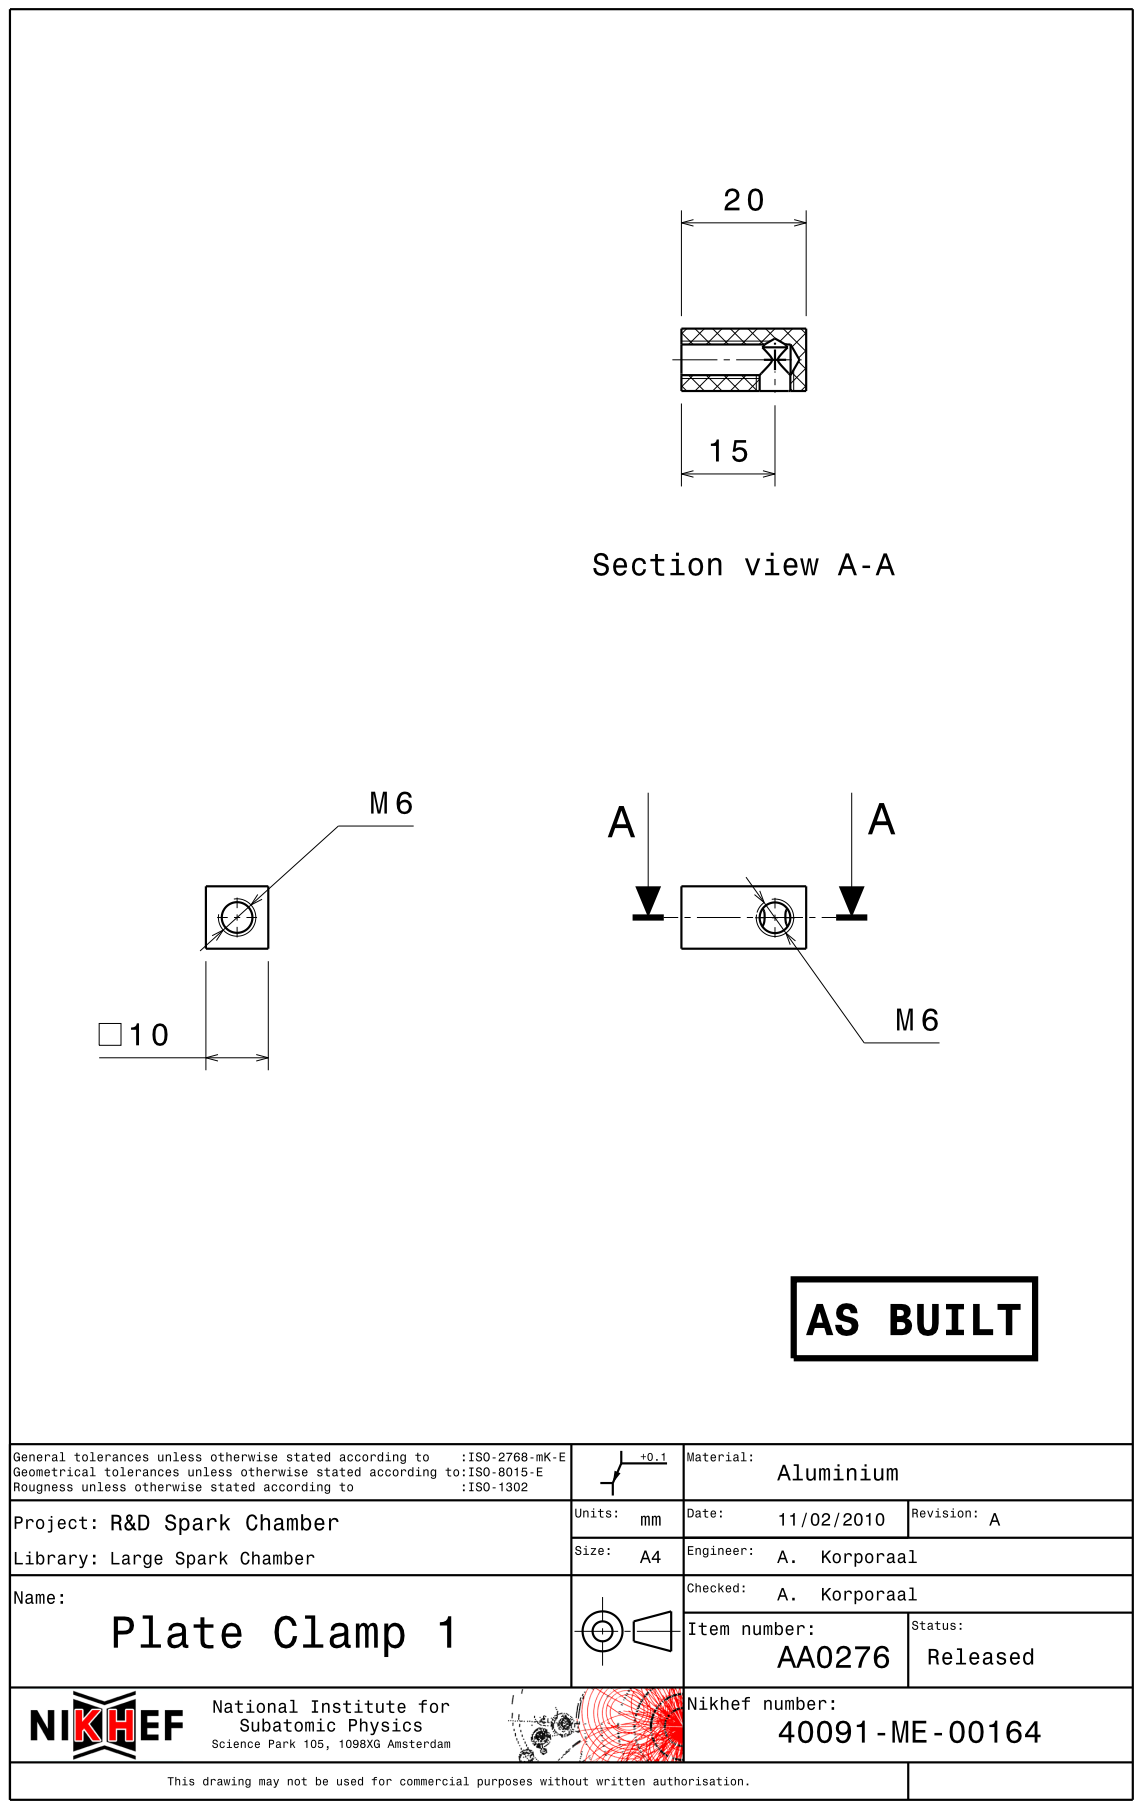
[picture p56: page 1]
