chrisgilmerproj/spark_chamber/Spark Chamber Large/Plate Clamp 2_AA0278_A.pdf

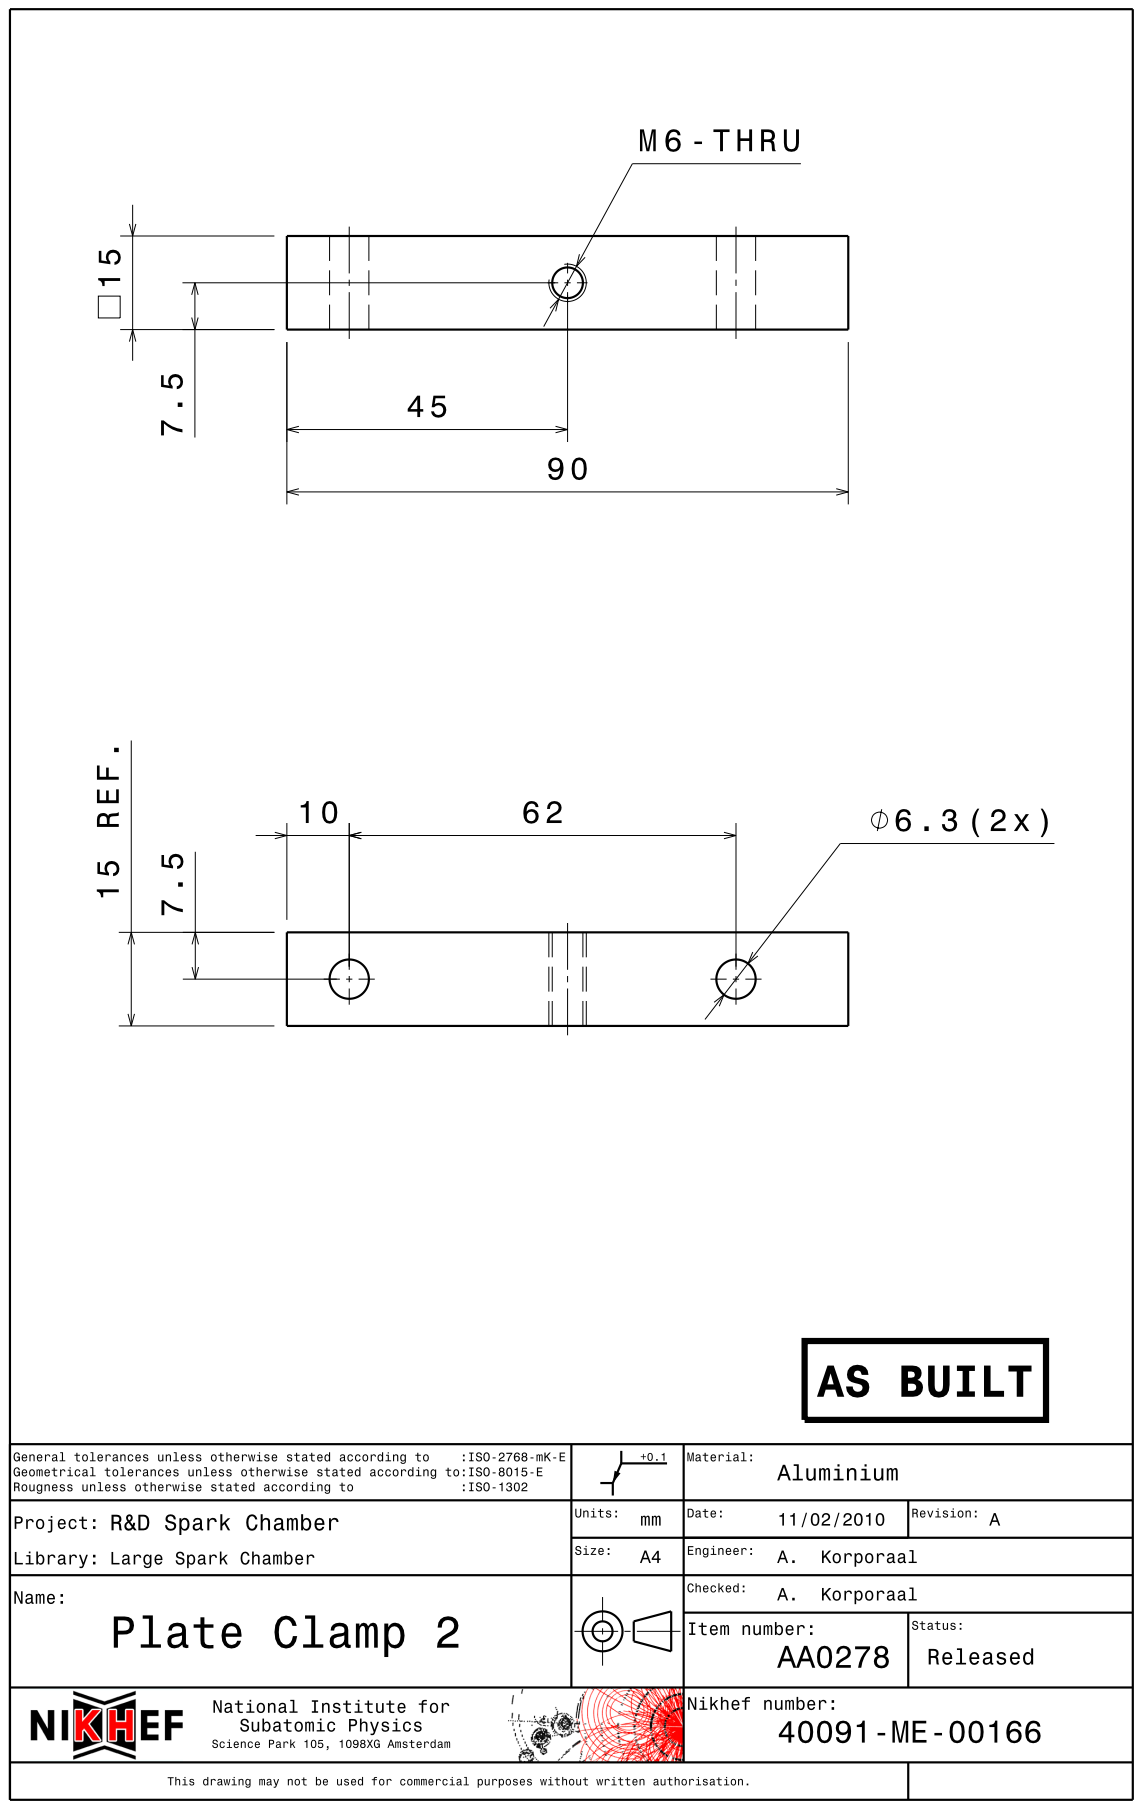
[picture p57: page 1]
