chrisgilmerproj/spark_chamber/Spark Chamber Large/Plate Clamp Ground_AA0277_A.pdf

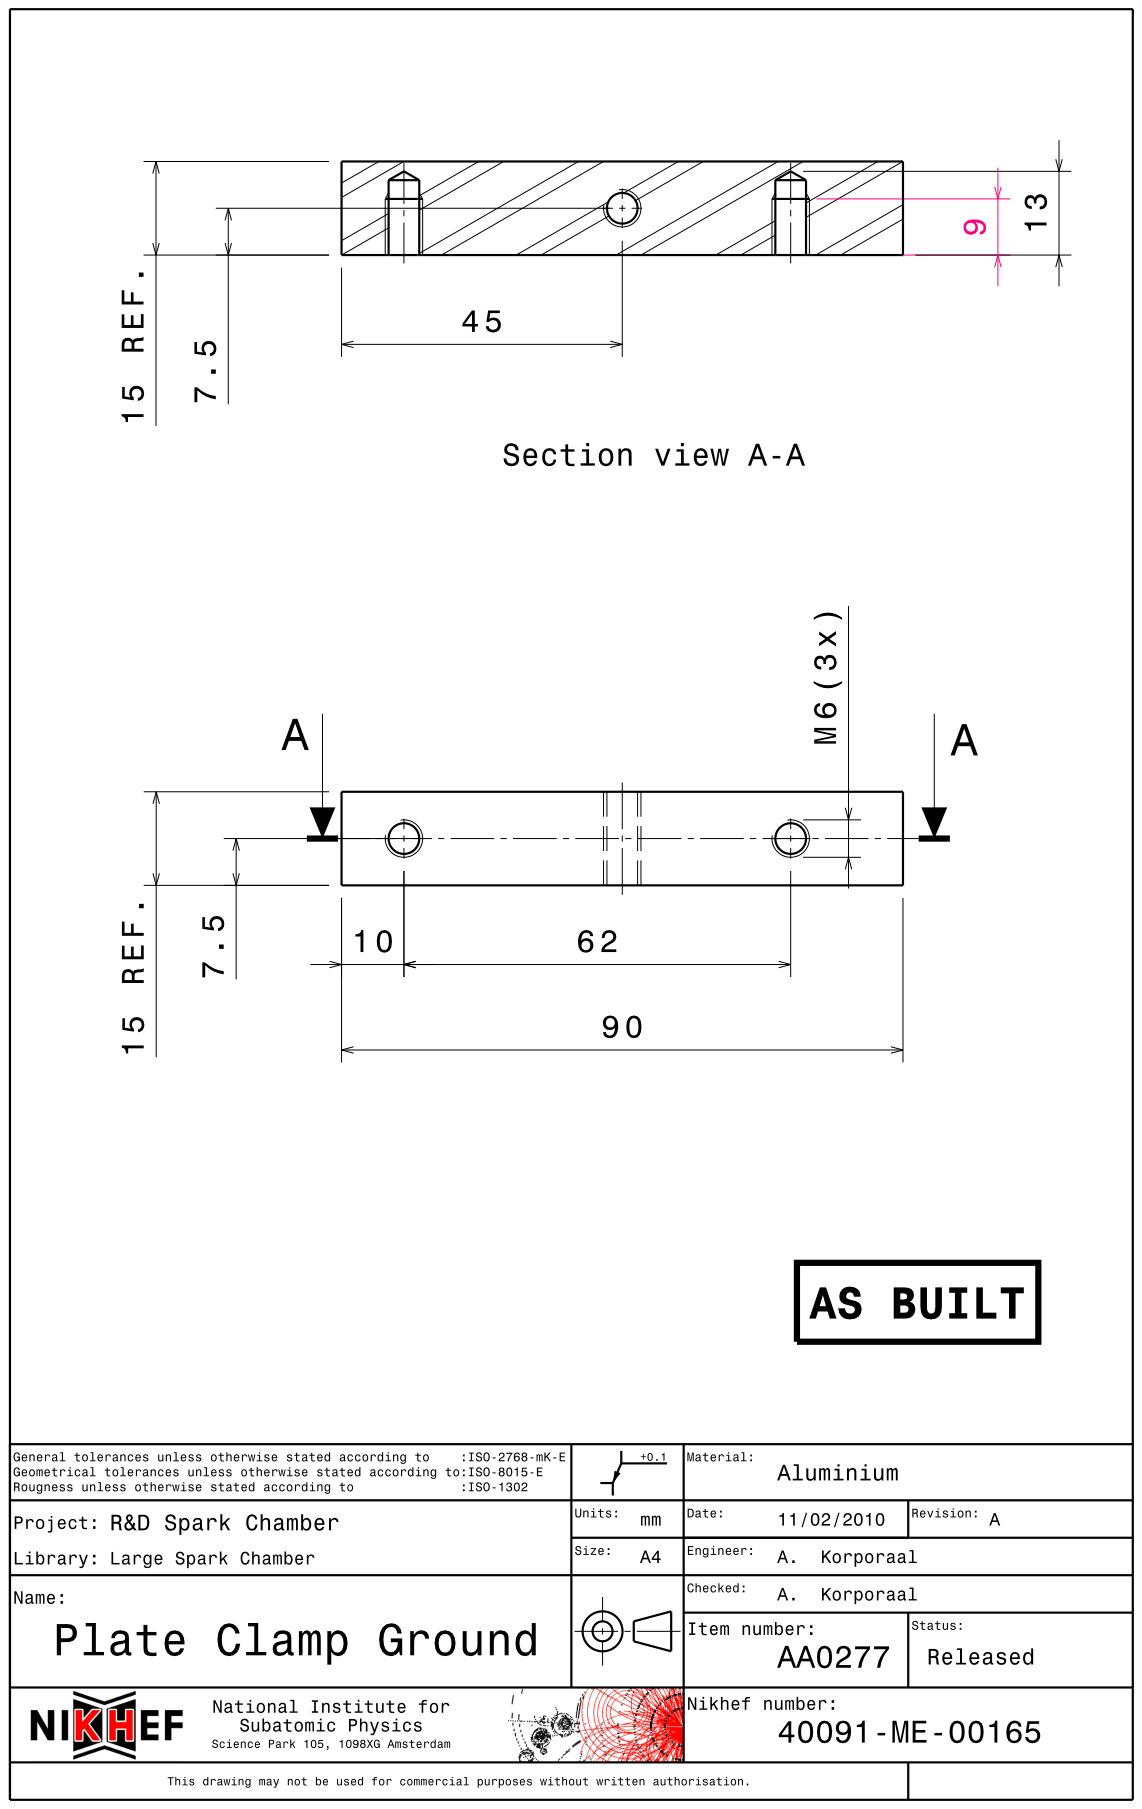
[picture p58: page 1]
