chrisgilmerproj/spark_chamber/Spark Chamber Large/Plate_Bolt_AA3923.pdf

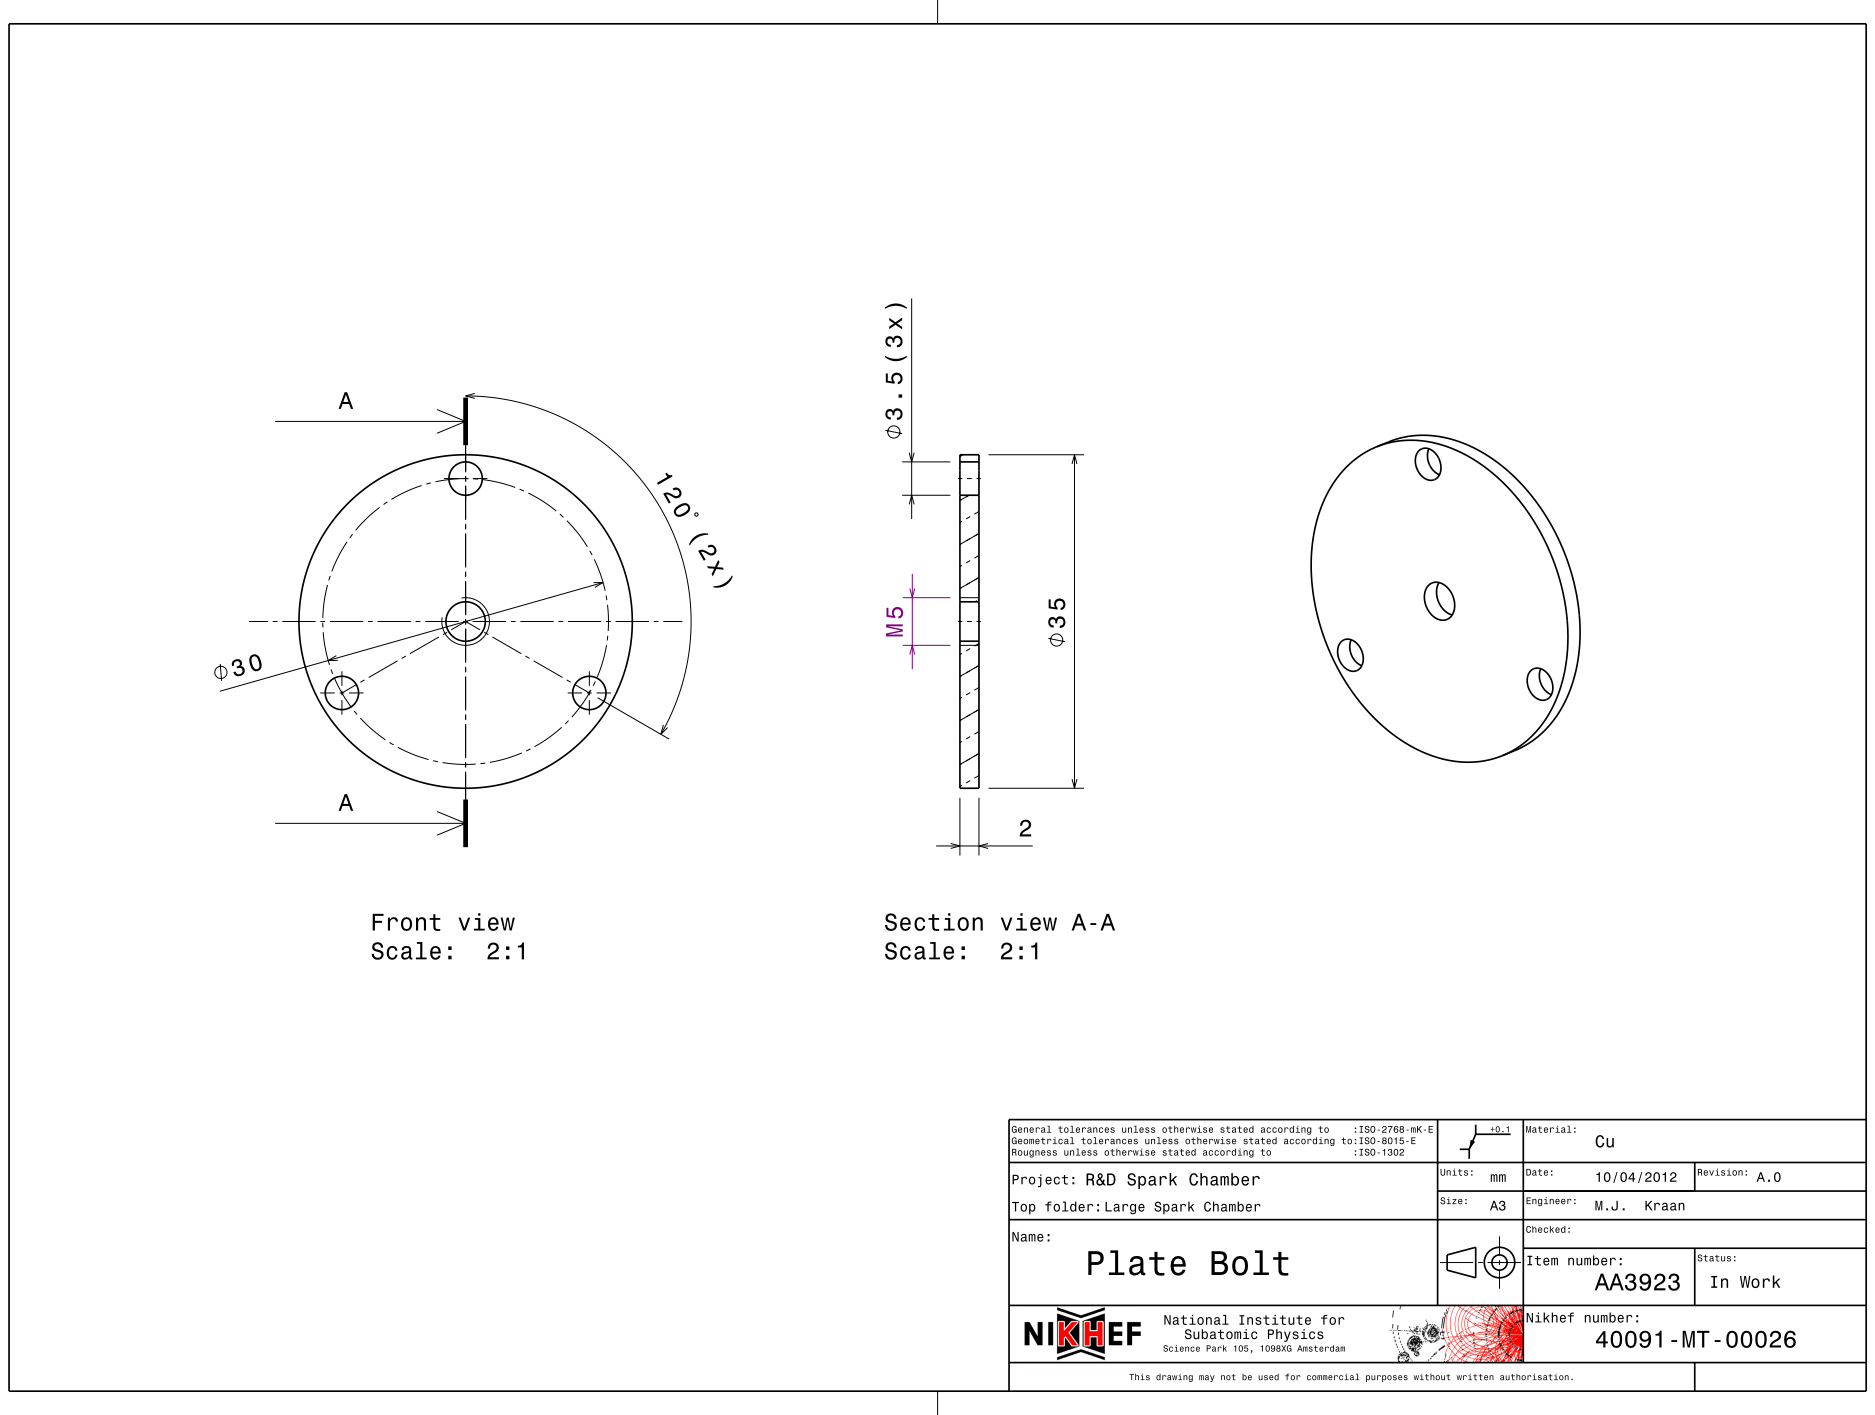
[picture p59: page 1]
