chrisgilmerproj/spark_chamber/Spark Chamber Large/Plate_Bougie_AA3924.pdf

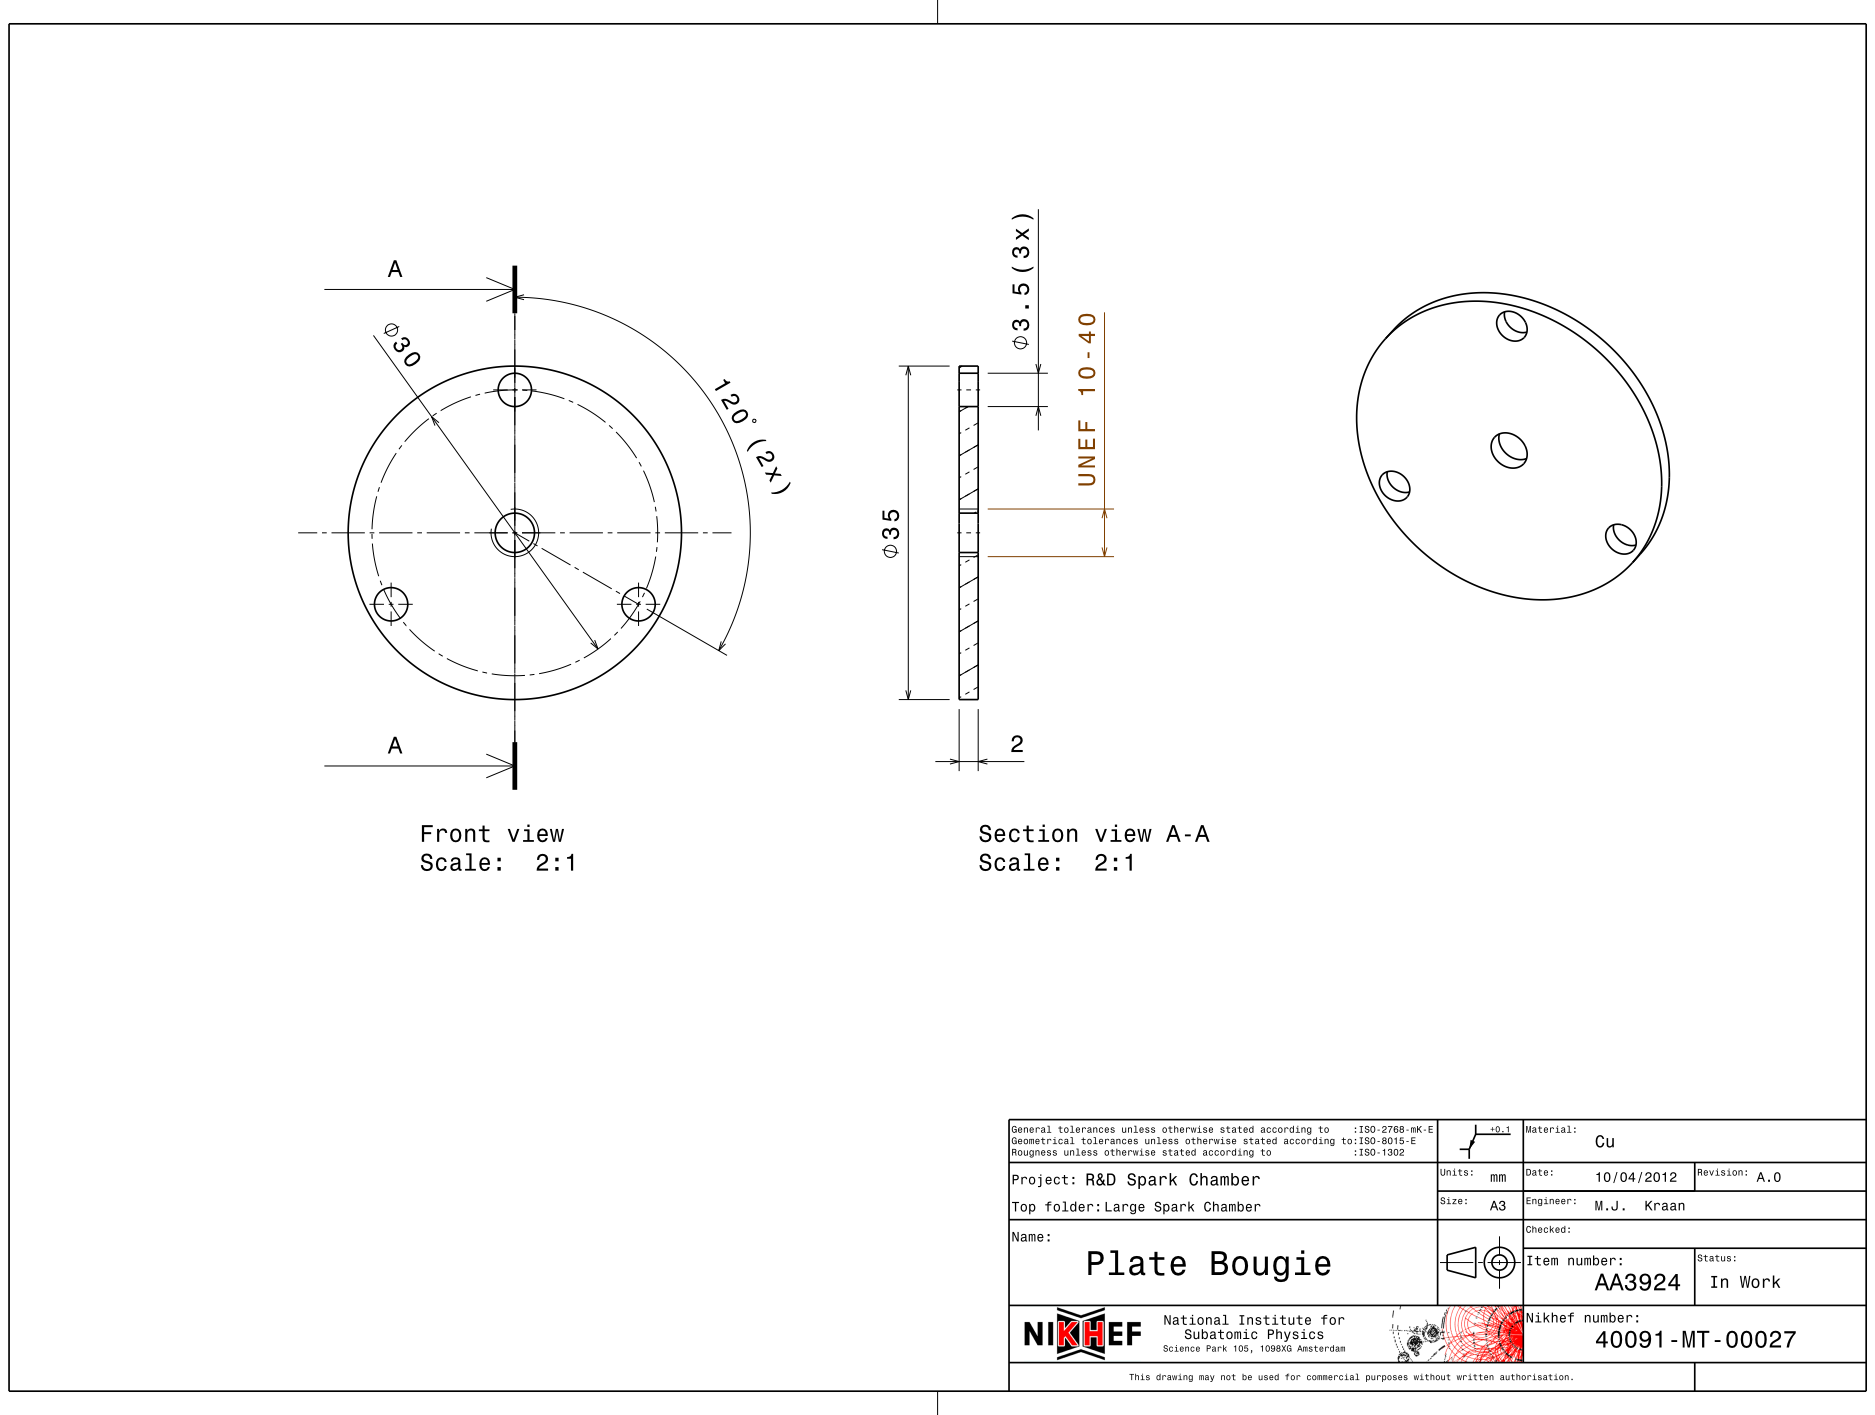
[picture p60: page 1]
