chrisgilmerproj/spark_chamber/Spark Chamber Large/Resistor Ground Strip 1_AA0275_A.pdf

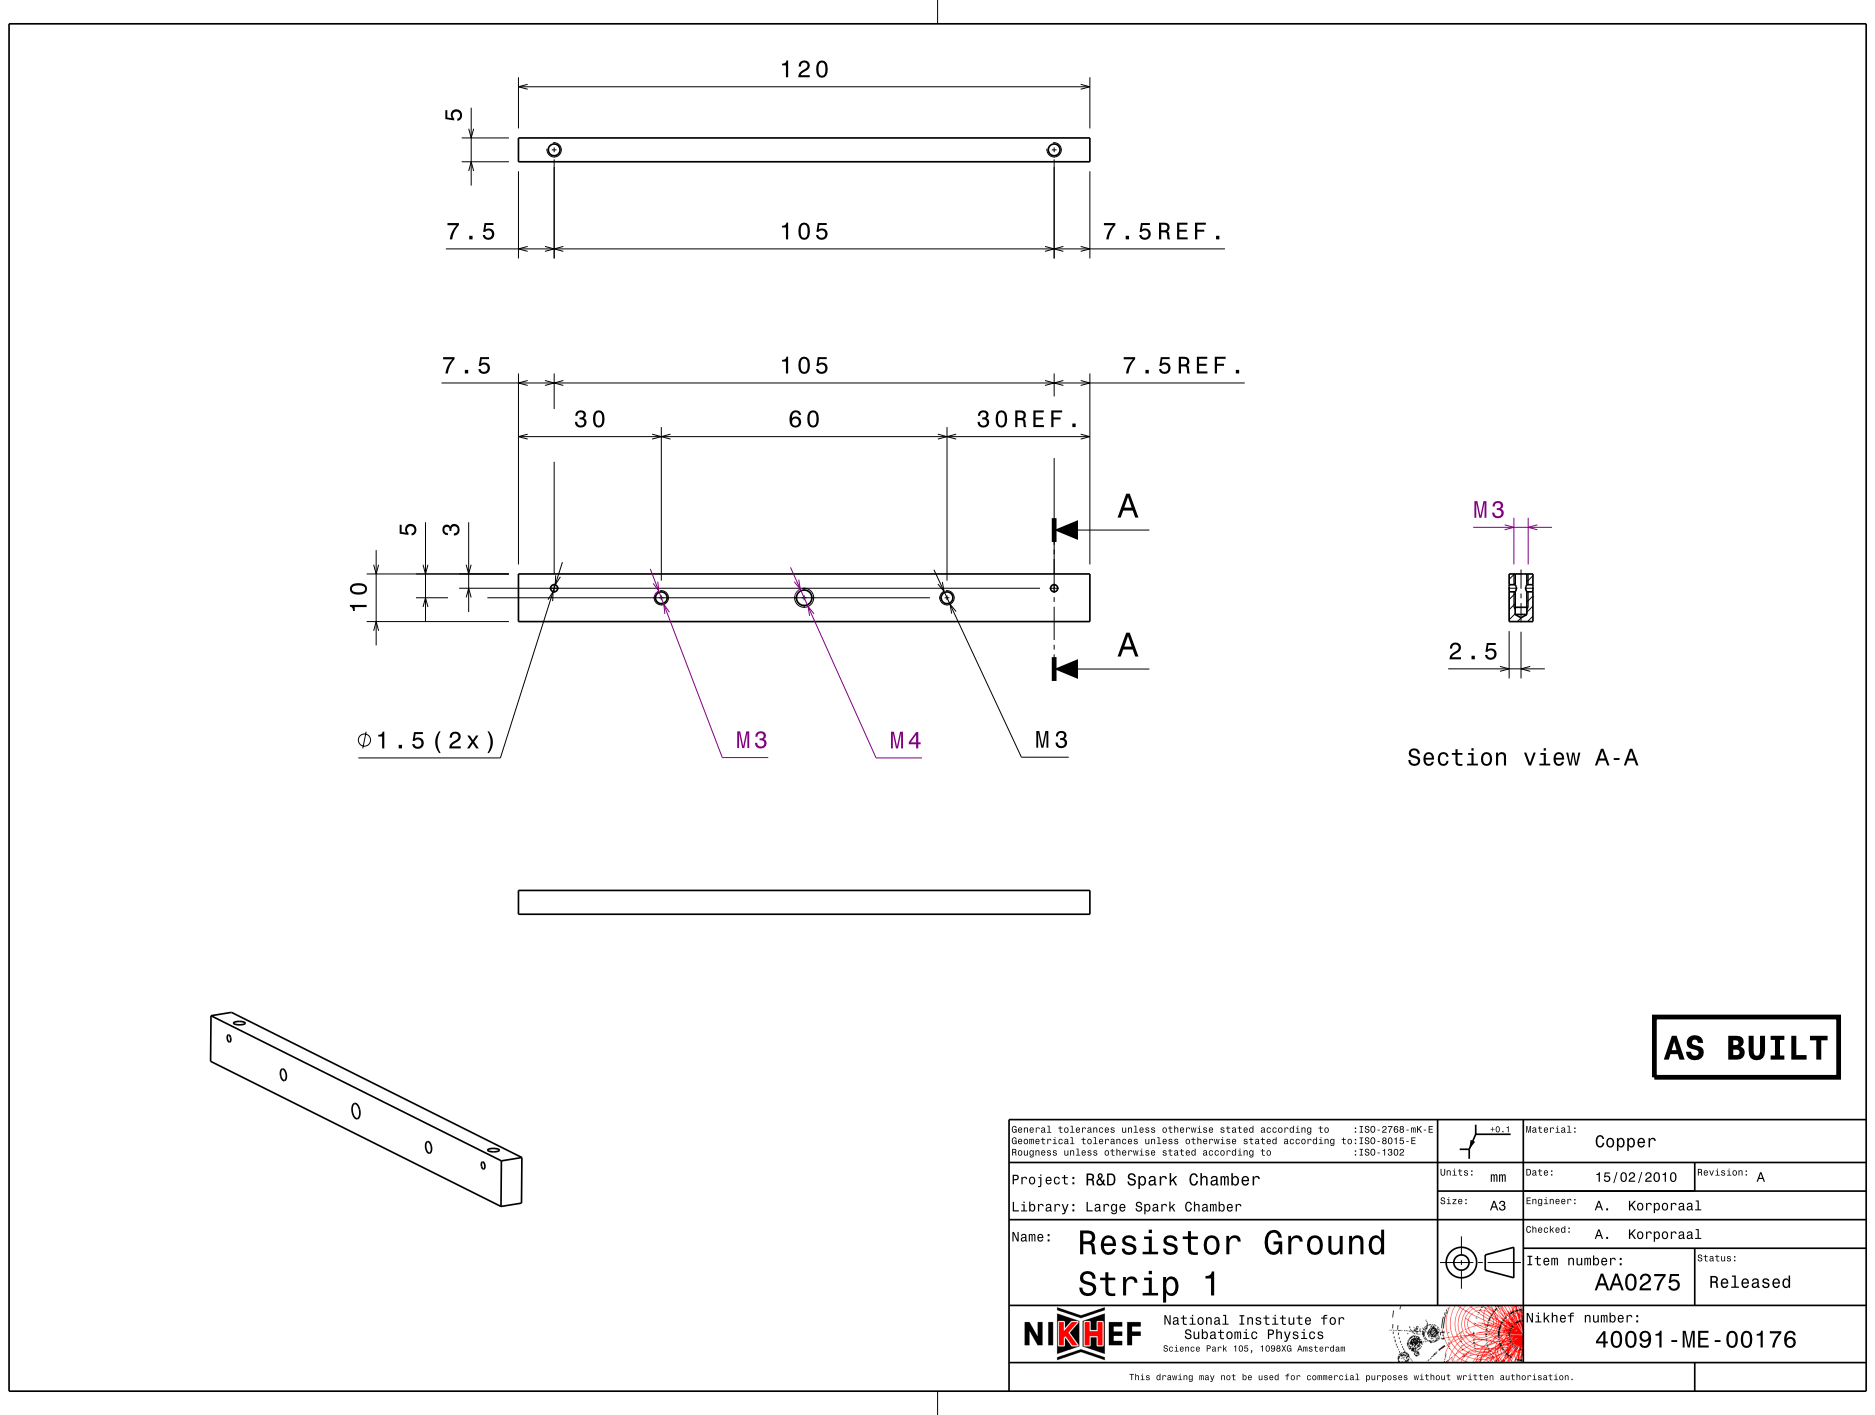
[picture p61: page 1]
