chrisgilmerproj/spark_chamber/Spark Chamber Large/Safety Clip 1_AA0259_A.pdf

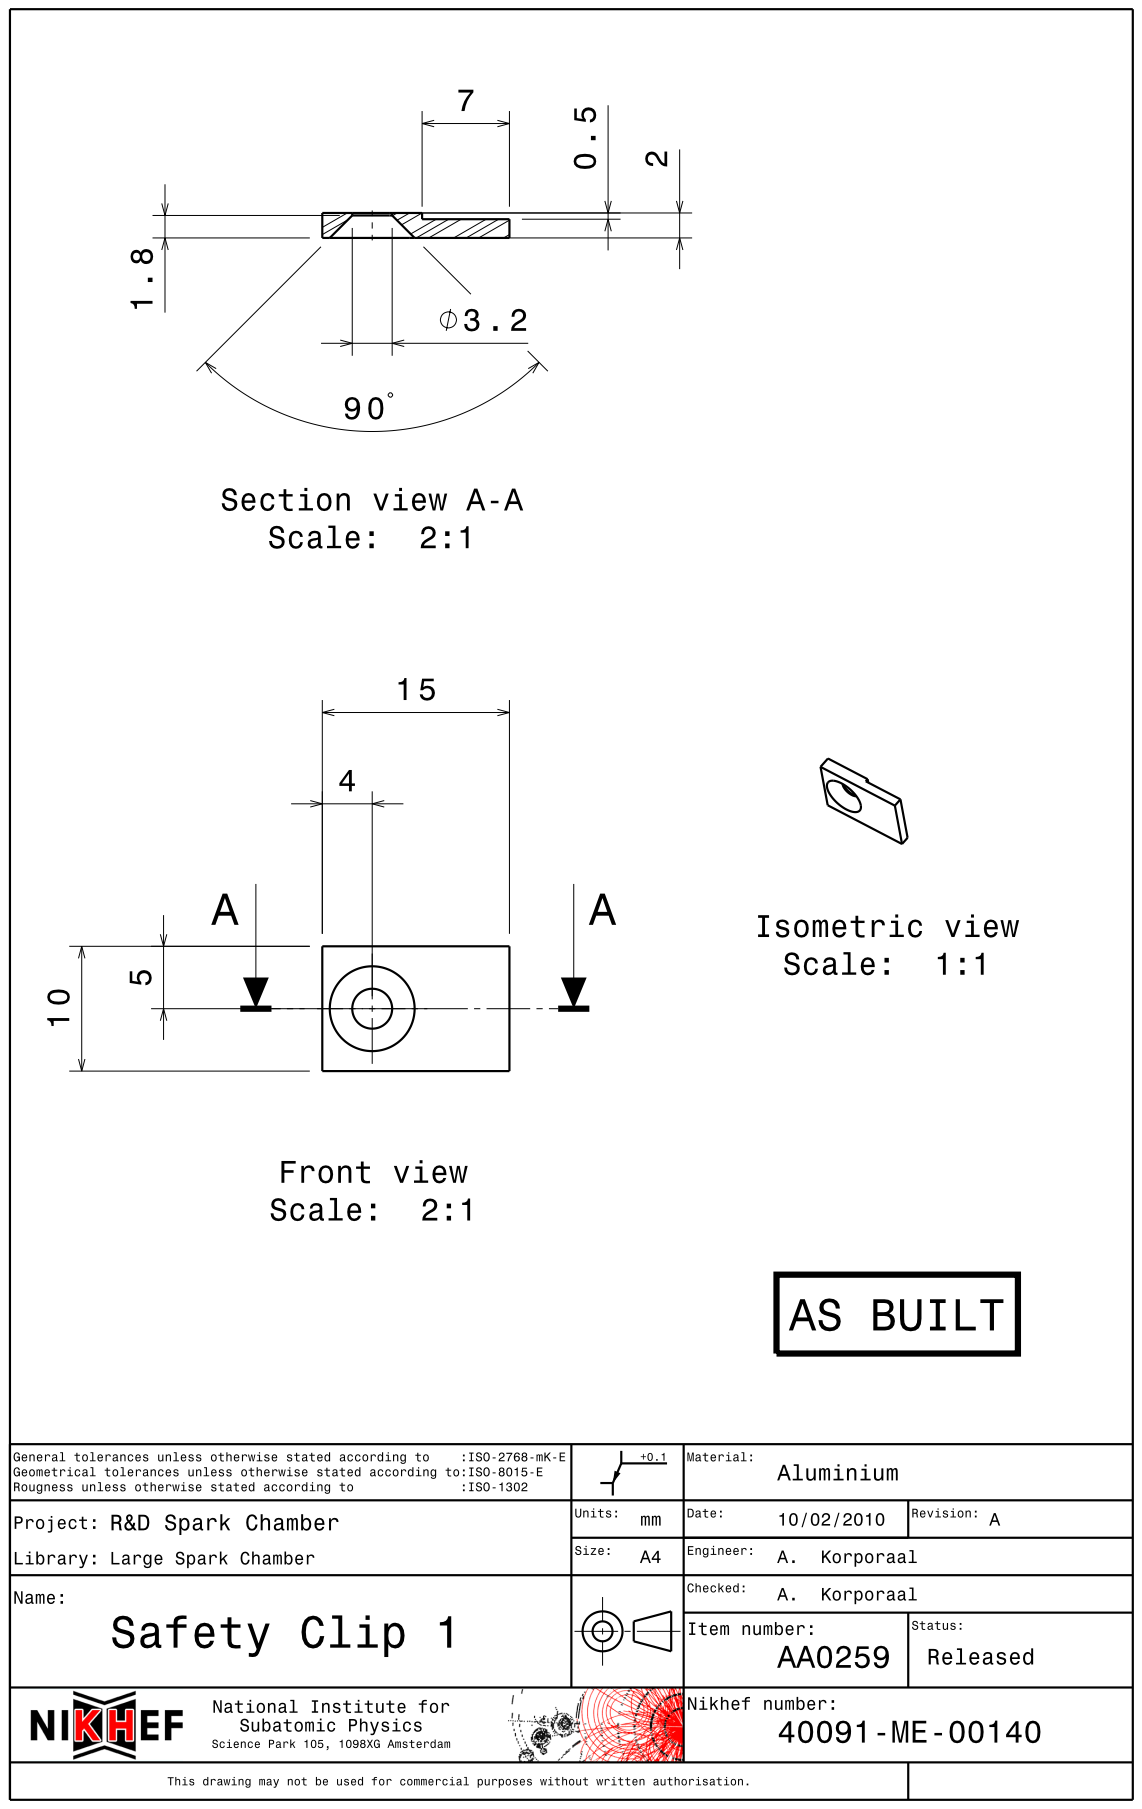
[picture p62: page 1]
