chrisgilmerproj/spark_chamber/Spark Chamber Large/Safety Clip 2_AA0260_A.pdf

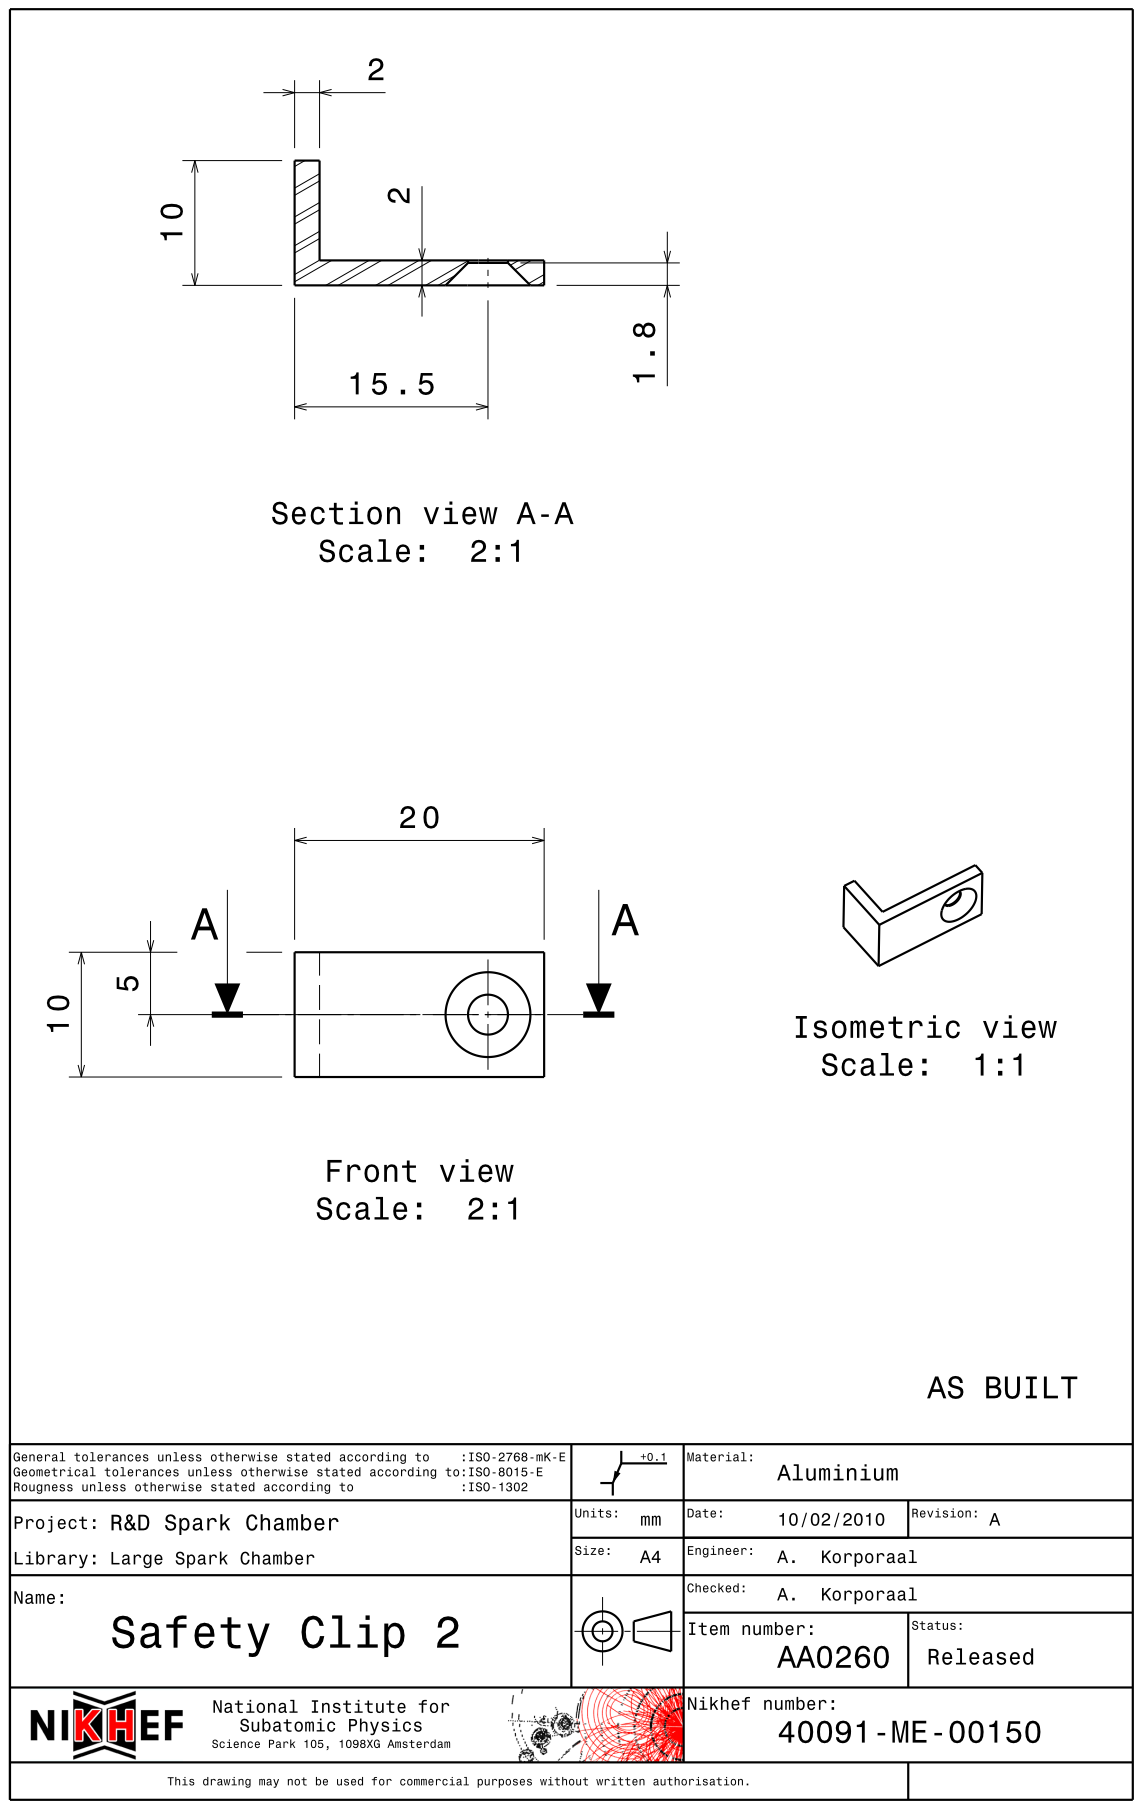
[picture p63: page 1]
