chrisgilmerproj/spark_chamber/Spark Chamber Large/Service Housing Cover_AA0305_A.pdf

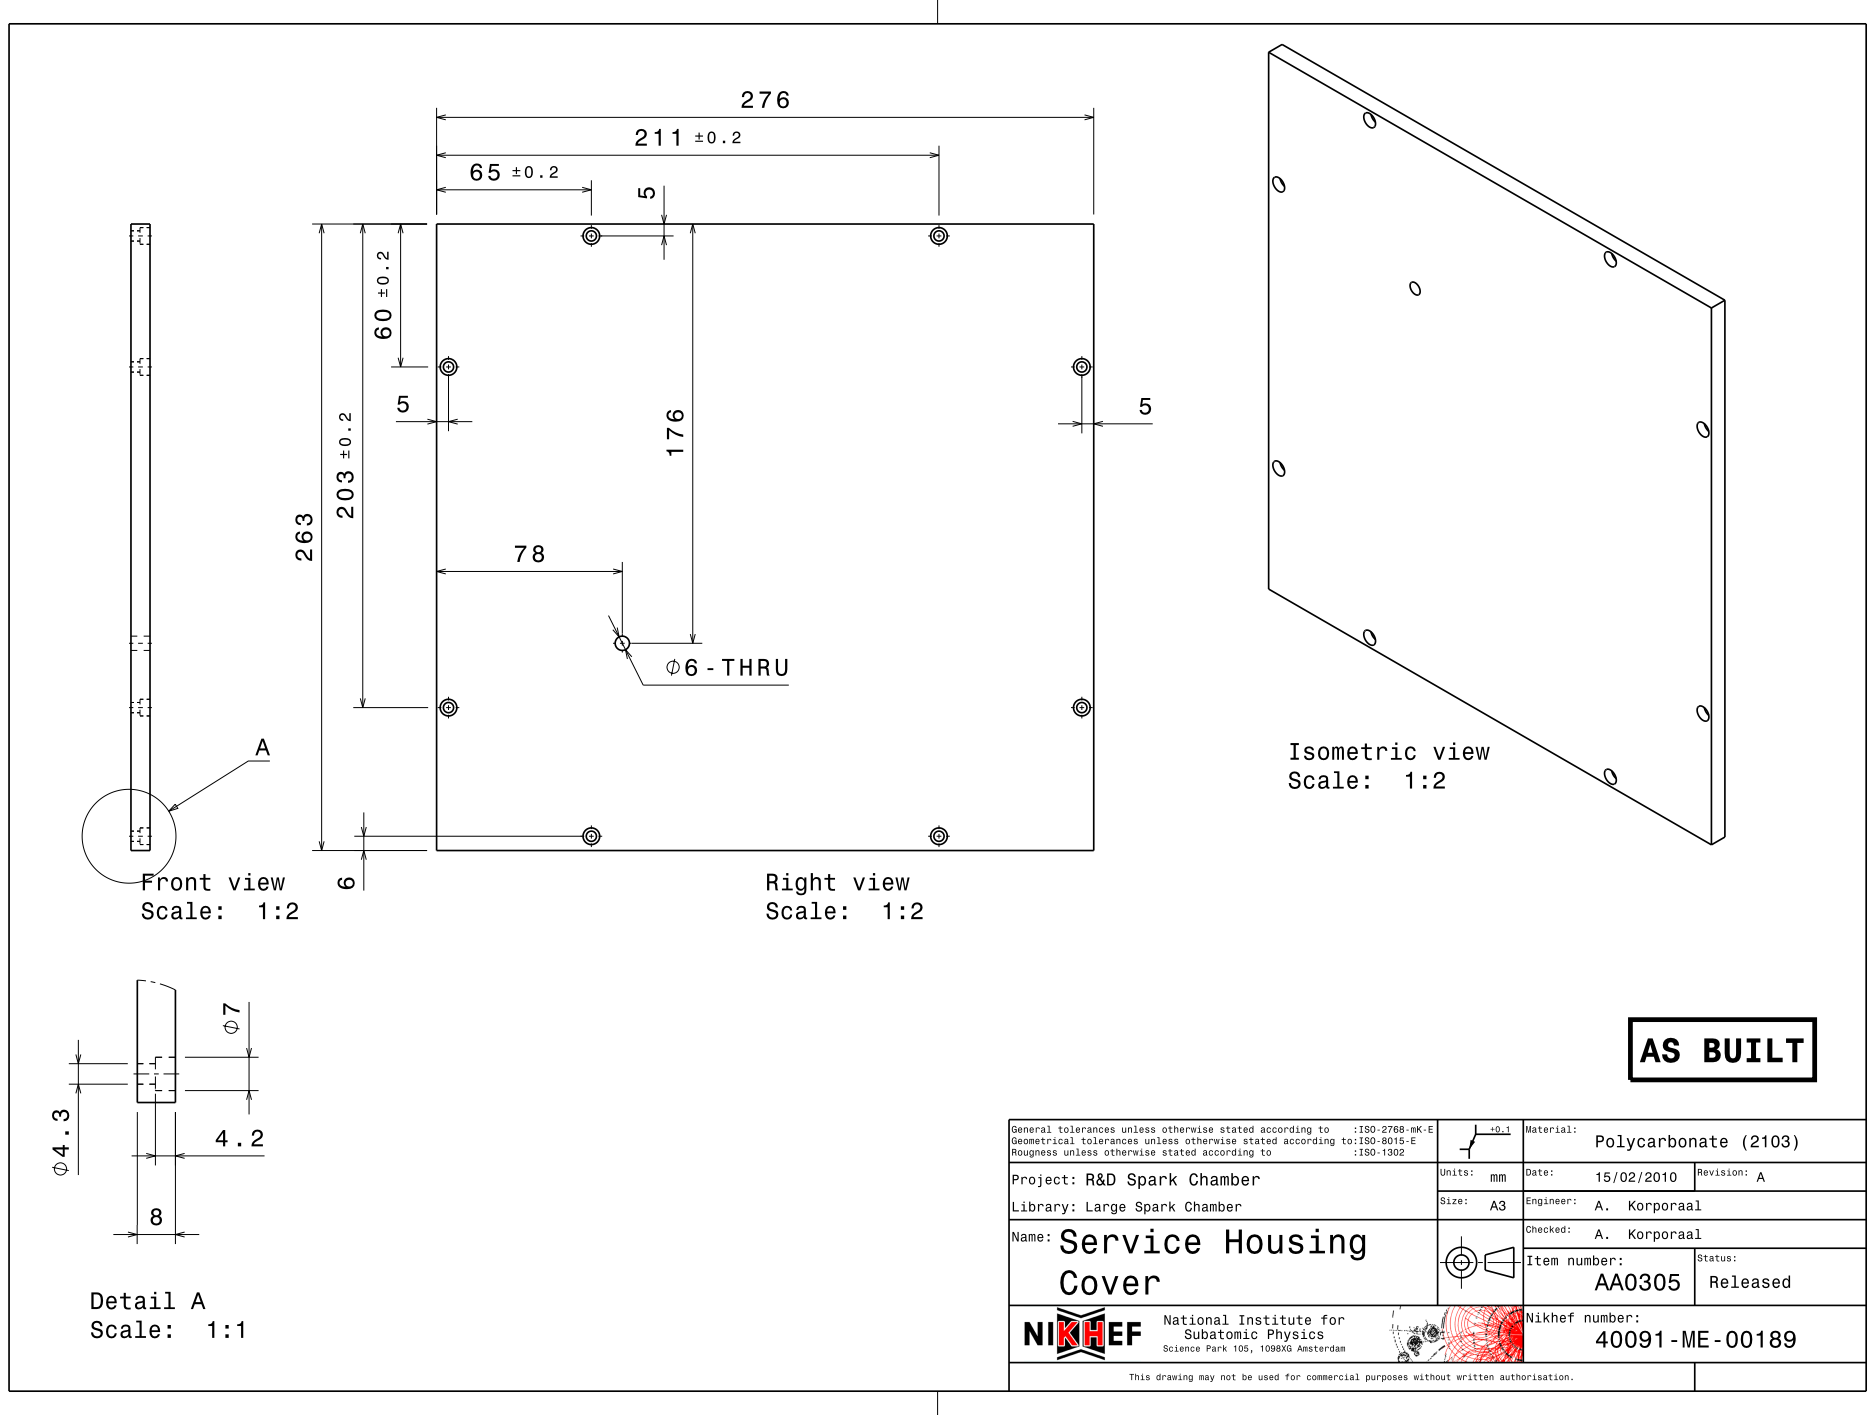
[picture p64: page 1]
