chrisgilmerproj/spark_chamber/Spark Chamber Large/Service Housing Plate 1_AA0297_A.pdf

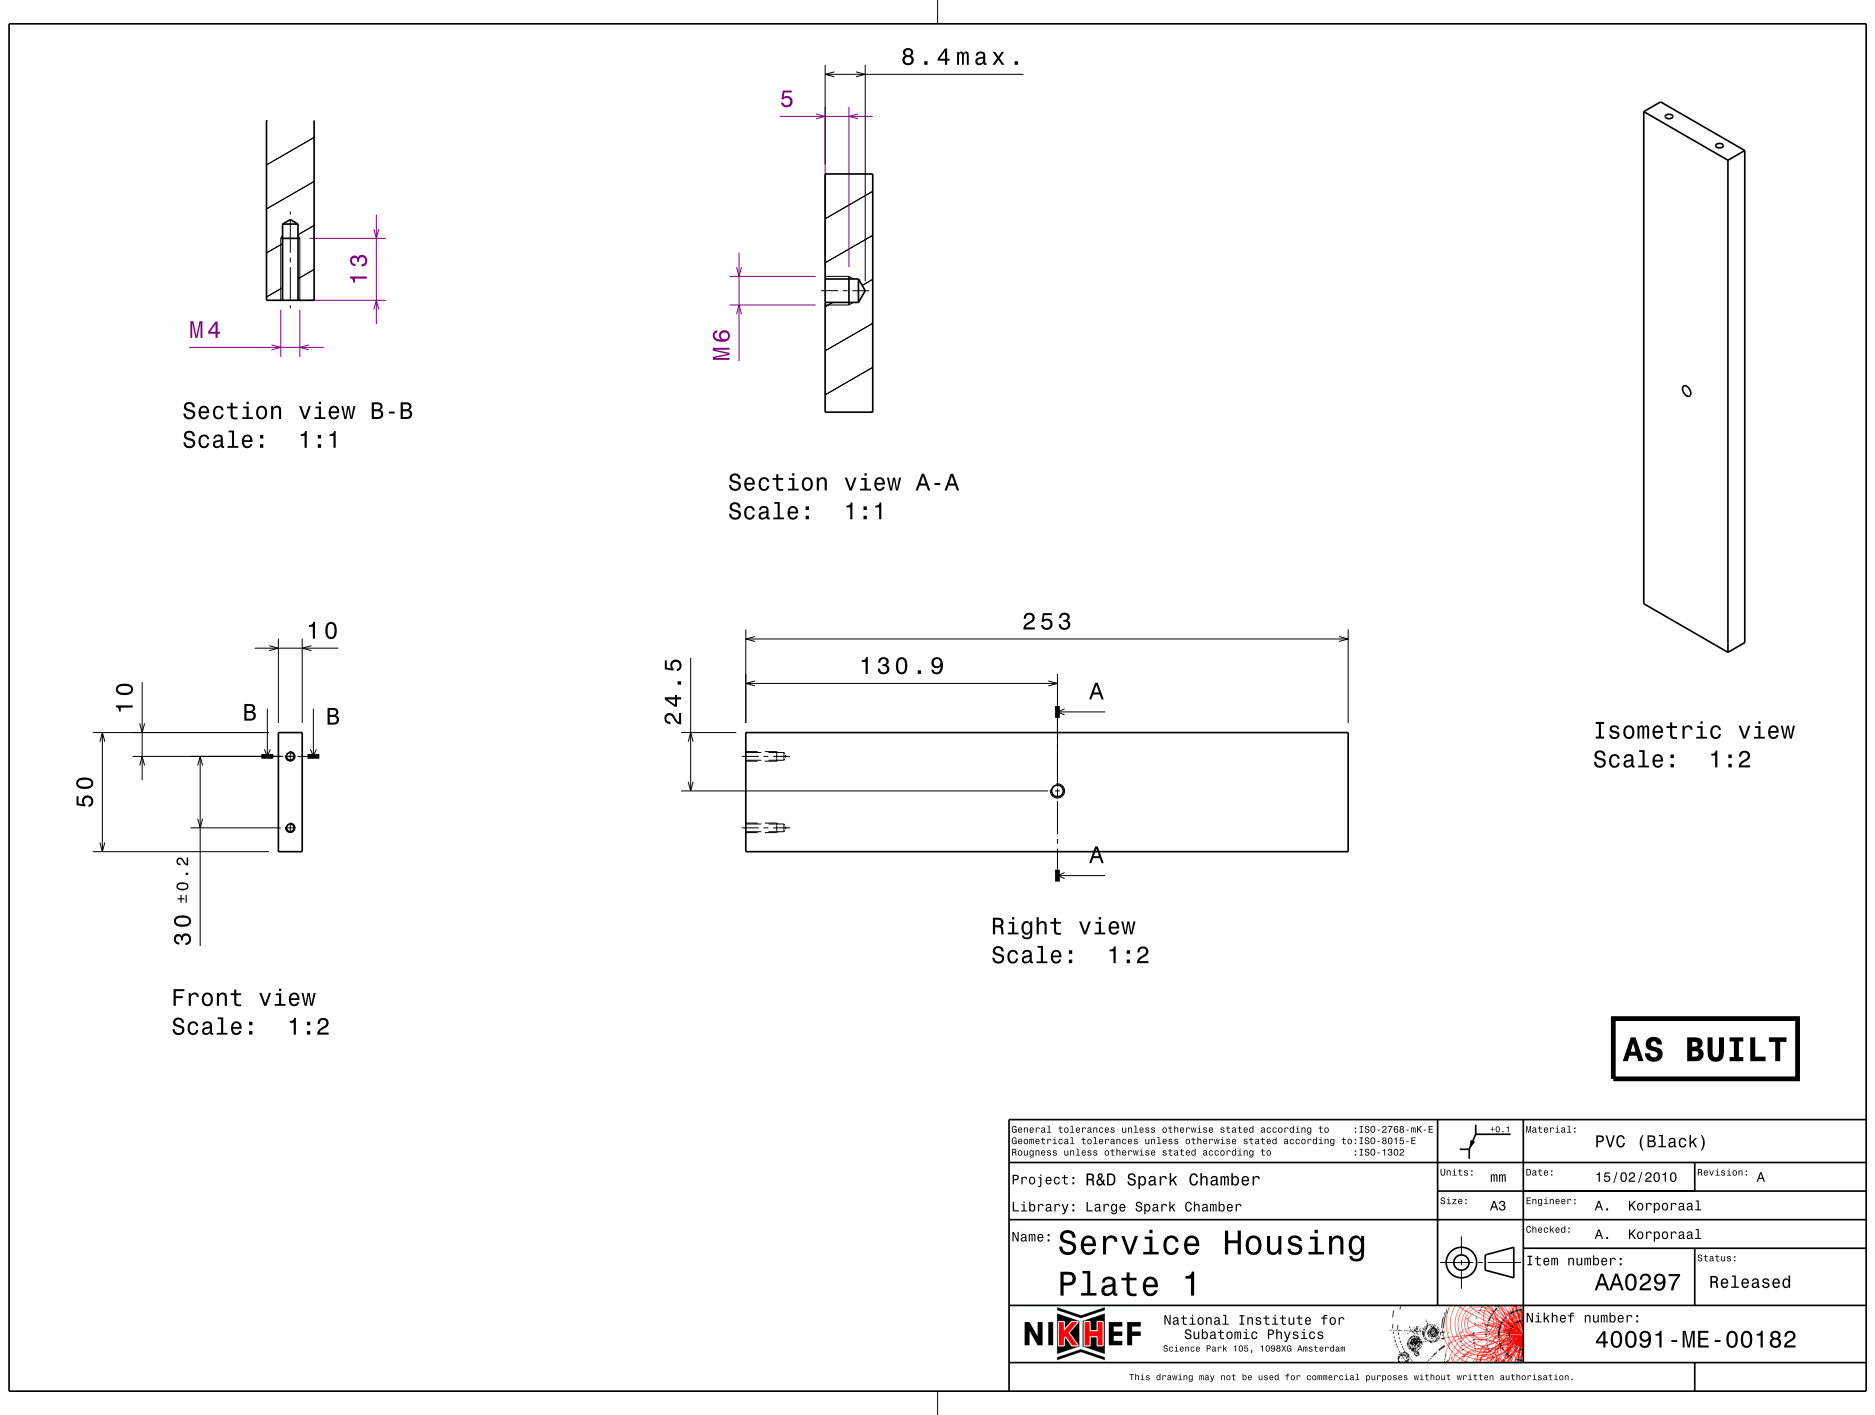
[picture p65: page 1]
