chrisgilmerproj/spark_chamber/Spark Chamber Large/Service Housing Plate 2_AA0298_A.pdf

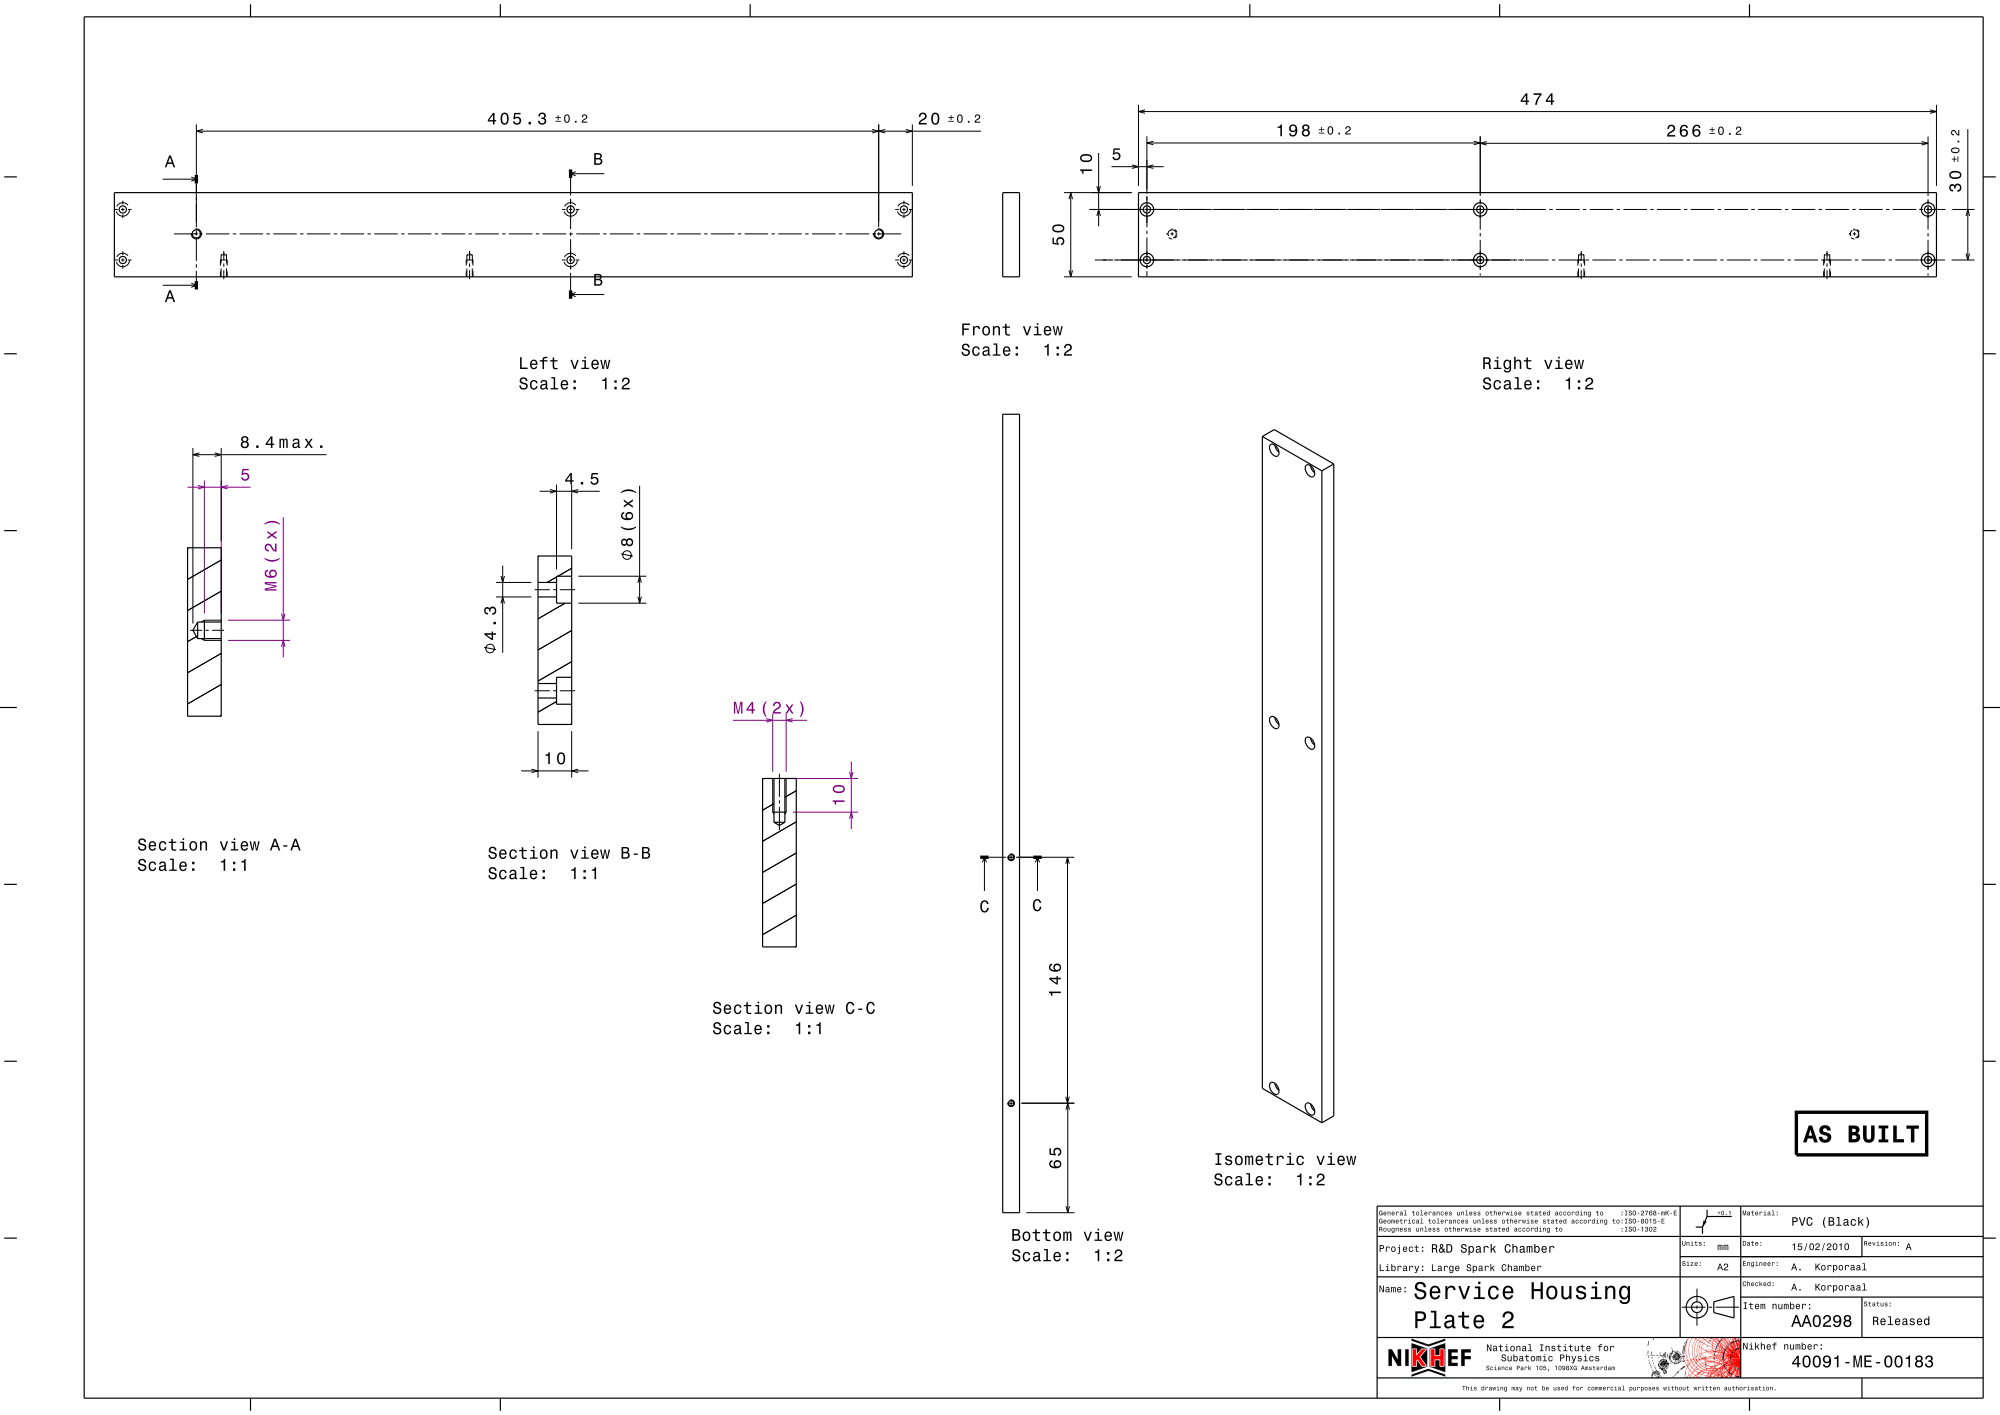
[picture p66: page 1]
