chrisgilmerproj/spark_chamber/Spark Chamber Large/Service Housing Plate 3_AA0300_A.pdf

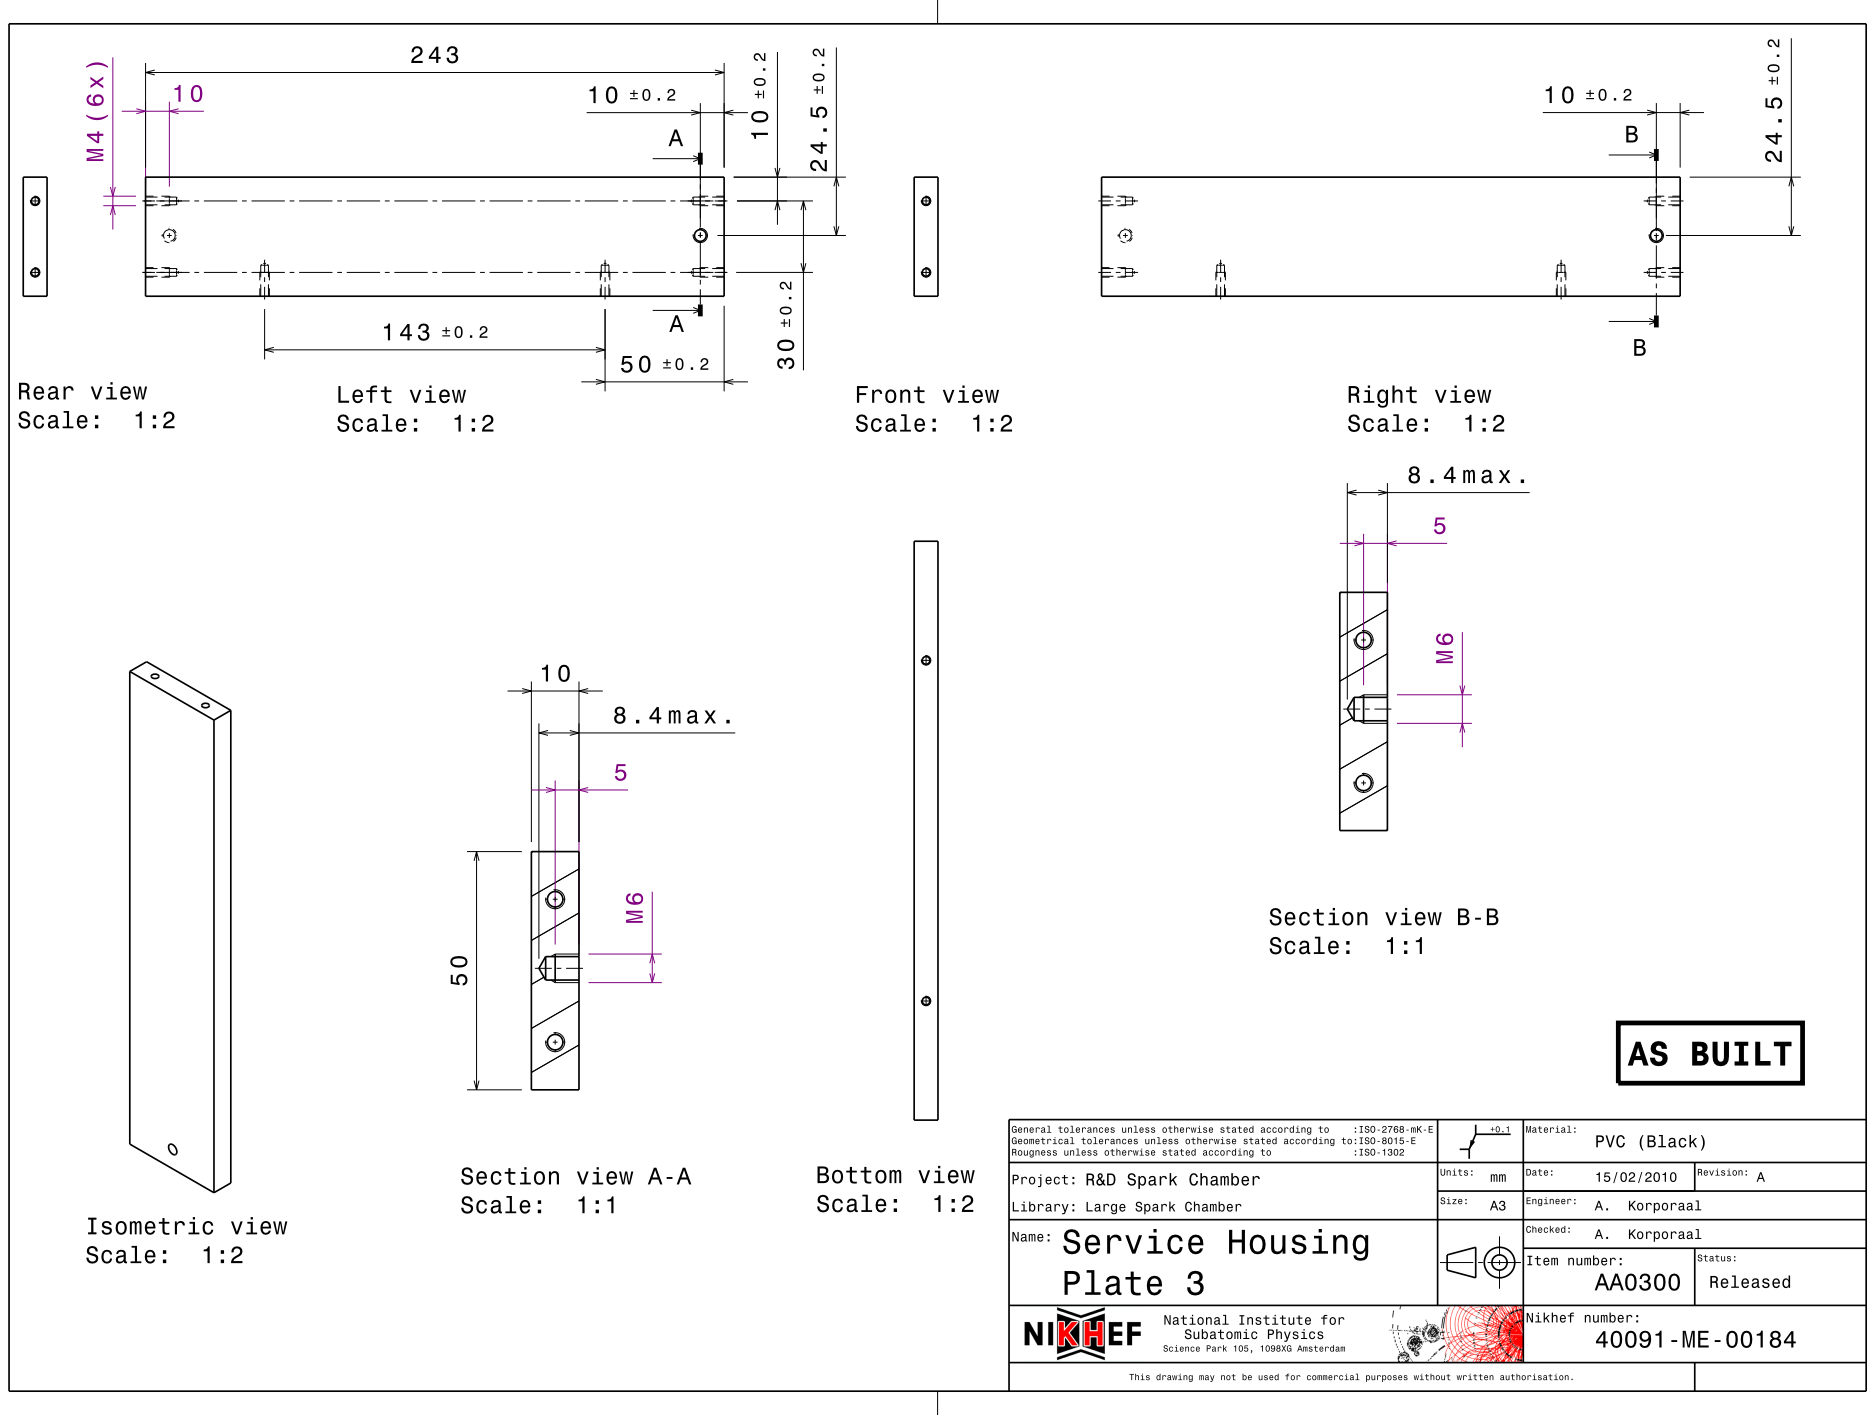
[picture p67: page 1]
