chrisgilmerproj/spark_chamber/Spark Chamber Large/Service Housing Plate 4_AA0301_A.pdf

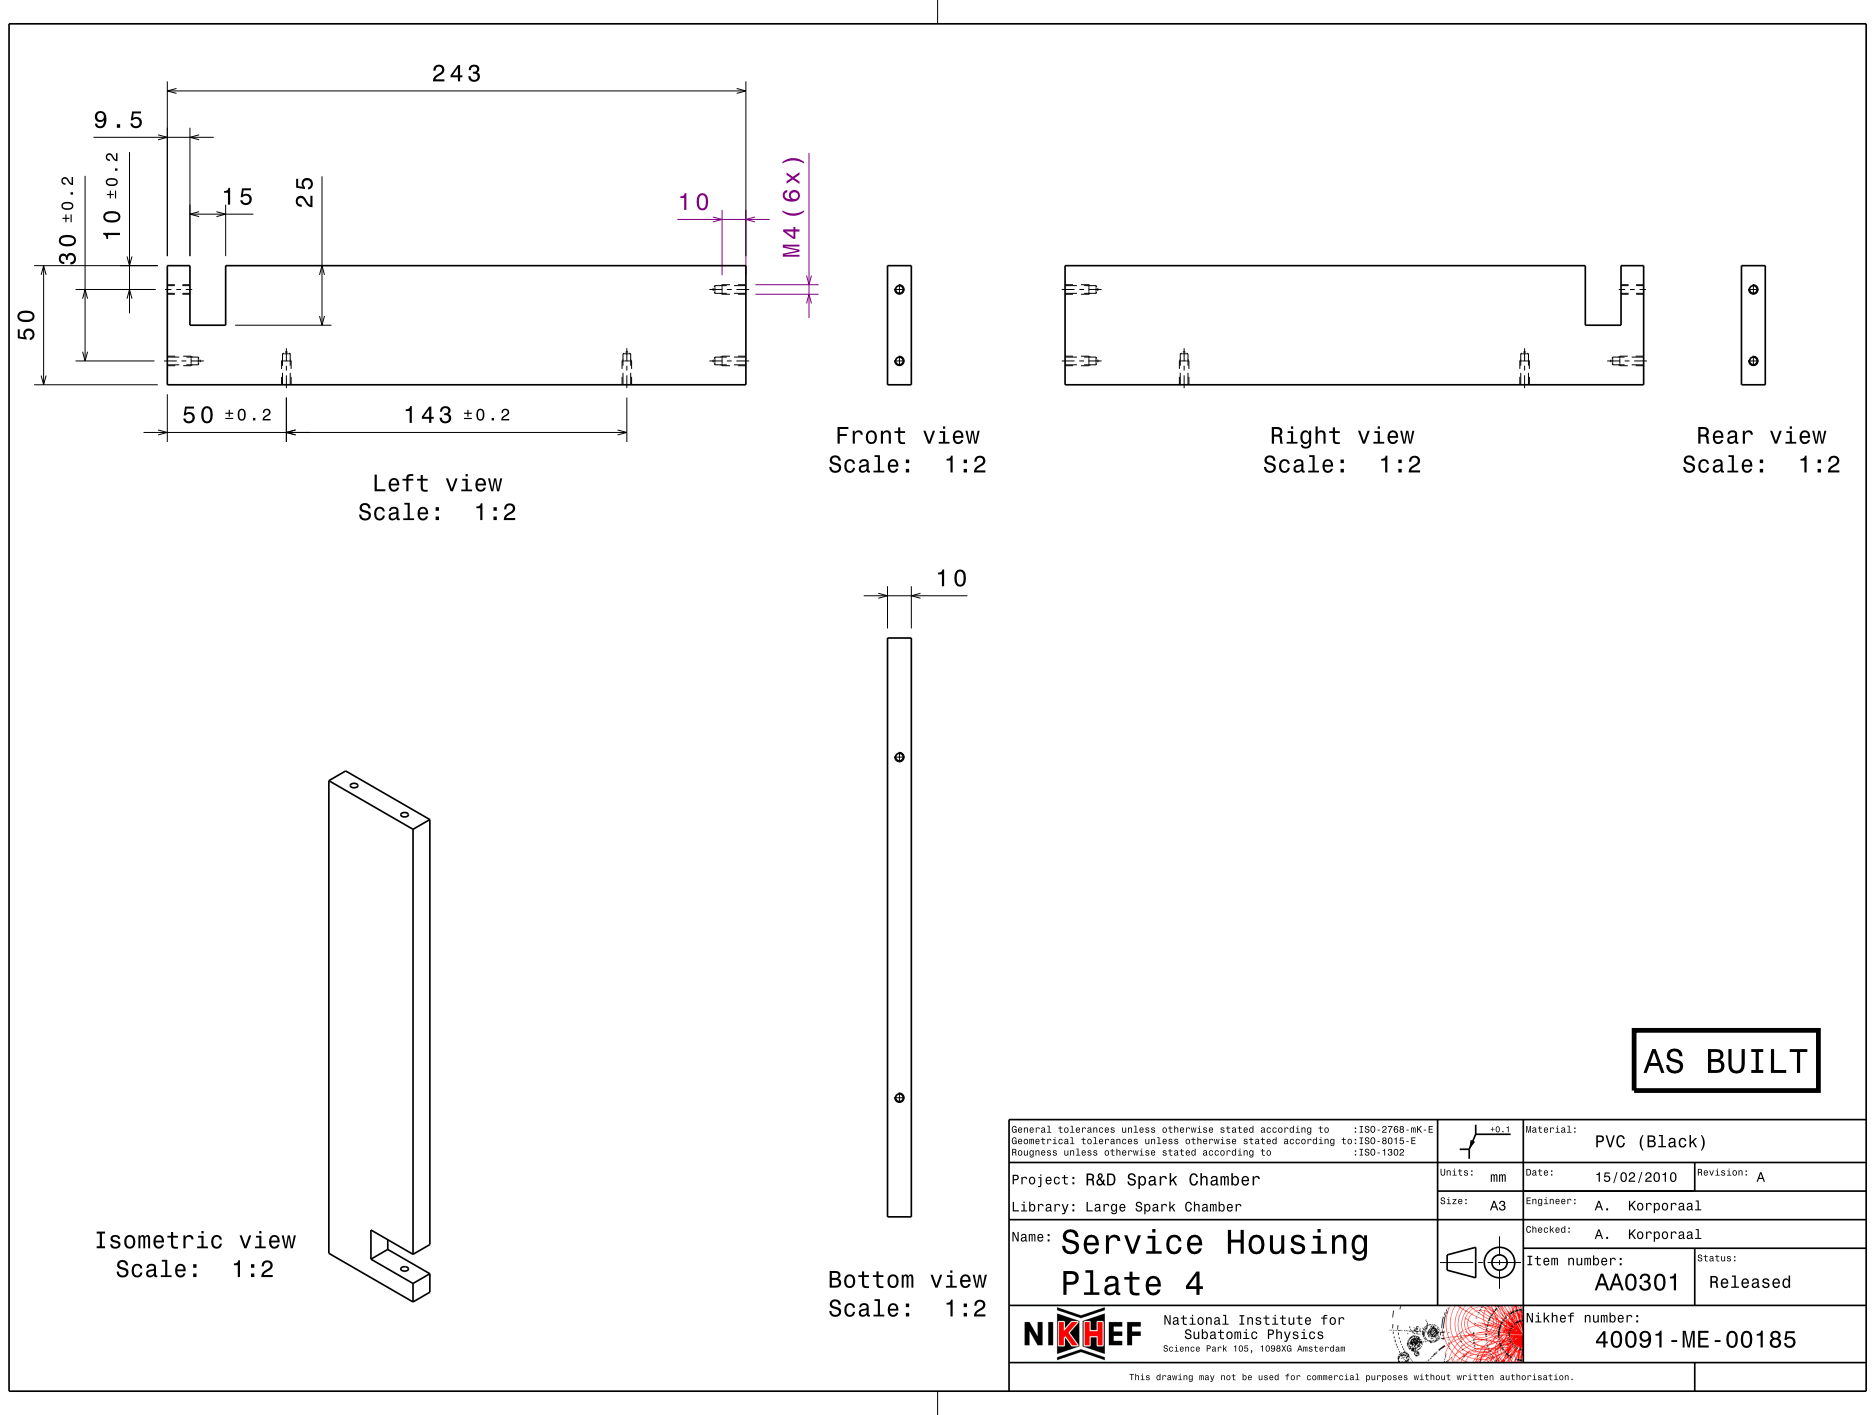
[picture p68: page 1]
