chrisgilmerproj/spark_chamber/Spark Chamber Large/Side Strip_AA0271_A.pdf

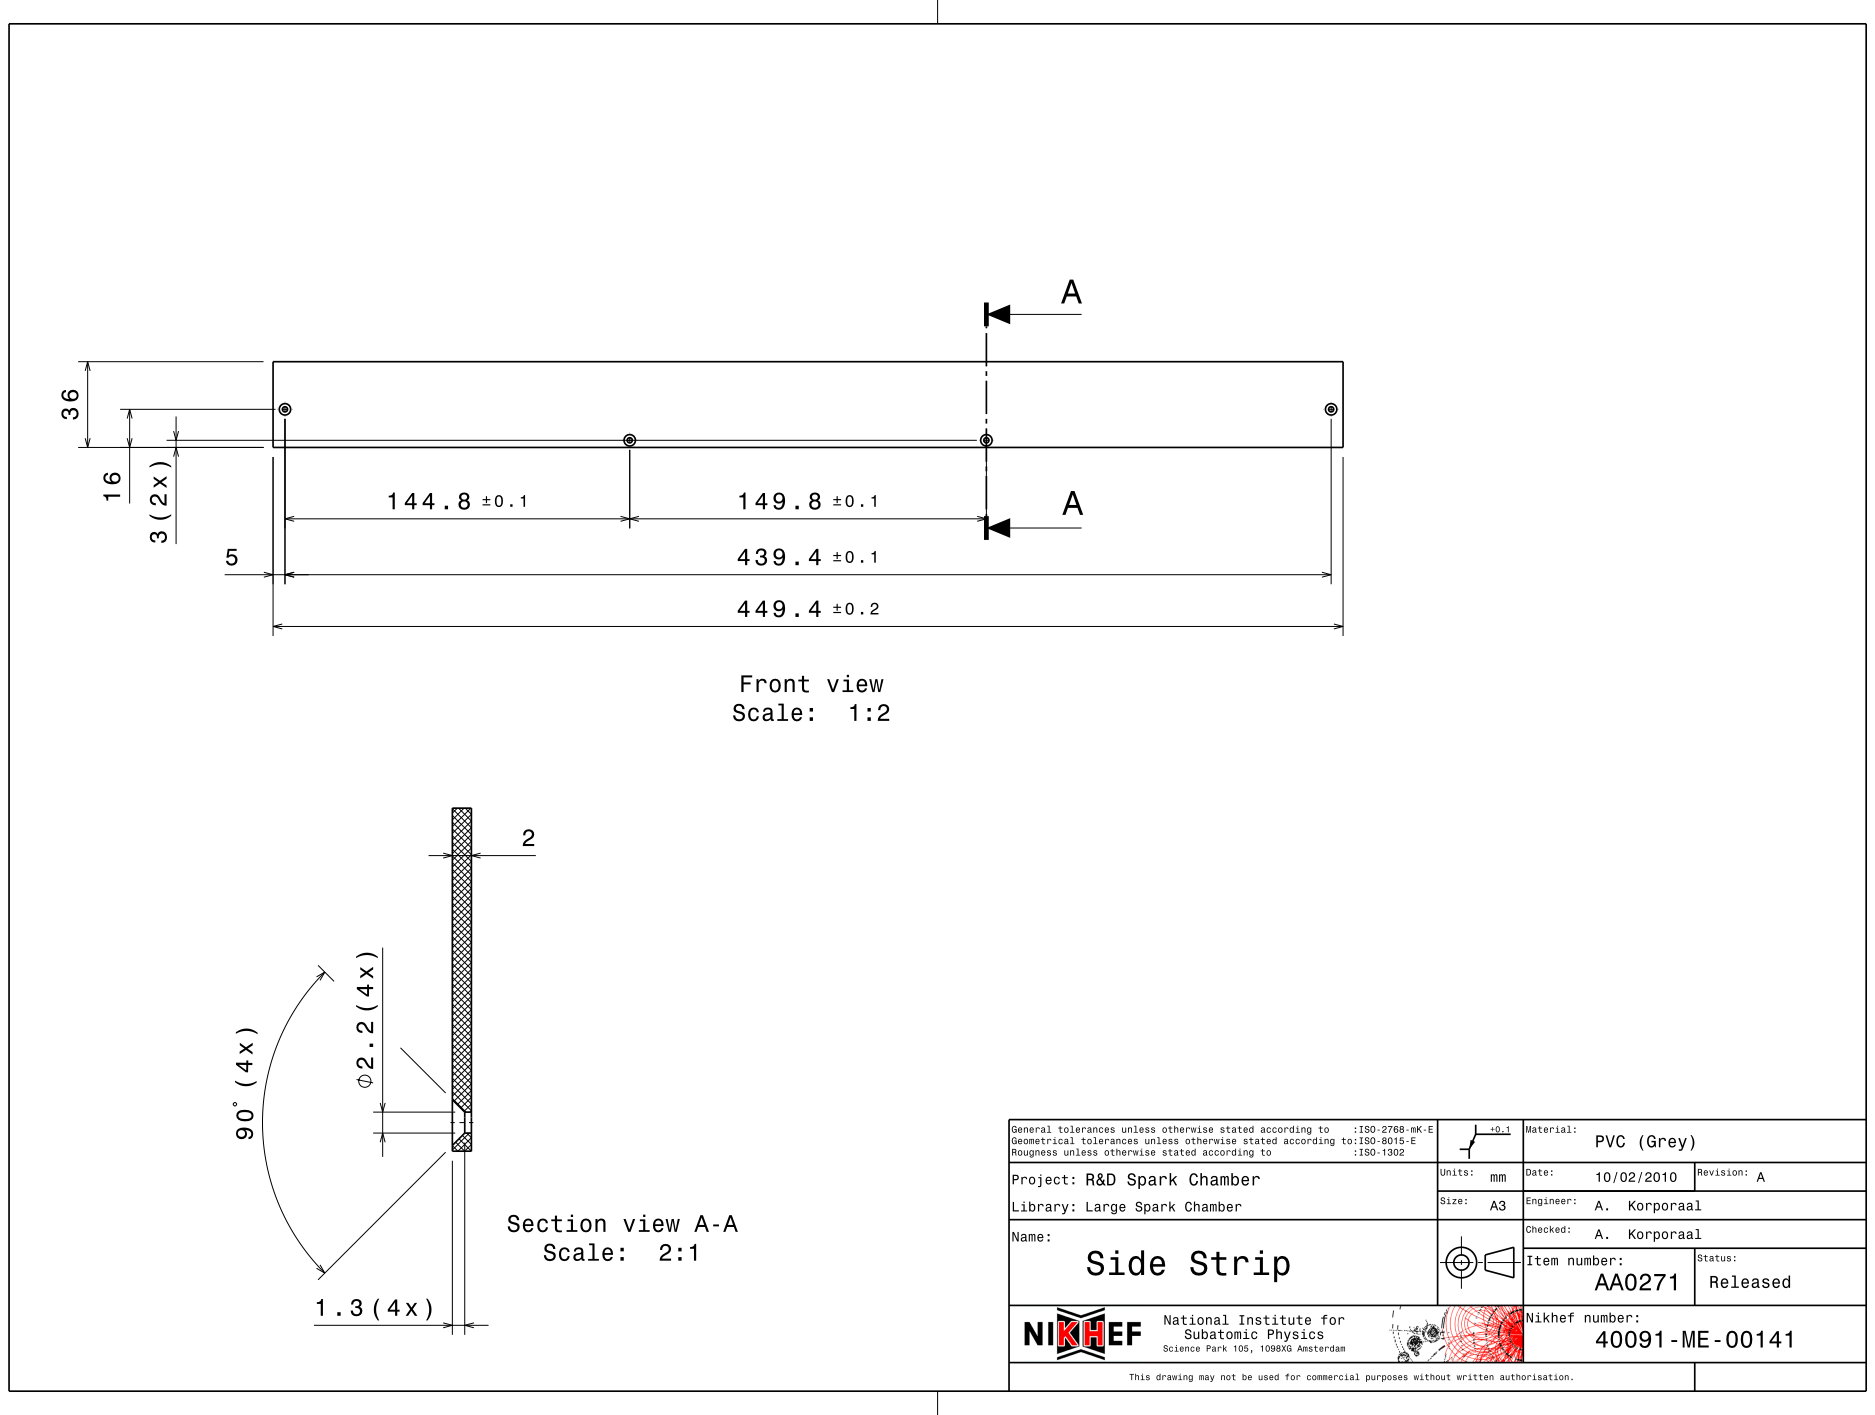
[picture p69: page 1]
