chrisgilmerproj/spark_chamber/Spark Chamber Large/Spark_Gap_AA3920.pdf

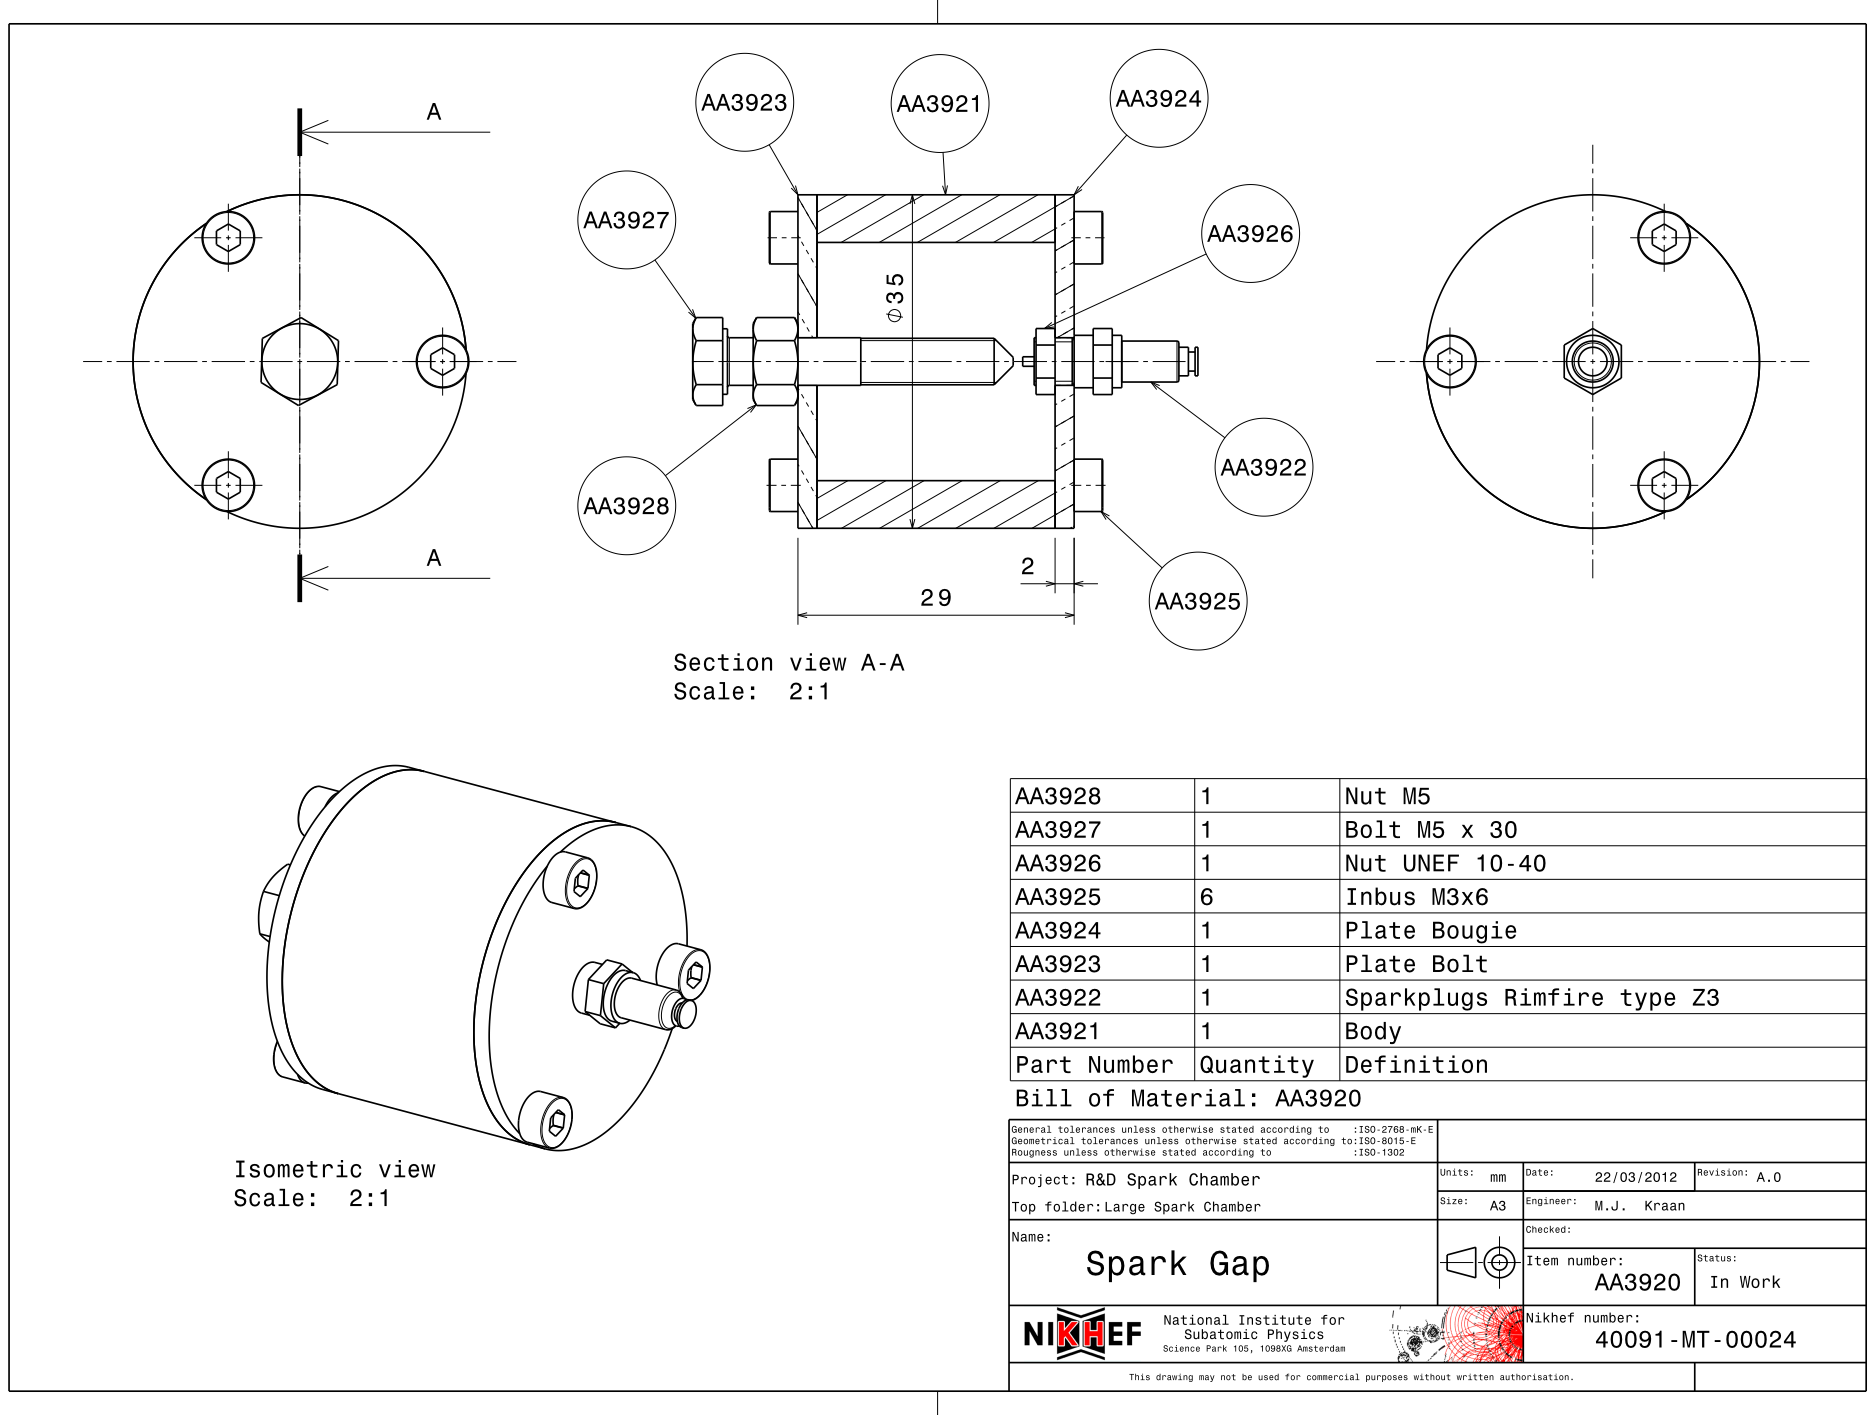
[picture p70: page 1]
