chrisgilmerproj/spark_chamber/Spark Chamber Large/Strip_AA0264_A.pdf

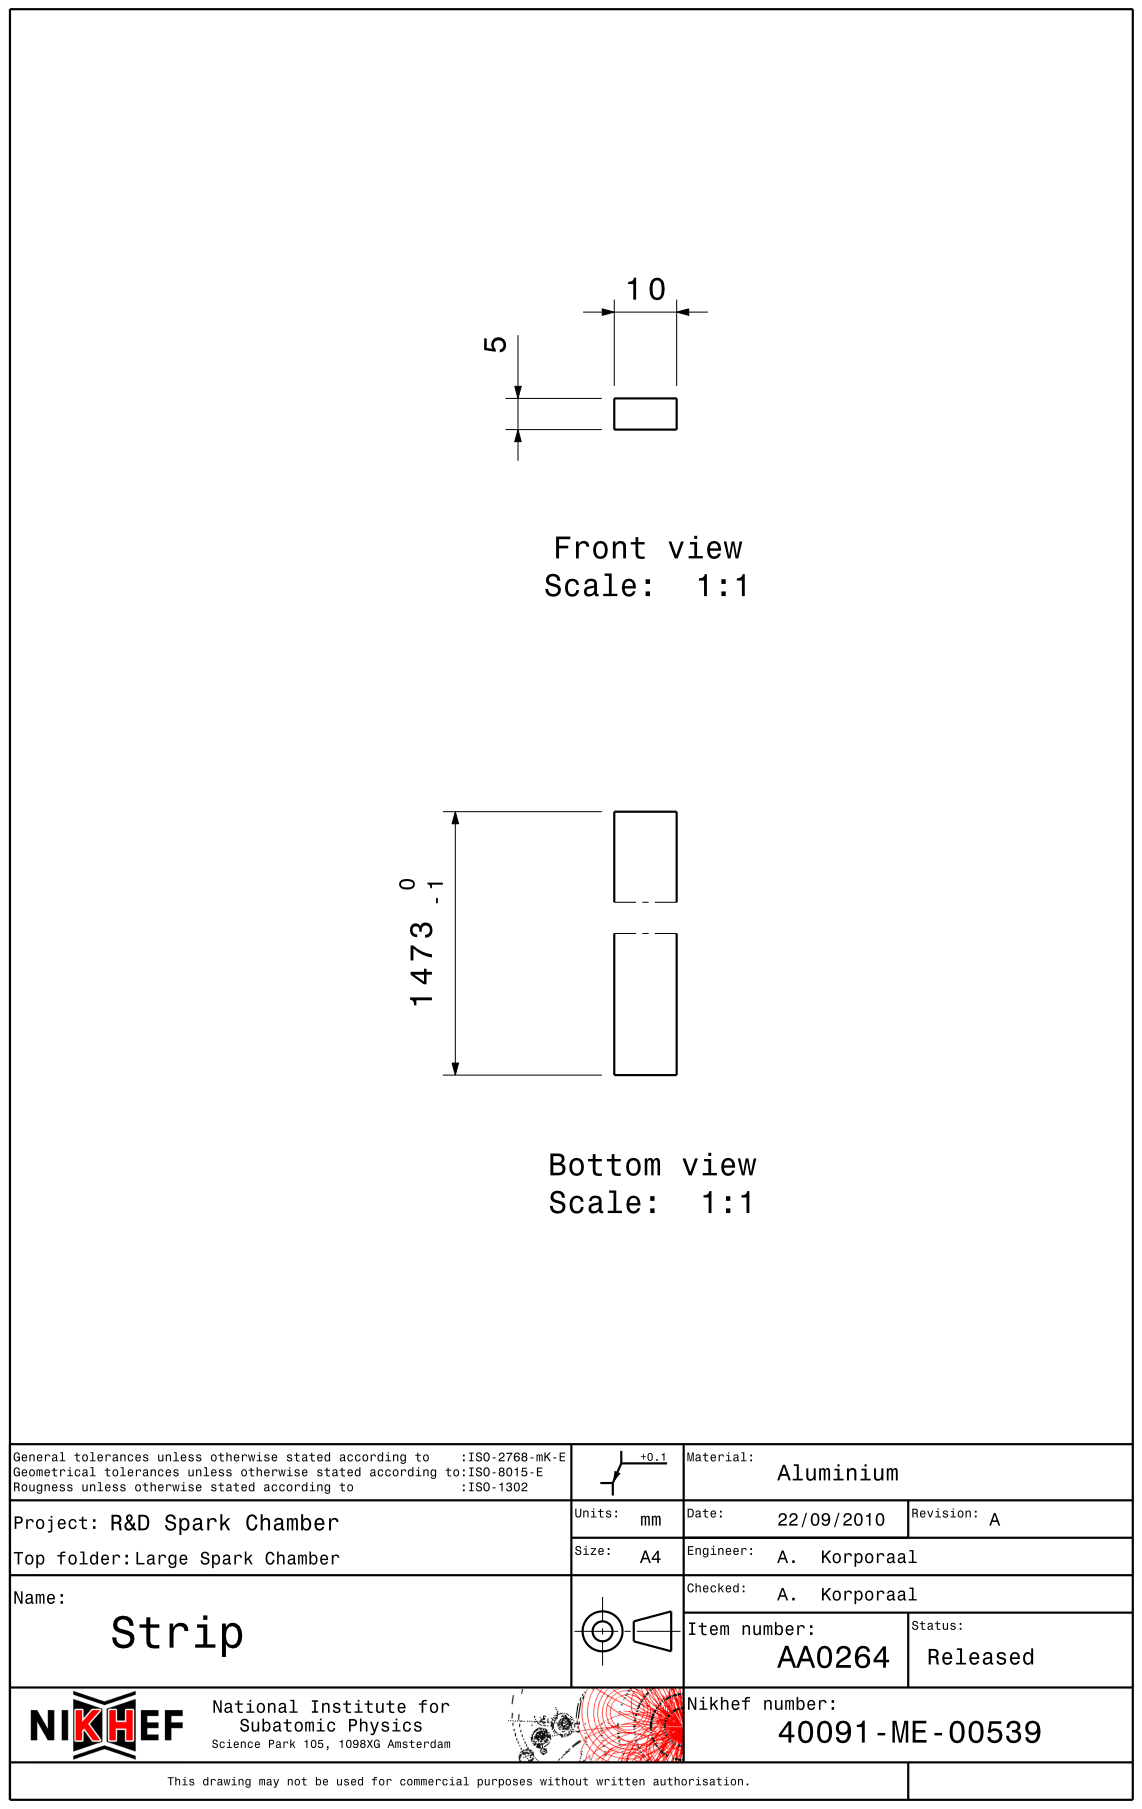
[picture p71: page 1]
