chrisgilmerproj/spark_chamber/Spark Chamber Large/Top and Bottom Plate_AA0249.pdf

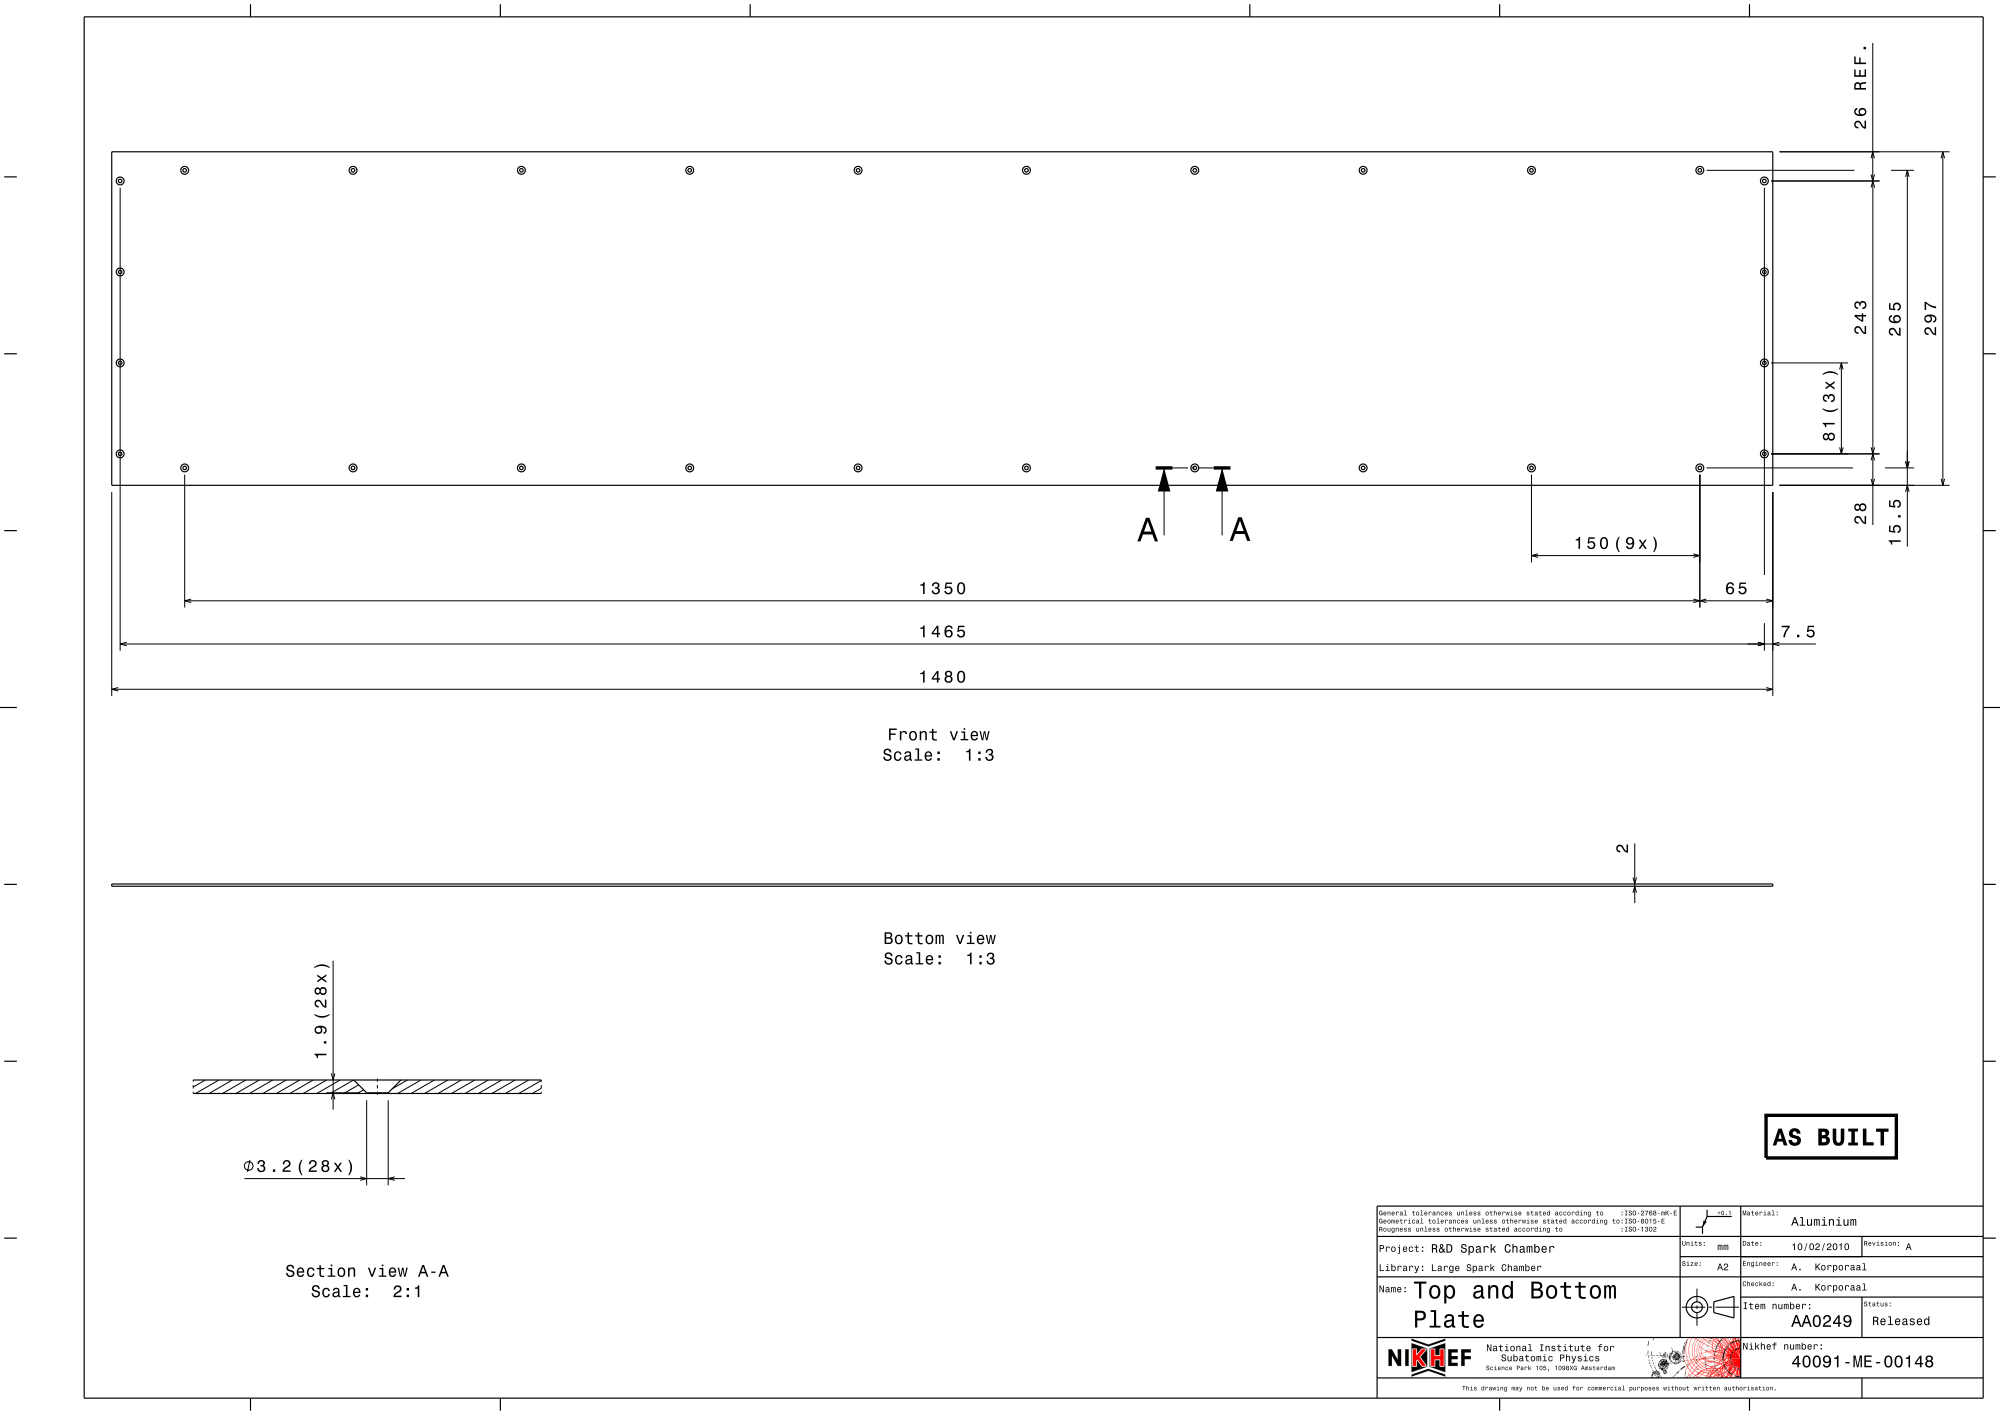
[picture p72: page 1]
