chrisgilmerproj/spark_chamber/Spark Chamber Large/Tube Clamp_AA0263_A.pdf

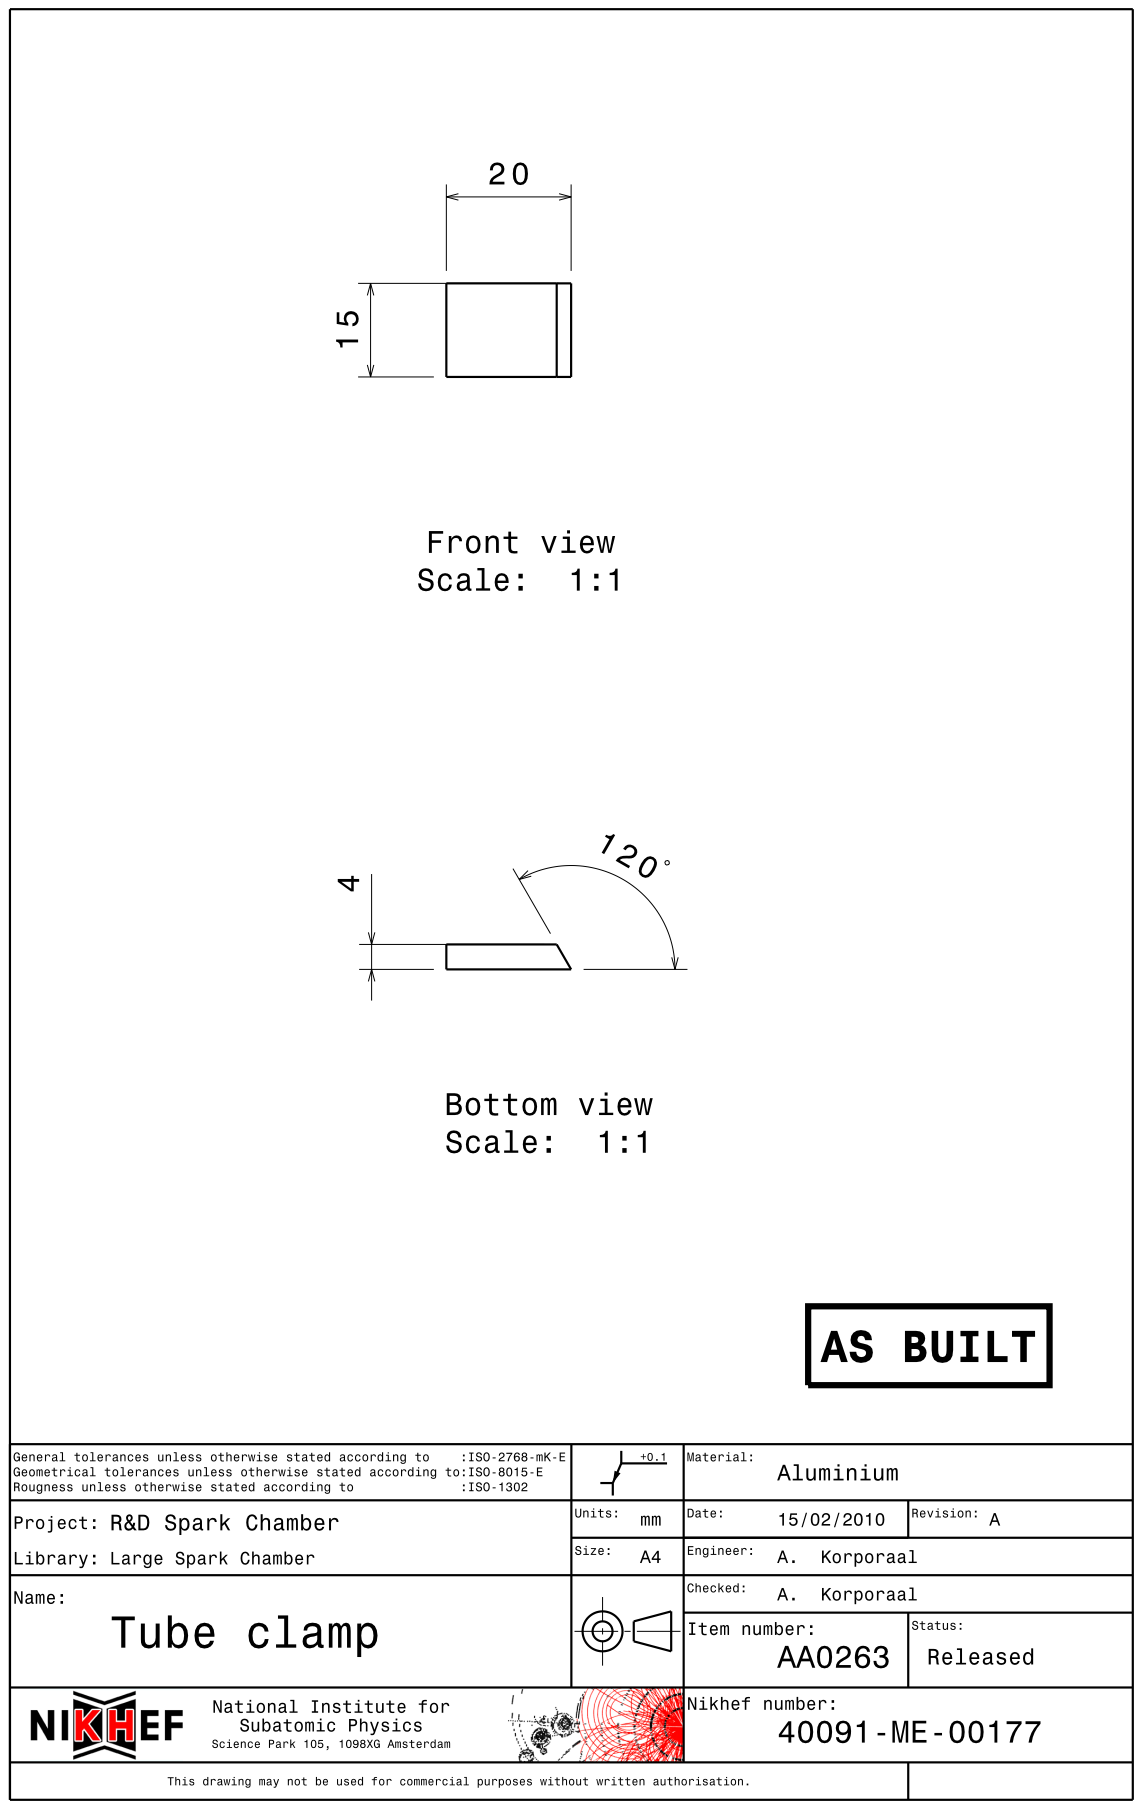
[picture p73: page 1]
