chrisgilmerproj/spark_chamber/Spark Chamber Large/Upper Electrode Plate_AA0279_A.pdf

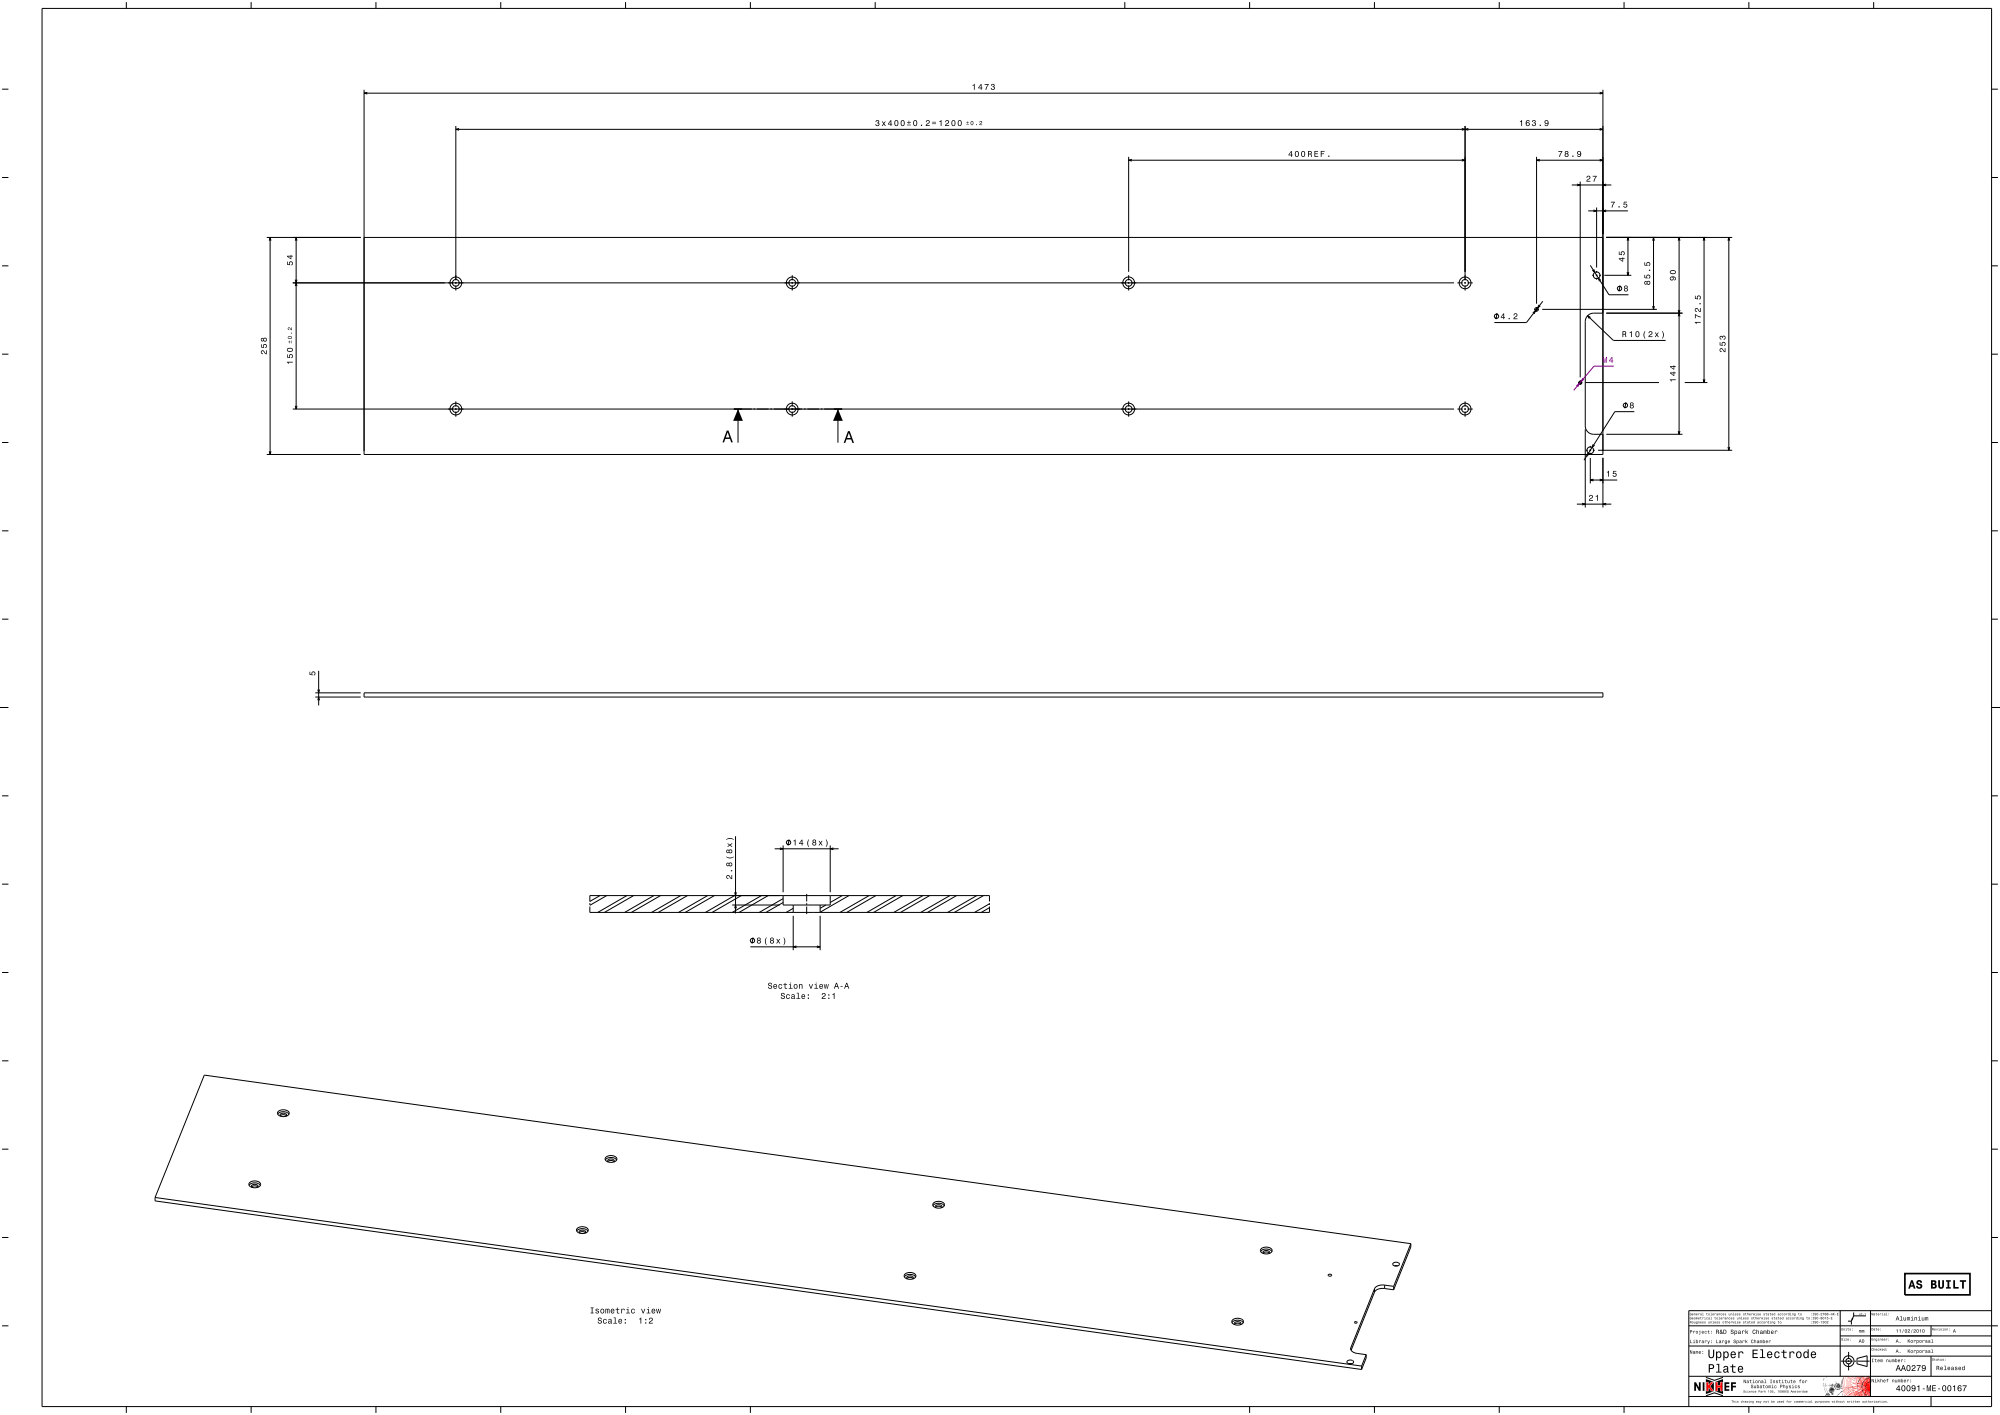
[picture p74: page 1]
