chrisgilmerproj/spark_chamber/Spark Chamber Large/Upper turnplate 1_AA0269_A.pdf

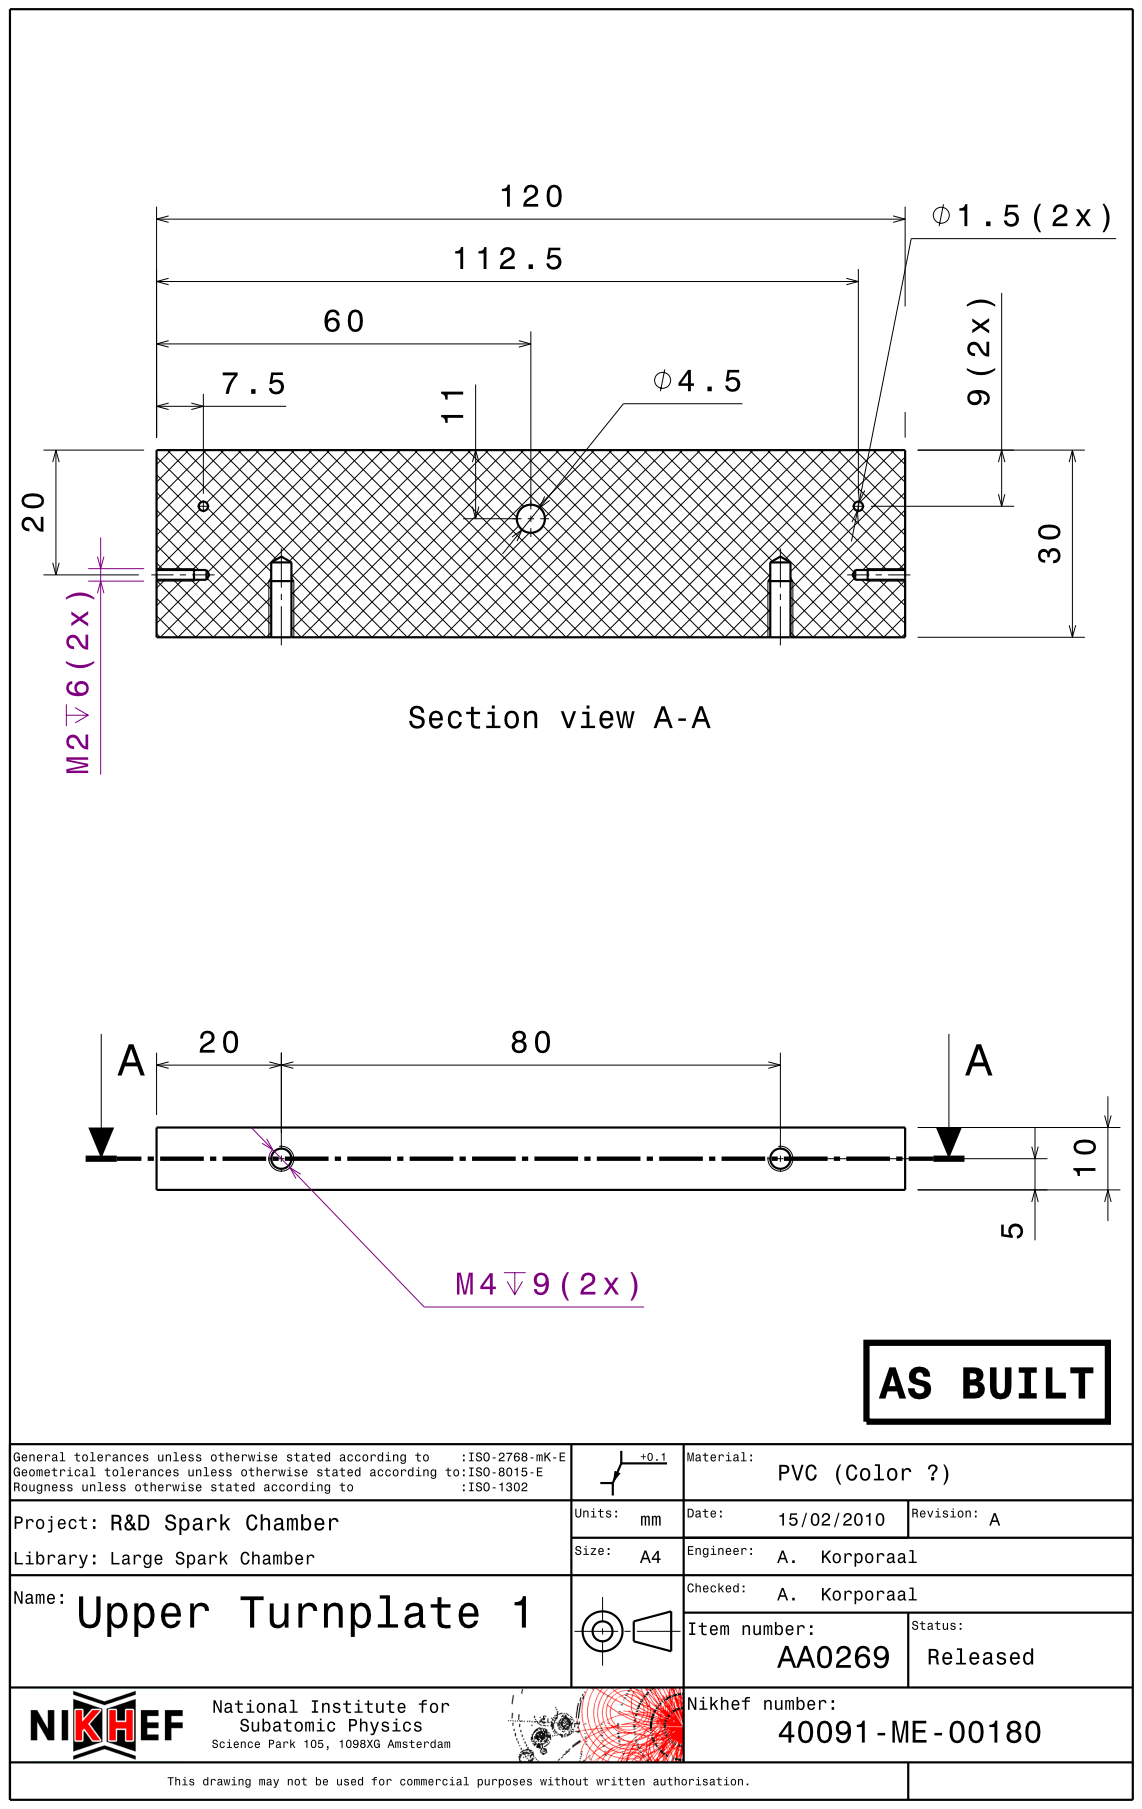
[picture p75: page 1]
