chrisgilmerproj/spark_chamber/Spark Chamber Small/Assy Spark chamber.pdf

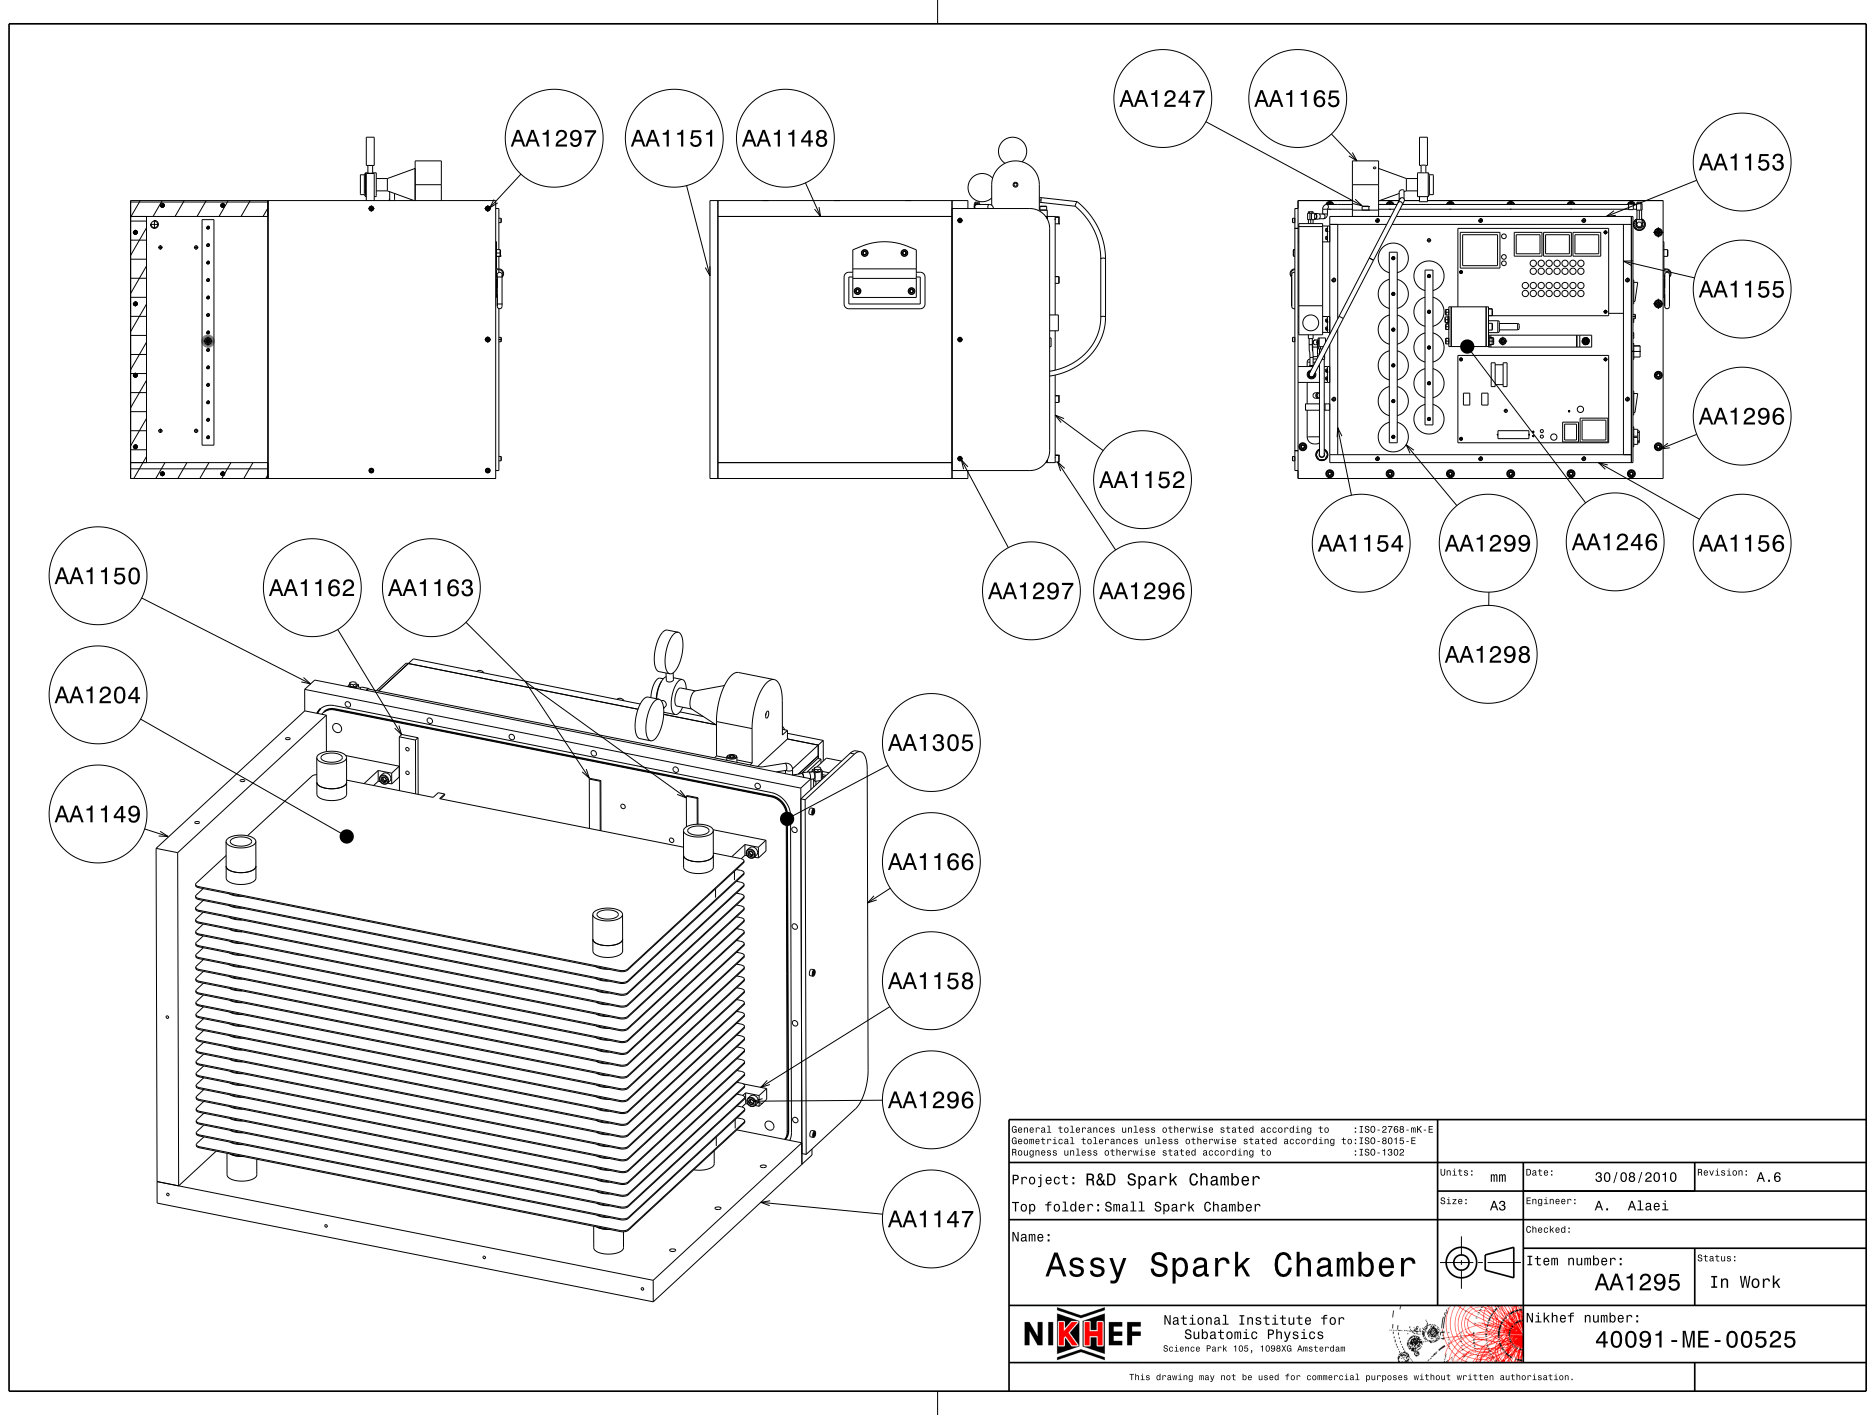
[picture p76: page 1]
