chrisgilmerproj/spark_chamber/Spark Chamber Small/Aluminum Plate Scintillator/Aluminium_plate.pdf

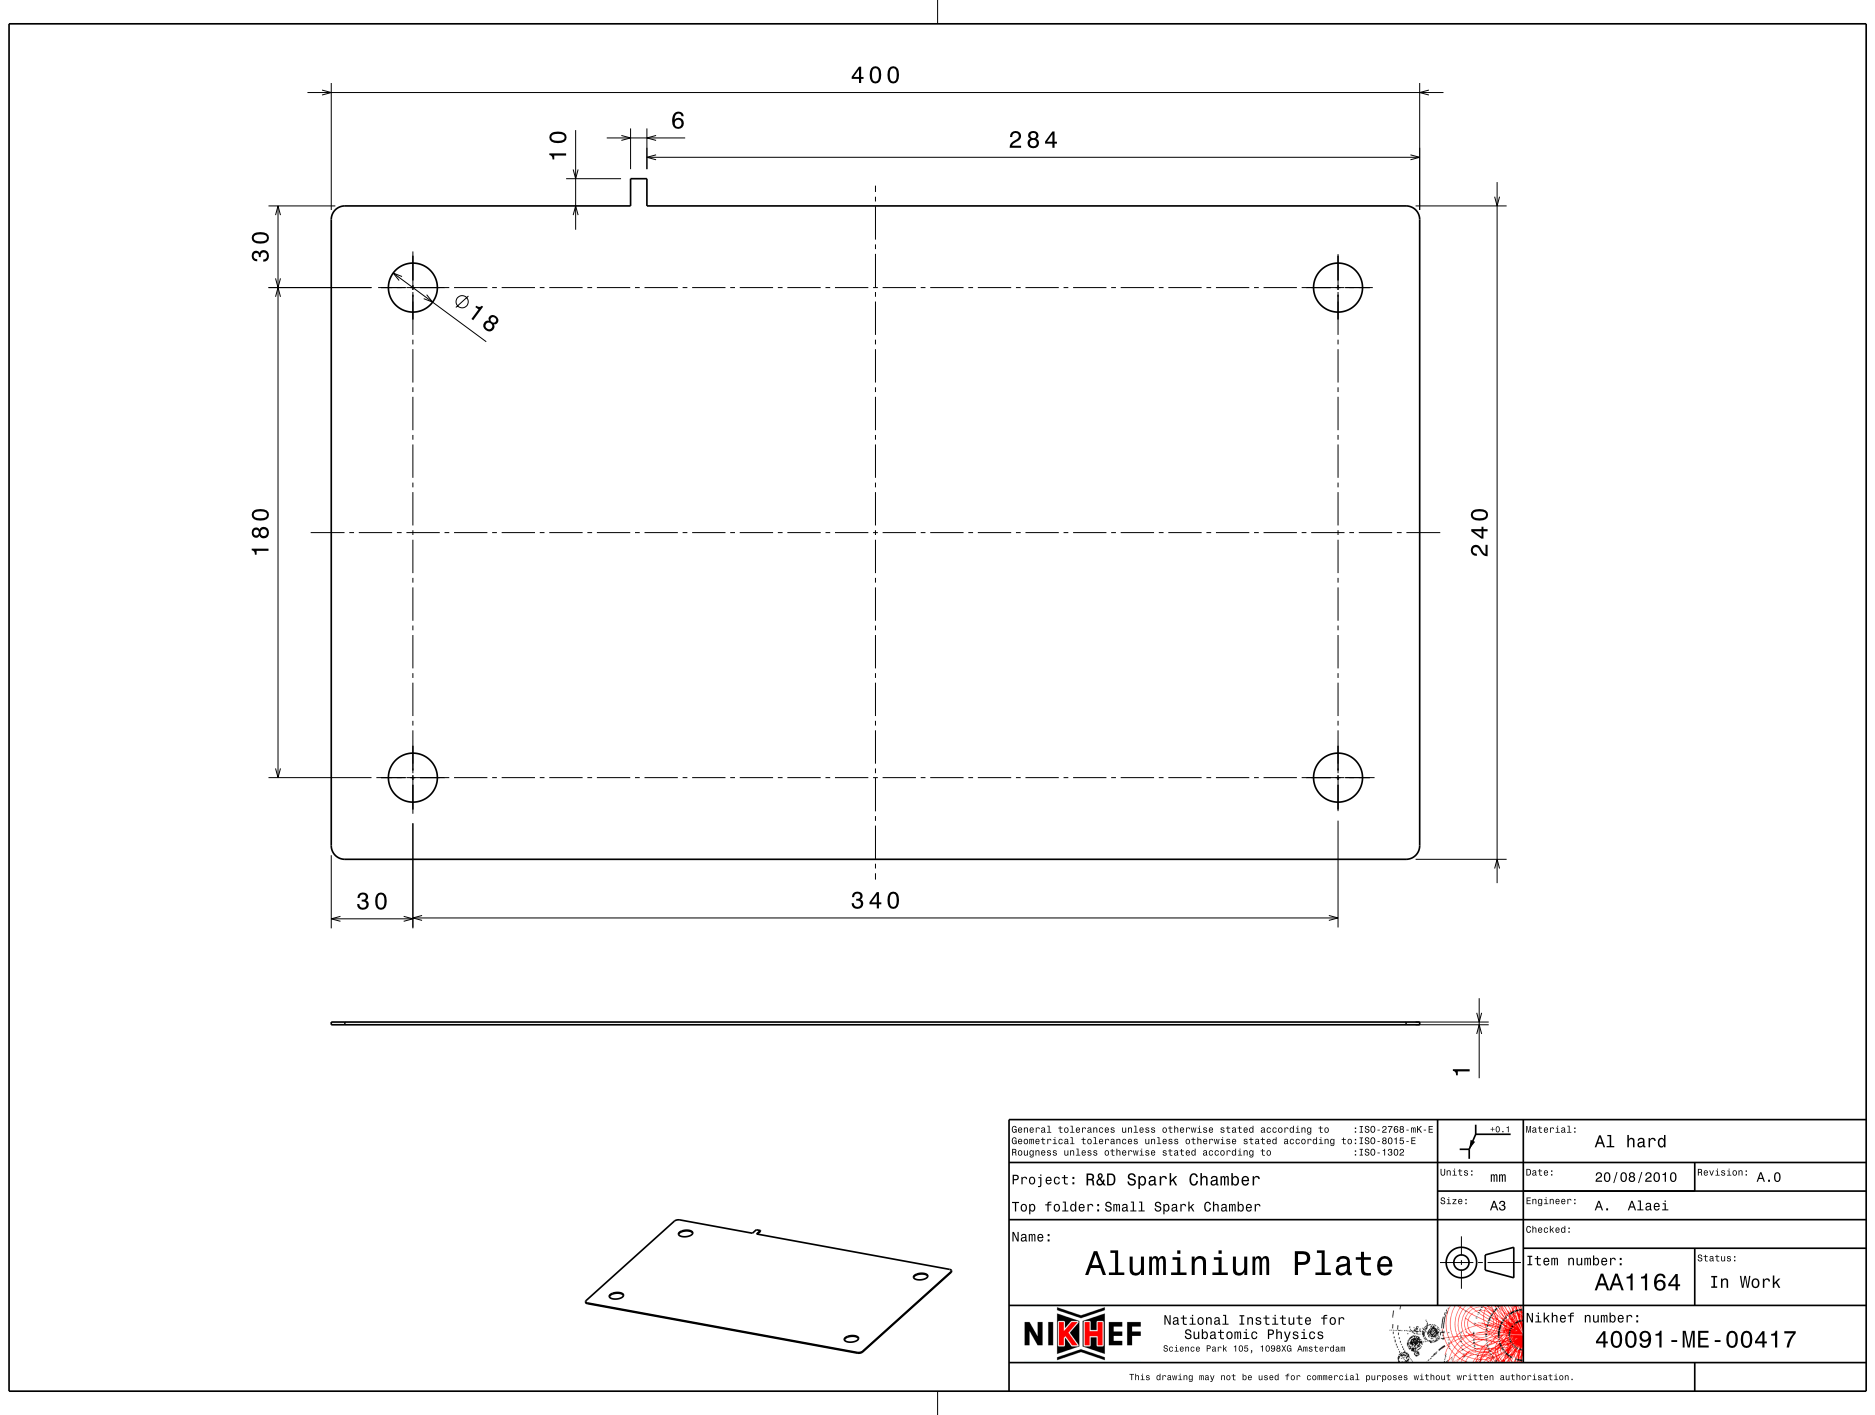
[picture p77: page 1]
