chrisgilmerproj/spark_chamber/Spark Chamber Small/Aluminum Plate Scintillator/Assy Aluminium_plates_Scintillator.pdf

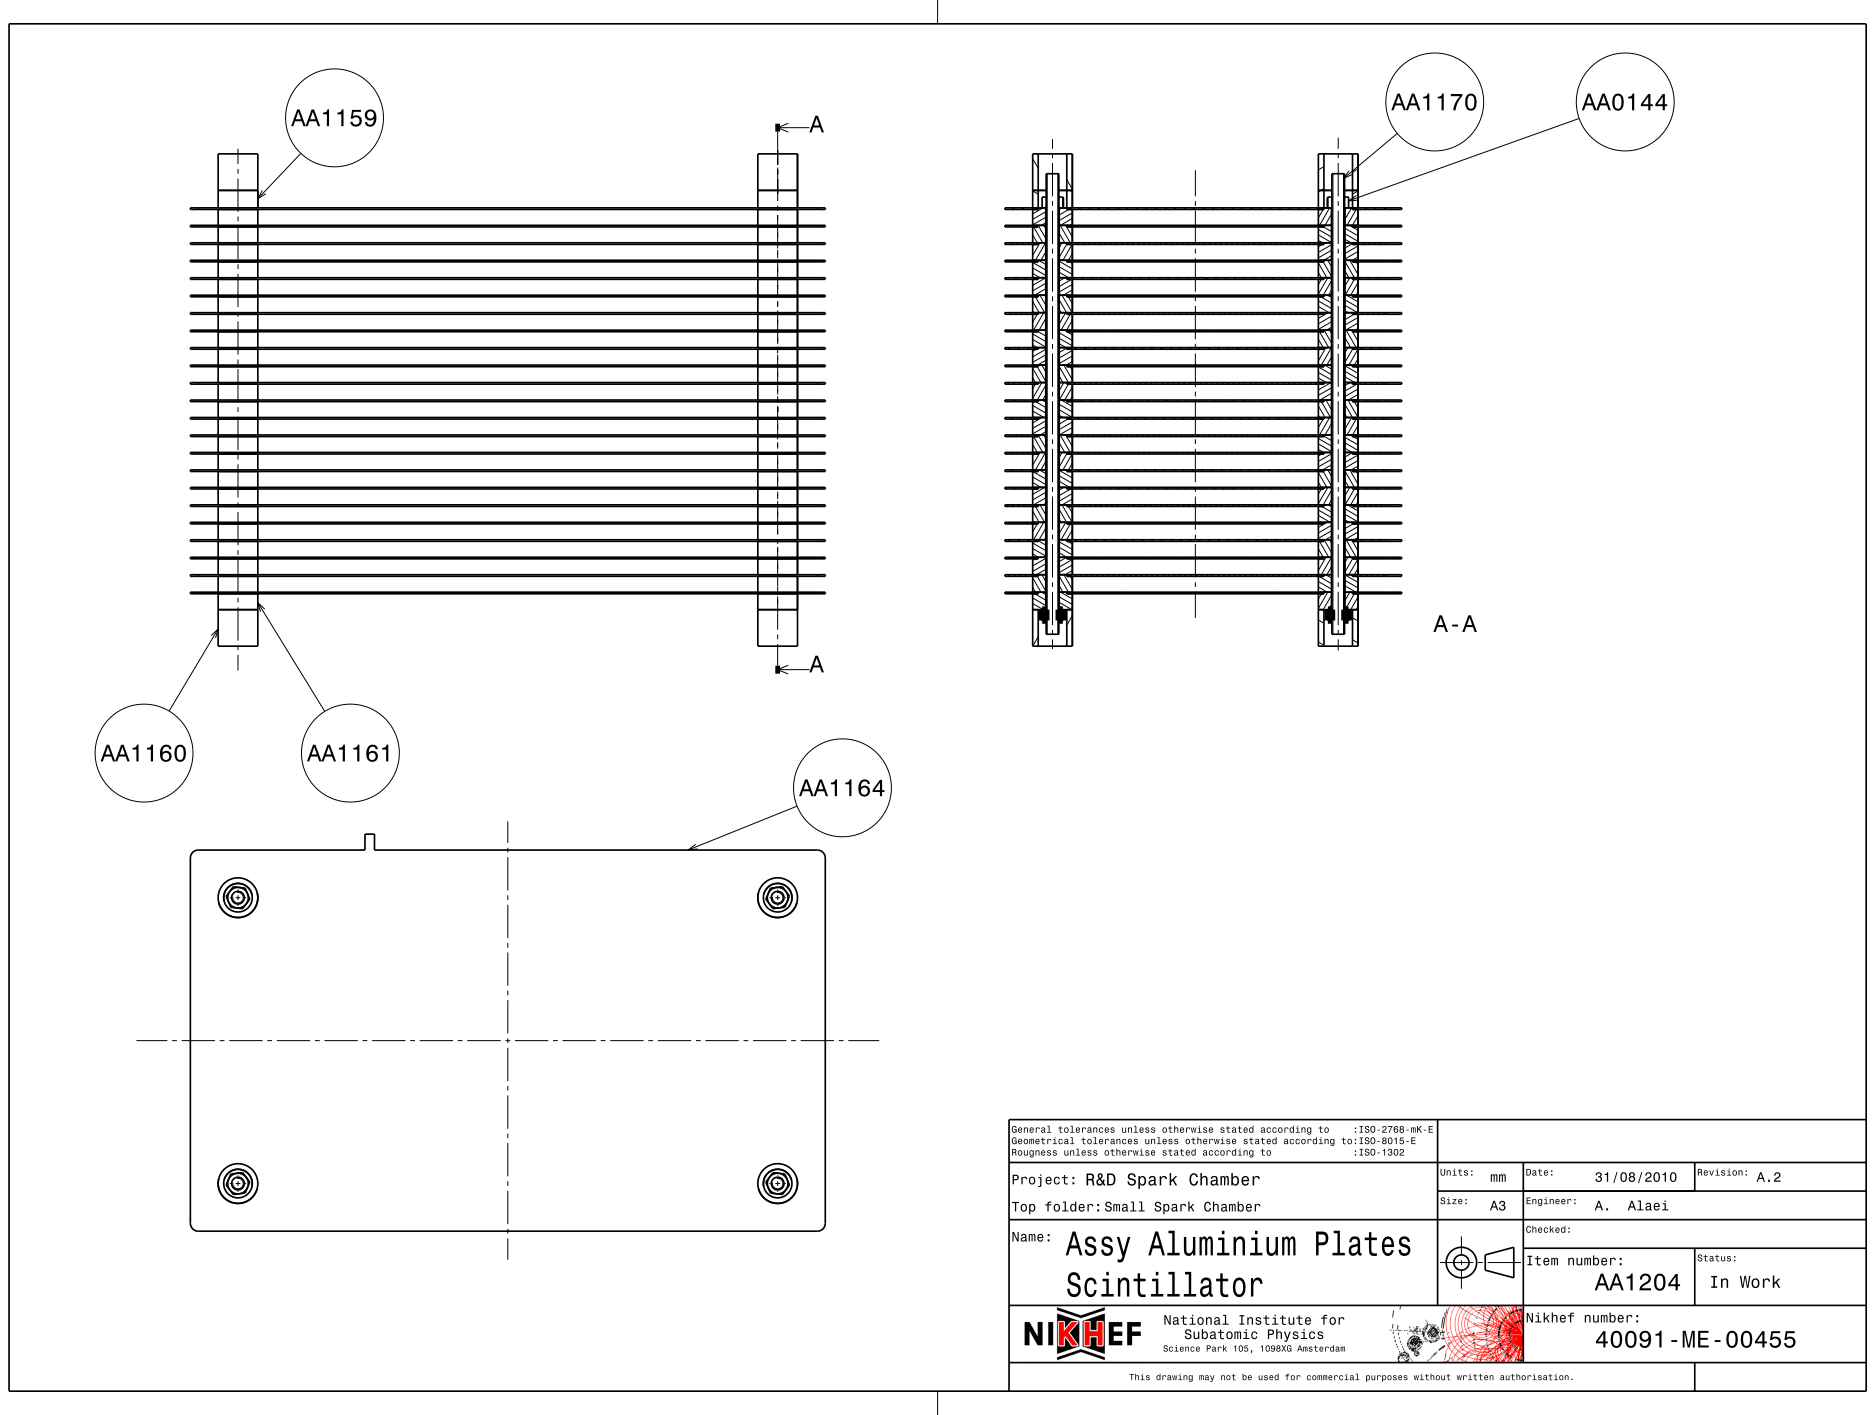
[picture p78: page 1]
