chrisgilmerproj/spark_chamber/Spark Chamber Small/Aluminum Plate Scintillator/Spacer.pdf

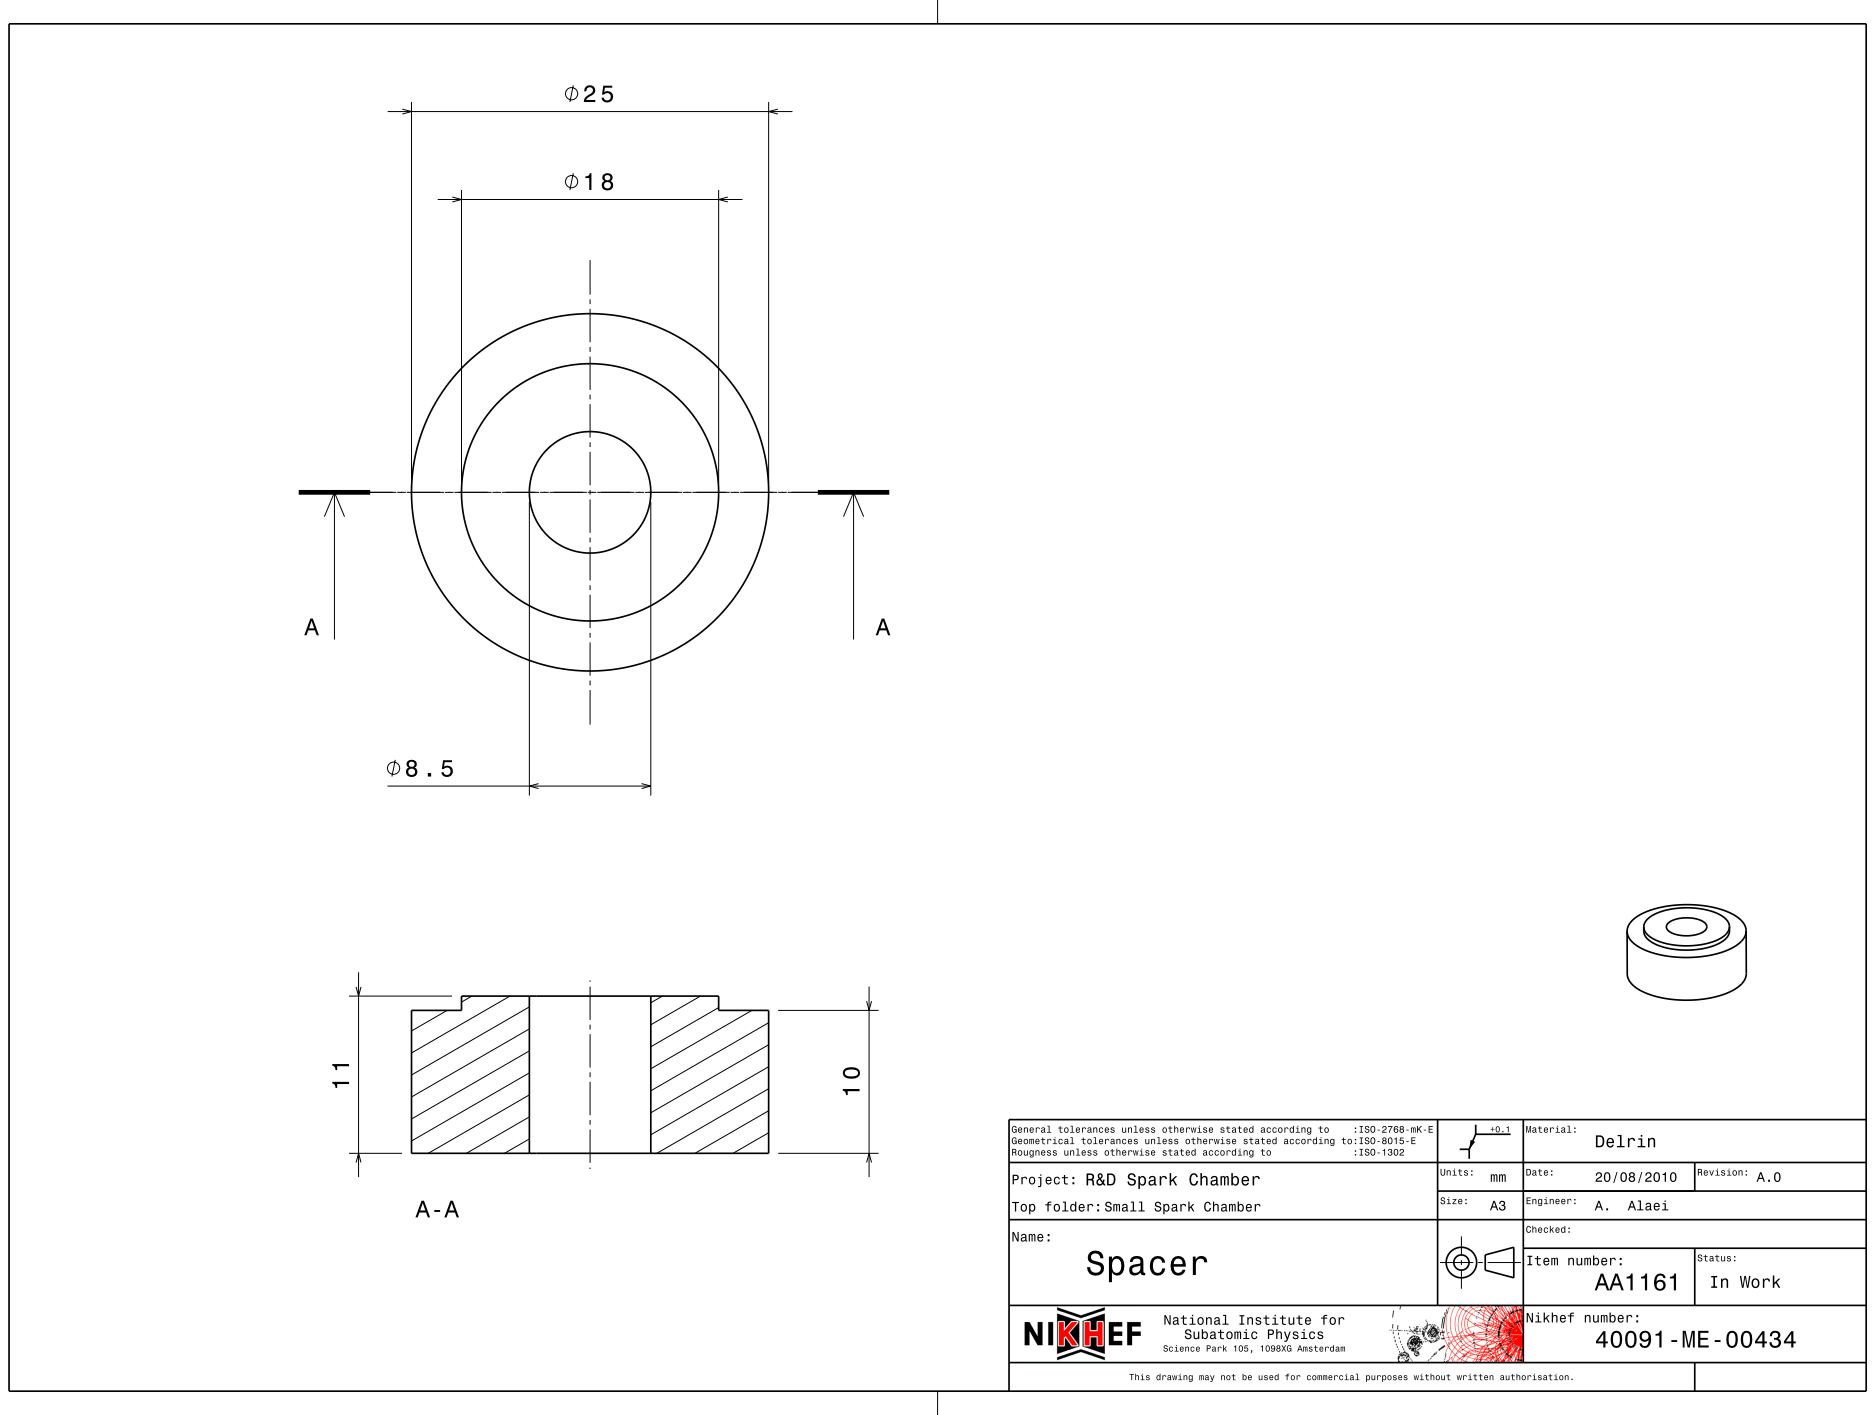
[picture p79: page 1]
