chrisgilmerproj/spark_chamber/Spark Chamber Small/Aluminum Plate Scintillator/Support_bottom.pdf

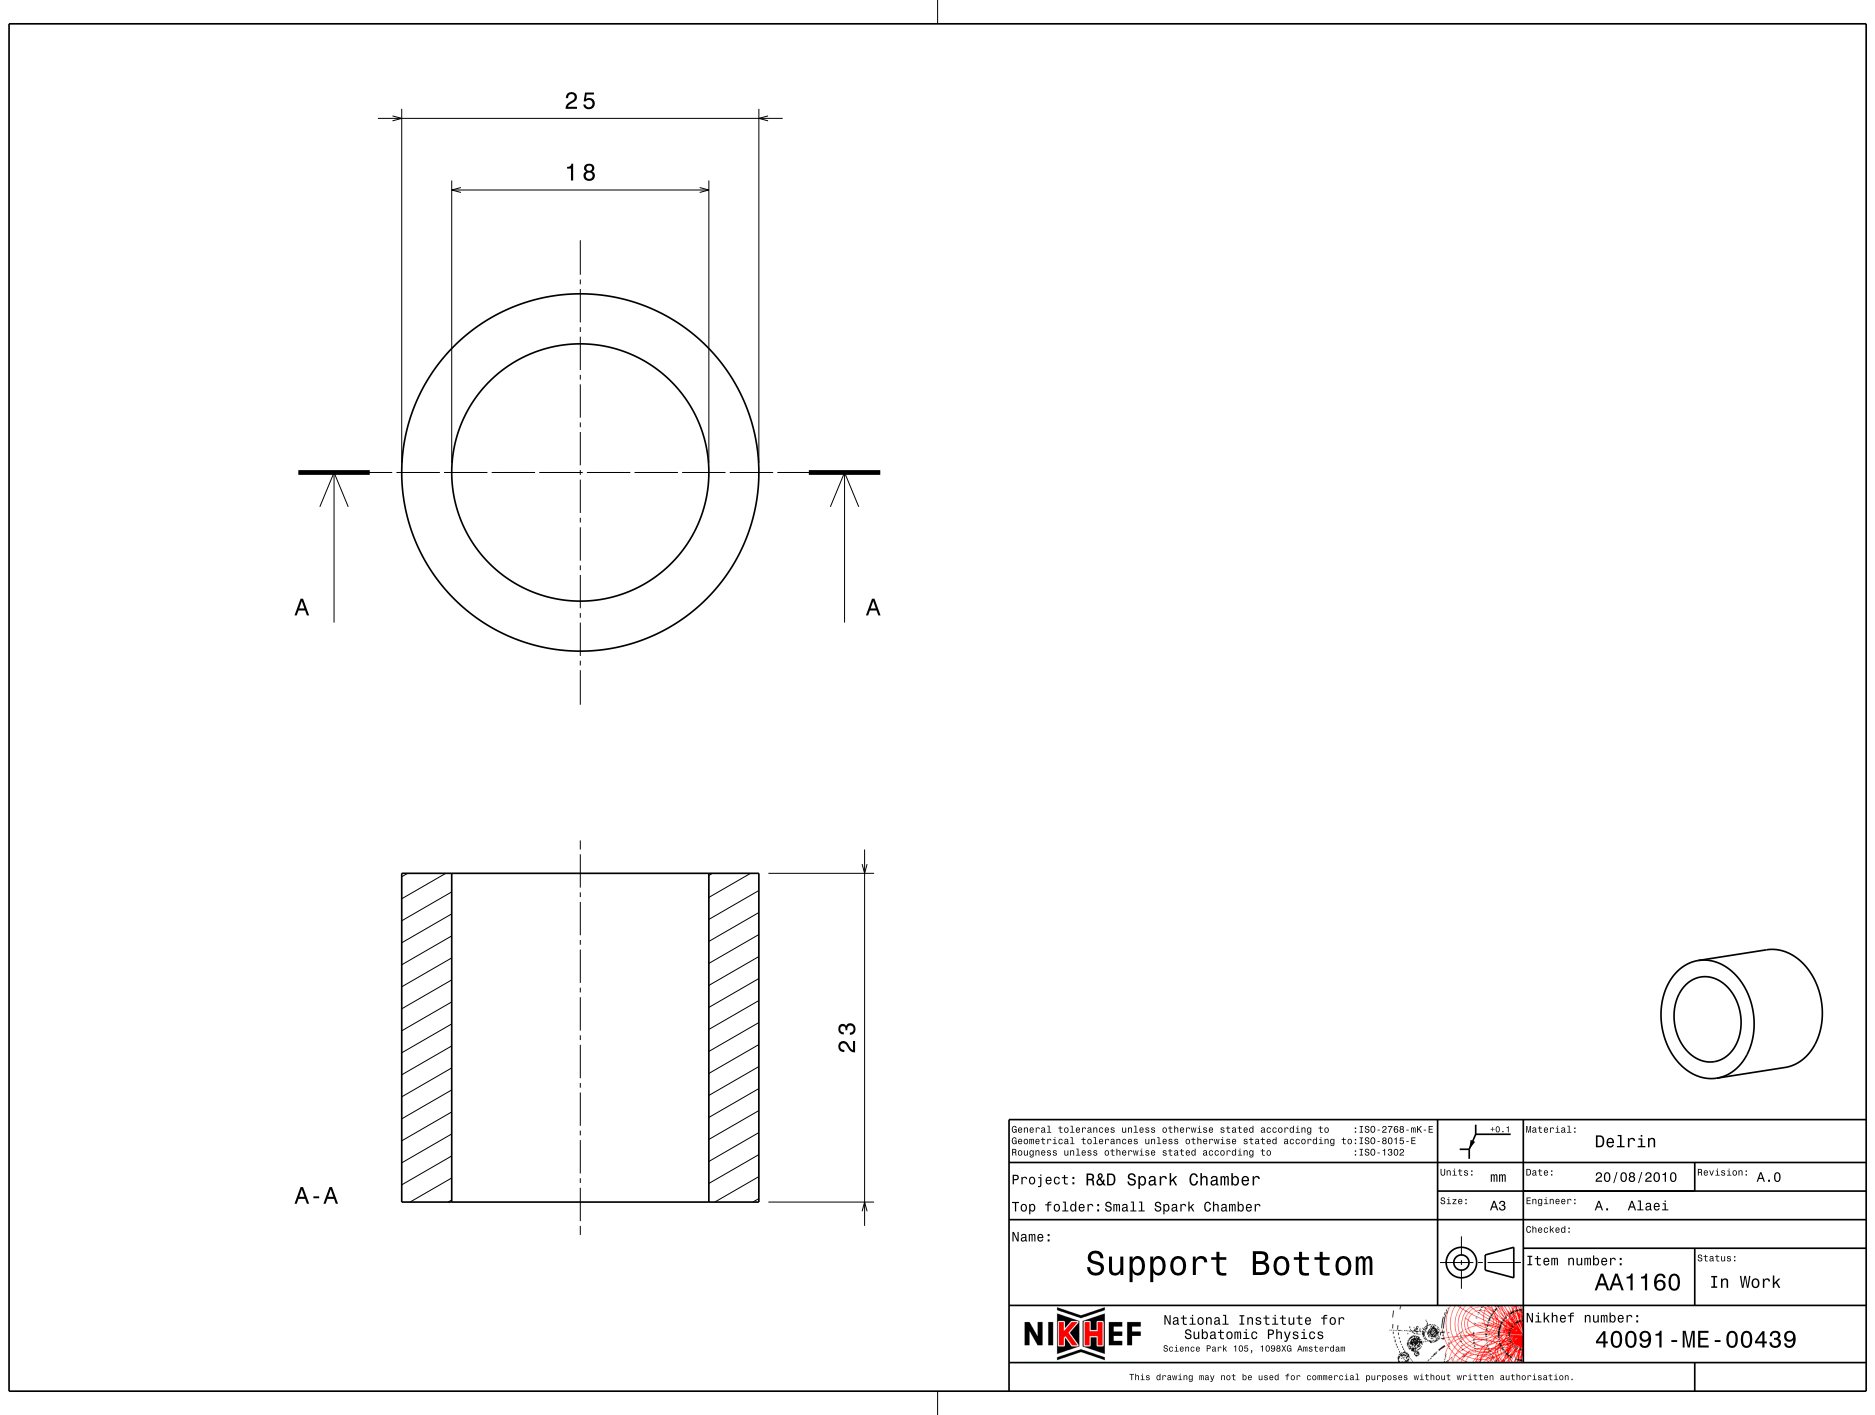
[picture p80: page 1]
