chrisgilmerproj/spark_chamber/Spark Chamber Small/Aluminum Plate Scintillator/Support_top.pdf

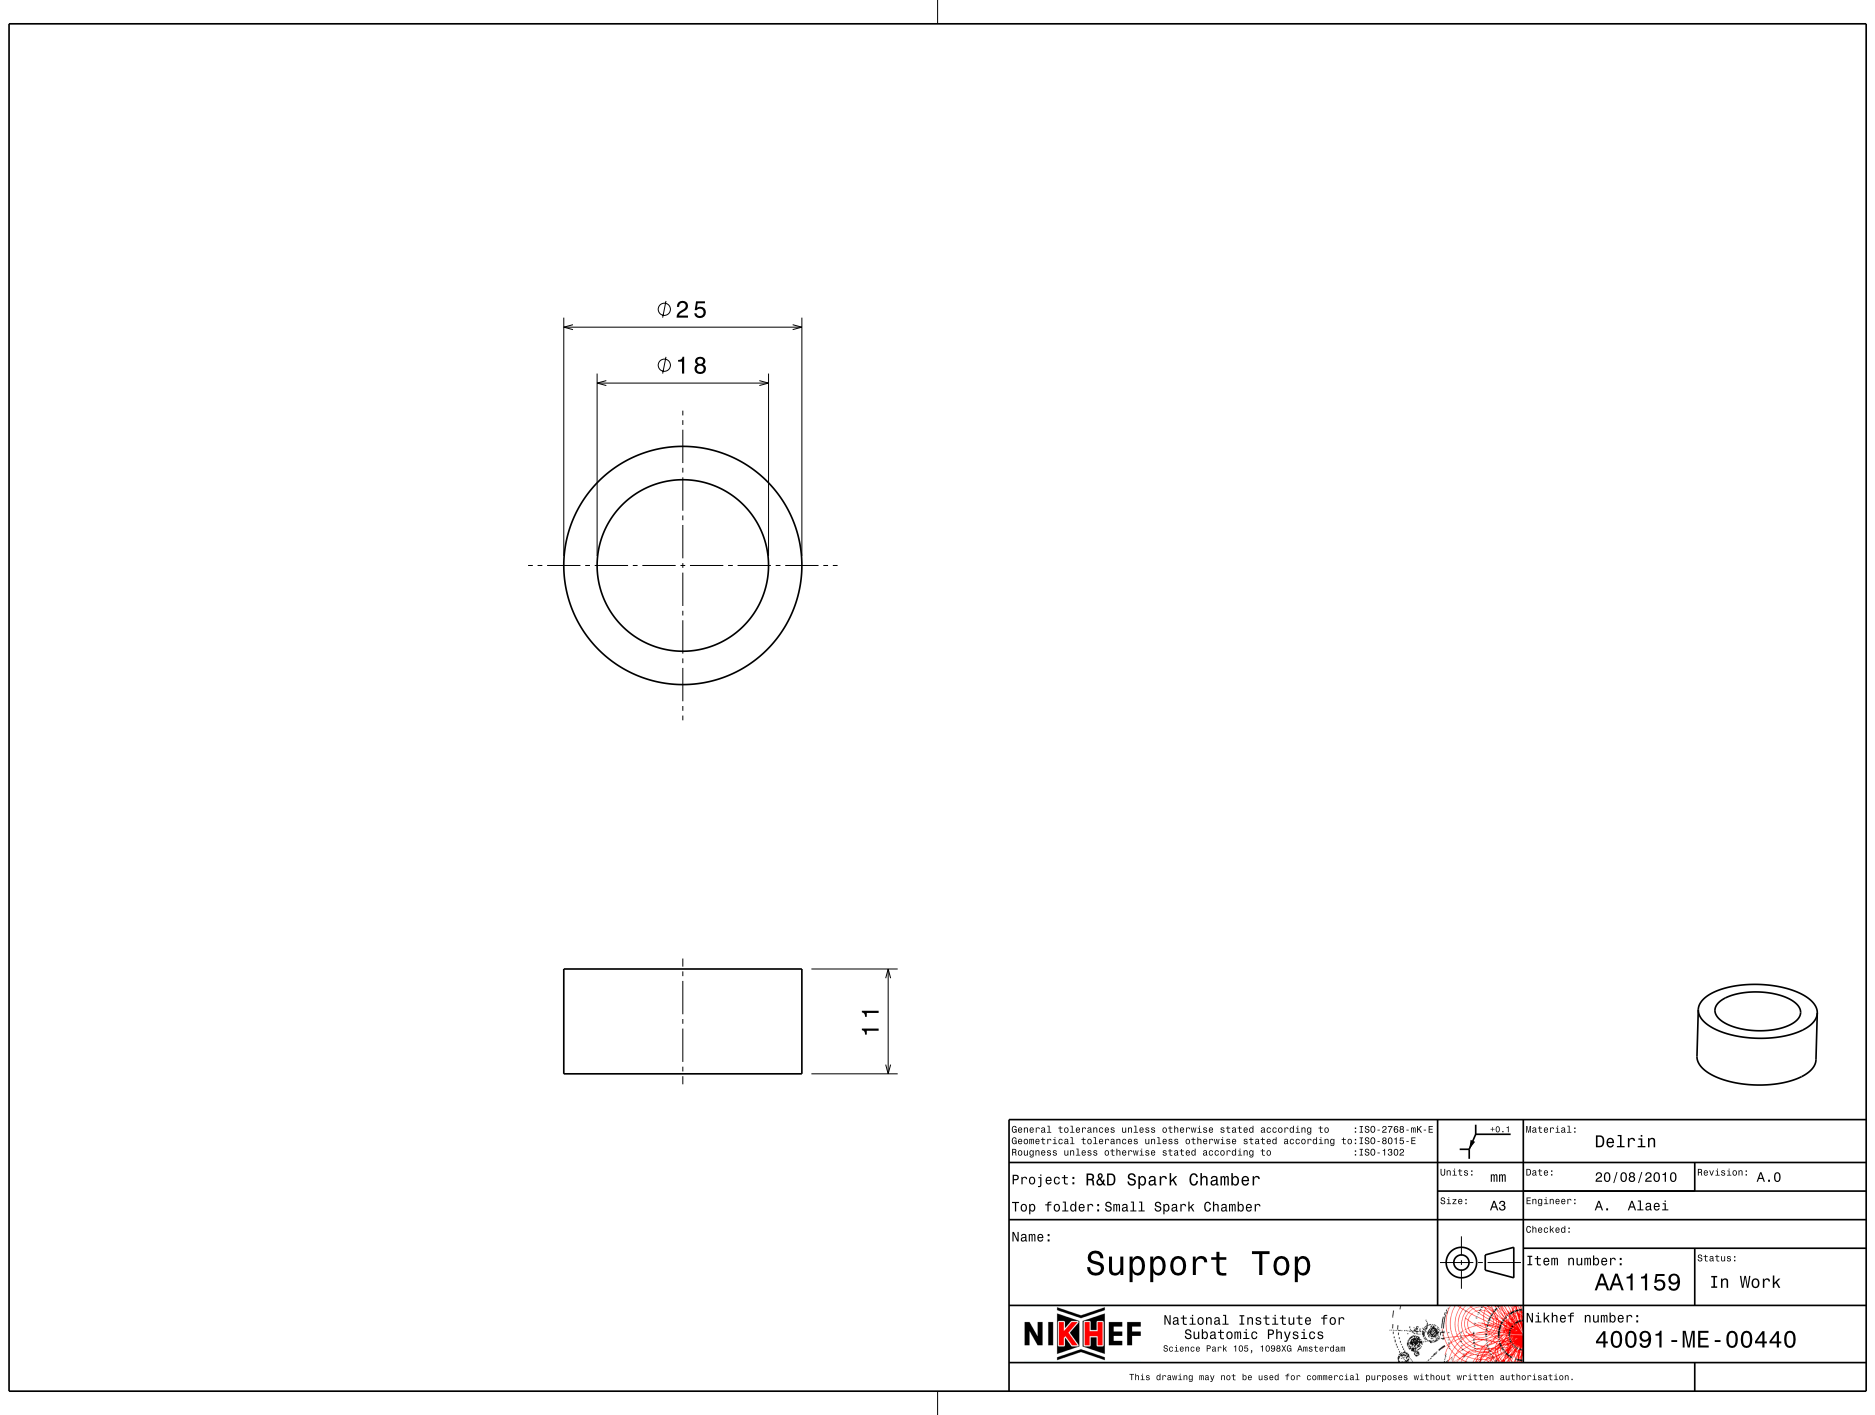
[picture p81: page 1]
