chrisgilmerproj/spark_chamber/(commit log)

2013-10-08 Added original files
    [Electronics panel.dwg]
2013-12-17 Added readme for small spark chamber. Added gitignore. Removed files
2014-02-25 Added a txt version of the BOM and a README for the docs
2014-02-25 Added txt version of BOM
2014-02-25 Added pdf versions of HV boards
2014-02-25 Convert type of BOM file from DOS to unix
2014-02-25 Update readme for HV and Trigger boards
2014-02-25 Add BOM to README in docs
